EduardoSBarreraR/Trabajo_Terminal_2/imagenes/Implementacion/Resultados/CargaMAX.jpg

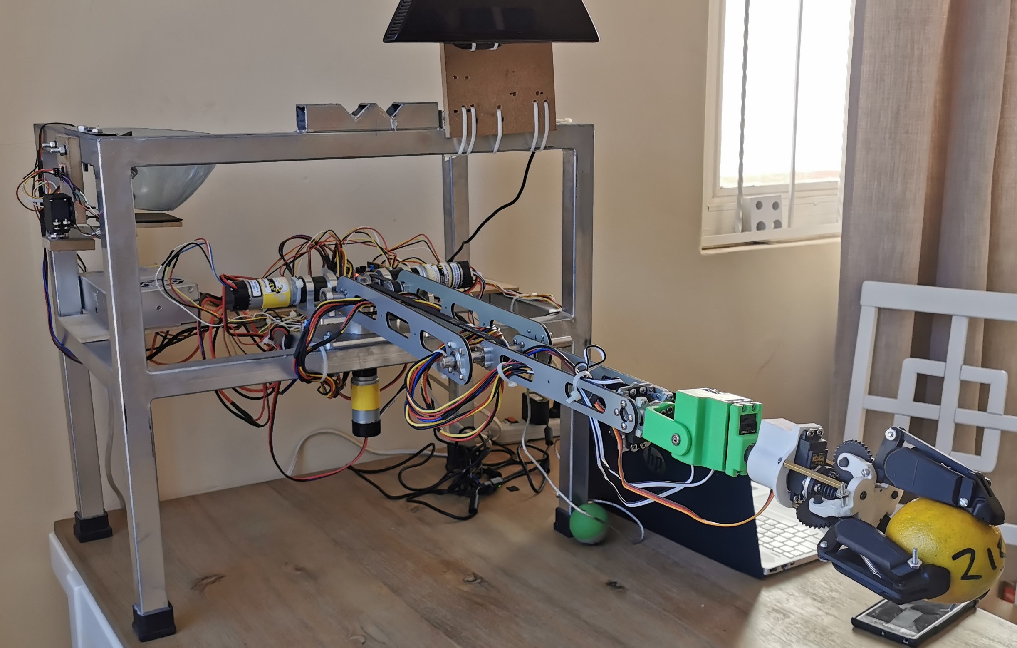
imagenes/Implementacion/Resultados/CargaMAX.jpg
