EduardoSBarreraR/Trabajo_Terminal_2/imagenes/Implementacion/Resultados/Alcance_MAX.jpg

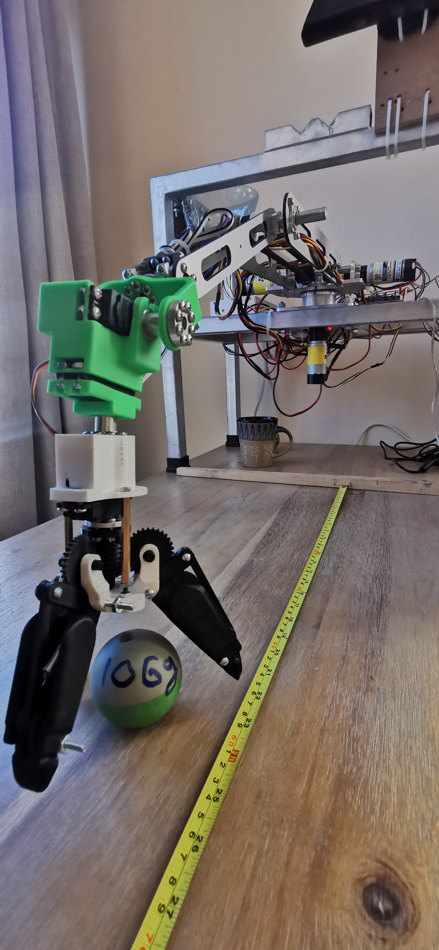
imagenes/Implementacion/Resultados/Alcance_MAX.jpg
