EduardoSBarreraR/Trabajo_Terminal_2/README.md

# Trabajo Terminal II

Este es el repositorio en el que trabajaremos durante el desarrollo del proyecto en Trabajo Terminal II
