EduardoSBarreraR/Trabajo_Terminal_2/capitulos/Implementacion.tex

\chapter{Implementación}

En este capítulo se describe la construcción realizada, siguiendo la secuencia de integración descrita en el capítulo anterior indicando, de ser necesario, las modificaciones realizadas al diseño original.\footnote{Por causas externas al proyecto (COVID-19) fue necesario realizar modificaciones en el diseño, así como una nueva selección de componentes con el fin de reducir costos y simplificar la construcción.}

\section{S5. Estructural}

El diseño original contemplaba perfil estructural IPS 2020 de aluminio, sin embargo, se opta por utilizar una estructura soldada de PTR (Perfil Tubular Rectangular) de $1\frac{1}{4}"$ calibre 14, ya que el material es más barato, más pesado (lo cual ayuda a equilibrar las cargas generadas por el brazo), y además es fácil de trabajar con las herramientas típicas de una herrería. Debido a que el material es acero estructural, se le aplica una capa de pintura para proteger el metal de la corrosión, eligiendo un color cromado para ser estéticamente similar al aluminio.

\begin{figure}
	\centering
	\begin{tabular}{cc}
		\subf{}
			{a) Estructura soldada y pintada}
		&
		\subf{}
			{b) Acercamiento a la pieza donde reposa el brazo}
        \\
    \end{tabular}
	\caption{Estructura construida}
	\label{fig:EstructuraConstruida}
\end{figure}

Como se puede apreciar en la Figura \ref{fig:EstructuraConstruida}b, se modifica la pieza en la que reposa el brazo (mostrada en la Figura \ref{fig:Home}) por un fragmento de PTR que se ranura con el espacio adecuado para apoyar el brazo.

\section{S1. Robótico}
\subsection{M1. Manipulador}

\subsubsection{Base del manipulador}
De acuerdo al cambio de material en la estructura (S5), se utilizan tornillos de $\frac{3}{8}"$, por lo que se modifica el diámetro de los barrenos de la base fija de 10[mm] a $\frac{3}{8}"$.

Las piezas correspondientes a la base fija que se une a la estructura junto con el cilindro sobre el que se colocan los rodamientos se muestran en la Figura \ref{fig:PiezasBaseManipulador}a, mientras que la base giratoria sobre la que se colocan los motores del segundo y tercer GDL se observa en la Figura \ref{fig:PiezasBaseManipulador}b.

\begin{figure}
	\centering
	\begin{tabular}{cc}
		\subf{}
			{a) Base fija con el cilindro montado y tapa del cilindro}
		&
		\subf{}
			{b) Base giratoria}
        \\
	\end{tabular}
	\caption{Base del manipulador}
	\label{fig:PiezasBaseManipulador}
\end{figure}

Gracias a que la masa de la muestra fue reducida a 100 gramos, es posible elegir un motor que ofrezca un menor par, por lo que el modelo seleccionado es el motor de engranes planetarios Yellow Jacket 5202 Series, que proporciona 24.51[Nm] (Anexo \ref{An:Mot}). Para validar esta selección, es útil recurrir nuevamente a la Figura \ref{fig:TorquesMotor}, que corresponde al cálculo con el diseño original, el cual indica que el par mínimo necesario que debe suministrar el motor es de 11.145 [Nm], por lo que se concluye que el par del motor Yellow Jacket es suficiente.

Debido a que hay problemas de compatibilidad entre los ejes de 1/2'' y algunos componentes acoplados a estos, se cambian por ejes de acero inoxidable de 12[mm] de diámetro y las piezas compatibles con los mismos, vendidos por ServoCity (Anexo \ref{An:PiezasExtra}). A estos ejes se les hace un desbastado longitudinal a lo largo de todo el cuerpo para facilitar la colocación y sujeción de accesorios, como se muestra en la Figura \ref{fig:EjDesb}. 

\begin{figure}
	\centering
	\begin{tabular}{cc}
		\subf{}
			{a) Desbastado para un lado plano}
		&
		\subf{}
			{b) Polea sujeta al eje}
		\\
	\end{tabular}
	\caption{Ejes desbastados}
	\label{fig:EjDesb}
\end{figure}

Con estas modificaciones, es posible construir la base giratoria que constituye la cintura del manipulador, mostrada en la Figura \ref{fig:BaseGiratoria}, en la que también se puede apreciar la distribución de los motores de CD correspondientes a los GDL 2 y 3.

\begin{figure}
	\centering		
		
		\caption{Base giratoria con motores}
		\label{fig:BaseGiratoria}
\end{figure}

Debido a que el diseño original del ocioso dentado mostrado en la Figura \ref{fig:PoleaLoca} contiene bordes complicados de hacer por las impresoras 3D, se modifica el CAD eliminando los mismos, como se puede apreciar en la Figura \ref{fig:Ociosos}a, mientras que la pieza, impresa en HIPS (Poliestireno de alto impacto por sus siglás en inglés \textit{High Impact Polystyrene}) con resolución media, se encuentra en la Figura \ref{fig:Ociosos}b.

\begin{figure}
	\centering
	\begin{tabular}{cc}
		\subf{}
			{a) CAD}
		&
		\subf{}
			{b) Impreso}
		\\
	\end{tabular}
	\caption{Rediseño del ocioso dentado}
	\label{fig:Ociosos}
\end{figure}

La base del manipulador completa se puede apreciar en la Figura \ref{fig:BaseManipuladorCompleta}.

\begin{figure}
	\centering		
		
		\caption{Base del manipulador}
		\label{fig:BaseManipuladorCompleta}
\end{figure}

\subsubsection{Eslabones}

Debido a que no se cuenta con la infraestructura requerida (Fresadora CNC) para la manufactura en aluminio, y que manufacturarlas de manera externa elevaba demasiado el precio, se modificó el material a Alucobond de 4[mm] de grosor.

Con estas modificaciones, el eslabón 1 pesa 0.16 Kg, y el eslabón 2 pesa 0.07 Kg.

Los modelos CAD de los eslabones rediseñados se muestran en las Figuras \ref{fig:EslabonesReales}a y \ref{fig:EslabonesReales}b, mientras que los eslabones construidos están en las Figuras \ref{fig:EslabonesReales}c y \ref{fig:EslabonesReales}d respectivamente.

\begin{figure}
	\centering
	\begin{tabular}{cc}
		\subf{}
			{a) CAD eslabon 1}
		&
		\subf{}
			{b) CAD eslabon 2}
        \\
        \subf{}
			{c) Eslabón 1 construido }
		&
		\subf{}
			{d) Eslabón 2 construido}
		\\
	\end{tabular}
	\caption{Modelos CAD de los eslabones y eslabones construidos}
	\label{fig:EslabonesReales}
\end{figure}

\subsubsection*{Validación}
Para comprobar que el material es capaz de resistir los esfuerzos asociados a la carga se utiliza acrílico, esto debido a que Solidworks no cuenta con el material Alucobond en su biblioteca. 

\begin{figure}
	\centering
	\begin{tabular}{cc}
		\subf{}
			{Eslabón 1}
		&
		\subf{}
			{Eslabón 2}
		\\
	\end{tabular}
	\caption{Análisis de resistencia de eslabones de acrílico}
	\label{fig:AnEsAcr}
\end{figure}

Las Figuras \ref{fig:AnEsAcr}a y \ref{fig:AnEsAcr}b indican que los factores de seguridad son de 3.26 y 5.79 respectivamente, y debido a que el límite elástico del acrílico (45 [MPa]) es menor al del Alucobond, se concluye que el material resiste las cargas a las que es sometido.

\subsubsection{Muñeca esférica}

Las piezas realizadas con manufactura aditiva, se imprimieron con ABS al 100\% en resolución estándar, como se muestra en las siguientes Figuras: 1) Pieza en C: Figura \ref{fig:PiezasMun}a, 2) Unión de servos: Figura \ref{fig:PiezasMun}b, 3) Tapa de unión de servos: Figura \ref{fig:PiezasMun}c, 4) Sostén del servo para el primer GDL de la muñeca esférica: Figura \ref{fig:PiezasMun}d.

\begin{figure}
	\centering
	\begin{tabular}{cc}
		\subf{}
			{a) Pieza en C }
		&
		\subf{}
			{b) Tapa de unión de servos }
        \\
		\subf{}
			{c) Unión de servos}
		&
		\subf{}
			{d) Sostén del servo para el primer GDL de la muñeca}
		\\
	\end{tabular}
	\caption{Componentes impresos de la muñeca esférica}
	\label{fig:PiezasMun}
\end{figure}

\subsection{M2. Efector final}

Las piezas del efector se imprimieron en ABS con alta resolución para los engranes y el tornillo sin fin, estas piezas se muestran en las siguientes Figuras: 1) Tornillo sin fin y engranes: Figura \ref{fig:FigsEfectorImpreso}a, 2) Efector con palma y 3 dedos: Figura \ref{fig:FigsEfectorImpreso}b, 3) Base del efector: Figura \ref{fig:FigsEfectorImpreso}c.

\begin{figure}
	\centering
	\begin{tabular}{ccc}
		\subf{}
			{a) Dedos y palma}
		&
		\subf{}
            {b) Tornillo sin fin y engranes}
        &
        \subf{}
            {c) Base}
		\\
	\end{tabular}
	\caption{Efector final impreso}
	\label{fig:FigsEfectorImpreso}
\end{figure}

\subsubsection{Control y movimiento}

Los valores de posición obtenidos a través del algoritmo de visión implementado con el kinect se utilizan para conocer la posición del efector final, sin embargo su orientación está dada por la matriz $R$ descrita en la ecuación (\ref{eq:RTarget}), por lo que, para asegurar que el efector se ubique de forma perpendicular a la horizontal, se establece la matriz $R$ constante como sigue:

$$
R = 
\begin{bmatrix}
	-1 & 0 & 0\\
	 0 & 1 & 0\\
	 0 & 0 & -1
\end{bmatrix}
$$

Además, para evitar colisiones con la estructura, se calcula $\theta_2$ utilizando la raíz negativa en la ecuación (\ref{eq:T2}) para forzar la configuración de codo arriba.\cite{Spong}

Como se plantea en el diseño de dominio específico, la aproximación al control del manipulador es mediante juntas independientes. Ya que la segunda junta es la que está sometida a una carga mayor, se implementa en ésta un control proporcional retroalimentado sintonizado experimentalmente, con el objetivo de que el actuador entregue el par necesario para mantener la posición de la junta de acuerdo a la siguiente ecuación: 

\begin{align}
	pwm = kp * \theta_e
	\label{eq:P_Control}
\end{align}

En donde kp es la ganancia proporcional, con un valor de 1000, y $\theta_e$ es el error entre la posición angular deseada y la posición angular actual.

Para evitar las aceleraciones bruscas, se optó por utilizar un perfil de velocidades trapezoidal para las juntas 1 y 3 a través de un incremento lineal en el ciclo útil del pwm que se envía a los actuadores, mientras que para la junta 2, se dan incrementos de 1 grado cada 0.15 segundos hasta llegar a la posición deseada.

\subsubsection{Configuraciones}

Los ángulos de las juntas del robot mostrados en la Figura \ref{fig:GDLRobot}b se miden como se estableció al calcular la cinemática directa mediante la convención de Denavit-Hartenberg (Figura \ref{fig:GDLRobot}a), con valores de juntas $\theta_1 = 90$, $\theta_2 = \theta_3 = \theta_4 = \theta_5 = \theta_6 = 0$. 

\begin{figure}
	\centering
	\begin{tabular}{cc}
		\subf{}
			{a) Modelo utilizado para la cinemática}
		\\
		\subf{}
			{b) Robot en los ángulos cero}
		\\
	\end{tabular}
	\caption{Comparación del modelo de robot con la implementación}
	\label{fig:GDLRobot}
\end{figure}

Cabe señalar que ya que los actuadores del tercer y cuarto grado de libertad están montados en la base del robot y el tercer grado de libertad transmite su movimiento mediante una polea ociosa colocada en el eje del segundo grado de libertad, el movimiento angular del tercer GDL es independiente del segundo GDL, lo que significa que el ángulo medido en esa junta es absoluto con respecto al plano horizontal, a diferencia del ángulo calculado, el cual es relativo al eslabón anterior. Por ello es necesario convertirlo mediante la fórmula $ \theta_{2 absoluto} = \theta_{2 relativo} + \theta_{1}$. 

Para la ejecución de la tarea de ``pick and place" se establecen dos configuraciones clave. La configuración de ``Dejar muestra'' posiciona el efector para que, al soltar la muestra, esta caiga en la superficie de medición del laboratorio, esto se puede ver en la Figura \ref{fig:ConfClave}. La otra configuración es ``Home'', la cual es el reposo del brazo y sirve de referencia de posición al iniciar el movimiento, puesto que se utilizan encoders incrementales como sensor de posición. Los valores de las juntas en dichas posiciones se muestran en la Tabla \ref{tab:PosRobot}.

La posición de home es diferente a la establecida en el diseño de dominio específico, ya que al implememntar el Kinect como sistema de percepción, ocupa un lugar en el que corre el riesgo de ser golpeado y enviar información errónea de las coordenadas de la muestra. 

\begin{figure}
	\centering
	\begin{tabular}{cc}
		\subf{}
			{a) Home}
		&
		\subf{}
			{b) Laboratorio}
		\\
	\end{tabular}
	\caption{Configuraciones clave del robot}
	\label{fig:ConfClave}
\end{figure}

\begin{table}[]
	\centering
	\caption{Configuraciones clave del robot }
	\label{tab:PosRobot}
	\begin{tabular}{|c|c|c|}
	\hline
		   & Dejar muestra & Home \\ \hline
	$\theta_1$ &       $82^o$        &   $59^o$   \\ \hline
	$\theta_2$ &       $18^o$        &   $54^o$   \\ \hline
	$\theta_3$ &       $120^o$       &   $153^o$  \\ \hline
	$\theta_4$ &       $80^o$        &   $10^o$   \\ \hline
	$\theta_5$ &       $160^o$       &   $10^o$   \\ \hline
	$\theta_6$ &       $26^o$        &   $15^o$   \\ \hline
	\end{tabular}
\end{table}

\section{S4. Laboratorio}
Para la implementación de este sistema se diseñó un elemento de sujeción hecho de lámina de acero, mostrado en la Figura \ref{fig:LabLamina}, que soporta al sistema de laboratorio y lo mantiene unido al sistema estructural. 

\begin{figure}
    \centering		
        
        \caption{Sujetador de laboratorio hecho con lámina de acero.}
        \label{fig:LabLamina}
\end{figure}

Para asegurar que la muestra se mantiene en la superficie de medición durante la lectura, y para incrementar las probabilidades de que la muestra caiga en la misma al ser liberada por el efector, se construye un cono recortando una botella de PET y atornillándola a la lámina de acero, como se observa en la Figura \ref{fig:Lab12}.

El sistema de laboratorio finalizado y sujeto a el sistema estructural se puede ver en las Figuras \ref{fig:Lab12}a y \ref{fig:Lab12}b.

\begin{figure}
	\centering
	\begin{tabular}{cc}
		\subf{}
			{a Vista frontal, donde se observa \\ la superficie de medición y la superficie cónica}
		&
		\subf{}
			{b Vista lateral, donde se muestra \\ el actuador del desechador}
		\\
	\end{tabular}
	\caption{Vistas del sistema de laboratorio}
	\label{fig:Lab12}
\end{figure}

\section{S3. Energético}

Debido a que se realizaron modificaciones al diseño obtenido en la fase de \textit{Diseño de dominio específico} para reducir costos, la fuente utilizada es la TDK-Lambda GWS250 (Anexo \ref{An:Fuente}), que proporciona 20[A], perteneciente a compañeros de la carrera, pues el peso reducido tanto en los eslabones como en la muestra recogida implican un menor consumo energético.

Así mismo, se utilizan los Drivers Cytron 13 [A] y Cytron dual de 10[A] por canal para alimentar los motores de CD. Para los servomotores se utiliza el regulador Digilent TPS54620, que proporciona 5V a 6[A] de manera continua.

Estos componentes se pueden apreciar en la Figura \ref{fig:Energetico}, encerrados en círculos.

\begin{figure}
    \centering		
        
        \caption{Distribución del sistema energético}
        \label{fig:Energetico}
\end{figure}

\section{S2. Información}

\subsection{M3. Percepción}

Con el fin reducir costos y facilitar el algoritmo de visión, se utiliza un Kinect v1, el cual es una cámara RGB-D fabricada por Microsoft\textregistered. Para esta plataforma existen varias aplicaciones de código libre, por lo que hay bibliotecas disponibles para la utilización de los datos obtenidos por los sensores\cite{ShiffmanKinect}, como es el sensor de profundidad, cuya información permite calcular la posición del objeto en el espacio utiliza en la cinemática inversa.

Debido a que el rango de detección del sensor de profundidad comienza a partir de los 48 cm, y que en el diseño original este se encuentra muy cerca del suelo, es necesario colocarlo en la parte superior de la estructura, desplazado hacia la izquierda para que el sistema robótico no interfiera en el área de visión, provocando que no abarque todo el espacio de trabajo del robot. 

\subsection{M4. Comunicación}

La comunicación con el usuario se realiza a través de una Interfaz Gráfica de Usuario, mostrada en la Figura \ref{fig:GUIsXD} en la que el operador debe seleccionar un punto de la imagen de profundidad que corresponda al objeto que desea tomar. El módulo de percepción obtiene las coordenadas de ese punto en el espacio del robot, y las muestra. Esta interfaz se desarrolla utilizando el lenguaje ``Processing\textregistered''\cite{ProcessingXD}, ya que este cuenta con bibliotecas que permiten utilizar el Kinect fácilmente. 

El programa  de la interfaz calcula el vector de valores de las juntas del robot según las coordenadas deseadas, las cuales son enviadas a la tarjeta de procesamiento cuando el usuario presiona el botón ``Activar'', mientras que esta recolecta los datos de temperatura y peso de la muestra para enviarlos a la computadora. Cabe destacar que mientras el sistema se encuentra en operación, cualquier orden enviada se ignora y solo se toma en cuenta la ultima posición enviada. 

La comunicación entre la computadora y la tarjeta Núcleo es serial, utilizando el protocolo UART a través del puerto USB de la tarjeta de desarrollo.

\begin{figure}
	\centering
	\begin{tabular}{cc}
		\subf{}
			{a) Pantalla de inicio}
		\\
		\subf{}
			{b) Pantalla una vez que se ha seleccionado la muestra}
		\\
	\end{tabular}
	\caption{Interfaz Gráfica de Usuario}
	\label{fig:GUIsXD}
\end{figure}

\subsection{M5. Procesamiento}

En la tarjeta núcleo existen pines que están reservados para el funcionamiento de los periféricos internos de la misma, lo cual no se tomó en cuenta en el diseño de la Figura \ref{fig:DistPines}, por esta razón se eligieron nuevamente los pines con base en lo siguiente: a) Los pines para PWM deben tener como fuente un timer y canal diferente. b) Las interrupciones externas se encuentran interconectadas entre puertos, por lo que se requiere utilizar una interrupción externa por cada pin de los puertos.

Como se puede observar en la Figura \ref{fig:PinesNukleoFinal}, se utilizan los siguientes pines, los cuales se seleccionan con ayuda de la documentación de la tarjeta, disponibles en \cite{Nucleo446RE}:

\begin{itemize} [noitemsep,nolistsep]
	\item Motores de CD
	\begin{itemize}
		\item PC4: Dirección de motor de CD del 1er GDL - Salida Digital
		\item PA10: PWM del motor de CD del 1er GDL - Salida de PWM (Timer 1 - Canal 3)
		\item PB4: Dirección de motor de CD del 2o GDL - Salida Digital
		\item PB5: PWM del motor de CD del 2o GDL - Salida de PWM (Timer 3 - Canal 2)
		\item PB13: Dirección de motor de CD del 3er GDL - Salida Digital
		\item PB3: PWM del motor de CD del 3er GDL - Salida de PWM (Timer 2 - Canal 2)
	\end{itemize}
	\item Encoders
	\begin{itemize}
		\item PC3: Encoder del motor del 1er GDL (Canal A) - Fuente de interrupción externa
		\item PC2: Encoder del motor del 1er GDL (Canal B) - Fuente de interrupción externa
		\item PC0: Encoder del motor del 2o GDL (Canal A) - Fuente de interrupción externa
		\item PC1: Encoder del motor del 2o GDL (Canal B) - Fuente de interrupción externa
		\item PA8: Encoder del motor del 3er GDL (Canal A) - Fuente de interrupción externa
		\item PB10: Encoder del motor del 3er GDL (Canal B) - Fuente de interrupción externa
	\end{itemize}
	\item Servomotores
	\begin{itemize}[noitemsep,nolistsep]
		\item PB9(Alternativo\footnote{Los pines están conectados a varios Timers como fuente de PWM, el cual se especifica mediante código \cite{NucleoPeripheralPins}}): Servomotor del 4o GDL - Salida de PWM (Timer 4 - Canal 4)
		\item PB8: Servomotor del 5o GDL - Salida de PWM (Timer 4 - Canal 3)
		\item PC9: Servomotor del 6o GDL - Salida de PWM (Timer 3 - Canal 4)
		\item PC8: Servomotor del efector final - Salida de PWM (Timer 3 - Canal 3)
		\item PC6: Servomotor del mecanismo de desecho del laboratorio - Salida de PWM (Timer 3 - Canal 1)
	\end{itemize}
	\item Celda de carga
	\begin{itemize}
		\item PC10: SCK - Salida Digital
		\item PC12: DATA - Entrada digital
	\end{itemize}
	\item Sensores de temperatura
	\begin{itemize}
		\item PD2: DHT11A - Entrada Digital
		\item PC11: DHT11B - Entrada Digital
		\item Interno: Sensor de temperatura interno
	\end{itemize}
\end{itemize}

\begin{figure}
    \centering		
        
        \caption{Pines utilizados en la núcleo STM32F446RE}
        \label{fig:PinesNukleoFinal}
\end{figure}

Esto conlleva una modificación en el diagrama esquemático y el PCB del circuito diseñado, los cuales se muestran actualizados en las Figuras \ref{fig:PlakaNueva}a y \ref{fig:PlakaNueva}b respectivamente, mientras que la placa construida puede observarse en la Figura \ref{fig:PlakaConstruida}.

\begin{figure}
	\centering
	\begin{tabular}{cc}
		\subf{}
			{a) Diagrama esquemático}
		&
		\subf{}
			{b) Placa de circuito impreso}
		\\
	\end{tabular}
	\caption{Diseño implementado del circuito del sistema}
	\label{fig:PlakaNueva}
\end{figure}

\begin{figure}
    \centering		
        
        \caption{PCB construido}
        \label{fig:PlakaConstruida}
\end{figure}

\section{Integración}

El sistema completo se puede apreciar en la Figura \ref{fig:RobotCompleto}, el cual es muy similar al render mostrado en la Figura \ref{fig:RenderPitero}.

\begin{figure}
    \centering		
        
        \caption{Sistema robótico completo}
        \label{fig:RobotCompleto}
\end{figure}

Debido a que las posiciones de cero grados en las juntas del robot (mostrado en la Figura \ref{fig:GDLRobot}b) no coinciden con los ángulos cero de los servos en los GDL 4, 5 y 6, es necesario realizar un ajuste en el código, el cual es diferente para cada servo, como se muestra en las siguientes fórmulas: a) Servo 4GDL: $\theta_4 + 90$, b) Servo 5GDL: $\theta_5 + 100$ c) Servo 6GDL: $\theta_6 + 15$.

Por otro lado, para mover cada junta se realiza una rutina dependiendo de la posición objetivo con ayuda de una posición auxiliar en el 3er GDL, la cual se utiliza para poder modificar la orientación del efector sin golpear el Kinect ni la estructura, como se puede observar en la Figura \ref{fig:PosAux}.
La rutina que el robot ejecuta es la siguiente:

\begin{figure}
    \centering		
        
        \caption{Posición auxiliar del manipulador}
        \label{fig:PosAux}
\end{figure}

\begin{itemize}[noitemsep,nolistsep]
	\item Paso 1: Home - Muestra seleccionada. 
	\begin{enumerate}[noitemsep,nolistsep]
		\item Posición auxiliar del 3$^{er}$ GDL.
		\item Posición objetivo del 1$^{er}$ GDL.
		\item Posición objetivo del 4$^{o}$ GDL.
		\item Posición objetivo del 5$^{o}$ GDL.
		\item Posición objetivo del 3$^{er}$ GDL.
		\item Posición objetivo del 2$^{o}$ GDL.
		\item Cerrar efector.
	\end{enumerate}
	\item Paso 2: Muestra seleccionada - Laboratorio.
	\begin{enumerate}[noitemsep,nolistsep]
		\item Posición auxiliar del 3$^{er}$ GDL. 
		\item Posición de laboratorio del 1$^{er}$ GDL.
		\item Posición de laboratorio del 6$^{o}$ GDL.
		\item Posición de laboratorio del 5$^{o}$ GDL.
		\item Posición de laboratorio del 4$^{o}$ GDL.
		\item Posición de laboratorio del 2$^{o}$ GDL.
		\item Posición de laboratorio del 3$^{er}$ GDL.
		\item Abrir efector.
		\item Liberar muestra.
		\item Regresar superficie de medición.
	\end{enumerate}
	\item Paso 3: Laboratorio - Home.
	\begin{enumerate}[noitemsep,nolistsep]
		\item Posición de home 2$^{o}$ GDL.
		\item Posición de home 6$^{o}$ GDL.
		\item Posición de home 4$^{o}$ GDL.
		\item Posición de home 5$^{o}$ GDL.
		\item Posición de home 1$^{er}$ GDL.
		\item Posición de home 3$^{er}$ GDL. 
	\end{enumerate}
	
	\item Paso 4. Enviar datos a la computadora y una señal que reactive el botón para una nueva selección de muestra.
\end{itemize}

\section{Resultados obtenidos}

A continuación se presenta un resumen de los resultados obtenidos con el sistema, los cuales se midieron con una muestra de 20 pruebas en un entorno controlado, realizadas en interiores sobre una mesa en la que se reposa el objeto a recoger, como se muestra en la Figura \ref{fig:RobotEntorno}, teniendo éxito en la operación en 5 ocasiones. En la sección \ref{sec:TrabajoFuturo} se discuten posibles soluciones a los problemas aquí presentados.

\begin{figure}
    \centering		
        
        \caption{Entorno de pruebas del sistema robótico}
        \label{fig:RobotEntorno}
\end{figure}

\subsection*{S1. M1. Manipulador robótico}

\subsubsection*{Carga máxima}

Con el objetivo de evitar el sobreimpulso, se establece un ciclo útil de PWM máximo de 15\% para limitar la velocidad de movimiento, lo cual influye directamente en la capacidad de carga, sin embargo, como se puede ver en la Figura \ref{fig:CargaMAXNaranja}, el sistema es capaz de manipular una carga de 215 gramos, lo que es 2 veces mayor a lo especificado en el requerimiento R1 modificado (100 gramos).	

\begin{figure}
    \centering		
        
        \caption{Carga máxima aplicada al robot, (215 gramos en voladizo)}
        \label{fig:CargaMAXNaranja}
\end{figure}

\subsubsection*{Alcance}

\begin{flushright}
	\textbf{\textit{Rango de movimiento de los eslabones}}
\end{flushright}

El primer grado de libertad puede girar sin golpear la estructura en un rango entre 45 grados y 145 grados, lo que significa que el rango de movimiento es de 100 grados, como se muestra en las Figuras \ref{fig:RangoGDL1}a y \ref{fig:RangoGDL1}b respectivamente.

\begin{figure}
	\centering
	\begin{tabular}{cc}
		\subf{}
			{a) Ángulo mínimo}
		&
		\subf{}
			{b) Ángulo máximo}
		\\
	\end{tabular}
	\caption{Rango de movimiento del primer grado de libertad del robot}
	\label{fig:RangoGDL1}
\end{figure}

El segundo GDL del robot puede moverse en un rango de $-45^o <= \theta_2 <= 70^o $, siendo el valor máximo el límite en el que no golpea al Kinect, como se observa en la Figura \ref{fig:RangoGDL2}. En cuando al tercer GDL, su rango de movimiento depende del valor de $\theta_2$.

\begin{figure}
    \centering		
        
        \caption{Ángulo máximo del segundo grado de libertad del robot}
        \label{fig:RangoGDL2}
\end{figure}

\begin{flushright}
	\textbf{\textit{Alcance mínimo}}
\end{flushright}

La distancia mínima a la que debe estar un objeto para que el robot pueda alcanzarla es de 10 [cm] alrededor del eje de giro del primer GDL, lo cual se consigue con una configuración de $\theta_2 = 23^o$ y $\theta_3 = -117^o$ a lo largo de todo el rango de movimiento del primer GDL. Esta configuración se muestra en la Figura \ref{fig:AlcanceMinimo}. 
La distancia más lejana en la que el robot puede recoger una muestra es de 68 cm, mostrado en la Figura \ref{fig:AlcanceMaximo}. 
El área total que puede alcanzar el robot se muestra en la Figura \ref{fig:AlcanceRobot}.

\begin{figure}
    \centering		
        
        \caption{Alcance mínimo del robot}
        \label{fig:AlcanceMinimo}
\end{figure}

\begin{figure}
	\centering
	\begin{tabular}{cc}
		\subf{}
			{a) Configuración del robot en su alcance máximo}
		&
		\subf{}
			{b) Distancia máxima}
		\\
	\end{tabular}
	\caption{Alcance máximo del robot}
	\label{fig:AlcanceMaximo}
\end{figure}

\begin{figure}
    \centering		
        
        \caption{Alcance total del robot}
        \label{fig:AlcanceRobot}
\end{figure}

\subsection*{S1. M2. Efector final}

El efector es capaz de agarrar muestras con las dimensiones especificadas, como se puede observar en la Figura \ref{fig:AgarreRobot}a, así como muestras de dimensiones mayores a las requeridas, aunque la posición no sea la ideal, como se muestra en la Figura \ref{fig:AgarreRobot}b, en la que se aprecia como el efector toma la naranja solo con las puntas de los dedos. Después de realizar pruebas de cierre de efector con objetos de diferentes tamaños, se determina que el tiempo de cierre y apertura que el efector requiere para poder asegurar la muestra es de 5 segundos.

\begin{figure}
	\centering
	\begin{tabular}{cc}
		\subf{}
			{a) Condiciones ideales (Todas las falanges)}
		&
		\subf{}
			{b) Condiciones no ideales (Punta de los dedos)}
		\\
	\end{tabular}
	\caption{Alcance máximo del robot}
	\label{fig:AgarreRobot}
\end{figure}

\subsection*{S2. M3. Percepción}

Debido a que la distancia mínima a la que el Kinect puede detectar un objeto es de 48[cm] y que se coloca de manera perpendicular al plano horizontal (XY), el área de visión es reducida (68x49[cm]), como se muestra en la Figura \ref{fig:VisionRobot}. 

\begin{figure}
    \centering		
        
        \caption{Rango de visión del robot}
        \label{fig:VisionRobot}
\end{figure}

Es importante tomar en cuenta que los parámetros de este dispositivo son privativos, por lo que no es posible obtener una ubicación 100\% exacta de la muestra sin embargo, el error máximo de las lecturas realizadas es de 3\%, como se puede observar en las diferentes capturas de la GUI mostradas en la Figura \ref{fig:GUILecturas}.

\begin{figure}
	\centering
	\begin{tabular}{cc}
		\subf{}
			{a) }
		&
		\subf{}
			{b) }
		\\
		\subf{}
			{c) }
		&
		\subf{}
			{d) }
		\\
		\subf{}
			{e) }
		\\
	\end{tabular}
	\caption{Interfaz Gráfica de Usuario ubicando la muestra en diferentes posiciones}
	\label{fig:GUILecturas}
\end{figure}

Conociendo el alcance total del robot y el rango de visión que ofrece el Kinect, es posible identificar el espacio de trabajo del sistema, siendo esta la intersección del alcance del robot y el rango de visión del Kinect, como se puede observar en la Figura \ref{fig:AreaTrabajoRobot}.

\begin{figure}
    \centering		
        
        \caption{Área de trabajo del robot}
        \label{fig:AreaTrabajoRobot}
\end{figure}

\subsection*{S2. M4. Comunicación}

La comunicación usuario-computadora-microcontrolador se realiza a través de la Interfaz Gráfica de Usuario (GUI por sus siglas en inglés, \textit{Graphic User Interface}), en la que el usario debe ser capaz de interpretar la imagen de profundidad para seleccionar la muestra de interés. En cuanto a la comunicación con el microcontrolador, esta se realiza a 250000 baudios sin perder información.

\subsection*{S2. M5. Procesamiento}

La tarjeta de desarrollo Núcleo STM32F446RE es capaz de procesar toda la información necesaria para controlar el robot, comunicarse con la computadora y realizar la lectura de los sensores sin presentar retrasos.

\subsection*{S3. Energético}

La fuente de alimentación es capaz de suministrar la corriente requerida por los actuadores, mientras que los sensores pueden ser alimentados por el puerto USB de la computadora a través de la tarjeta Núcleo, ya que consumen menos de 300 [mA] en conjunto.

\subsection*{S4. M6. Obtención de datos}

La superficie de medición es un cuadrado de 8 [cm] que es capaz de recibir la muestra con la ayuda del cono de PET (La Figura \ref{fig:SuperficieMedicion} muestra este ensamble) sin que caiga una vez que está dentro, manteniéndola en su lugar hasta que es desechada, esto se puede observar en la Figura \ref{fig:EspacioMuestraLab}.

En cuanto a la medición de masa, la celda de carga se dañó, por lo que no funciona.

\begin{figure}
    \centering		
        
        \caption{Superficie de medición de la muestra}
        \label{fig:SuperficieMedicion}
\end{figure}

\subsection*{S4. M7. Desechador}

Con las dimensiones mencionadas anteriormente, el módulo de desechador es capaz de liberar muestras con diámetros menores a 8[cm], como se puede apreciar en la Figura \ref{fig:EspacioMuestraLab}.

\begin{figure}
    \centering		
        
        \caption{Espacio para muestras de diámetro menor a 8[cm]}
        \label{fig:EspacioMuestraLab}
\end{figure}

\subsection*{S5. Estructural}

La estructura es capaz de soportar al resto de sistemas y las reacciones generadas por los mismos sin desestabilizarse ni vibrar.

\subsection*{Resultado general}

Una vez que se envía la orden a través de la GUI, el sistema tarda alrededor de 1 minuto en llegar de la posición de ``Home'' a la ubicación de la muestra, mientras que la tarea completa se realiza en 2 minutos 20 segundos aproximadamente, después de los cuales el sistema está listo para recibir una nueva orden. Esta función puede realizarse con una probabilidad de éxito del 25\%, ya que el efector empuja frecuentemente la muestra mientras llega a su ubicación, del mismo modo existe poca repetibilidad atribuida a la holgura mecánica, además el control aplicado no es capaz de reaccionar a cambios bruscos en la distribución del peso debidos a la configuración del brazo y la acción de la gravedad sobre el mismo. Por esta razón es necesario calibrar la posición de ``Home'' tras cada uso, pues esto aumenta significativamente la probabilidad de éxito en pruebas sucesivas.
