EduardoSBarreraR/Trabajo_Terminal_2/preliminares/Resumen.tex

\chapter{Resumen}

\textit{\textbf{Abstract-}} Geologic data acquisition of remote solar system bodies is only feasible by
means of robots, which are tested in scenarios that recreate conditions in which they want to
be operated. To achieve a soil analysis, tests require \textit{in situ} samples to be taken. Usually, exploration is carried out by 
\textit{rover}-type mobile robots, which besides the motion system, consist of analytical instruments
and end effectors to obtain the required samples. Since the sample acquisition is already a
complex problem, in this document the design of a mechatronic system is developed using the VDI 2206 methodology, which by means of a 6 degrees-of-freedom manipulator and an 3 finger gripper-like end effector, picks a sample, identified by computer vision, from the ground and places it in a specified place for its analysis, and sends the result to a computer for its display.
The implemented system has a performance of 86.97\%.

\textbf{Keywords:} Robotic system, exploration, sample analysis, antropomorphic arm, \textit{rover}. 

\newpage

\textit{\textbf{Resumen-}} La obtención de datos geológicos de cuerpos distantes del sistema solar sólo es viable mediante robots, los cuales son probados en escenarios que recrean condiciones
en las que quieren ser operados. Es de gran interés científico el análisis de terreno, para lo
cual se pueden realizar pruebas que requieren la obtención de muestras \textit{in situ}.
Generalmente, la exploración se lleva a cabo mediante robots móviles de tipo \textit{rover}, los
cuales incluyen además del sistema de locomoción, instrumental de análisis y efectores para
obtener las muestras de interés. Dado que la obtención de la muestra presenta un problema
complejo, en este documento se desarrolla el diseño de un sistema mecatrónico, utilizando la metodología de diseño VDI 2206, que mediante un manipulador de 6 grados de libertad y un efector de tipo gripper de 3 dedos, recoge una muestra del suelo identificada mediante visión por computador y la ubica en un lugar específico para su análisis, enviando el resultado obtenido a un ordenador para su visualización. 
La implementación del sistema tiene un rendimiento del 86.97\%.

\textbf{Palabras Clave:} Sistema robótico, exploración, análisis de muestras, brazo antropomórfico, \textit{rover}.
