EduardoSBarreraR/Trabajo_Terminal_2/apendices/anexo1.tex

\chapter{Anexo 1: Hojas de datos}

\section{Motor Planetario goBilda 5202 YellowJacket, 30RPM, 3470oz-in}
\label{An:Mot}
\includepdf[pages=-,height = 0.7\textheight , pagecommand={}]{imagenes/Anexos/Motor CD 5202_spec_sheet.pdf}

\clearpage
\section{Servomotor Ez Robot 0007}
\label{An:Serv}
\begin{figure}
	\centering		
	
\end{figure}

\clearpage
\section{Polea 15D}
\label{An:Pol15}
\begin{figure}
	\centering		
	
	\caption*{Polea de 12mm acoplada al eje de los eslabones, (ServoCity SKU: 615430)}
\end{figure}

\begin{figure}
	\centering		
	
	\caption*{Polea de 6mm acoplada al eje de los motores, (ServoCity SKU: 615432)}
\end{figure}

\clearpage
\section{Piezas adquiridas para ensamblar el manipulador}
\label{An:PiezasExtra}
\begin{figure}
	\centering	
	
	\caption*{Sujetador de motor, (ServoCity SKU: 555176)}	
\end{figure}

\begin{figure}
	\centering
	
	\caption*{Chumacera de piso, (ServoCity SKU: 535108)}
\end{figure}

\begin{figure}
	\centering		
	
	\caption*{Rodamiento de montaje plano, (ServoCity SKU: 535118)}
\end{figure}

\begin{figure}	
	\centering		
	
	\caption*{Montaje para tornillo de fijación, (ServoCity SKU: 545644)}
\end{figure}

\clearpage
\section{Piezas adquiridas para ensamblar la muñeca esférica y el efector}
\label{An:PiezasMueca}

\begin{figure}
	\centering		
	
	\caption*{Bloque portador de servo, (ServoCity SKU: 637112)}
\end{figure}

\begin{figure}
	\centering		
	
	\caption*{Buje de eje para servo, (ServoCity SKU: 525123)}
\end{figure}

\begin{figure}
	\centering		
	
	\caption*{Buje para servo del efector, (ServoCity SKU: 525125)}
\end{figure}

\begin{figure}
	\centering		
	
	\caption*{Rodamiento con brida, (ServoCity SKU: 535037)}
\end{figure}

\clearpage
\section{Rodamiento axial de agujas AXK 4565}
\label{An:RodAx}
\newgeometry{left=0.1cm,bottom=1cm}
\includepdf[pages=-,width=0.9\textwidth ,pagecommand={}]{imagenes/Anexos/Rod-Axial.pdf}
\restoregeometry

\clearpage
\section{Rodamiento radial de rodillos NU 303}
\label{An:RodRad}
\newgeometry{left=0.1cm,bottom=1cm}
\includepdf[pages=-,width=0.9\textwidth ,pagecommand={}]{imagenes/Anexos/Rod-radial.pdf}
\restoregeometry

\clearpage
\section{Rodamiento radial de bolas, (ServoCity SKU: 535026)}
\label{An:RodChi}
\begin{figure}
	\centering	
	
\end{figure}

\clearpage
\section{Sensor de temperatura y humedad DHT11}
\label{An:DHT11}
\newgeometry{left=0.1cm,bottom=1cm}
\includepdf[pages=-,width=0.9\textwidth ,pagecommand={}]{imagenes/Anexos/DHT11-Technical-Data-Sheet}
\restoregeometry

\clearpage
\section{Núcleo STM32F446RE}
\label{An:Nucleo}
\newgeometry{left=0.1cm,bottom=1cm}
\includepdf[pages=-,width=0.9\textwidth ,pagecommand={}]{imagenes/Anexos/stm32f446re-1}
\restoregeometry

\clearpage
\section{Fuente de alimentación TDK-Lambda GWS250-12}
\label{An:Fuente}
\newgeometry{left=0.1cm,bottom=1cm}
\includepdf[pages=-,width=0.9\textwidth ,pagecommand={}]{imagenes/Anexos/Fuente TDK Lambda}
\restoregeometry

\clearpage
\section{Regulador TPS54620}
\label{An:RegServ}
\newgeometry{left=0.1cm,bottom=1cm}
\includepdf[pages=1,width=0.9\textwidth ,pagecommand={}]{imagenes/Anexos/Digilent TPS54620 switching regulator.pdf}
\restoregeometry

\clearpage
\section{Driver MDD10A}
\label{An:DrivServ}
\newgeometry{left=0.1cm,bottom=1cm}
\includepdf[pages=-,width=0.9\textwidth ,pagecommand={}]{imagenes/Anexos/Driver-dual_10A-5-8.pdf}
\restoregeometry

\clearpage
\section{Driver MD10C R3}
\label{An:DrivMot}
\newgeometry{left=0.1cm,bottom=1cm}
\includepdf[pages=-,width=0.9\textwidth ,pagecommand={}]{imagenes/Anexos/Driver MD10C R3.pdf}
\restoregeometry
