EduardoSBarreraR/Trabajo_Terminal_2/apendices/apendice1.tex

% !TeX encoding = ISO-8859-1
\chapter{Apéndice 1: Árboles de decisión}
\section{Motores de CD}
\label{ApA1:MotCD}
\centering
\includepdf[pages=-,height=0.7\textheight]{imagenes/Apendices/Arbol-decision-motores.pdf}

\section{Servomotores}
\label{ApA2:Servo}
\includepdf[pages=-,height=0.7\textheight]{imagenes/Apendices/Arbol-decision-servo-muneca.pdf}

\section{Fuentes de alimentación}
\label{ApA3:Fuente}
\includepdf[pages=-,height=0.7\textheight]{imagenes/Apendices/Arbol-decision-fuentes.pdf}
