EduardoSBarreraR/Trabajo_Terminal_2/apendices/apendice4.tex

\chapter{Apéndice 3: Planos normalizados}
\begin{landscape}
\newgeometry{left=0.1cm,bottom=0.1cm}
\includepdf[pages=-, angle=90,width=0.95\textwidth]{imagenes/Apendices/Planos_normalizados.pdf}
\restoregeometry
\end{landscape}
