EduardoSBarreraR/Trabajo_Terminal_2/preliminares/Nomenclatura.tex

%\chapter{Nomenclatura}

\nomenclature[N]{$PWM$}{Pulse Width Modulation (Modulación por ancho de pulso)}

\nomenclature[N]{$NASA$}{National Aeronautics and Space Administration(Administración Nacional de la Aeronáutica y del Espacio)}%

\nomenclature[N]{$ GDL $}{Grados de Libertad}%

\nomenclature[N]{$ IP $}{International Protection (Protección Internacional)}

\nomenclature[N]{$ FBS $}{Funtional Breakdown Structure (Estructura de descomposición funcional)}

\nomenclature[N]{$ IDEF0 $}{Integration Definition for Function Modeling (Definición de integración para modelado de funciones)}

\nomenclature[N]{$ eFFBD $}{enhanced Function Flow Block Diagram (Diagrama a Bloques Mejorado del Flujo de Funciones)}

\nomenclature[N]{$ ASTM $}{American Society of Testing Materials (Sociedad Americana de Materiales de Prueba)}

\nomenclature[N]{$ CD $}{Corriente Directa}

\nomenclature[N]{$ AWG $}{American Wire Gauges (Calibres de Alambres Americanos)}

\nomenclature[N]{$ VDI $}{Verein Deutscher Ingenieure (Asociación de Ingenieros Alemanes)}

\nomenclature[N]{$ S1 $}{Sistema robótico}

\nomenclature[N]{$ S2 $}{Sistema de información}

\nomenclature[N]{$ S3 $}{Sistema de administración energética}

\nomenclature[N]{$ S4 $}{Sistema de laboratorio}

\nomenclature[N]{$ S5 $}{Sistema estructural}

\nomenclature[N]{$ M1 $}{Módulo de manipulador}

\nomenclature[N]{$ M2 $}{Módulo de efector final}

\nomenclature[N]{$ M3 $}{Módulo de percepción}

\nomenclature[N]{$ M4 $}{Módulo de comunicación}

\nomenclature[N]{$ M5 $}{Módulo de procesamiento}

\nomenclature[N]{$ M6 $}{Módulo de obtención de datos de la muestra}

\nomenclature[N]{$ M7 $}{Módulo de desechador}

\nomenclature[N]{$Cr_n$}{Criterio $n$ para AHP}

\nomenclature[N]{$AHP$}{Analytic Hierarchy Process (Proceso analtico de jerarquía)}

\nomenclature[N]{$Ce$}{Concepto elegido}

\nomenclature[N]{$Cm$}{Concepto mejorado}

\nomenclature[N]{$CAD$}{Computer-Aided Design (Diseño Asistido por Computadora)}

\nomenclature[N]{$HD$}{Heavy Duty (Alto Rendimiento)}

\nomenclature[N]{$RPM$}{Revoluciones por minuto}

\nomenclature[N]{$XL$}{Extra Light (Extra Ligero)}

\nomenclature[N]{$PC$}{Polycarbonate (Policarbonato)}

\nomenclature[N]{$PLA$}{Polylactic Acid (Ácido Poliláctico)}

\nomenclature[N]{$ABS$}{Acrylonitrile Butadiene Styrene (Acrilonitrilo Butadieno Estireno)}

\nomenclature[N]{$IEEE$}{Institute of Electrical and Electronics Engineers (Instituto de Ingeniería Eléctrica y Electrónica)}

\nomenclature[N]{$3D$}{Tridimensional}

\nomenclature[N]{$FSR$}{Force-sensing resistor (Sensor Sensible a Fuerza)}

\nomenclature[N]{$MEMS$}{Micro Electro-Mechanical Systems (Sistemas Micro Electro-Mecánicos)}

\nomenclature[N]{$ADC$}{Analogic to Digital Converter (Convertidor Analógico-Digital)}

\nomenclature[N]{$USD$}{U.S. dollar (dólar estadounidense)}

\nomenclature[N]{$PVC$}{Polyvinyl Chloride (Cloruro de polivinilo)}

\nomenclature[N]{$PET$}{Polyethylene Terephthalate (Tereftalato de polietileno)}

\nomenclature[N]{$IPS$}{Industrial Profile Systems (Sistemas de perfil industrial)}

\nomenclature[N]{$PCB$}{Printed Circuit Board (Tabla de circuito impreso)}

\nomenclature[N]{$GUI$}{Graphic User Interface (Interfaz Gráfica de Usuario)}

\nomenclature[S]{$v$}{Velocidad lineal}

\nomenclature[S]{$\omega$}{Velocidad angular}

\nomenclature[S]{$r$}{Radio}

\nomenclature[S]{$P$}{Potencia}

\nomenclature[S]{$\tau$}{Torque}

\nomenclature[S]{$F_{s}$}{Factor de seguridad}

\nomenclature[S]{$L_{b}$}{Longitud de la banda}

\nomenclature[S]{$C$}{Distancia entre centros}

\nomenclature[S]{$N_{polea}$}{Número de dientes de la polea}

\nomenclature[S]{$PD$}{Paso de la polea}

\nomenclature[S]{$F_{n}$}{Fuerza neta asociada al torque transmitido}

\nomenclature[S]{$F_{s}$}{Fuerza flexionante}

\nomenclature[S]{$T_{banda}$}{Torque transmitido por la banda}

\nomenclature[S]{$r$}{Radio de la polea}

\nomenclature[S]{$S_{n}$}{Límite de fatiga}

\nomenclature[S]{$S_{u}$}{Esfuerzo último a la tensión}

\nomenclature[S]{$S'_{n}$}{Límite de fatiga modificado}

\nomenclature[S]{$C_{m}$}{Factor de material}

\nomenclature[S]{$C_{st}$}{Factor de tipo de esfuerzo}

\nomenclature[S]{$C_{r}$}{Factor de confiabilidad}

\nomenclature[S]{$C_{s}$}{Factor de tamaño}

\nomenclature[S]{$D$}{Diámetro mínimo del eje}

\nomenclature[S]{$N$}{Factor de seguridad}

\nomenclature[S]{$K_{t}$}{Factor de concentración de esfuerzos}

\nomenclature[S]{$M$}{Momento flexionante}

\nomenclature[S]{$T$}{Esfuerzo torsionante}

\nomenclature[S]{$S_{y}$}{Esfuerzo de cedencia}

\nomenclature[S]{$C_{dinamica}$}{Capacidad de carga dinámica mínima del rodamiento}

\nomenclature[S]{$ P_{d}$}{Carga de diseño}

\nomenclature[S]{$L_{d}$}{Vida de diseño del rodamiento, en número de revoluciones}
 
\nomenclature[S]{$k_{rod}$}{Constante para rodamientos}

\nomenclature[S]{$H$}{Matriz de transformación homogénea}

\nomenclature[S]{$\theta_i$}{Ángulo de la junta $i$}

\nomenclature[S]{$a$}{Longitud del eslabón}

\nomenclature[S]{$d$}{Desplazamiento del eslabón}

\nomenclature[S]{$\alpha$}{Ángulo de giro del eslabón, formado entre $z_{i-1}$ y $z_i$ sobre el eje $x_i$}

\nomenclature[S]{$R$}{Matriz de orientación}

\nomenclature[S]{$o$}{Vector de posición}

\nomenclature[S]{$J$}{Jacobiano}

\nomenclature[S]{$z$}{Vector unitario en el eje Z}

\nomenclature[S]{$\mathcal{L}$}{Lagrangiano del sistema}

\nomenclature[S]{$\theta$}{Conjunto de coordenadas generalizadas}

\nomenclature[S]{$\mathcal{Q} $}{Conjunto de fuerzas generalizadas}

\nomenclature[S]{$ \mathcal{Q} $}{ Conjunto de fuerzas generalizadas }

\nomenclature[S]{$ \delta W^{NC}$}{ Trabajo virtual asociado a las fuerzas generalizadas }

\nomenclature[S]{$ \delta \theta$}{ Desplazamientos virtuales }

\nomenclature[S]{$ K $}{ Energía cinética  }

\nomenclature[S]{$ m $}{ Masa total  }

\nomenclature[S]{$ v $}{ Vector de velocidad lineal } 

\nomenclature[S]{$ \omega $}{ Vector de velocidad angular }

\nomenclature[S]{$ \mathcal{I} $}{ Tensor de inercia }

\nomenclature[S]{$ g  $}{  Vector de dirección de la gravedad en el marco inercial }

\nomenclature[S]{$ r_{ci} $}{ Coordenadas del centro de masa }

\nomenclature[S]{$ J_v $}{ Componente de velocidad lineal del Jacobiano }

\nomenclature[S]{$ J_{\omega} $}{ Componente de velocidad angular del Jacobiano }

\nomenclature[S]{$D(\theta) $}{ Matriz de inercia del sistema }

\nomenclature[S]{$ C(\theta, \dot{\theta}) $}{  Vector de fuerzas/pares centrífugas y de Coriolis }

\nomenclature[S]{$ g(\theta) $}{ Vector de fuerzas/pares gravitacionales y potencial }

\nomenclature[S]{$ K_1 $}{ Constante física del motor  }

\nomenclature[S]{$ \tau_0 $}{Par a rotor bloqueado}

\nomenclature[S]{$ R_a $ }{Resistencia de armadura}

\nomenclature[S]{$ \tau_{m}$}{Par motor generado  }

\nomenclature[S]{$ i_{a} $}{ Corriente de armadura  }

\nomenclature[S]{$ \phi $}{  Flujo magnético debido al estator }

\nomenclature[S]{$ K_m $}{ Constante de par motor }

\nomenclature[S]{$\tilde{P}_{1} $}{  Imagen original  }

\nomenclature[S]{$ \tilde{P}_{2} $}{ Imagen corregida }

\nomenclature[S]{$ H_m $}{ Matriz de homografía  }

\nomenclature[S]{$ x_{I} $}{ Número de pixeles desde el origen hasta el centro del objeto en la imagen izquierda }

\nomenclature[S]{$ x_{D} $}{ Número de pixeles desde el origen hasta el centro del objeto en la imagen derecha  }

\nomenclature[S]{$ z$}{ Profundidad }

\nomenclature[S]{$ b $}{ Distancia entre cámaras  }

\nomenclature[S]{$ x $}{ Distancia real }

\nomenclature[S]{$BH  $}{ Distancia horizontal al punto más lejano }

\nomenclature[S]{$BT $}{Longitud del brazo totalmente estirado}

\nomenclature[S]{$BV $}{Distancia de la base del robot hasta el suelo}

\nomenclature[S]{$v_{e} $}{Volumen ocupado por el eslabón}

\nomenclature[S]{$t_{e} $}{Espesor  del eslabón}

\nomenclature[S]{$h_{e} $}{Altura  del eslabón}

\nomenclature[S]{$l_{e} $}{Longitud del perfil del eslabón}

\nomenclature[S]{$r_{e} $}{Radio del chaflán del eslabón}

\nomenclature[S]{$m_{e} $}{Masa  del eslabón}

\nomenclature[S]{$\rho $}{Densidad del eslabón}
