EduardoSBarreraR/Trabajo_Terminal_2/preliminares/Simbologia.tex

\chapter{Simbolog\'ia}

% Definición de símbolos [Definición]{Nombre que usaremos}[Símbolo]
%    \opensymdef
%    \newsym[Gravedad]{gravedad}{g}
%    \newsym[Masa]{symm}{m}
%    \newsym[Velocidad de la luz]{symc}{c}
%    % Hay que usar \ensuremath en los símbolos matemáticos
%    \newsym[Longitud de onda]{symlam}{\ensuremath{\lambda}}
%    \closesymdef
%
%    % Crear lista de símbolos
%    \listofsymbols

%\listofsymbols

% symbols:

\glsaddall

\printglossary[type=symbol,style=index]
