EduardoSBarreraR/Trabajo_Terminal_2/imagenes/Presentación1.pptx

0.32 m

Primer eslabón

0.24 m

Segundo eslabón

0.10 m

Muñeca esférica

0.14 m

Efector

Muestra recogida

0.45 Kg
4.41 N

0.2 Kg
1.96 N

0.5 Kg
4.9 N

1 Kg
9.81 N

## Slide 2

0.32 m

Primer eslabón

0.24 m

Segundo eslabón

0.10 m

Muñeca esférica

0.14 m

Efector

5.6483 Nm

Muestra recogida

0.45 Kg
4.41 N

0.2 Kg
1.96 N

0.5 Kg
4.9 N

1 Kg
9.81 N

## Slide 3

0.24 m

Segundo eslabón

0.10 m

Muñeca esférica

0.14 m

Efector

Muestra recogida

5.6483 Nm

0.2 Kg
1.96 N

0.5 Kg
4.9 N

1 Kg
9.81 N

## Slide 4

Primer eslabón

Momento resultante

5.72 N m

4.41 N

Fuerza
resultante

16.67 N

## Slide 5

Segundo eslabón

Momento resultante

1.91 N m

1.96 N

Fuerza
resultante

14.715 N

## Slide 6

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
## Slide 7

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
## Slide 8

x_3

y_3 ′

x_3 ′

z_3 ′

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
