EduardoSBarreraR/Trabajo_Terminal_2/imagenes/Dominio especifico/Análisis mecánicos.pptx

97.5 mm

107.3 mm

72.52 mm

40.5 mm

52.43mm

9.8 mm

## Slide 2

87.7 mm

43.8 mm

61.35 mm

26.35 mm

## Slide 3

## Slide 4

M_b

37 mm

55 mm

C

D

B

A

12 mm

## Slide 5

∑ Fx=0 no hay fuerzas a las cuales reaccionar xD

MBr

∑ Fy=0;Ra+Rc+Rd−WBr−Wba=0

∑ MA=0;MBr−Mba+dRc+2dRd=0

Wba

∑ MB=0 ; MBr-dRa+dRd=0

∑ MBC=0

A

D

C (dos tornillos)

∑ MD=0; MBr+Mba−2dRa−dRc=0

## Slide 6
