EduardoSBarreraR/Trabajo_Terminal_2/imagenes/Dominio especifico/Efector/Acoplamiento sensores.pptx

Sensor
de fuerza

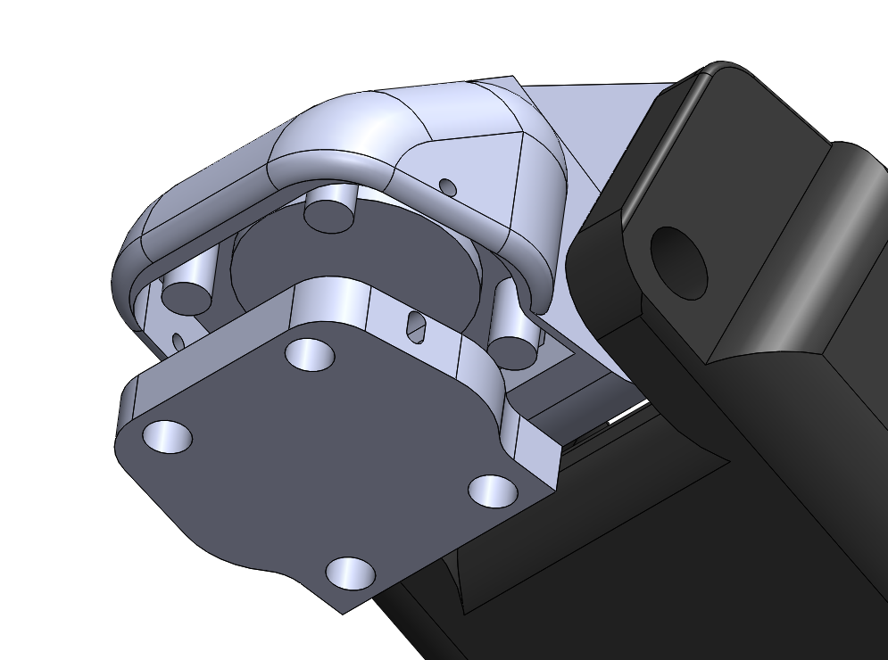
[picture p3: figure]

Agujeros de
sujeción

Placa
deslizante
