EduardoSBarreraR/Trabajo_Terminal_2/imagenes/Apendices/Arbol-decision-motores.pdf

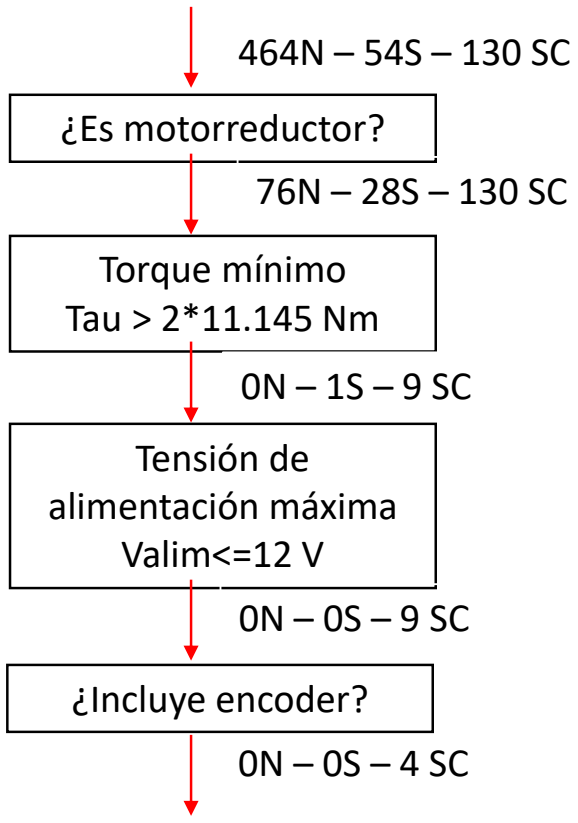
[picture p4: figure]
Torque mínimo Tau > 2*11.145 Nm; Tensión de alimentación máxima Valim<=12 V; ¿Es motorreductor?; ¿Incluye encoder?

N – Newark
S – Sparkfun
SC – ServoCity
