EduardoSBarreraR/Trabajo_Terminal_2/imagenes/Apendices/Arbol-decision-camaras.pdf

¿Incluye circuito?

Precio máximo
45 USD

Resolución máxima
5MP

635M – 54N –91R

13M – 4N – 70R

7M – 4N – 2R

0M – 0N – 2R

M – Mouser
N – Newark
R – Robotshop
