EduardoSBarreraR/Trabajo_Terminal_2/imagenes/Apendices/Arbol-decision-fuentes.pdf

Voltaje de salida
V=12V

Precio máximo
45 USD

Corriente máxima
i>20A

23S – 4836N –297R

1S – 544N – 70R

1S – 59N – 2R

0S – 0N – 2R

S – Sparkfun
N – Newark
R – Robotshop
