EduardoSBarreraR/Trabajo_Terminal_2/imagenes/Apendices/Arbol-decision-servo-muneca.pdf

Torque mínimo
Tau > 15 Kg cm

Precio máximo
25 USD

¿Tamaño estándar?

10D – 16S –106R

0D – 7S – 47 R

0D – 0S – 9R

0N – 0S – 1R

D – Dynamixel
S – Sparkfun
R – Robotshop
