EduardoSBarreraR/Trabajo_Terminal_2/preliminares/agradecimientos.tex

\chapter*{Agradecimientos}

A mis padres, Salvador Barrera Monroy y Elizabeth Rosales Martínez, por apoyarme siempre y esforzarse día a día, dándolo todo para que manis y yo pudiéramos estudiar y seguir nuestros sueños. A mi manis, Alejandra Elizabeth Barrera Rosales, a quien siempre he admirado, gracias por estar siempre a mi lado y ser un ejemplo a seguir. Gracias a ustedes he llegado a ser la persona que hoy soy.

A mis amigos y compañeros de equipo, Oscar Manuel Serna Mora y José Alejandro Millán López, con quienes he disfrutado cada momento que compartimos. No hubiera podido pedir un mejor equipo, pues hicieron de todo este proceso un verdadero placer. 

A mis asesores, el Doctor Diego Alonso Flores Hernández, que estuvo ahí para apoyarnos en todo momento, el Doctor Alberto Luviano Juárez, por sus valiosos consejos, y al Doctor Juan Humberto Sossa Azuela, por acompañarnos desde el principio. También quiero agradecer a la Maestra Elizabeth Rivas Bonilla, por habernos apoyado siempre que lo necesitamos.

Gracias al Instituo Politécnico Nacional, y a la Unidad Profesional Interdisciplinaria en Ingeniería y Tecnologías Avanzadas, por darme la oportunidad de aprender.

\begin{flushright}
    \textit{Eduardo Barrera}
%    \begin{figure}[H]
%        %\centering		
%            \includegraphics[scale=0.25]{imagenes/Anexos/Eduardo.jpeg}
%        \end{figure}
\end{flushright}

Gracias...

A mis padres por apoyarme en todo momento.

A mis compañeros de proyecto porque gracias a ellos el proyecto fue posible. 

A mis profesores por formarme como ingeniero.

A nuestros asesores por guiarnos en este proyecto con su conocimiento y experiencia. 

Al Instituto Politécnico Nacional y en particular a UPIITA por darme la oportunidad de ser un profesional.

A México por invertir en mi educación.

\begin{flushright}
    \textit{Alejandro Millán}
\end{flushright}

Primeramente, quisiera agradecer al Instituto Politécnico Nacional por la oportunidad de continuar mi preparación profesional en el programa de licenciatura de ingeniería mecatrónica en la UPIITA.

También me gustaría expresar mi gratitud hacia mis asesores de proyecto, Dr. Diego Alonso Flores Hernández, Dr. Alberto Luviano Juárez y Dr. Juan Humberto Sossa Azuela. Por su continuo apoyo y asesoramiento antes, durante y después de la realización del proyecto, así como también por su paciencia y conocimiento brindado.

Durante mi estancia en la UPIITA tuve la oportunidad de conocer a excelentes personas que hicieron de esta etapa de mi vida más memorable, entre ellas se encuentran mis compañeros de equipo, Eduardo Salvador Barrera Rosales y José Alejandro Millán López, con quienes trabajé en muchas ocasiones y que tengo el gusto de llamar amigos.

Finalmente, quiero agradecer a mi familia, ellos me han brindado su apoyo y cariño incondicional en esta y todas las etapas de mi vida y sin ellos no hubiera sido posible concluir este proyecto.

\begin{flushright}
    \textit{Oscar Serna}
\end{flushright}
