EduardoSBarreraR/Trabajo_Terminal_2/capitulos/metodologia.tex

\chapter{Marco de referencia}

\section{Marco teórico}

\subsection{Descripción de forma de partículas}

Medir dimensiones y características de partículas individuales es un proceso tardado y costoso, por ello existen escalas cualitativas que permiten una rápida evaluación visual de la misma. Dichas escalas evalúan parámetros como la angularidad y esfericidad,como la usada en la norma ASTM F1632 2003, que se muestra en la Figura \ref{fig:Esfericidaddd}. \footnote{Aunque esta escala está pensada para particulas de arena, aqui es de utilidad para caracterizar la forma de las rocas.}

\begin{figure}
\centering		
	
	\caption{Escala cualitativa para determinar visualmente la forma de una partícula \cite{Esfericidad}}
	\label{fig:Esfericidaddd}
\end{figure}

\subsection{Diseño de componentes de máquinas}

\subsubsection{Selección de materiales}

Las propiedades mecánicas de los materiales influyen en el desempeño de los componentes físicos, por esta razón es necesario tomar en cuenta sus límites para el diseño. Es de particular interés la relación entre la rigidez (módulo de Young) y la densidad\cite{Ashby}, pues permite diseñar un sistema ligero y capaz de manipular las muestras sin sufrir daños.

\subsubsection{Diseño de transmisión por bandas}

Para seleccionar las bandas, se debe establecer la relación de velocidades entre la polea conductora y la polea conducida, además del par que el motor suministra.

La velocidad tangencial de un objeto que gira se relaciona con la velocidad angular según la ecuación: 
%
\begin{align}
\label{eq:VTang}
& v = \omega \times r
\end{align}
%
En donde $v$[m/s] es la velocidad tangencial, $\omega$[rad/s] es la velocidad angular y $r$[m] el radio del objeto.

Posteriormente, se calcula la potencia de diseño $P_{ajustada}$[W] con la ecuación (\ref{eq:PotDis}), para lo cual es necesario conocer la potencia $P$[W] y el par $\tau$[Nm] que la banda debe transmitir (ecuación (\ref{eq:PotBanda})), así como el factor de servicio $F_s$[-] que se obtiene de tablas\cite{Mott}, con base en la aplicación, el tipo de motor y el tiempo de operación.
%
\begin{align}
	\label{eq:PotDis}
	P_{ajustada} &= P*F_S 
\end{align}
%
\begin{align}
	\label{eq:PotBanda}
	P &= \tau \omega
\end{align}

Basándose en el catálogo del proveedor, se determina el paso requerido de la banda \cite{BandasSDPSI} y se selecciona la combinación de poleas compatibles con la banda que producen la relación de velocidad especificada\cite{PoleasSDPSI}.

Conociendo el diámetro de las poleas seleccionadas, se calcula la longitud de la banda como sigue:
%
\begin{align}
\label{eq:LongBanda}
L_{b} &=  2C+N_{polea}*PD
\end{align}

En donde $L_{b}$[m] es la longitud de la banda, $C$[m] es la distancia entre centros, $N_{polea}$[-], el número de dientes de la polea y $PD$[mm] el paso de la banda.

Con la longitud de la banda calculada, se ajusta el valor de la potencia con la ecuación (\ref{eq:PotBandAjus}).
%
\begin{align}
\label{eq:PotBandAjus}
& \textrm{Potencia base nominal}_{ajustada} = \textrm{Potencia base nominal} * \textrm{Factor de corrección de longitud}
\end{align}

Finalmente, se calcula la velocidad lineal de las bandas para comprobar que operan con niveles bajos de ruido, como sigue:
%
\begin{align}
	\label{eq:VelBandRuido}
	V_{banda-1}&=\frac{PD_{1}}{2}*\omega_{1}\\
	V_{banda-2}&=\frac{PD_{2}}{2}*\omega_{2}
\end{align} 

\subsubsection{Diseño de ejes}

El diseño de un eje consiste en determinar el diámetro mínimo para un estado de esfuerzos estático. Primero se obtienen los esfuerzos debidos a momentos flectores para buscar el momento flector máximo para todos los diámetros diferentes del eje\cite{Mott}. Después se consideran los momentos torsionantes a los que se somete el eje.

Para calcular el momento flector deben tomarse en cuenta las tensiones que las bandas ejercen sobre el eje a través de las poleas, utilizando las ecuaciones
%
\begin{align}
\label{eq:FuerzaBanda}
F_{n} &= \frac{\tau_{banda}}{r}\\
F_{s} &= 1.5F_{n}
\end{align}

En donde $F_{n}$[N] es la fuerza neta asociada al par transmitido, $F_{s}$[N] es la fuerza flexionante, $\tau_{banda}$[Nm] es el par transmitido por la banda y $r$[m] es el radio de la polea.

Una vez que se obtienen estos valores, se propone un material y se corrigen los valores de resistencia última a fatiga con las ecuaciones \ref{eq:Sn} y \ref{eq:SnC}.
%
\begin{align}
\label{eq:Sn}
S_{n} &=0.5S_{u}
\end{align}
%
\begin{align}
\label{eq:SnC}
S'_{n} &= S_{n}C_{m}C_{st}C_{R}C_{s} 
\end{align}

En donde $S_n$[MPa] es el límite de fatiga, $S_u$[MPa] es el esfuerzo último a la tensión, $S'_n$[MPa] es el límite de fatiga modificado, $C_m$[-] es el factor del material, $C_{st}$[-] es el factor del tipo de esfuerzo, $C_R$[-] es el factor de confiabilidad y $C_s$[-] es el factor de tamaño.

Finalmente, se utiliza la fórmula \ref{eq:DiamEje} para calcular el diámetro mínimo del eje.

\begin{align}
\label{eq:DiamEje}
D &=\sqrt[3]{\frac{32N}{\pi}\sqrt{\left[ \frac{K_{t}M}{S'_{n}}^{2} \right] + \frac{3}{4} \left[ \frac{T}{S_{y}} \right]^{2} }}
\end{align}

En donde $D$[m] es el diámetro máximo del eje, $N$[-] es el factor de seguridad, $K_t$[-] es el factor de concentración de esfuerzos, $M$[Nm] es el momento flexionante, $T$[Nm] el momento torsionante y $S_y$[MPa] es el esfuerzo de cedencia.

\subsubsection{Selección de rodamientos}

Para seleccionar los rodamientos aleados, es necesario conocer las reacciones que tienen ante las fuerzas del eje, utilizando la ecuación (\ref{eq:RodamientosAleados}) para conocer la carga dinámica, que es el dato que ofrece el fabricante para su selección.
%
\begin{align}
\label{eq:RodamientosAleados}
C_{din\acute{a}mica} &= P_{d} \left( \frac{L_{d}}{10^{6}}\right)^{1/k_{rod}}
\end{align}

En donde $C_{din\acute{a}mica}$[N] es la capacidad de carga dinámica del rodamiento, $P_d$[N] es la carga de diseño, $L_d$[ciclos] es la vida de diseño del rodamiento medida en número de revoluciones y $k_{rod}$[-] es la constante del rodamiento (3.33 para rodamientos de rodillos).

\subsection{Cinemática de robots}

Para conocer la manera en la que el manipulador se mueve, es necesario identificar las relaciones que hay entre los diferentes grados de libertad que lo conforman, en este apartado se desarrolla dicha relación desde un enfoque geométrico, conocido como cinemática del robot.

\subsubsection{Cinemática directa}

El modelo cinemático sirve para describir geométricamente el movimiento del manipulador, para lo que se considera en primer lugar el problema de la cinemática directa, que describe la posición y orientación del efector final dados los valores de las variables de las juntas del robot. 

Una matriz de transformación homogénea representa una traslación y rotación de un marco coordenado $n$ con respecto de un marco base $0$, y está definida por la ecuación (\ref{eq:MTH}).
%
\begin{align}
\label{eq:MTH}
H&=
\begin{bmatrix}
R_{n}^{0} & o_{n}^{0} \\
0 & 1
\end{bmatrix}
\end{align}
%
En donde $H$ es la matriz homogénea de transformación, $R_n^0$ es la matriz de rotación de $3 \times 3$ y $o_n^0$ es un vector columna de $3 \times 1$ de desplazamiento.
%
Para calcular esta matriz, se utilizan matrices de la forma
%
\begin{align*}
A_{i}&=
\begin{bmatrix}
R_{i}^{i-1} & o_{i}^{i-1} \\
0 & 1
\end{bmatrix}
\end{align*}

que relacionan al marco $i$ con respecto al marco $i-1$, el cual se obtiene al acoplar rígidamente un marco de referencia a cada junta del sistema.

De esta manera, la matriz de la ecuación (\ref{eq:MTH}) se puede descomponer en una serie de transformaciones, como se ve en la ecuación (\ref{eq:HTA}).

\begin{align}
\label{eq:HTA}
H &= T_{n}^{0} = A_{1}( \theta_{1} ) \cdots A_{n}( \theta_{n} )
\end{align}

Para facilitar la asignación de marcos y la obtención de las matrices se utiliza la convención de Denavit-Hartenberg \cite{Spong}, asumiendo que el eje $x_1$ interseca perpendicularmente al eje $z_0$.

De esta manera, se puede representar la transformación $H$ de la ecuación (\ref{eq:MTH}) con matrices de la forma:
%
\begin{align*}
A_{i} &= 
\begin{bmatrix}
c_{\theta_{i}} & -s_{\theta_{i}}c_{\alpha_{i}} & s_{\theta_{i}}s_{i} & a_{i}c_{\theta_{i}}\\
s_{\theta_{i}} & c_{\theta_{i}}c_{\alpha_{i}} & -c_{\theta_{i}}s_{\alpha_{i}} & a_{i}s_{\theta_{i}}\\
0 & s_{\alpha_{i}} & c_{\alpha_{i}} & d_{i}\\
0 & 0 & 0 & 1\\
\end{bmatrix}
\end{align*}

En donde $\theta_i$ es la posición angular de la junta $i$, formado entre $x_{i-1}$ y $x_i$ sobre el eje $z_{i-1}$, $a$ es la longitud del eslabón, definida como la distancia sobre el eje $x_i$ desde el punto de intersección de $z_{i-1}$ con $x_{i}$ hasta el origen $O_i$, $d$ es el desplazamiento del eslabón, definido como la distancia sobre el eje $z_{i-1}$ desde el origen $O_{i-1}$ hasta la intersección de $z_{i-1}$ con $x_i$, y $\alpha$ es el ángulo de giro del eslabón, formado entre $z_{i-1}$ y $z_i$ sobre el eje $x_i$.

\subsubsection{Cinemática inversa}

Una vez que se ha resuelto el problema de cinemática directa, se puede realizar el proceso contrario, conocido como cinemática inversa, utilizado para conocer los valores de las variables de las juntas dada la posición y orientación del efector final.

Esto significa que de la ecuación (\ref{eq:MTH}), se conoce el valor de $H$, y el objetivo es encontrar el valor de $R_{n}^{0}(\theta_{1}\dots\theta_{n})$ y $o_{n}^{0}(\theta_{1}\dots\theta_{n})$.

En los sistemas robóticos con una muñeca esférica, los ejes de las 3 últimas juntas se intersecan en un punto, en el cual se asignan los orígenes de los marcos de referencia 3,4 y 5. Esto se conoce como \textit{desacoplamiento cinemático}, y permite separar el problema de cinemática inversa en 2 problemas más sencillos de resolver, conocidos como \textit{cinemática inversa de posición} y \textit{cinemática inversa de orientación}.

Para realizar este procedimiento, se interpreta que:
%
\begin{align}
\label{eq:DesCin}
R_{n}^{0}(\theta_{1} \dots \theta_{n}) &= R\\
\label{eq:DesCin2}
o_{n}^{0}(\theta_{1} \dots \theta_{n}) &= o
\end{align}

Siendo
%
\begin{align}
\label{eq:RTarget}
R=
\left[
\begin{array}{ccc}
r_{11} & r_{12} & r_{13}\\
r_{21} & r_{22} & r_{23}\\
r_{31} & r_{32} & r_{33}
\end{array}
\right]\\
o=
\begin{bmatrix}
ox & oy & oz
\end{bmatrix}^T
\end{align}

\textbf{Cinemática inversa de posición}

Desplazando una distancia $d_{6}$ el efector final $o$ hacia el origen de la muñeca $o_{c}$, se puede resolver $R_{3}^{0}$ como sigue:
%
\begin{align}
o_6^0 &= o_{c}^{0} + d_{6}R_6^0\begin{bmatrix}
0 & 0 & 1
\end{bmatrix}^T
\end{align}

\textbf{Cinemática inversa de orientación}

Conociendo $R_{3}^{0}$ se puede calcular $\theta_{1}$, $\theta_{2}$ y $\theta_{3}$, permitiendo resolver la ecuación (\ref{eq:R06Pieper}) para conocer $\theta_{4}$, $\theta_{5}$ y $\theta_{6}$
%
\begin{align}
\label{eq:R06Pieper}
R_{6}^{3} = \left(R_{3}^{0}\right)^{T}R
\end{align}

\subsubsection{Cinemática diferencial - El Jacobiano}

Matemáticamente la cinemática directa define una función entre el espacio de posiciones y orientaciones del efector final y el espacio de posiciones de las juntas. Las relaciones de velocidad están determinadas por el jacobiano de esta función. 

La i-ésima columna de la matriz Jacobiana para una junta de tipo revoluta está dada como sigue:
%
\begin{align}
J_{i} &= \begin{bmatrix}
 z_{i-1} \times (o_{n}-o_{i-1})\\   z_{i-1} 
\end{bmatrix}
\label{eq:JacRev}
\end{align}

\begin{flushright}
\textit{Singularidades.}
\end{flushright}

El rango de la matriz Jacobiana no es constante, pues depende de la configuración de las juntas del robot. Las configuraciones para los cuales el Jacobiano pierde rango se llaman singularidades, y su identificación es importante porque:
\begin{itemize}[noitemsep,nolistsep]
\item[a)]	Pueden representar configuraciones para las cuales ciertas direcciones de movimiento son inalcanzables.
\item[b)]	La velocidad de movimiento de las juntas puede diverger conforme se acercan a una posición singular.
\item[c)]	En las singularidades, fuerzas y momentos acotados del efector final pueden requerir fuerzas y momentos divergentes en las juntas.
\item[d)]	Las singularidades usualmente (aunque no siempre) corresponden a puntos en la frontera del espacio de trabajo del manipulador, es decir, los puntos de máximo alcance del manipulador.
\item[e)]	Las singularidades corresponden a puntos en el espacio de trabajo del manipulador que pueden ser inalcanzables bajo pequeñas perturbaciones en los parámetros de los eslabones, tales como desplazamiento, longitud, etc.
\item[f)]	Cerca de las singularidades, no existirá una única solución al problema de cinemática inversa. En tales casos puede no haber soluciones o existir infinitas. 
\end{itemize}

El problema de resolver la ecuación no lineal $det J(q)=0$ puede ser complicado, pero es posible utilizar una técnica que aprovecha el hecho de tener una muñeca esférica, conocida como desacoplamiento de singularidades. 
Si el número de grados de libertad es igual a 6, y tres de ellos corresponden al brazo y 3 de ellos a la muñeca esférica, el Jacobiano consistirá en una matriz de 6x6, como es una matriz cuadrada, será singular cuando $det(J)=0$.

Si se parte la matriz en segmentos de 3x3, se tiene: 
%
\begin{align}
J &=\begin{bmatrix}
J_{P}&| & J_{O}
\end{bmatrix} =
\begin{bmatrix} 
	\begin{array}{cc|cc}
	J_{11} &&& J_{12} \\
	\hhline{|-|~|~|-|}
	J_{21} &&& J_{22}
	\end{array}
\end{bmatrix}
\label{eq:JPO}
\end{align}

Como los últimos tres GDL son revoluta
%
\begin{align}
J_{O} &= \begin{bmatrix}
 z_{3} \times (o_{3}-o_{3})& z_{4} \times (o_{3}-o_{3}) & z_{5} \times (o_{3}-o_{3}) \\  z_{3}
 &  z_{4} &  z_{5}
\end{bmatrix}
\label{eq:JO}
\end{align}

Y ya que los ejes se intersecan en el mismo punto, se considera que los orígenes de los marcos de referencia del 3 al 6 están en el mismo punto, se vuelve
%
\begin{align}
J_{O} &= \begin{bmatrix}
 0& 0 & 0 \\  z_{3}
 &  z_{4} &  z_{5}
\end{bmatrix}
\label{eq:JO2}
\end{align}

Este caso, el Jacobiano se convierte en una forma triangular
%
\begin{align}
J &= \begin{bmatrix}
 J_{11}& 0   \\ 
J_{21} &  J_{22}
\end{bmatrix}
\label{eq:JTriang}
\end{align}

Y cuyo determinante se simplifica
%
\begin{align}
det (J)=det(J_{11})det(J_{22})
\label{eq:detJ}
\end{align}

De forma que las singularidades del sistema son las singularidades del brazo $det J_{11}=0$ y de las singularidades de la muñeca $det J_{22}=0$.

Cabe señalar que esta forma de Jacobiano solo sirve para la determinación de singularidades, pues no se corresponde con la matriz que relaciona la velocidad el efector final con las velocidades de las juntas, ya que usa la suposición de que $o_{6}$ está en el mismo punto que $o_{5}$, lo cual no es cierto, pues está desplazado por una distancia $d$. 

\subsubsection{Control}
Un enfoque típico para controlar sistemas robóticos es considerar cada junta como un sistema de control independiente que intenta seguir su trayectoria de manera precisa. Sin embargo, esto representa un reto complicado debido a perturbaciones asociadas a la gravedad, velocidades y aceleraciones producidas por el resto de las juntas, así como la fricción en cada una de ellas. Por esta razón, se propone utilizar una técnica de control por juntas independientes con base en uno de los métodos de control automáticos más comunes, conocido como PID (proporcional, integral y diferencial), cuya utilidad estriba en que se puede aplicar a la mayoría de los sistemas de control, en particular cuando el modelo de la planta no se conoce. El proceso de seleccionar los parámetros del control se conoce como sintonzación del controlador que se puede realizar experimentalmente si no se conoce el modelo matemático.\cite{Ogata}

\subsection{Convertidores CD-CD}

Los reguladores lineales, cuyo principio de operación está basado en divisores de corriente o voltaje, son ineficientes, pues su voltaje de salida está limitado a ser menor que el voltaje de entrada, además de que requieren filtros y transformadores de línea de baja frecuencia. Por esta razón su principal uso es en aplicaciones de baja potencia, mientras que en aplicaciones de mayor potencia se usan reguladores conmutados.

Mientras que los reguladores lineales trabajan en su región activa, los reguladores conmutados se basan en interruptores semiconductores de electrónica de potencia que trabajan en los estados de \textit{encendido} y \textit{apagado}. Debido a que dichos estados presentan bajas pérdidas de potencia (bajo voltaje en el estado \textit{encendido}, y corriente cero en el estado \textit{apagado}), alcanzan eficiencias altas en la conversión de energía. Entre más alta la frecuencia de operación, más ligeros y pequeños son sus componentes.\cite{Potencia}

La Tabla \ref{Tab:Reguladores} muestra una comparación entre reguladores.

\begin{table}
\caption{Guía de selección de reguladores de tensión}
\begin{scriptsize}
\begin{tabular}{c|c|c|}
\cline{2-3}
                                                                                                                	& \textbf{Regulador lineal}                                                                                                                      	& \textbf{Regulador conmutado}                                                                                            	\\ \hline
\multicolumn{1}{|c|}{\textbf{Flexibilidad de diseño}}                                                           	& Bajada                                                                                                                                         	& Subida, bajada, subida y bajada                                                                                         	\\ \hline
\multicolumn{1}{|c|}{\textbf{Eficiencia}}                                                                       	& \begin{tabular}[c]{@{}c@{}}Generalmente baja, media para una \\ diferencia pequeña entre la tensión \\ de entrada y tensión de salida\end{tabular} & Alta                                                                                                                    	\\ \hline
\multicolumn{1}{|c|}{\textbf{Complejidad}}                                                                      	& Baja                                                                                                                                           	& Media a alta                                                                                                            	\\ \hline
\multicolumn{1}{|c|}{\textbf{Tamaño}}                                                                           	& \begin{tabular}[c]{@{}c@{}}Pequeño a mediano, crece conforme \\ a la potencia\end{tabular}                                                     	& \begin{tabular}[c]{@{}c@{}}Pequeño aún a potencias altas\\ (aunque depende de la \\ frecuencia de conmutación)\end{tabular} \\ \hline
\multicolumn{1}{|c|}{\textbf{Costo total}}                                                                      	& Bajo                                                                                                                                           	& \begin{tabular}[c]{@{}c@{}}De medio a alto (Componentes \\ externos)\end{tabular}                                       	\\ \hline
\multicolumn{1}{|c|}{\textbf{\begin{tabular}[c]{@{}c@{}}Rizo/ruido/interferencia \\ electromagnética\end{tabular}}} & Bajo                                                                                                                                           	& De medio a alto                                                                                                         	\\ \hline
\multicolumn{1}{|c|}{\textbf{\begin{tabular}[c]{@{}c@{}}Rango de tensión \\ de entrada\end{tabular}}}           	& \begin{tabular}[c]{@{}c@{}}Estrecho debido a la \\ disipación de potencia\end{tabular}                                                         	& Amplio                                                                                                                  	\\ \hline
\end{tabular}
\end{scriptsize}
\label{Tab:Reguladores}
\end{table}

\subsection{Selección de cables}

Dependiendo de la intensidad de corriente que un cable debe transportar, y de la longitud del mismo, debe elegirse un calibre de cable siguiendo la Figura \ref{fig:CableCalibre}, desarrollada por Enerdrive\cite{CablEner} bajo el estándar AWG (Calibres de Alambre Americanos - American Wire Gauges por sus siglas en inglés) con ayuda de estos pasos:

\begin{enumerate}[noitemsep,nolistsep]
\item Localizar en la Figura la intensidad de corriente en CD que fluye por el cable.
\item Determinar el tipo de circuito en los siguientes tipos
	\begin{itemize}[noitemsep,nolistsep]
	\item Crítico: Aplicaciones como paneles de alimentación, electrónica, extractores y luces de navegación.
	\item No crítico: Aplicaciones como iluminación general, electrodomésticos. 
	\end{itemize} 
\item Determinar la longitud total de cable, sumando alambres negativos y positivos.
\item Identificar el símbolo asociado al valor de intensidad de corriente en CD y la longitud del cable.
\item Relacionar el símbolo con el código de color para encontrar las especificaciones del cable.
\end{enumerate}

\subsection{Visión artificial}

La visión por computadora es una de las herramientas más poderosas que existen para permitir a un robot identificar las condiciones del ambiente en el que opera.

Una de las herramientas más utilizadas para implementar algoritmos de visión son las cámaras RGB-D, como el Kinect\textregistered (Figura \ref{fig:KinectMic}). Estas se componen de una cámara convencional, así como un proyector y sensor de luz infrarroja, mediante los cuales es capaz de generar una imagen de profundidad en formato rgb o escala de grises utilizando los datos de distancia perpendicular al plano del sensor mediante el despliegue de una malla de puntos calibrada para mostrar un patrón específico en una superficie plana, y cuando dichos puntos están en otra posición es posible obtener la distancia a la que se encuentran. Estos datos no tienen una relación lineal con la profunidad real, por lo que para su conversión a distancia se deben tomar en cuenta los parámetros intrínsecos de la cámara, obtenidos y calibrados previamente, por lo que es posible hacer una función que permita conocer la ubicación espacial de cada pixel que se muestra en la imagen de profundidad\cite{FisherKinect}.

\begin{figure}
    \centering		
	
	\caption{Kinect, fabricado por Microsoft\textregistered}
	\label{fig:KinectMic}
\end{figure}

\section{Marco procedimental}

\subsection{Metodología mecatrónica}
La metodología de diseño mecatrónico que se utiliza es el modelo V, descrito en el estándar VDI 2206\cite{VDI2206}, el cual considera al proceso de diseño como un
``macro-ciclo'' en el que el grado de madurez se incrementa con cada iteración, y cuyo número
de iteraciones depende del progreso realizado con cada una hasta llegar a un producto final
que cumpla satisfactoriamente con las expectativas de desempeño esperadas.
Este modelo consta de 3 fases principales, denominadas \textbf{``Diseño del sistema''}, la cual es la
fase inicial y comienza definiendo los requerimientos que el sistema debe satisfacer, seguido
de la descomposición de las funciones que lleva a cabo, para poder dar paso a la fase de
\textbf{``Diseño de dominio específico''}, en el que se realiza un diseño a profundidad de cada una
de las disciplinas involucradas, para llegar finalmente a la \textbf{``Integración del sistema''}, en
donde se implementan todos los módulos y se unen para trabajar armónicamente.
Además de las fases principales, el modelo cuenta con 2 fases que son transversales a todo
el proceso, las cuales son el \textbf{``Modelado y análisis del modelo''}, en la cual se realizan
modelos que describen el comportamiento de cada uno de los módulos y del sistema en
general, para poder realizar simulaciones que ayudan en la fase de \textbf{``Validación y
verificación''}, la cual se realiza en todo momento para evaluar el desempeño de cada
módulo y determinar el grado de madurez del proyecto.

\begin{figure}
	\centering		
	
	\caption{Modelo V como metodología para el diseño mecatrónico(VDI 2206)\cite{VDI2206}}
	\label{fig:VDI2206}
\end{figure}

\subsection{FBS}
La estructura de descomposición funcional (FBS por sus siglas en inglés, \textit{Functional Breakdown Strucure}) es un desglose modular de todas las funciones que se deben ejecutar para cumplir con un objetivo. El FBS no detalla productos, sino operaciones o actividades que deben ser ejecutadas. No está atado a ninguna solución del sistema, porque es un listado de funciones necesarias, no de los elementos del mismo. La aproximación al problema de la ingeniería de sistemas desde el punto de vista de funciones, en vez de desde el punto de vista de elementos o hardware, permite a los ingenieros evaluar la completitud del diseño mediante una lista exhaustiva de requerimientos funcionales. 

Una característica significativa del FBS es que permite comparar y elegir conceptos solución, pues sirve para identificar redundancias o elementos faltantes.

Una vez que se ha elegido el concepto solución, el FBS sirve como una guía en el desarollo de la estructura desglosada, pues provee visibilidad de las tecnologías que deben ser desarrolladas para la ejecución de las funciones requeridas, además de que ayuda a identificar las capacidades necesarias de las personas que van a desarrollar y operar el sistema.\cite{FBS}

\subsection{IDEF0}
La definición de integración para modelado de funciones (IDEF0 por sus siglas en inglés, \textit{Integration Definition for Function Modeling}) es un estándar utilizado para analizar, implementar, rediseñar e integrar sistemas siguiendo una metodología específica. El objetivo de implementar esta herramienta es proveer un medio para describir y modelar completamente las funciones(actividades, acciones, procesos y/u operaciones) que el sistema debe realizar, así como las relaciones que hay entre ellas, con las siguientes características:\cite{IDEF0}

\begin{itemize}[noitemsep,nolistsep]
	\item Generalidad, permitiendo analizar sistemas con diferentes propósitos, alcances y complejidades.
	\item Rigurosidad y precisión, para delimitar el sistema.
	\item Concisión, para facilitar la comprensión y comunicación de ideas para llegar a acuerdos que validen el sistema.
	\item Conceptualización, para representar el sistema en requerimientos funcionales en lugar de componentes físicos o soluciones específicas.
	\item Flexibilidad, para poder evaluar el avance durante todo el desarrollo del sistema.
	\item Se puede aplicar independientemente de la metodología y herramientas utilizadas, aunque puede apoyarse en ellas.
\end{itemize}

\subsection{eFFBD}
El Diagrama a Bloques Mejorado del Flujo de Funciones (eFFBD por sus siglas en inglés, \textit{Enhanced Function Flow Block Diagram})es un formalismo ampliamente usado para modelar y analizar el comportamiento de sistemas complejos de ingeniería. De manera más precisa, el eFFBD describe las funciones llevadas a cabo por el sistema y el orden en que se van a ejecutar. Este orden se especifica a través de los parámetros dinámicos de funciones, entorno de control y de datos. También ofrece una gran variedad de construcciones de control, como ramas paralelas, ciclos, ramas de decisión, etc.\cite{eFFBD}

La implementación de la metodología V se apoya de las herramientas descritas en esta sección, pues permite desarrollar una solución multidominio a partir de las funciones que se deben llevar a cabo, de modo que se materializan las soluciones, lo que lleva a la selección de materiales, diseño de elementos de máquina y algoritmos implementados con ayuda circuitos electrónicos. A continuación se muestran las fases de diseño del sistema, diseño de dominio específico e integración.
