EduardoSBarreraR/Trabajo_Terminal_2/apendices/apendice6-DiagramasFlujo.tex

\chapter{Apéndice 6: Diagramas de flujo}
\setcounter{section}{0}
\section{Diagrama de flujo del algoritmo implementado por la PC}
\label{Ap:DFPC}
\begin{figure}
    \centering		
    
\end{figure}

\clearpage

\section{Diagrama de flujo del algoritmo ejecutado por el microcontrolador}
\label{Ap:DFMicro}
\begin{figure}
    \centering		
        
\end{figure}
