EduardoSBarreraR/Trabajo_Terminal_2/capitulos/conclusiones.tex

\chapter{Conclusiones}

Conforme al análisis de ingeniería realizado se puede concluir que el funcionamiento del sistema es correcto a nivel modular, aunque presenta fallos en la integración. Esto se puede atribuir a diversas causas, por ejemplo, el uso contínuo del manipulador provoca holgura mecánica entre sus componentes, lo cual es dificil de corregir sin la infraestructura adecuada. Aún así, el funcionamiento general del sistema se encuentra dentro de parámetros aceptables. 

Tomando en cuenta lo anterior y promediando los porcentajes calculados para los objetivos particulares, se determina que el objetivo general se satisface al 86.97\%.

\section{Trabajo a futuro}
\label{sec:TrabajoFuturo}

El uso de encoders incrementales hace necesario conocer la posición inicial, que debe ser calibrada manualmente, lo que afecta la repetibilidad del sistema. Esto se puede solucionar utilizando encoders absolutos, que eliminan la necesidad de tener una posición conocida. 

La masa no da una descripción completa de las características del entorno, por lo que se requiere mejorar el sistema de laboratorio para obtener más información de la muestra recogida, como la composición química a través de análisis espectrográfico.

Ocurren caídas repentinas del manipulador asociadas a la configuración del robot, lo que puede solucionarse al implementar un control más robusto, que sea capaz de reaccionar rápidamente a cambios en la distribución del peso de la muestra tomada.

El sistema es vulnerable a las condiciones del entorno, como polvo, agua, temperatura y el campo electromagnético, por lo que se pueden aislar los componentes del robot de las condiciones del entorno, tales como cables, bandas y motores, a fin de protegerlo.

El efector requiere que la muestra estuviera centrada para tener un mejor agarre, por lo que un ligero desvío provocaba que los dedos cerraran de manera dispareja, y al momento de levantarla el dedo que no ejercía la presión necesaria, permitiendo que la muestra cayera, por lo que se requiere un análisis en la longitud de las falanges subactuadas, además de mejorar el rango de movimiento de las mismas, para permitir al efector abrirse más.

No existe una manera de restringir el movimiento del manipulador, incrementando el riesgo de colisiones con el sistema estructural y/o con los mismos elementos del manipulador. Se pueden colocar sensores (fin de carrera, capacitivos o inductivos) en puntos estratégicos del sistema, para así mantener su integridad física.

La orientación paralela del Kinect con la superficie limita el campo de visión, el cual podría ampliarse y abarcar todo el espacio de trabajo del robot si se gira, calculando la matriz de rotación sobre los ejes principales para trasladar las coordenadas obtenidas con respecto del marco referencial del Kinect al del robot.

En la interfaz de usuario, el operador solo es capaz de ver la imagen de profundidad, la cual puede ser dificil de interpretar, por lo que es posible mostrar la imagen RGB proporcionada por el Kinect implementando una función de correspondencia entre esta con la imagen de profundidad.

La holgura mecánica entre los componentes representa un problema que disminuye la precisión del robot (e.g. los opresores que sujetan las poleas dañan el eje), lo que podría mejorarse al cambiar el método de sujeción.

Durante las pruebas se hizo patente una alta probabilidad de que el efector golpee el objeto durante la aproximación al mismo, este problema puede ser solventado implementando una generación de trayectoria en el espacio de trabajo que se aproxime verticalmente a la muestra objetivo.
