EduardoSBarreraR/Trabajo_Terminal_2/apendices/apendice2.tex

\chapter{Apéndice 4: Herramienta de selección multicriterio}
\setcounter{section}{0}

\section{Criterios de selección}

\begin{itemize}[noitemsep,nolistsep]
	\item Módulo de manipulador robótico
		\begin{itemize}[noitemsep,nolistsep]
	
		\item[Cr1] \textbf{Potencia requerida:} Potencia necesaria para que el manipulador efectúe movimiento. 
	
		\item[Cr2] \textbf{Complejidad de la transmisión de movimiento angular:} Cantidad de piezas y complejidad de las mismas, que transmiten la potencia desde el actuador hasta el elemento que debe mover. 
	
		\item[Cr3] \textbf{Facilidad de acoplamiento al \textit{rover}:} Cantidad de piezas necesarias y su complejidad, para asegurar el manipulador a la estructura del \textit{rover}. 
		
		\item[Cr4] \textbf{Riesgo de daño a la estructura del \textit{rover}:} La generación de esfuerzos excesivos en los puntos de acoplamiento puede provocar que la estructura se deforme y falle.
		
		\item[Cr5] \textbf{Espacio de trabajo:} Puntos en el espacio que son alcanzables por el efector final del brazo.
	
		\item[Cr6] \textbf{Modificación de equilibrio al \textit{rover} por el manipulador:} Reducción de la posibilidad de volcadura del \textit{rover} debida a un brazo de palanca excesivo producido por el manipulador. 
	
		\item[Cr7] \textbf{Facilidad de acoplamiento entre el eslabón y el actuador:} Cantidad
	de piezas y complejidad de las mismas, para transmitir la potencia
	desde el actuador hasta el elemento que debe mover.
	
		\end{itemize}
		
	%-----------------------------------------
	\item Módulo del efector final
		\begin{enumerate}[noitemsep,nolistsep]
		\item[Cr8] \textbf{Generación de reacción a los actuadores del manipulador:} Potencia requerida por los actuadores del manipulador a causa del peso propio del efector.  
		\item[Cr9] \textbf{Transmisión de fuerza al punto de contacto con la muestra:} La fuerza generada por el actuador debe aplicarse al punto de contacto con la piedra para permitir la sujeción. 
		\item[Cr10] \textbf{Eficiencia en la sujeción:} La sujeción debe ser tal que se obtenga máximo agarre con la menor fuerza posible.
		\item[Cr11] \textbf{Facilidad de colocación de los sensores de fuerza:} Los sensores de fuerza deben colocarse en espacios que no afecten a la eficiencia de sujeción.
		\item[Cr12] \textbf{Complejidad de la transmisión de fuerza:} Cantidad de componentes y complejidad de los mismos en la transmisión de fuerza desde el actuador al punto de contacto.
		\item[Cr13] \textbf{Riesgo de daños a la muestra o efector: } Confiabilidad de que la muestra no se dañe o se dañe el efector al intentar tomarla.
		
		\end{enumerate}
		
	%-----------------------------------------
	\item Módulo de información
		\begin{enumerate}[noitemsep,nolistsep]
		
		\item[Cr14] \textbf{Colocación de las cámaras: }Por su posición procurar que no haya elementos que obstruyan el campo de visión.
		\item[Cr15] \textbf{Pérdida de información:} La pérdida por desconexión o por longitud excesiva de cableado. 
		\item[Cr16] \textbf{Precisión de medición de temperatura:} Proximidad del valor real de temperatura al valor medido.
		\item[Cr17] \textbf{Influencia de los cambios térmicos del ambiente a los componentes:} Capacidad del sistema para evitar que la temperatura afecte al comportamiento de los componentes. 
		\item[Cr18] \textbf{Confiabilidad de sujeción:} Sujeción adecuada de los componentes en la estructura.
	
		\end{enumerate}
		
	\item Módulo de laboratorio
		\begin{enumerate}[noitemsep,nolistsep]
		\item[Cr19] \textbf{Efectividad del mecanismo de desecho:} Asegurar que la muestra no permanezca en el \textit{rover}.
		\item[Cr20] \textbf{Complejidad del mecanismo de desecho:} Cantidad de piezas y complejidad de las mismas, para efectuar la tarea de deshacerse de la muestra una vez analizada.
		\item[Cr21] \textbf{Aprovechamiento del espacio ocupado por el mecanismo de desecho}
		\item[Cr22] \textbf{Aseguramiento de la muestra: }  Garantizar que la muestra permanezca en el lugar donde puede obtenerse información de ella.
		\item[Cr23] \textbf{Aprovechamiento del espacio ocupado por el sistema de medición de peso} 	
		
		\end{enumerate}
		
	\item Sistema de administración energética
		\begin{enumerate}[noitemsep,nolistsep]
		\item[Cr24] \textbf{Distribución del peso:} Modificación del centro de masa del sistema debido a la posición de los componentes.
		\item[Cr25] \textbf{Aprovechamiento del espacio ocupado:} Aprovechamiento del espacio debido al tamaño.
		\item[Cr26] \textbf{Pérdidas energéticas: } Pérdidas ocasionadas por la longitud de los cables.
		\item[Cr27] \textbf{Riesgo de daños a las baterías:} Posibilidad de que las baterías se dañen por efectos del ambiente.
		\end{enumerate}
	
	\end{itemize}

\section{Selección de concepto mediante AHP}
\label{Ap:AHP}

%---------Vector de prioridad de criterios
\section*{Vector de prioridad de criterios}
Vector de prioridad de criterios

\begin{table}[H]
\centering
\caption*{Vector de prioridad de criterios}
\footnotesize
\begin{tabular}{|c|c|lcc}
\cline{1-2} \cline{4-5}
Criterio & Valor de prioridad & \multicolumn{1}{l|}{} & \multicolumn{1}{c|}{Criterio} & \multicolumn{1}{c|}{Valor de prioridad} \\ \cline{1-2} \cline{4-5} 
Cr1      & 0.03946            & \multicolumn{1}{l|}{} & \multicolumn{1}{c|}{Cr15}     & \multicolumn{1}{c|}{0.05497}            \\ \cline{1-2} \cline{4-5} 
Cr2      & 0.01975            & \multicolumn{1}{l|}{} & \multicolumn{1}{c|}{Cr16}     & \multicolumn{1}{c|}{0.01192}            \\ \cline{1-2} \cline{4-5} 
Cr3      & 0.02517            & \multicolumn{1}{l|}{} & \multicolumn{1}{c|}{Cr17}     & \multicolumn{1}{c|}{0.01890}            \\ \cline{1-2} \cline{4-5} 
Cr4      & 0.08119            & \multicolumn{1}{l|}{} & \multicolumn{1}{c|}{Cr18}     & \multicolumn{1}{c|}{0.06500}            \\ \cline{1-2} \cline{4-5} 
Cr5      & 0.04096            & \multicolumn{1}{l|}{} & \multicolumn{1}{c|}{Cr19}     & \multicolumn{1}{c|}{0.04421}            \\ \cline{1-2} \cline{4-5} 
Cr6      & 0.06121            & \multicolumn{1}{l|}{} & \multicolumn{1}{c|}{Cr20}     & \multicolumn{1}{c|}{0.01120}            \\ \cline{1-2} \cline{4-5} 
Cr7      & 0.01637            & \multicolumn{1}{l|}{} & \multicolumn{1}{c|}{Cr21}     & \multicolumn{1}{c|}{0.00738}            \\ \cline{1-2} \cline{4-5} 
Cr8      & 0.04025            & \multicolumn{1}{l|}{} & \multicolumn{1}{c|}{Cr22}     & \multicolumn{1}{c|}{0.05611}            \\ \cline{1-2} \cline{4-5} 
Cr9      & 0.03078            & \multicolumn{1}{l|}{} & \multicolumn{1}{c|}{Cr23}     & \multicolumn{1}{c|}{0.00698}            \\ \cline{1-2} \cline{4-5} 
Cr10     & 0.05910            & \multicolumn{1}{l|}{} & \multicolumn{1}{c|}{Cr24}     & \multicolumn{1}{c|}{0.01994}            \\ \cline{1-2} \cline{4-5} 
Cr11     & 0.01356            & \multicolumn{1}{l|}{} & \multicolumn{1}{c|}{Cr25}     & \multicolumn{1}{c|}{0.00597}            \\ \cline{1-2} \cline{4-5} 
Cr12     & 0.02198            & \multicolumn{1}{l|}{} & \multicolumn{1}{c|}{Cr26}     & \multicolumn{1}{c|}{0.02888}            \\ \cline{1-2} \cline{4-5} 
Cr13     & 0.08555            & \multicolumn{1}{l|}{} & \multicolumn{1}{c|}{Cr27}     & \multicolumn{1}{c|}{0.06817}            \\ \cline{1-2} \cline{4-5} 
Cr14     & 0.02932            &                       & \multicolumn{1}{l}{}          & \multicolumn{1}{l}{}                    \\ \cline{1-2}
\end{tabular}
\end{table}

\begin{figure}[H]
\centering		
	
	\caption*{Jerarquia de criterios}
\end{figure}

\pagebreak

\section*{Selección de concepto}
Selección de concepto

\begin{figure}[H]
\centering		
	
	\caption*{Desempeño general de los conceptos solución}
\end{figure}
\pagebreak

\section*{Desempeño general: Ce vs Cm}
Evaluación final del concepto elegido contra el concepto mejorado
\begin{figure}[H]
\centering		
	
\end{figure}
