EduardoSBarreraR/Trabajo_Terminal_2/apendices/apendice5.tex

\chapter{Apéndice 5: Códigos implementados}
\setcounter{section}{0}
\section{Código para la Interfaz Gráfica de Usuario}
\label{Ap:CodigoGUIProcessing}
%\ProcessingSketch{Programas/GUI/Vision___serial___gui5_reporte/Vision___serial___gui5_reporte}{Código implementado para la interfaz gráfica de usuario, así como cálculo de cinemática inversa a través de la visión artificial}
\lstinputlisting[language=Processing]{Programas/GUI/Vision___serial___gui5_reporte/Vision___serial___gui5_reporte.pde}

\section{Código implementado en la tarjeta Núcleo}
\label{Ap:CodigoNukleo}
\lstinputlisting[language=C++]{Programas/STM32F446RE/main.cpp}
