EduardoSBarreraR/Trabajo_Terminal_2/imagenes/Seleccion de concepto/Ganador.pdf

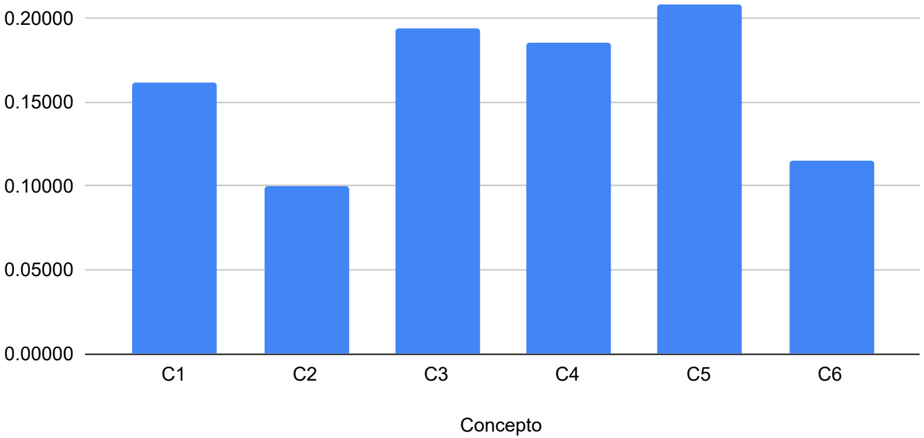
[picture p29: figure]
Concepto

Desempeño

0.25000
