EduardoSBarreraR/Trabajo_Terminal_2/imagenes/Seleccion de concepto/AHP/Cr15.pdf

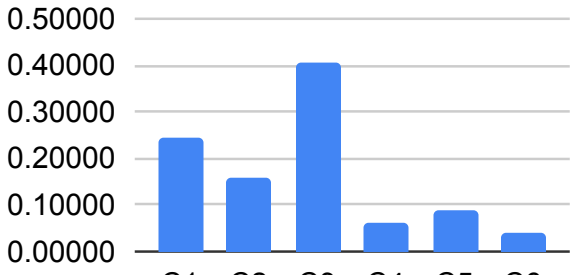
[picture p36: figure]

Concepto

Desempeño

C1 C2 C3 C4 C5 C6
