EduardoSBarreraR/Trabajo_Terminal_2/imagenes/Seleccion de concepto/AHP/Cr18.pdf

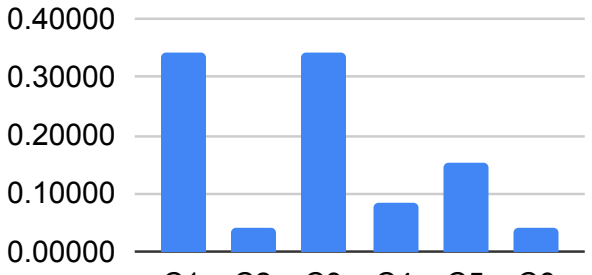
[picture p39: figure]

Concepto

Desempeño

C1 C2 C3 C4 C5 C6
