EduardoSBarreraR/Trabajo_Terminal_2/imagenes/Pesos.pdf

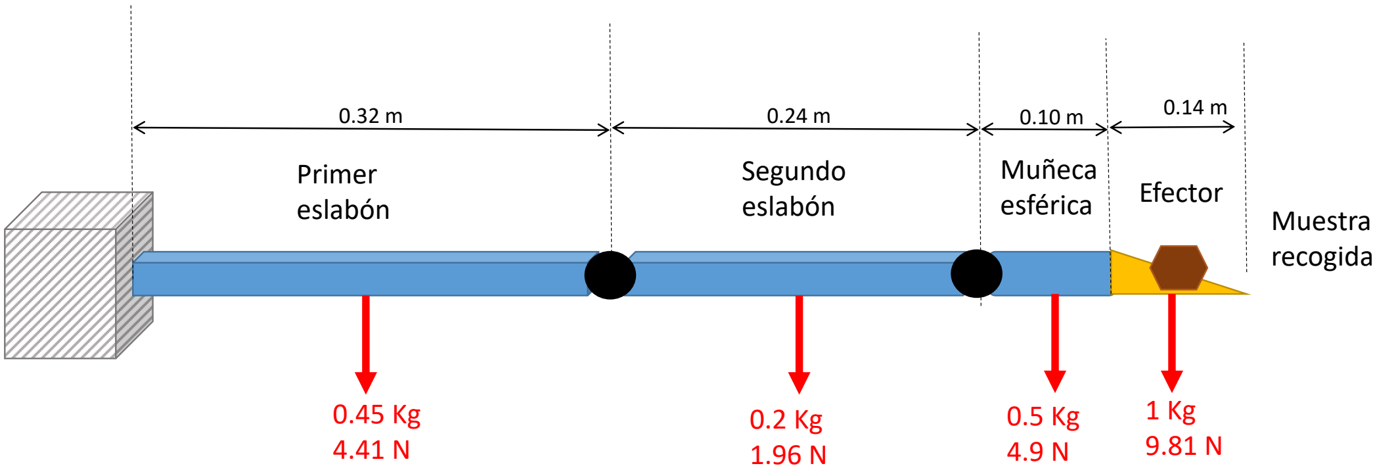
[picture p57: figure]
Primer eslabón; Segundo eslabón; Muñeca; esférica; Efector; Muestra recogida

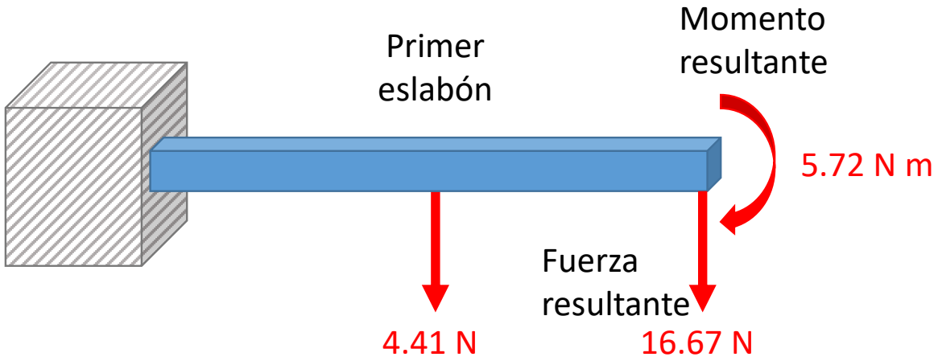
[picture p58: figure]
Primer eslabón; Fuerza resultante; Momento resultante

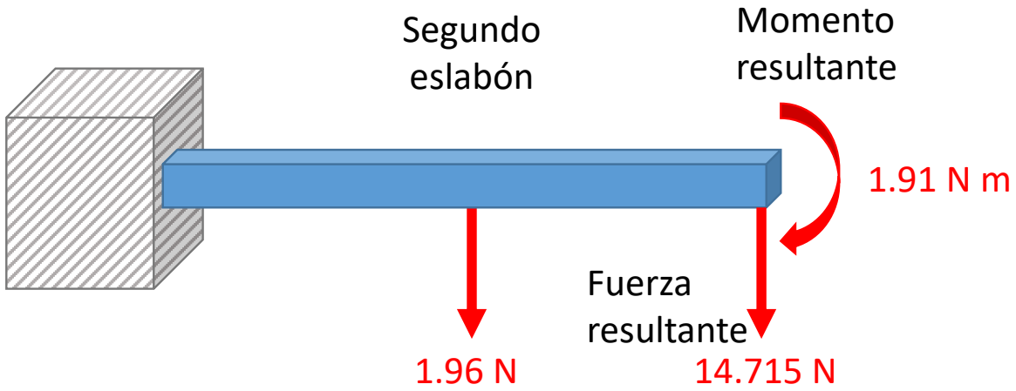
[picture p59: figure]
Segundo eslabón; Fuerza resultante; Momento resultante
