EduardoSBarreraR/Trabajo_Terminal_2/imagenes/INTEGRACION/Munefector.pdf

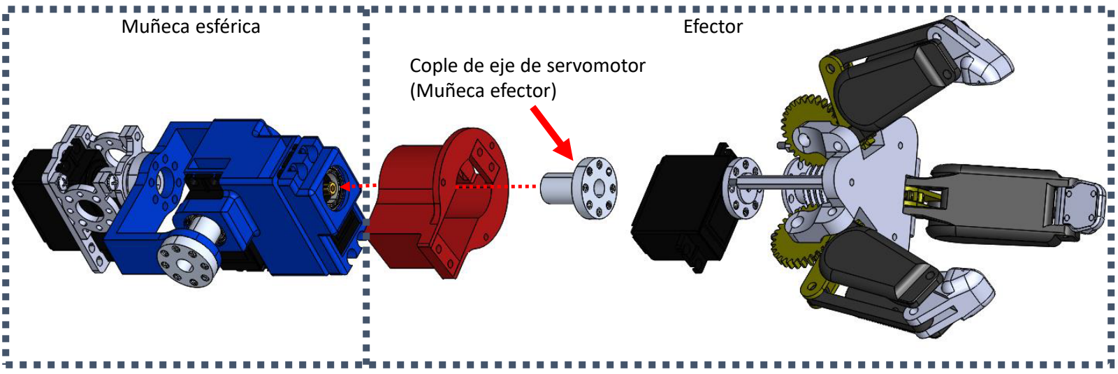
[picture p60: page 1]

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
e se

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
