EduardoSBarreraR/Trabajo_Terminal_2/imagenes/Modelos/FBS.pdf

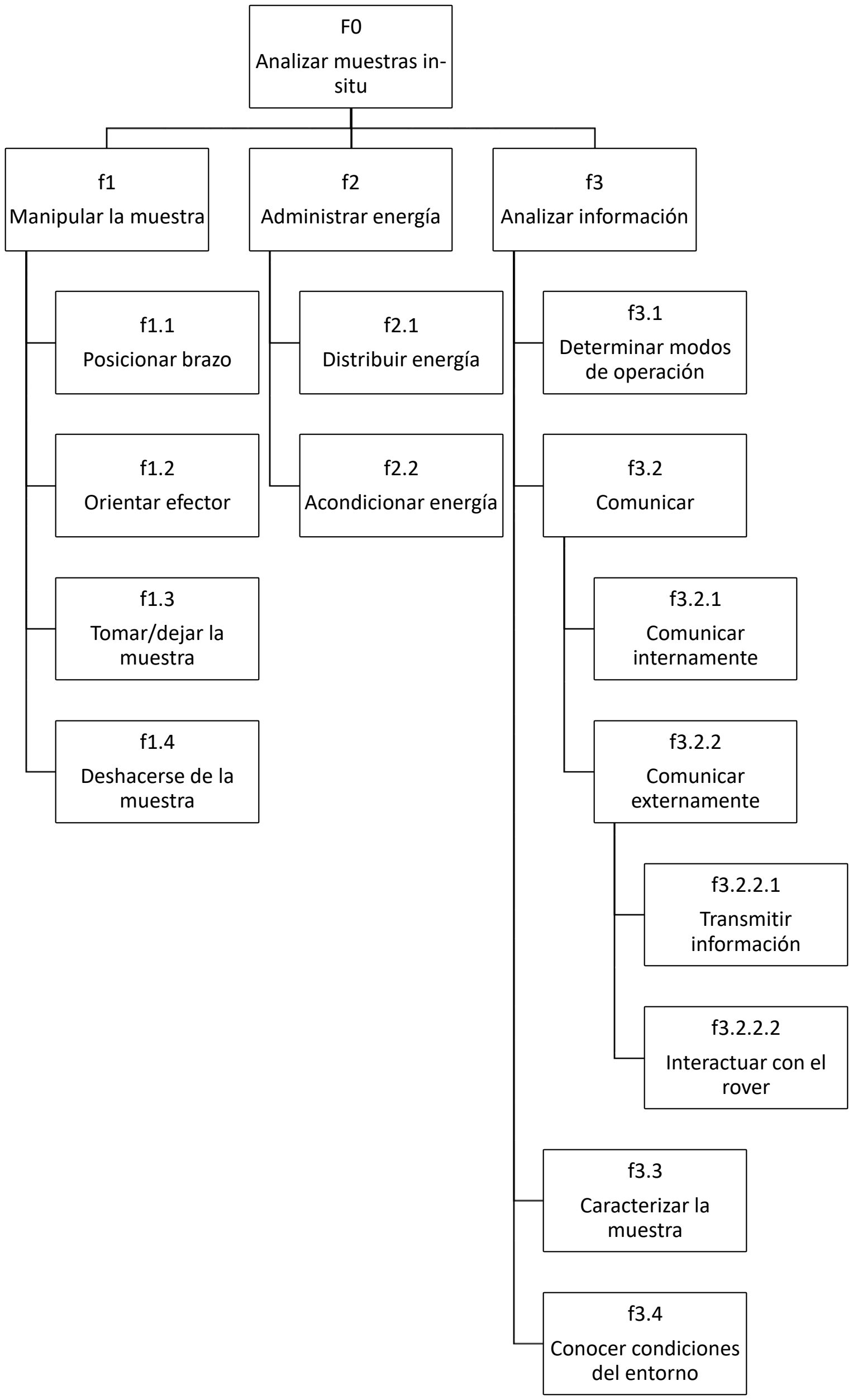
[picture p61: page 1]

F0
Analizar muestras insitu

f1
Manipular la muestra

f1.1
Posicionar brazo

f1.2
Orientar efector

f1.3
Tomar/dejar la
muestra

f1.4
Deshacerse de la
muestra

f2
Administrar energía

f2.1
Distribuir energía

f2.2
Acondicionar energía

f3
Analizar información

f3.1
Determinar modos
de operación

f3.2
Comunicar

f3.2.1
Comunicar
internamente

f3.2.2
Comunicar
externamente

f3.2.2.1
Transmitir
información

f3.2.2.2
Interactuar con el
rover

f3.3
Caracterizar la
muestra

f3.4
Conocer condiciones
del entorno
