EduardoSBarreraR/Trabajo_Terminal_2/imagenes/Seleccion de concepto/AHP/Selección de concepto final.xlsx

 | Cr1 | Cr2 | Cr3 | Cr4 | Cr5 | Cr6 | Cr7 | Cr8 | Cr9 | Cr10 | Cr11 | Cr12 | Cr13 | Cr14 | Cr15 | Cr16 | Cr17 | Cr18 | Cr19 | Cr20 | Cr21 | Cr22 | Cr23 | Cr24 | Cr25 | Cr26 | Cr27
Cr1 | 1.00000 | 7.00000 | 5.00000 | 0.33333 | 5.00000 | 0.20000 | 5.00000 | 3.00000 | 2.00000 | 0.14286 | 5.00000 | 3.00000 | 0.20000 | 0.50000 | 0.25000 | 7.00000 | 5.00000 | 0.33333 | 0.33333 | 3.00000 | 5.00000 | 0.20000 | 7.00000 | 3.00000 | 5.00000 | 5.00000 | 0.20000
Cr2 | 0.14286 | 1.00000 | 6.00000 | 0.20000 | 0.20000 | 0.20000 | 0.33333 | 0.14286 | 0.50000 | 0.33333 | 5.00000 | 1.00000 | 0.20000 | 0.33333 | 0.20000 | 3.00000 | 2.00000 | 0.33333 | 0.20000 | 3.00000 | 5.00000 | 0.20000 | 5.00000 | 3.00000 | 5.00000 | 0.33333 | 0.33333
Cr3 | 0.20000 | 0.16667 | 1.00000 | 0.11111 | 0.20000 | 0.20000 | 3.00000 | 0.33333 | 0.14286 | 0.14286 | 3.00000 | 2.00000 | 0.20000 | 7.00000 | 5.00000 | 0.20000 | 0.33333 | 0.14286 | 0.20000 | 0.20000 | 5.00000 | 0.20000 | 5.00000 | 0.14286 | 5.00000 | 5.00000 | 0.14286
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
