EduardoSBarreraR/Trabajo_Terminal_2/imagenes/AcercamientoBaseGiratoria.png

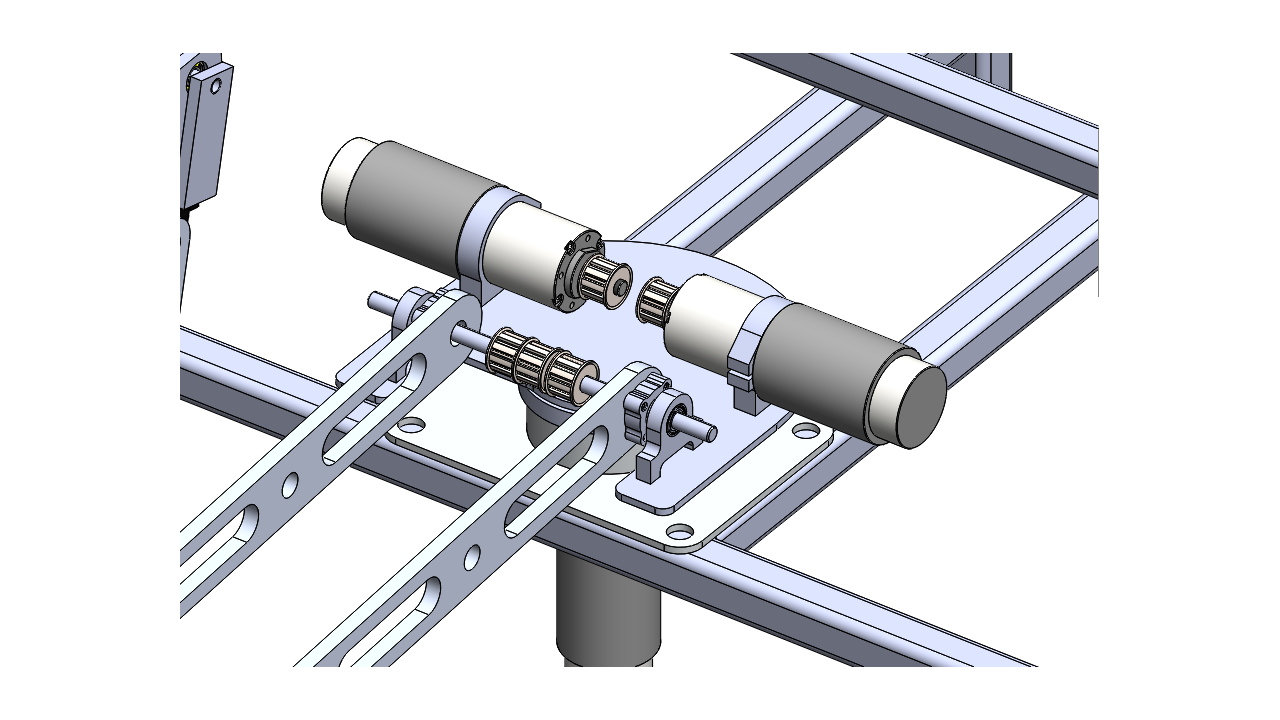
imagenes/AcercamientoBaseGiratoria.png
