EduardoSBarreraR/Trabajo_Terminal_2/imagenes/Anexos/535026 NonFlanged Bearing.png

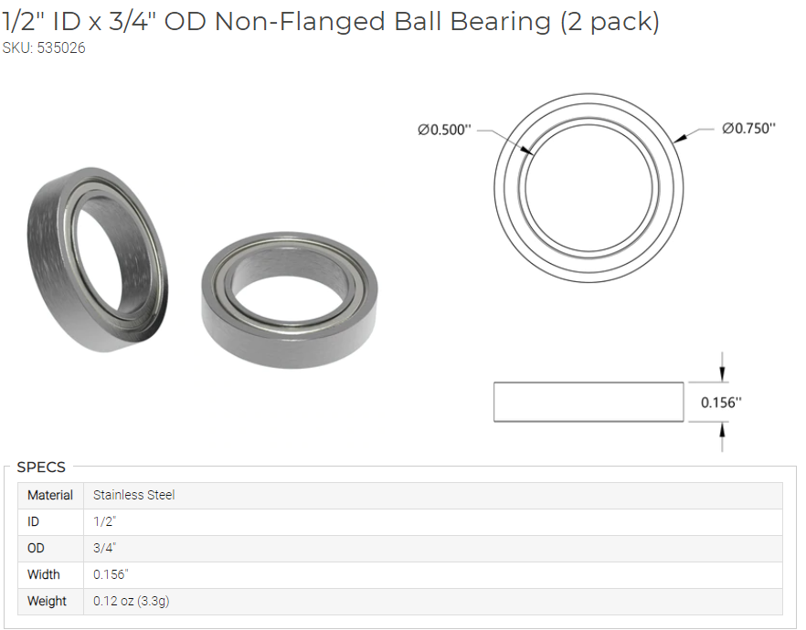
imagenes/Anexos/535026 NonFlanged Bearing.png
