EduardoSBarreraR/Trabajo_Terminal_2/imagenes/Anexos/Abrazadera motor 555176.png

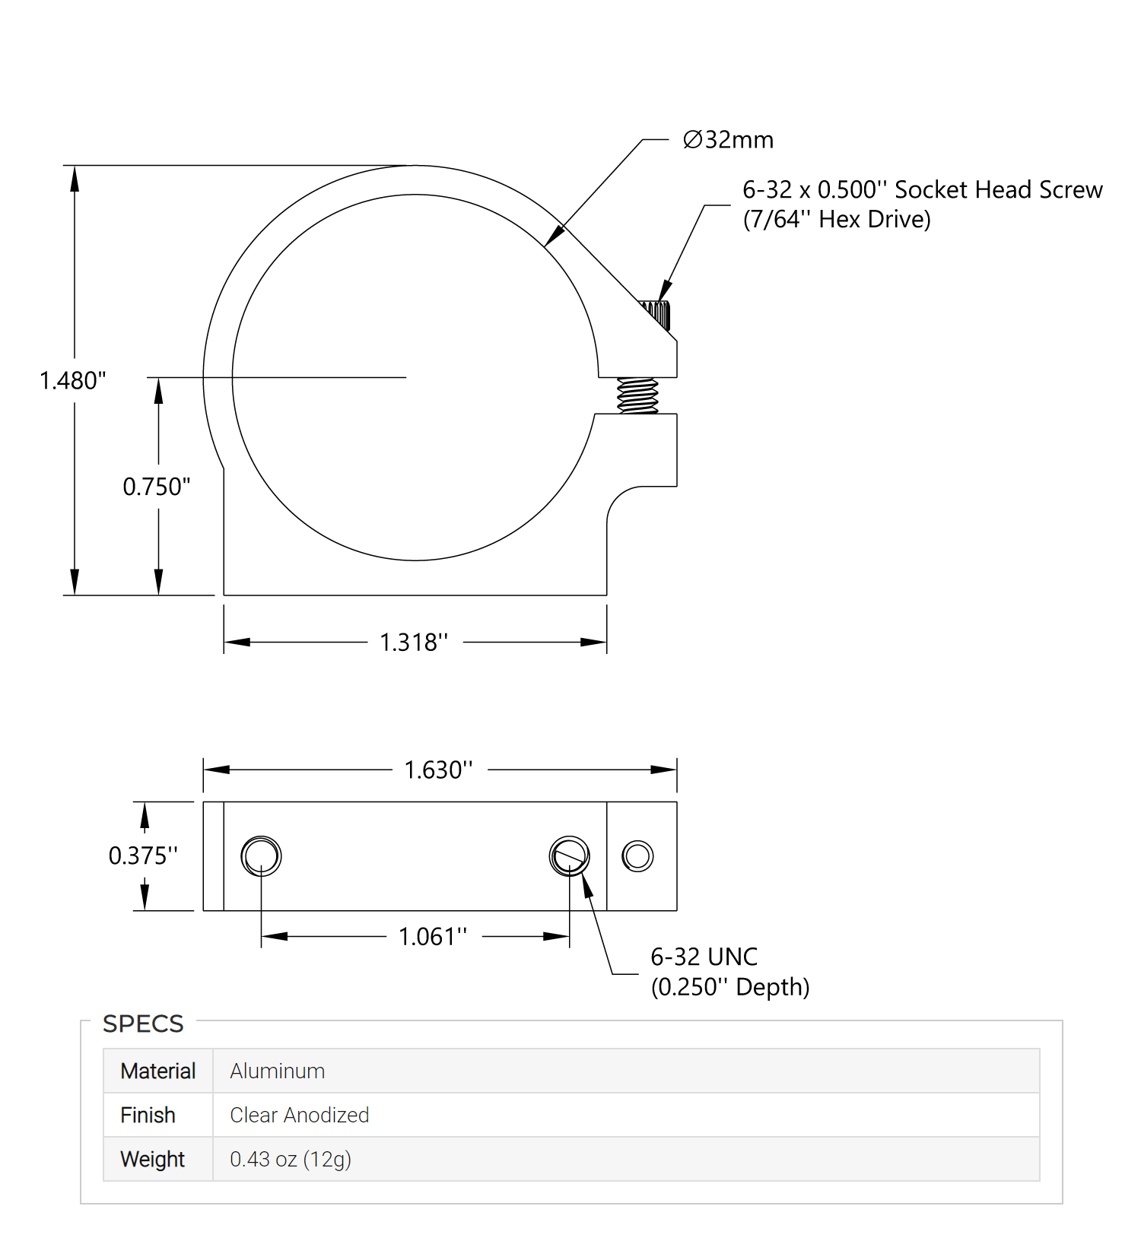
imagenes/Anexos/Abrazadera motor 555176.png
