EduardoSBarreraR/Trabajo_Terminal_2/imagenes/Anexos/Bloque portador de carga para servo 637112.png

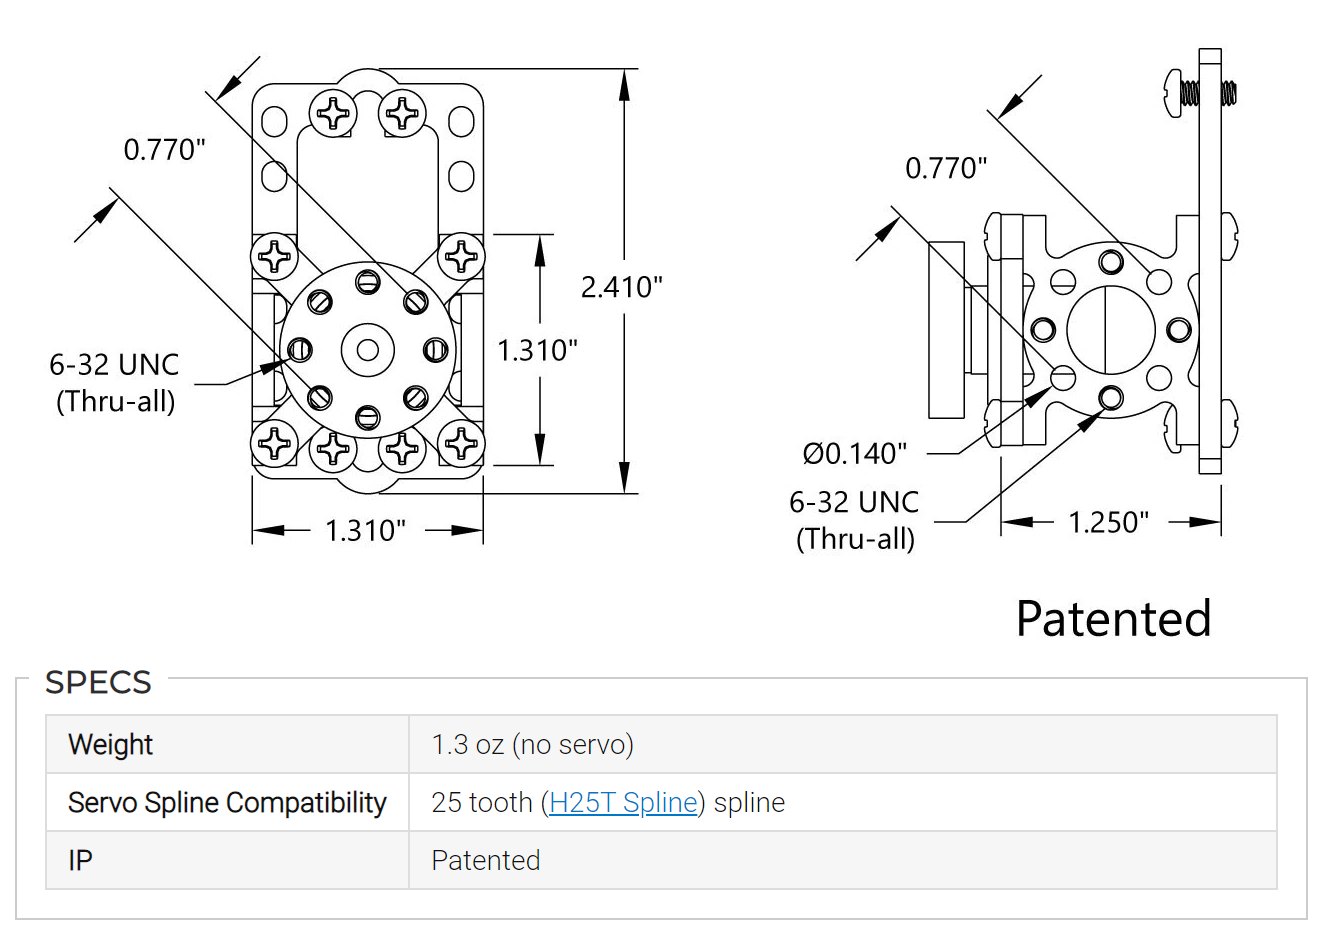
imagenes/Anexos/Bloque portador de carga para servo 637112.png
