EduardoSBarreraR/Trabajo_Terminal_2/imagenes/Anexos/Buje de eje 525123.png

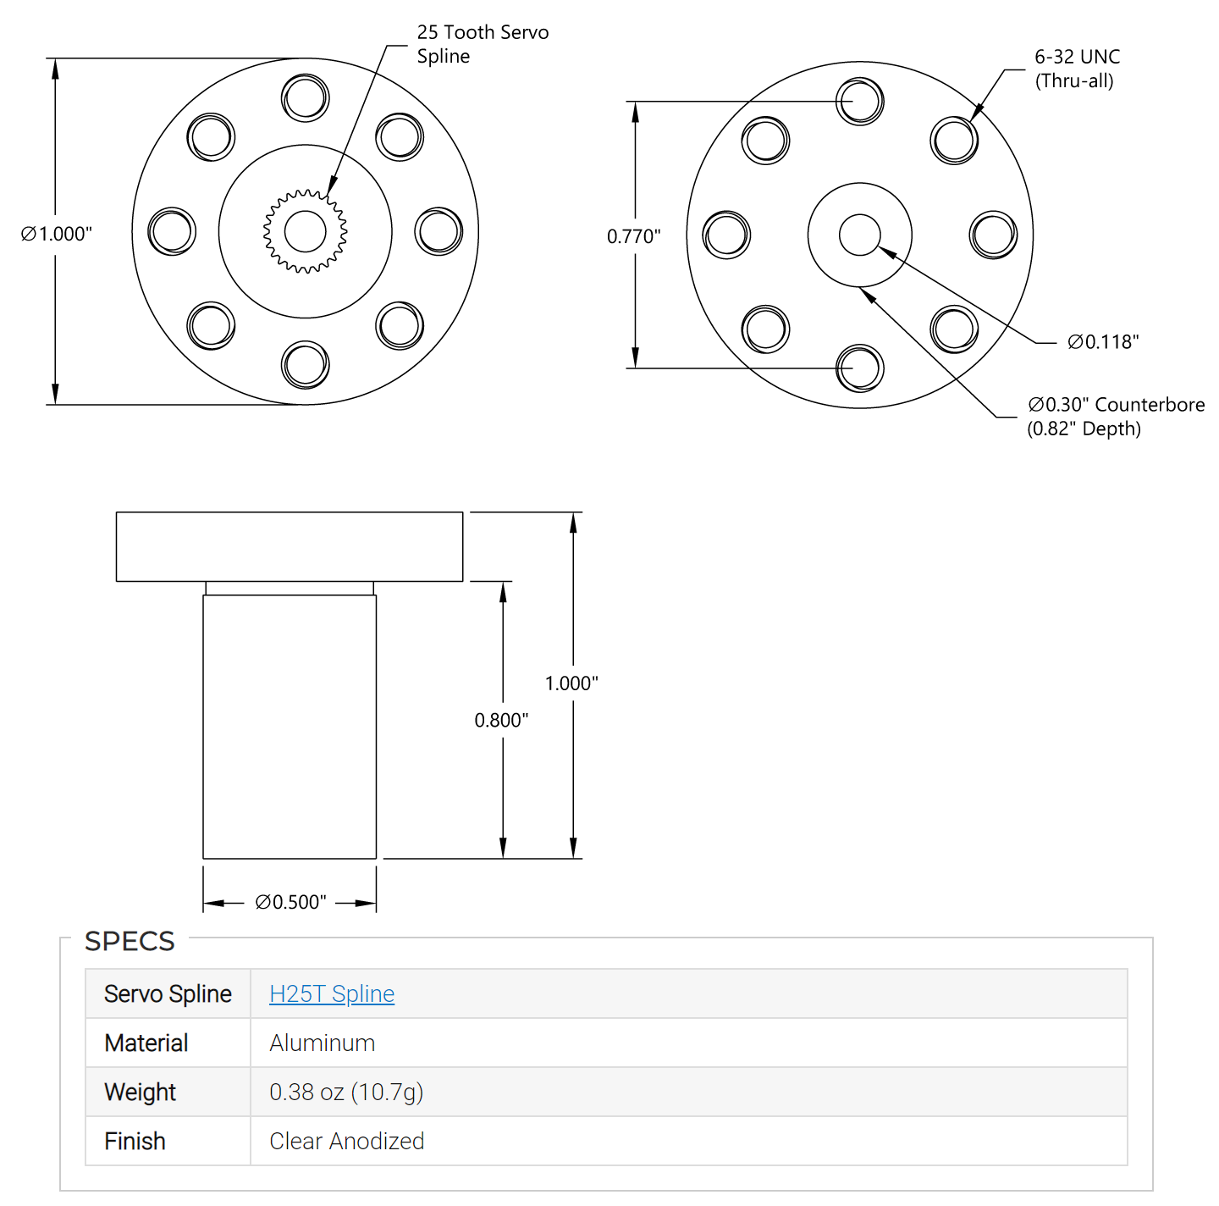
imagenes/Anexos/Buje de eje 525123.png
