EduardoSBarreraR/Trabajo_Terminal_2/imagenes/Anexos/Buje servo 525125.png

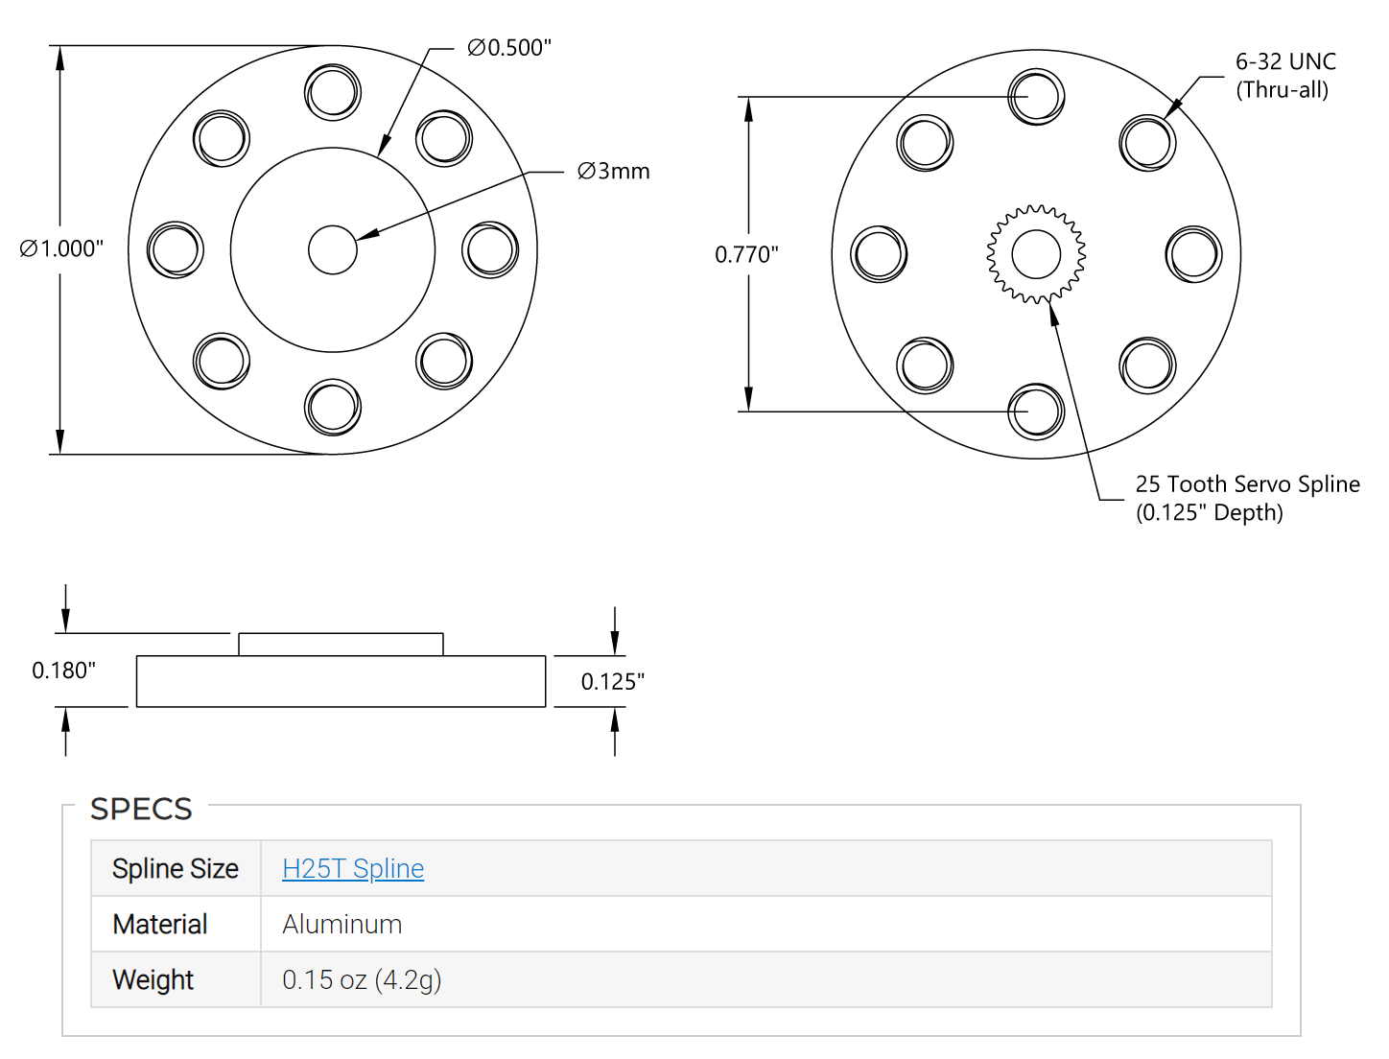
imagenes/Anexos/Buje servo 525125.png
