EduardoSBarreraR/Trabajo_Terminal_2/imagenes/Anexos/Chumacera de piso.PNG

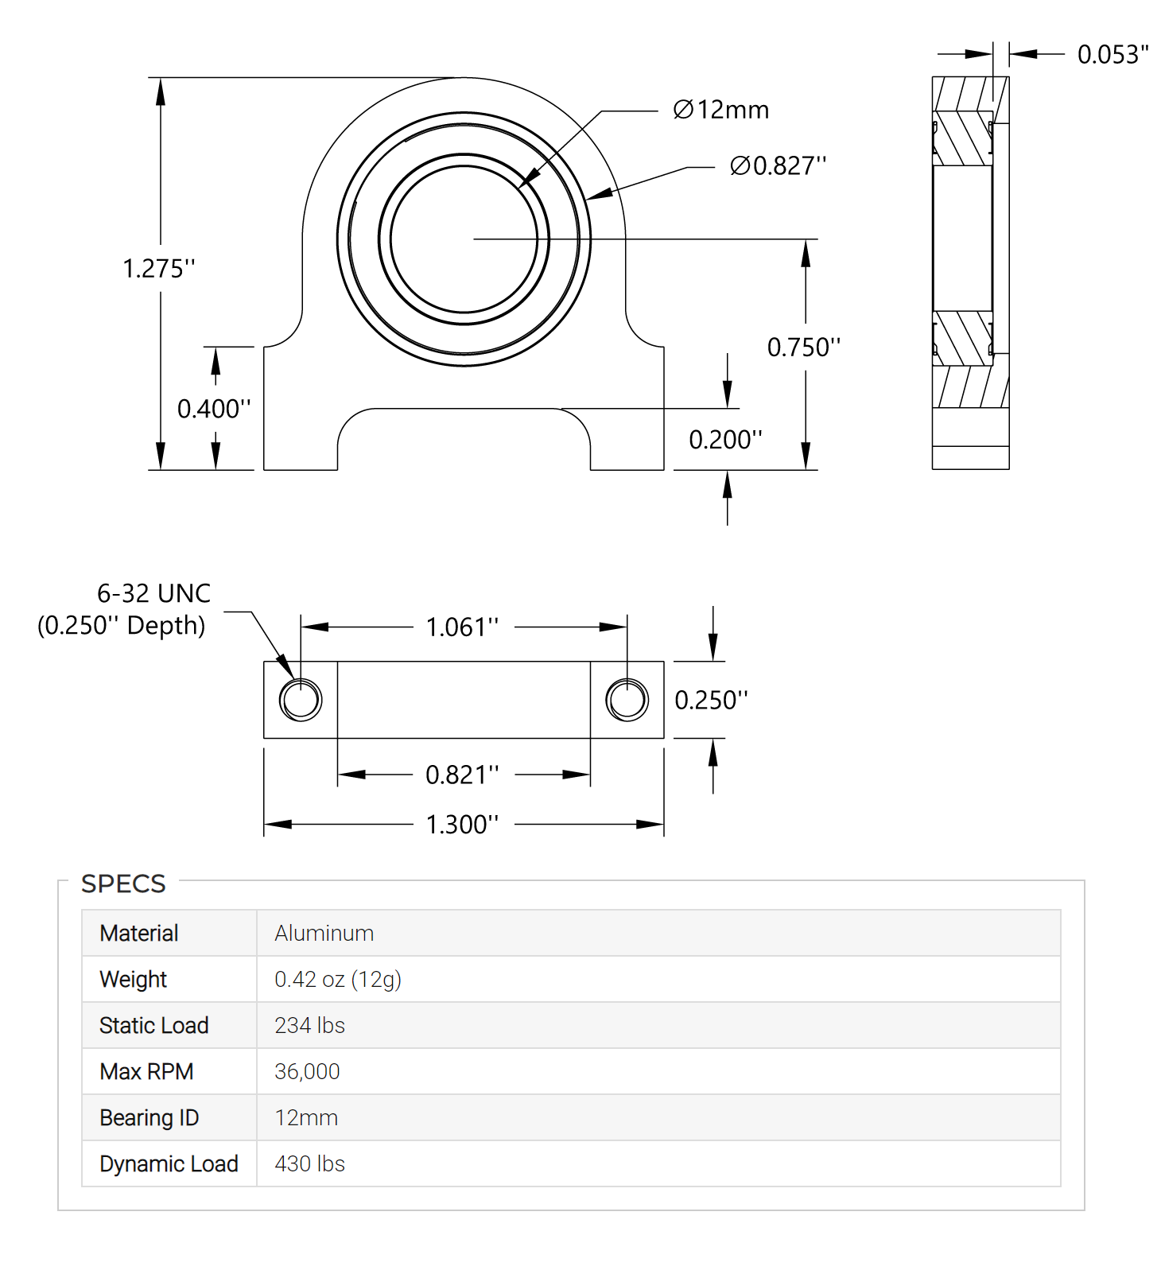
imagenes/Anexos/Chumacera de piso.PNG
