EduardoSBarreraR/Trabajo_Terminal_2/imagenes/Anexos/Ez robot servo 0007.png

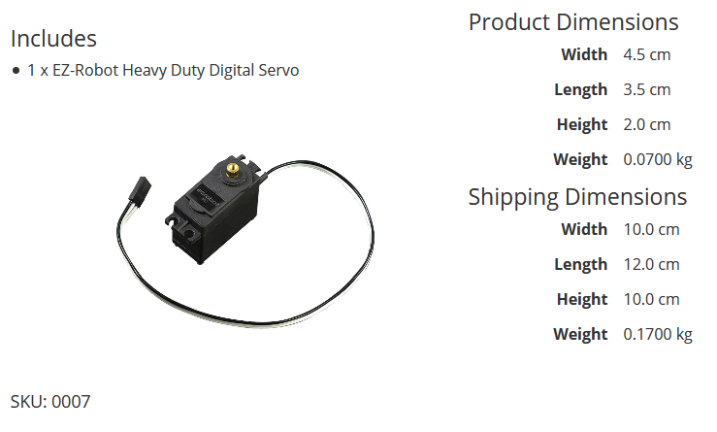
imagenes/Anexos/Ez robot servo 0007.png
