EduardoSBarreraR/Trabajo_Terminal_2/imagenes/Anexos/Flanged Bearing.png

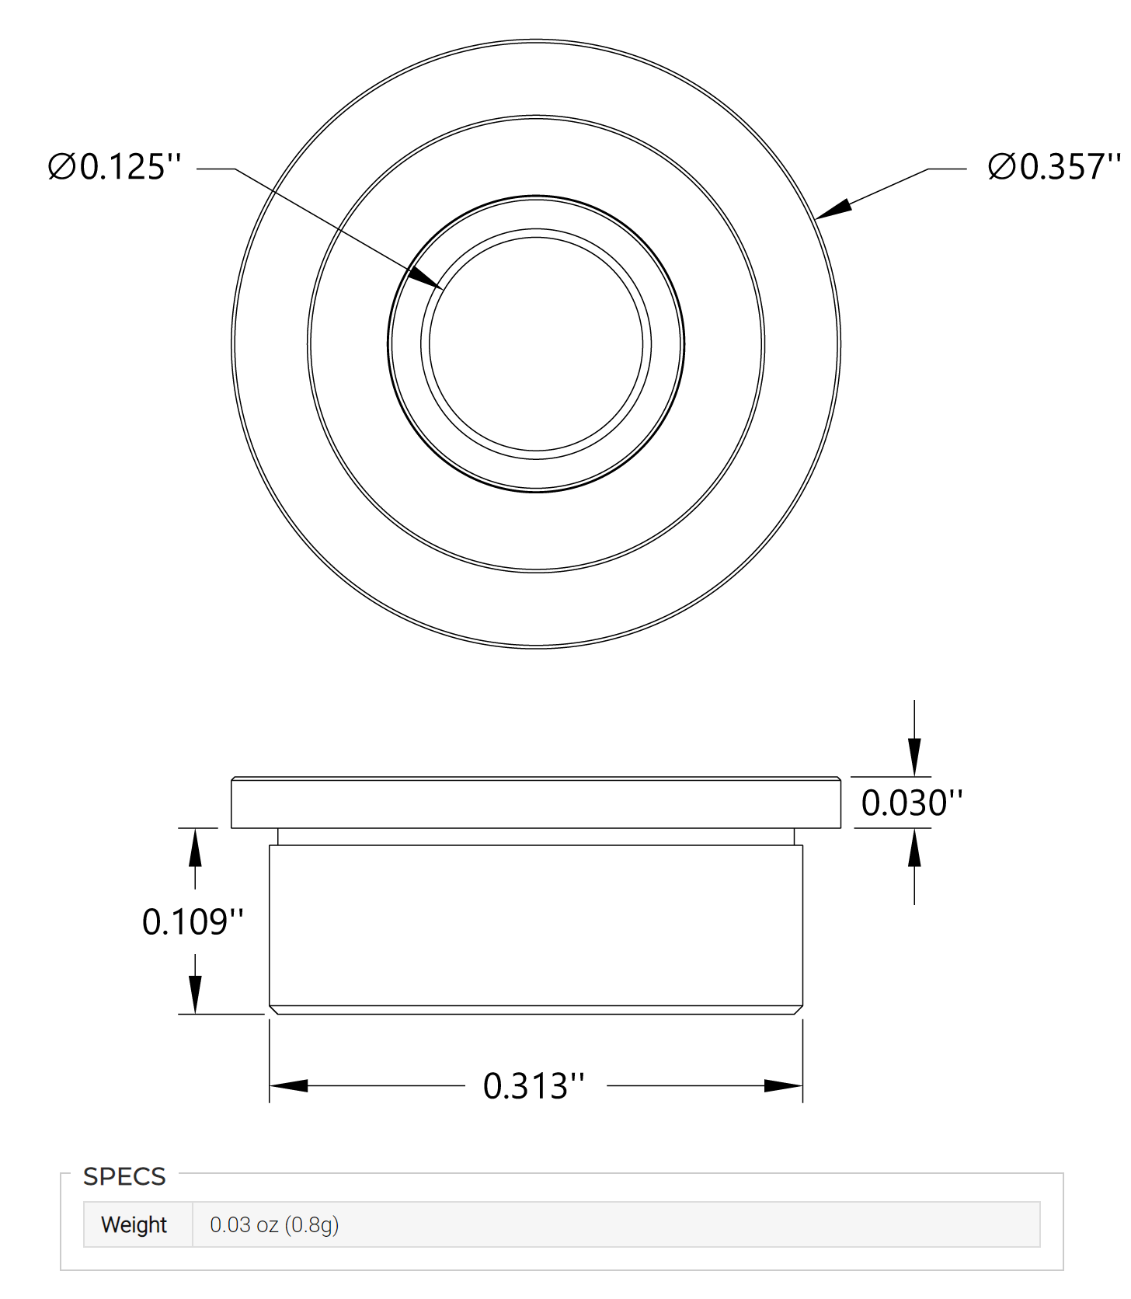
imagenes/Anexos/Flanged Bearing.png
