EduardoSBarreraR/Trabajo_Terminal_2/imagenes/Anexos/Polea Motor 15D Eje.png

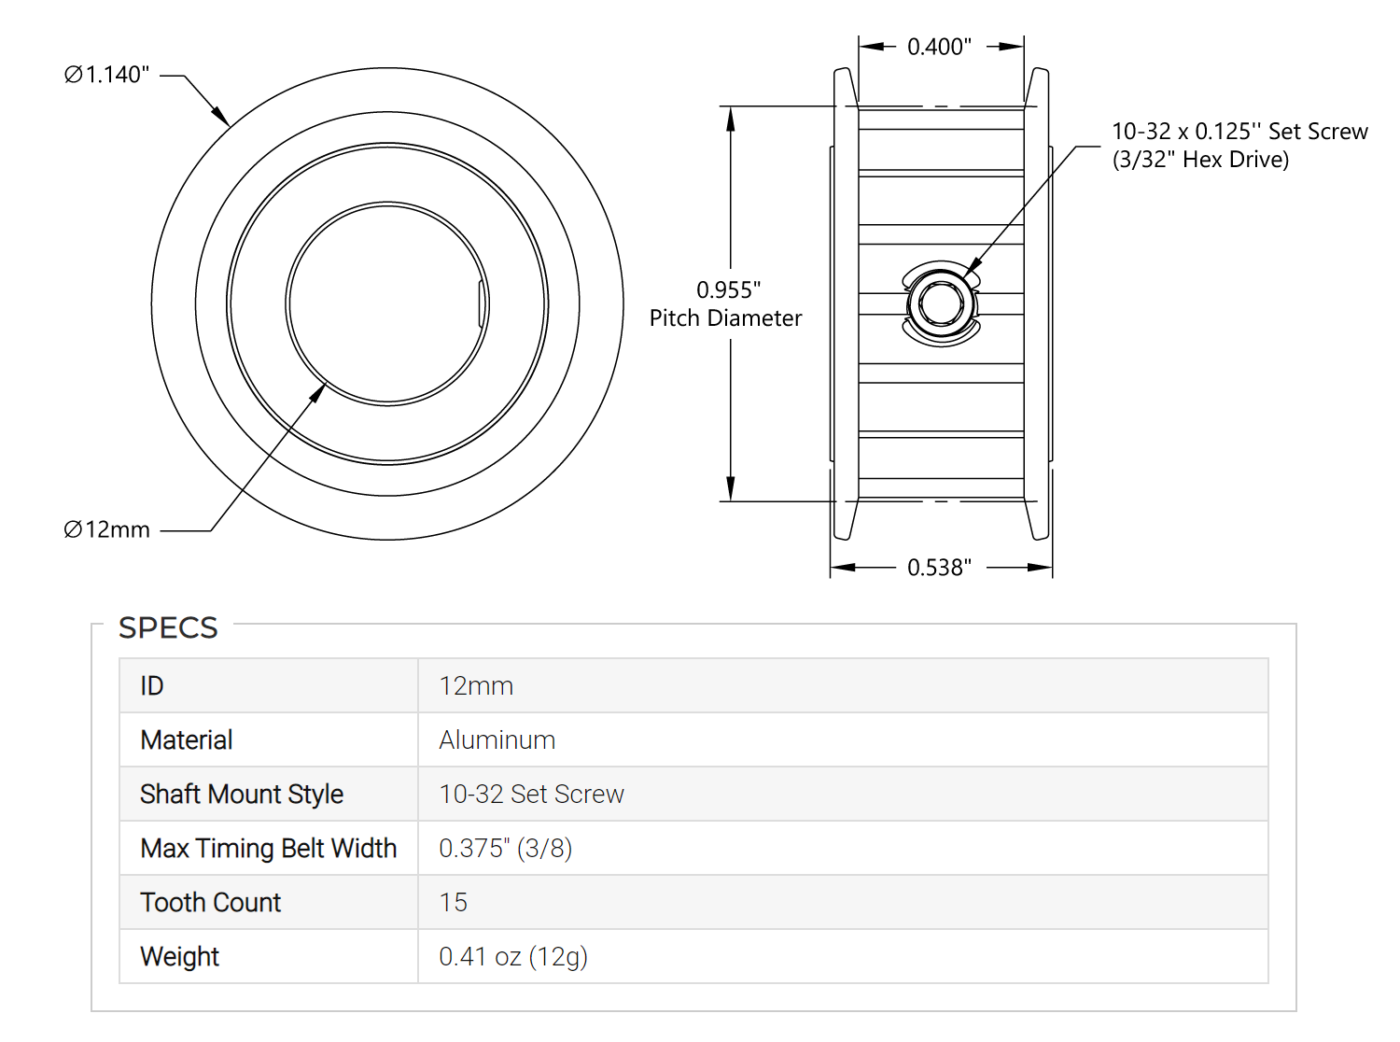
imagenes/Anexos/Polea Motor 15D Eje.png
