EduardoSBarreraR/Trabajo_Terminal_2/imagenes/Anexos/Polea Motor 15D Motor.png

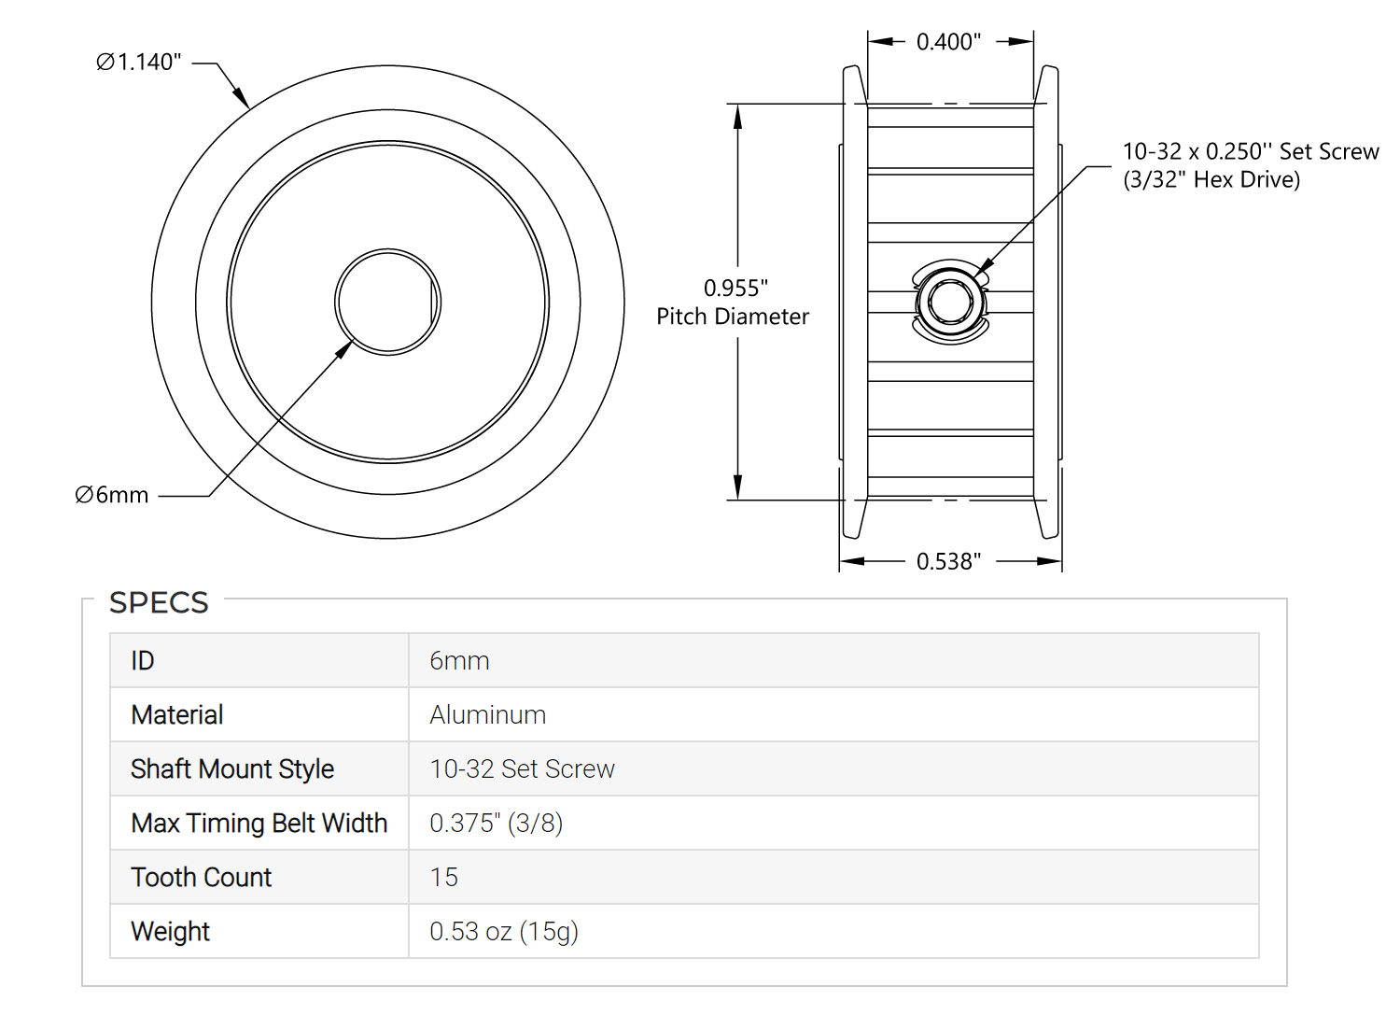
imagenes/Anexos/Polea Motor 15D Motor.png
