EduardoSBarreraR/Trabajo_Terminal_2/imagenes/Anexos/Polea Motor 15D.png

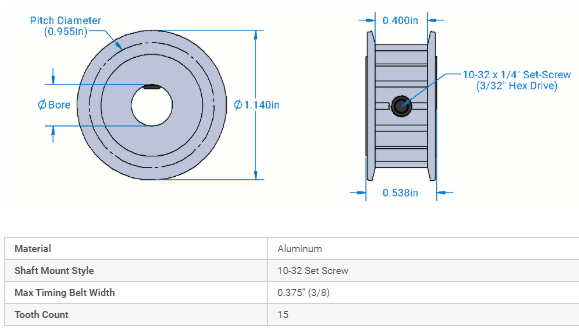
imagenes/Anexos/Polea Motor 15D.png
