EduardoSBarreraR/Trabajo_Terminal_2/imagenes/asdfghjk.png

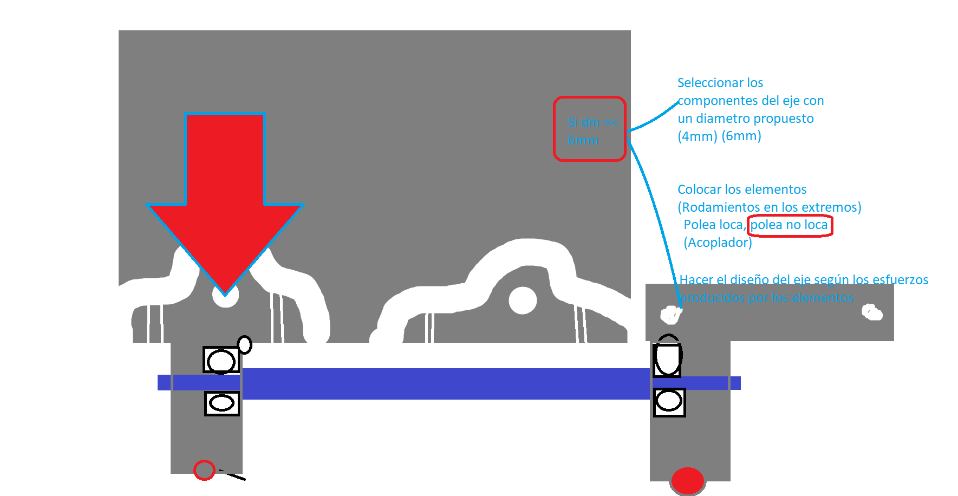
imagenes/asdfghjk.png
