EduardoSBarreraR/Trabajo_Terminal_2/imagenes/Asignación de longitudes de brazo/Vista lateral con brazo.png

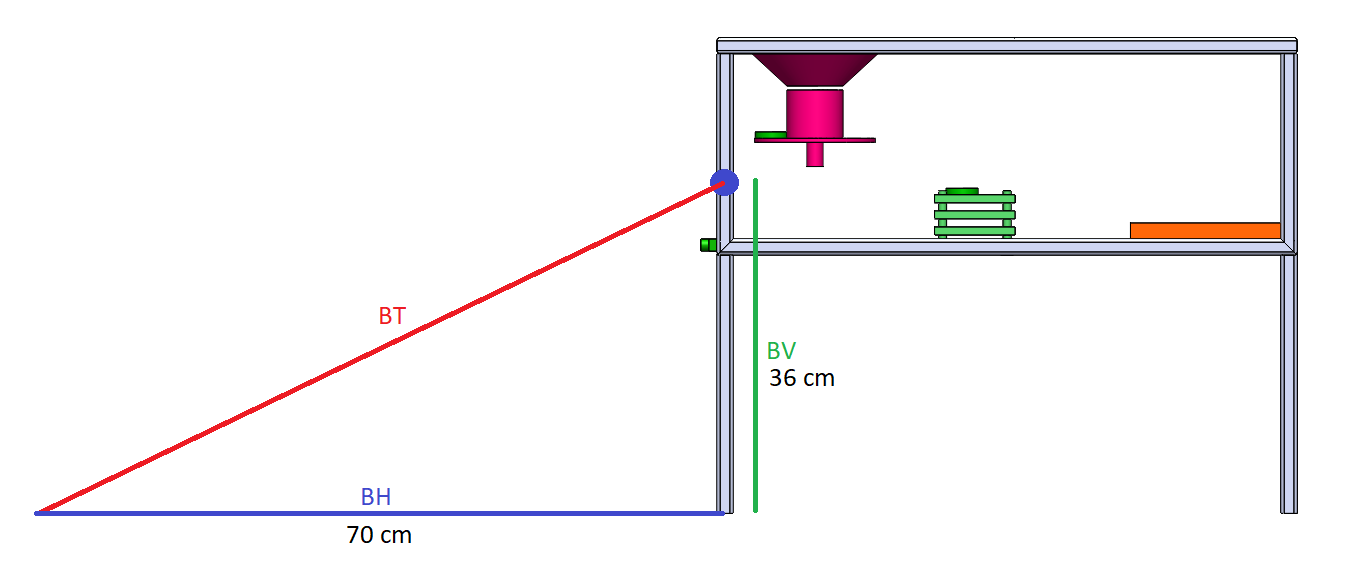
imagenes/Asignación de longitudes de brazo/Vista lateral con brazo.png
