EduardoSBarreraR/Trabajo_Terminal_2/imagenes/Asignación de longitudes de brazo/Vista lateral sin brazo.png

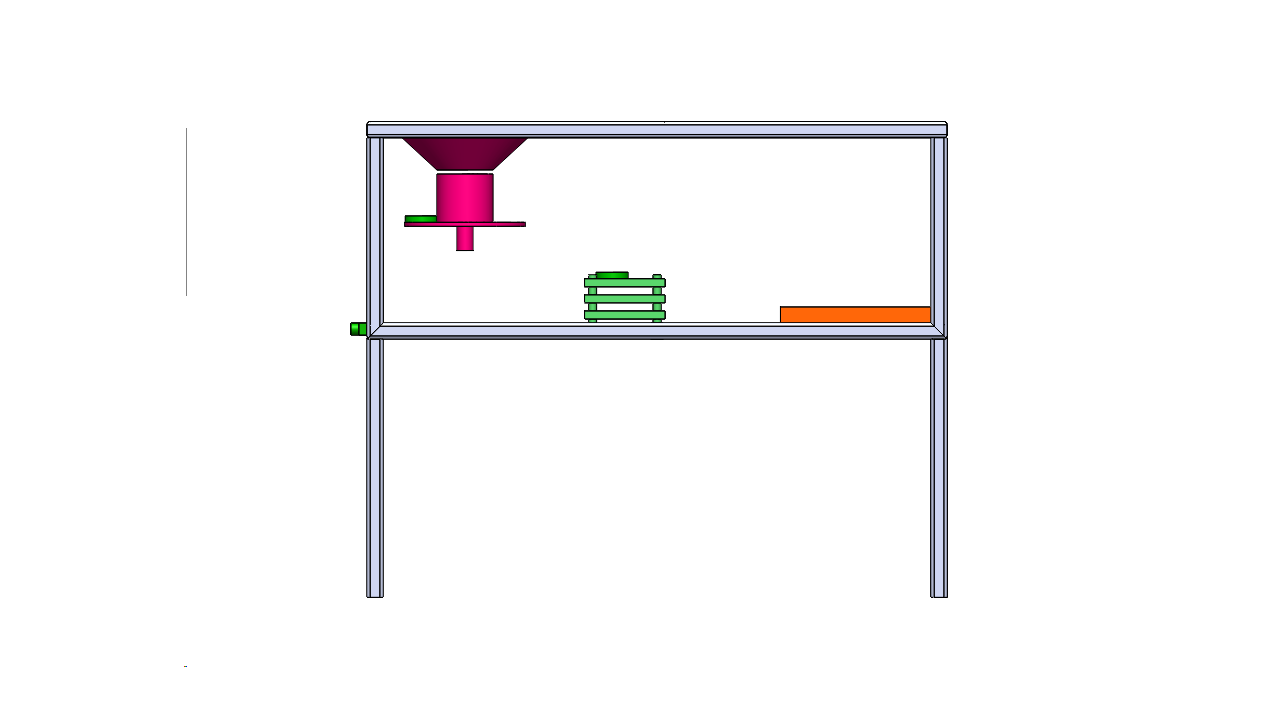
imagenes/Asignación de longitudes de brazo/Vista lateral sin brazo.png
