EduardoSBarreraR/Trabajo_Terminal_2/imagenes/Balonxd.PNG

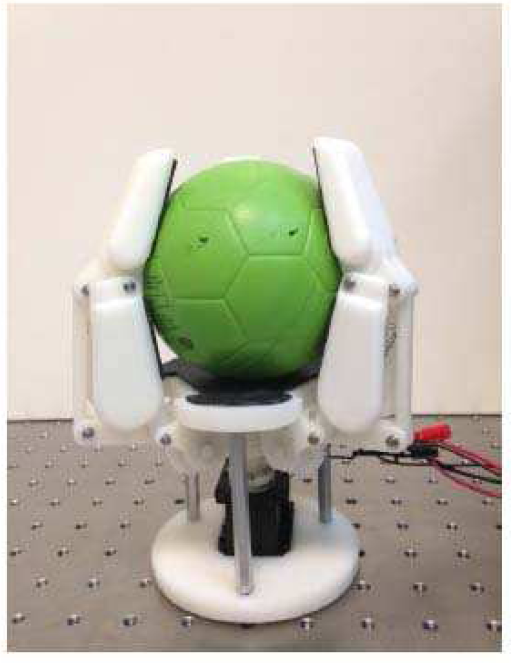
imagenes/Balonxd.PNG
