EduardoSBarreraR/Trabajo_Terminal_2/imagenes/Conceptos/Concepto1Trans.png

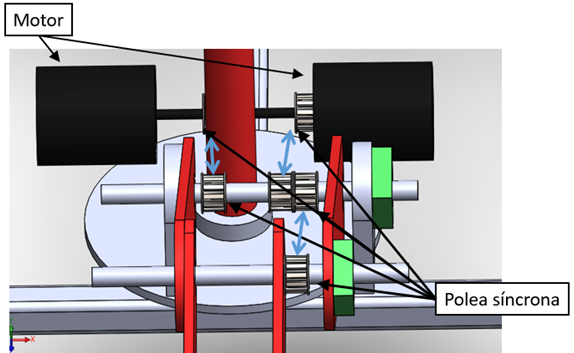
imagenes/Conceptos/Concepto1Trans.png
