EduardoSBarreraR/Trabajo_Terminal_2/imagenes/Conceptos/Concepto 1 con etiquetas.png

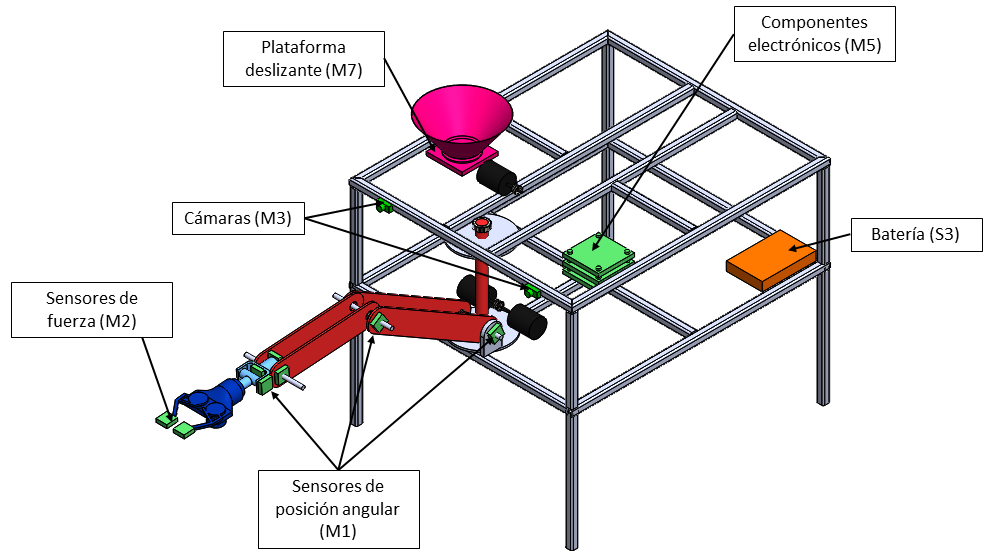
imagenes/Conceptos/Concepto 1 con etiquetas.png
