EduardoSBarreraR/Trabajo_Terminal_2/imagenes/Conceptos/Concepto 2 con etiquetas.jpg

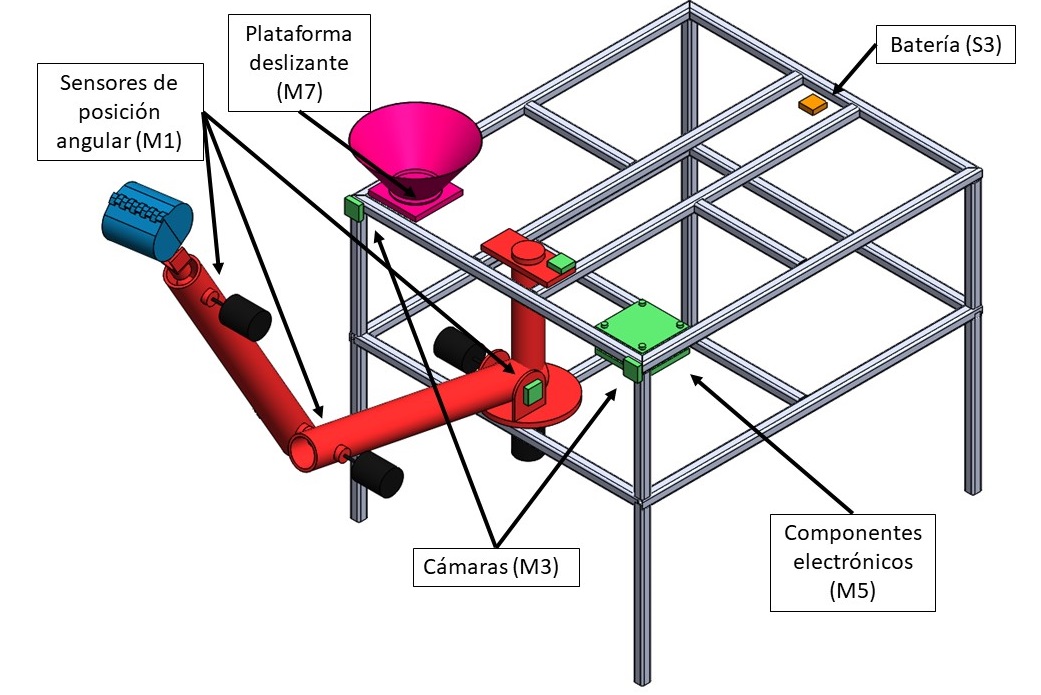
imagenes/Conceptos/Concepto 2 con etiquetas.jpg
