EduardoSBarreraR/Trabajo_Terminal_2/imagenes/Conceptos/Concepto 3 con etiquetas.jpg

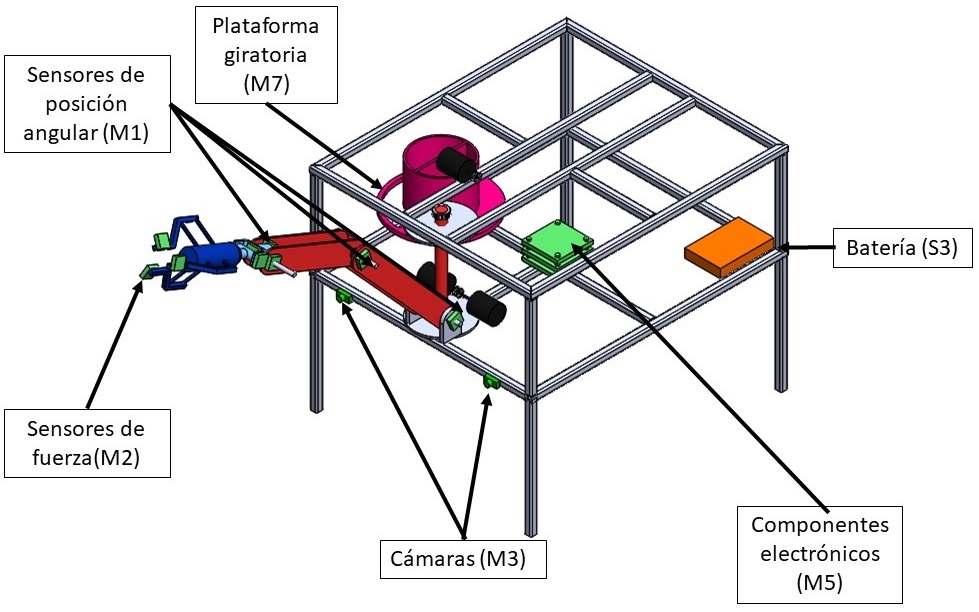
imagenes/Conceptos/Concepto 3 con etiquetas.jpg
