EduardoSBarreraR/Trabajo_Terminal_2/imagenes/Conceptos/Concepto 3 laboratorio.png

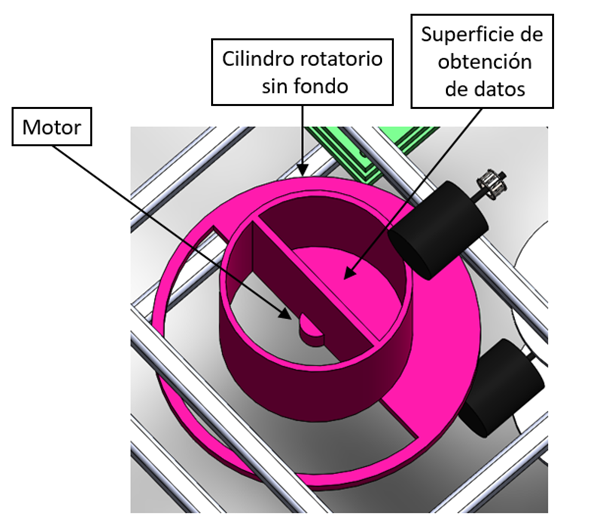
imagenes/Conceptos/Concepto 3 laboratorio.png
