EduardoSBarreraR/Trabajo_Terminal_2/imagenes/Conceptos/Concepto 4 base.png

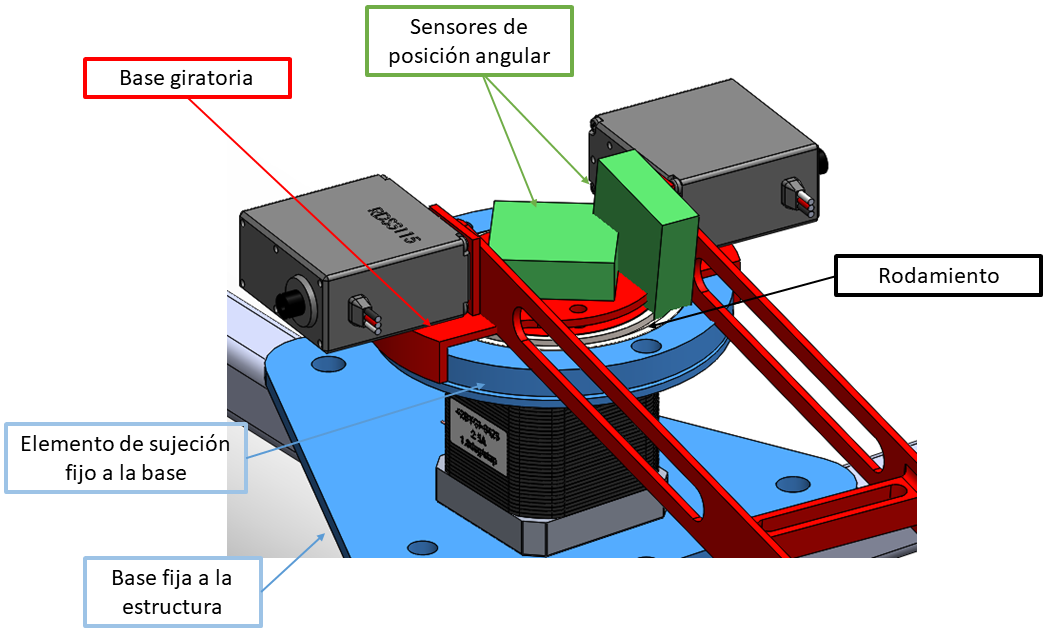
imagenes/Conceptos/Concepto 4 base.png
