EduardoSBarreraR/Trabajo_Terminal_2/imagenes/Conceptos/Concepto 4 con etiquetas.png

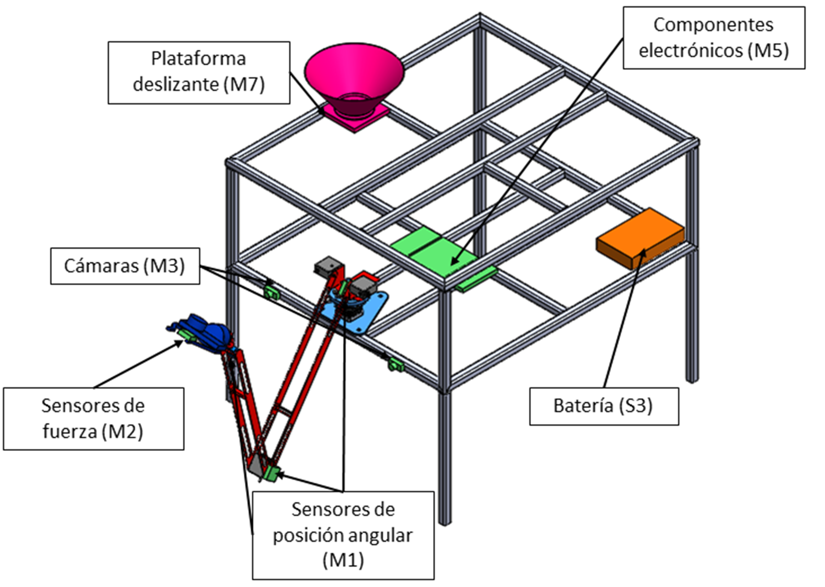
imagenes/Conceptos/Concepto 4 con etiquetas.png
