EduardoSBarreraR/Trabajo_Terminal_2/imagenes/Conceptos/Concepto 5 con etiquetas.png

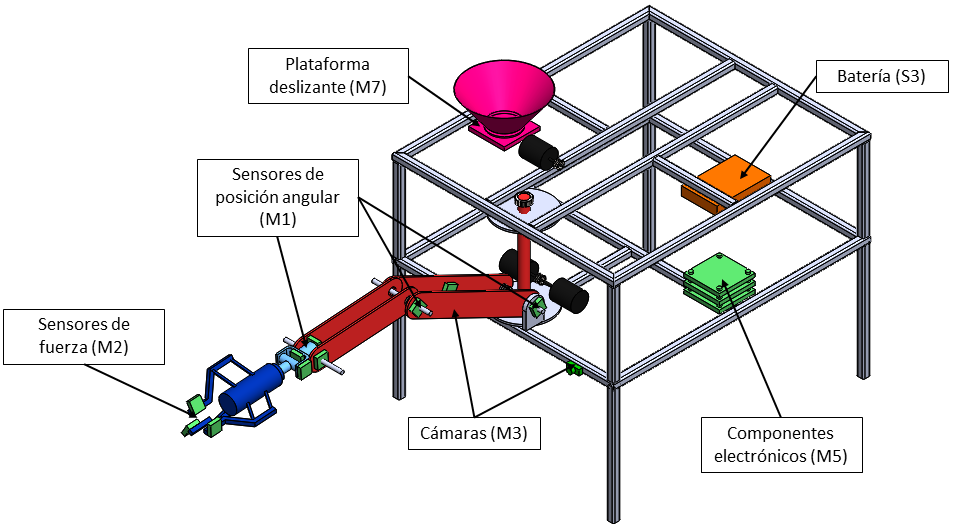
imagenes/Conceptos/Concepto 5 con etiquetas.png
