EduardoSBarreraR/Trabajo_Terminal_2/imagenes/Conceptos/Concepto 6 con etiquetas.png

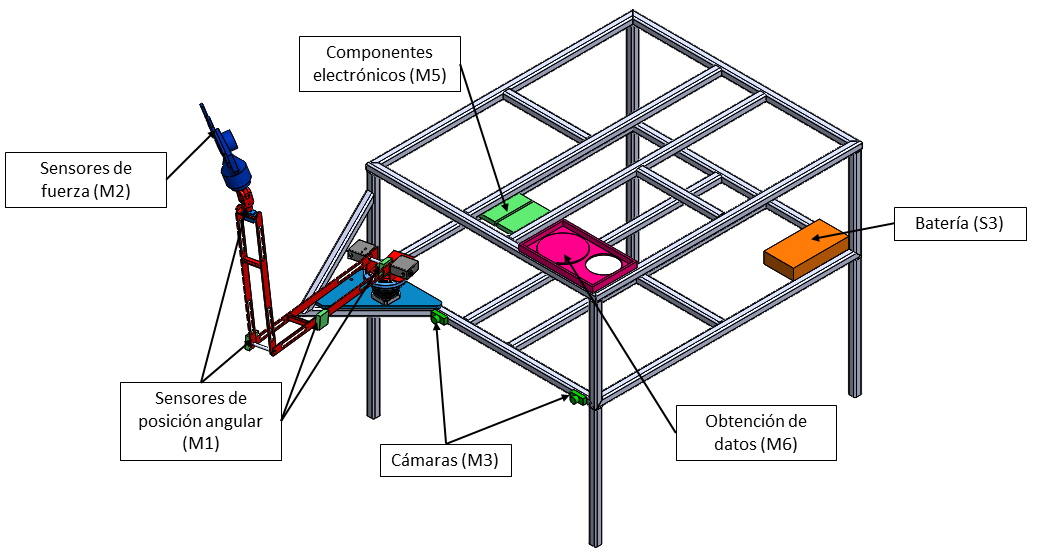
imagenes/Conceptos/Concepto 6 con etiquetas.png
