EduardoSBarreraR/Trabajo_Terminal_2/imagenes/Conceptos/Concepto final.jpg

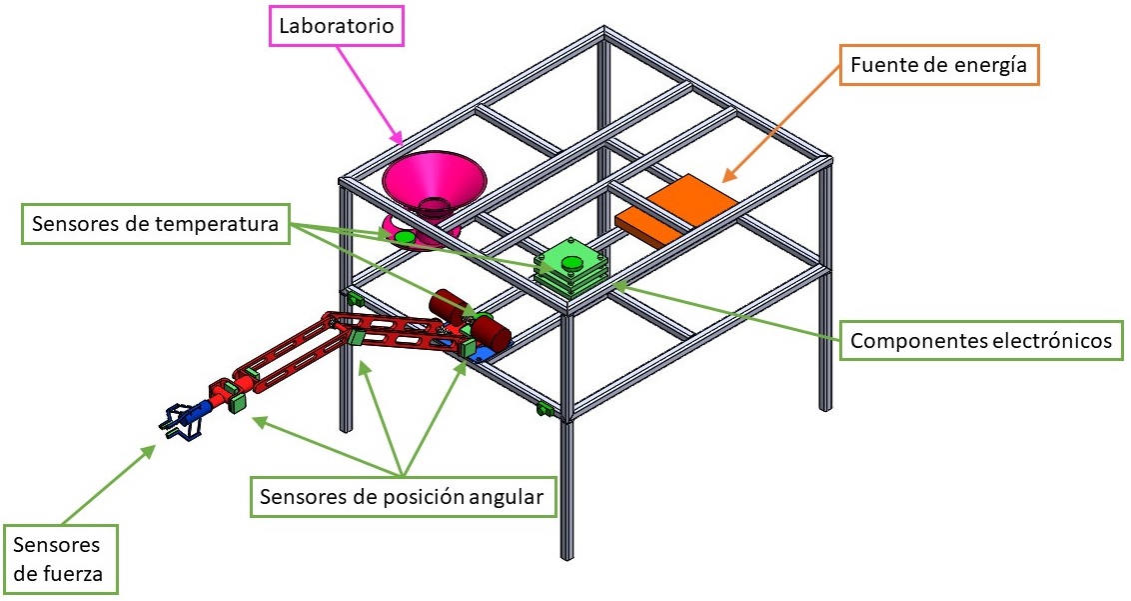
imagenes/Conceptos/Concepto final.jpg
