EduardoSBarreraR/Trabajo_Terminal_2/imagenes/DedoYEngranes.PNG

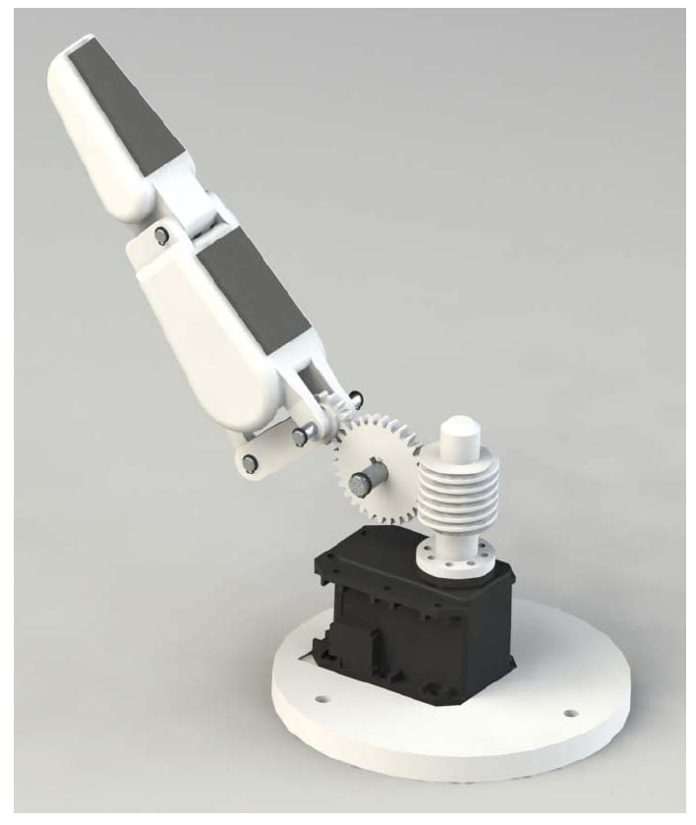
imagenes/DedoYEngranes.PNG
