EduardoSBarreraR/Trabajo_Terminal_2/imagenes/Dominio especifico/Comunicacion/FrontEnd.png

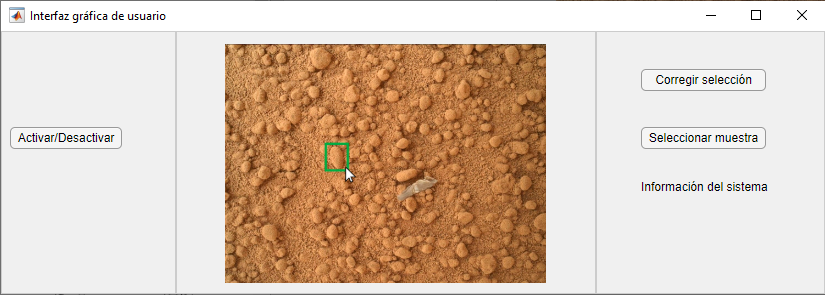
imagenes/Dominio especifico/Comunicacion/FrontEnd.png
