EduardoSBarreraR/Trabajo_Terminal_2/imagenes/Dominio especifico/DiagramaE1.jpg

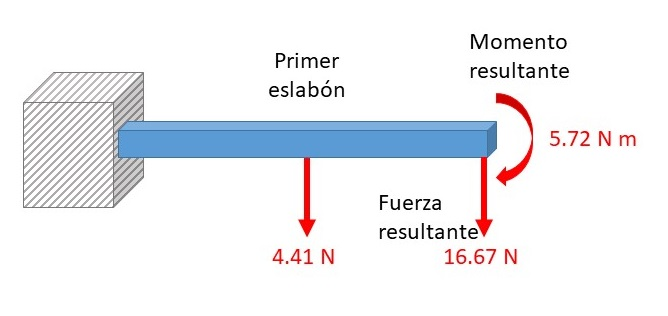
imagenes/Dominio especifico/DiagramaE1.jpg
