EduardoSBarreraR/Trabajo_Terminal_2/imagenes/Dominio especifico/DiagramaE2.jpg

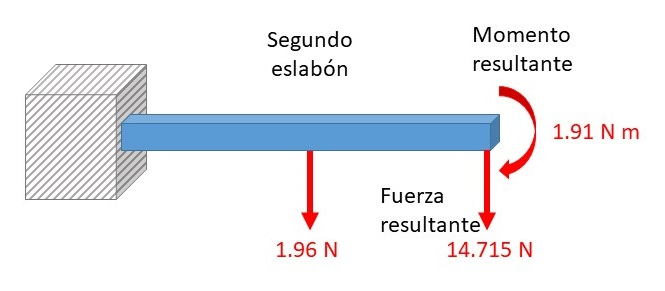
imagenes/Dominio especifico/DiagramaE2.jpg
