EduardoSBarreraR/Trabajo_Terminal_2/imagenes/Dominio especifico/DiagramaPesos.jpg

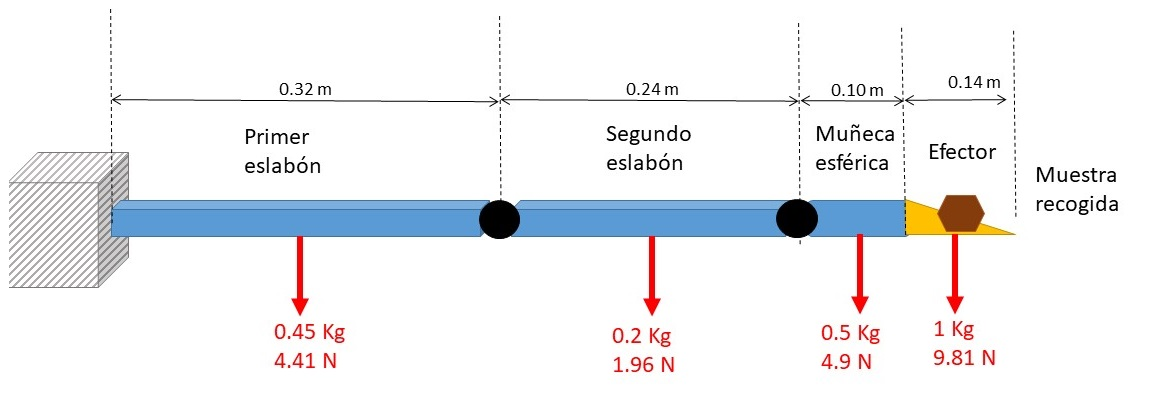
imagenes/Dominio especifico/DiagramaPesos.jpg
