EduardoSBarreraR/Trabajo_Terminal_2/imagenes/Dominio especifico/Efector/Efector lateral.PNG

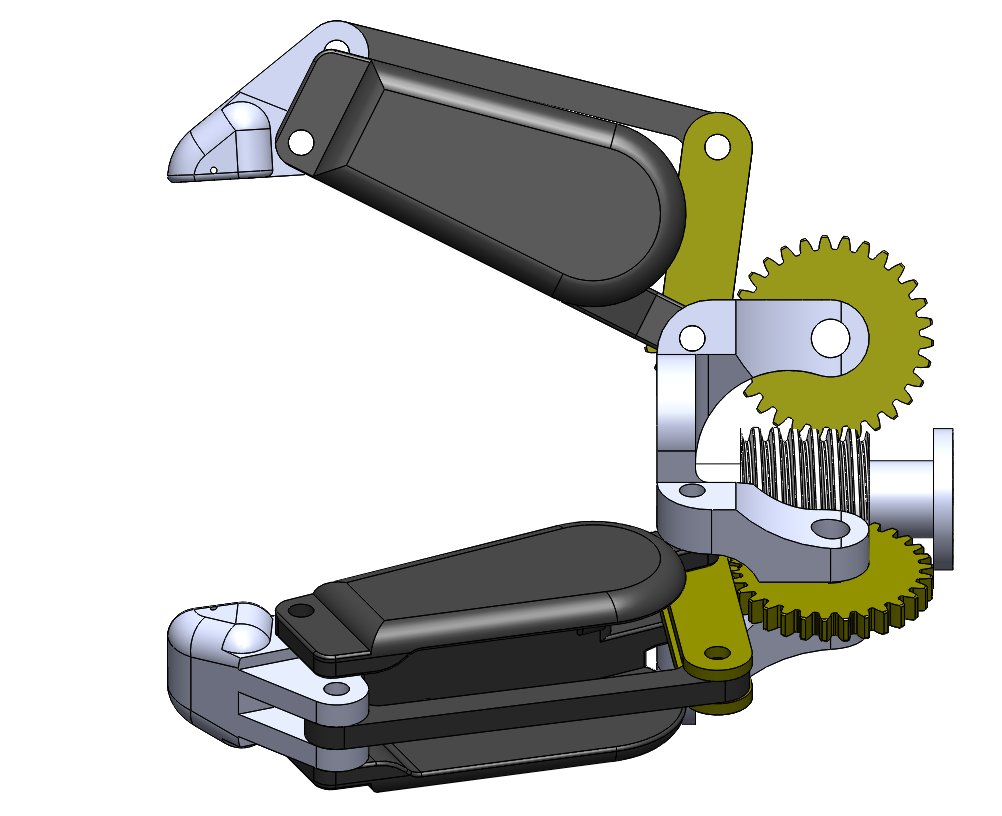
imagenes/Dominio especifico/Efector/Efector lateral.PNG
