EduardoSBarreraR/Trabajo_Terminal_2/imagenes/Dominio especifico/Efector/Efector superior - copia.PNG

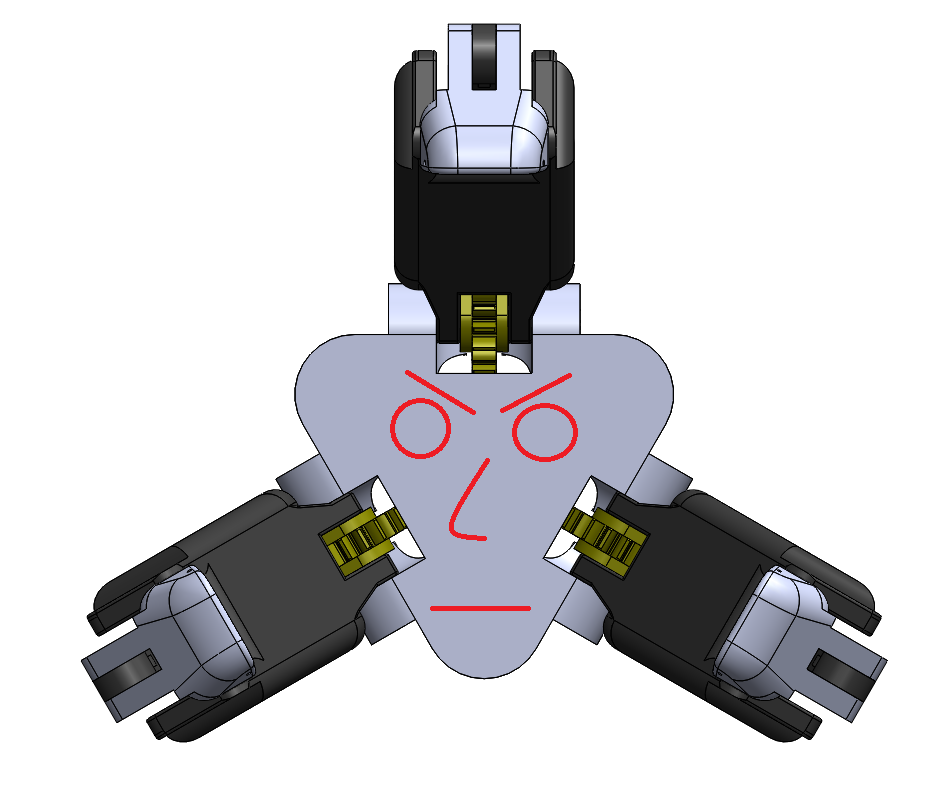
imagenes/Dominio especifico/Efector/Efector superior - copia.PNG
