EduardoSBarreraR/Trabajo_Terminal_2/imagenes/Dominio especifico/Efector/EfectorConActuador.png

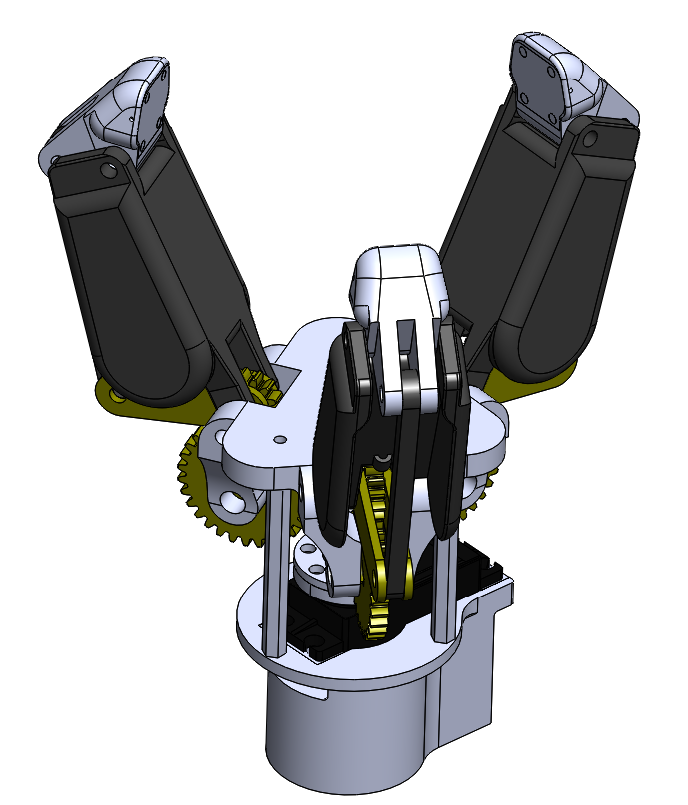
imagenes/Dominio especifico/Efector/EfectorConActuador.png
