EduardoSBarreraR/Trabajo_Terminal_2/imagenes/Dominio especifico/Efector/EfectorConActuadorEXP.png

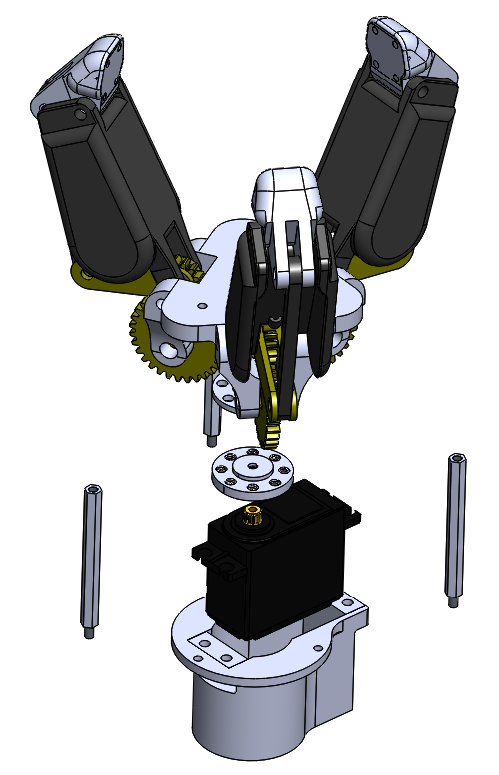
imagenes/Dominio especifico/Efector/EfectorConActuadorEXP.png
