EduardoSBarreraR/Trabajo_Terminal_2/imagenes/Dominio especifico/Efector/Modificado1.png

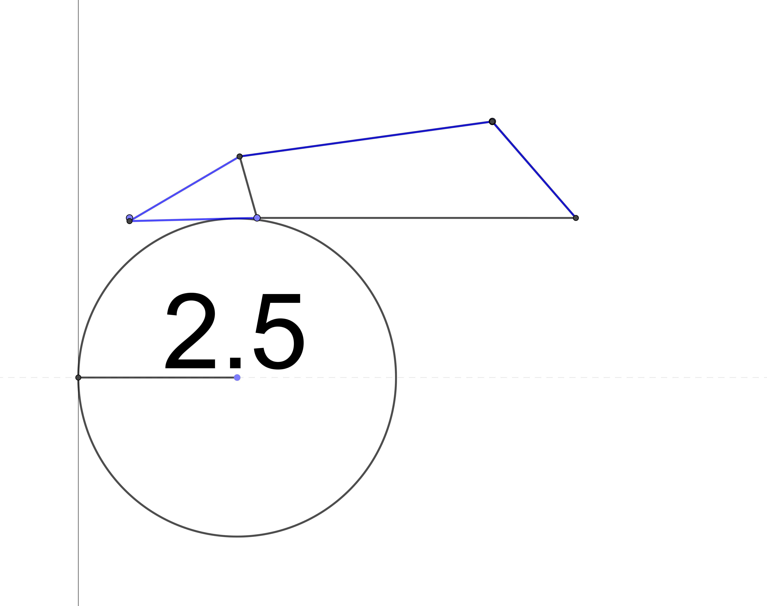
imagenes/Dominio especifico/Efector/Modificado1.png
