EduardoSBarreraR/Trabajo_Terminal_2/imagenes/Dominio especifico/Efector/Modificado2.png

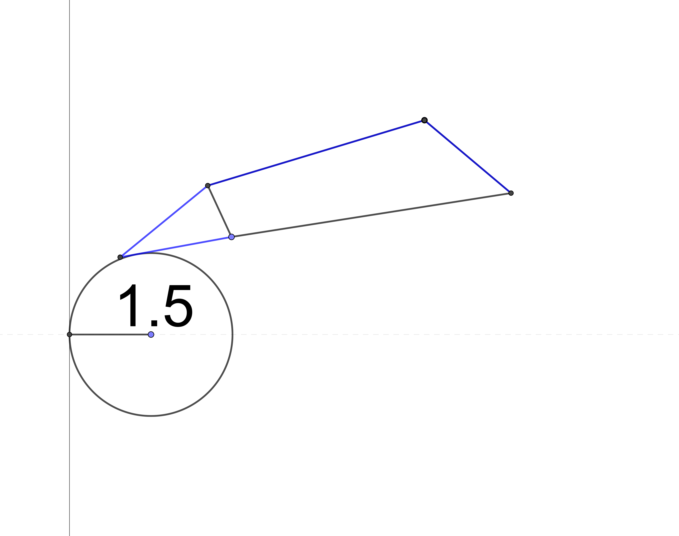
imagenes/Dominio especifico/Efector/Modificado2.png
