EduardoSBarreraR/Trabajo_Terminal_2/imagenes/Dominio especifico/Efector/Modificado3.png

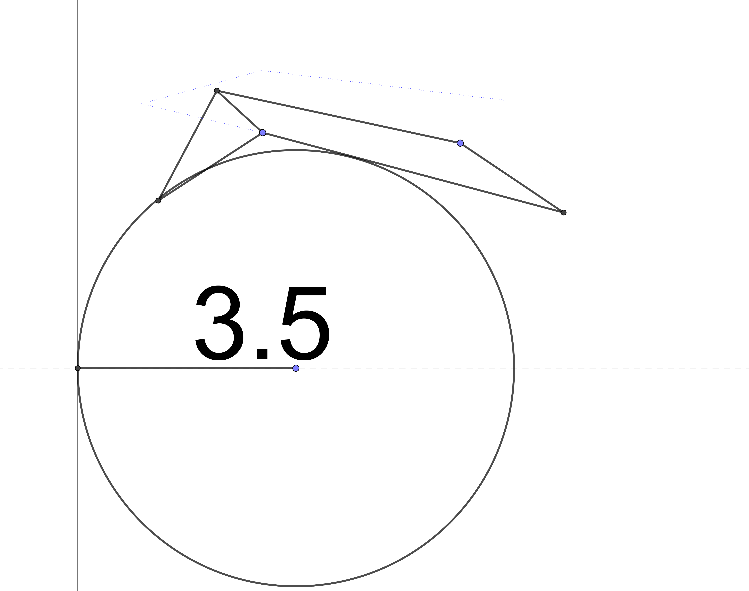
imagenes/Dominio especifico/Efector/Modificado3.png
