EduardoSBarreraR/Trabajo_Terminal_2/imagenes/Dominio especifico/Estructura/Estructura.png

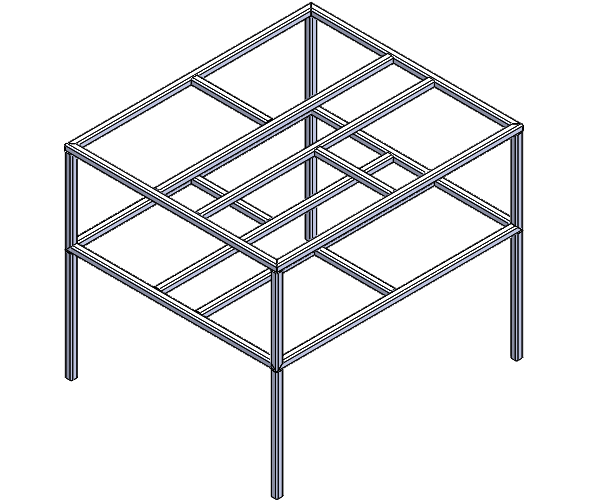
imagenes/Dominio especifico/Estructura/Estructura.png
