EduardoSBarreraR/Trabajo_Terminal_2/imagenes/Dominio especifico/Estructura/Estructura_modificadaxd.png

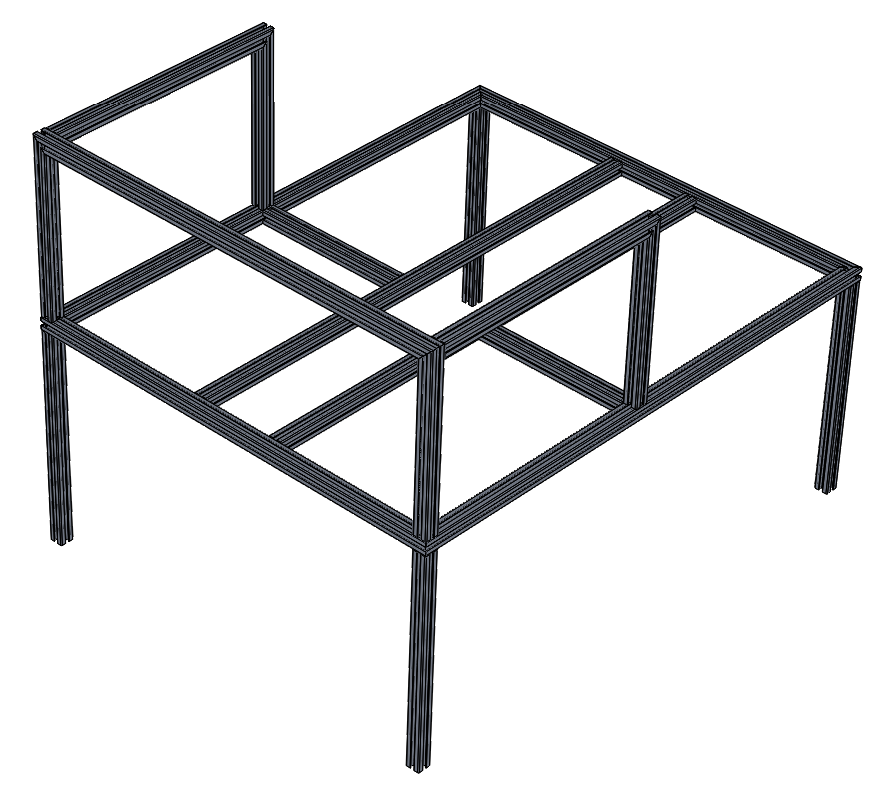
imagenes/Dominio especifico/Estructura/Estructura_modificadaxd.png
