EduardoSBarreraR/Trabajo_Terminal_2/imagenes/Dominio especifico/Laboratorio/Cono.png

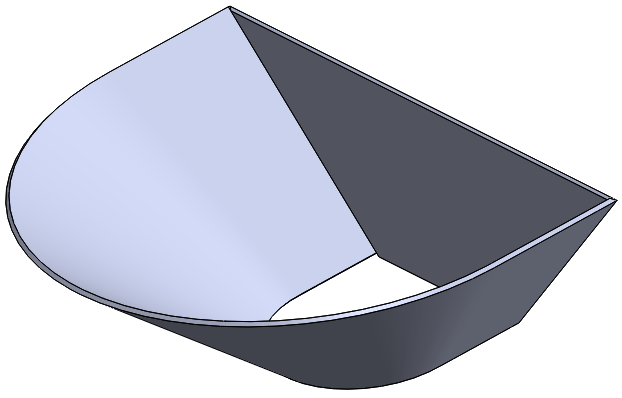
imagenes/Dominio especifico/Laboratorio/Cono.png
