EduardoSBarreraR/Trabajo_Terminal_2/imagenes/Dominio especifico/Laboratorio/Lab_Impacto.png

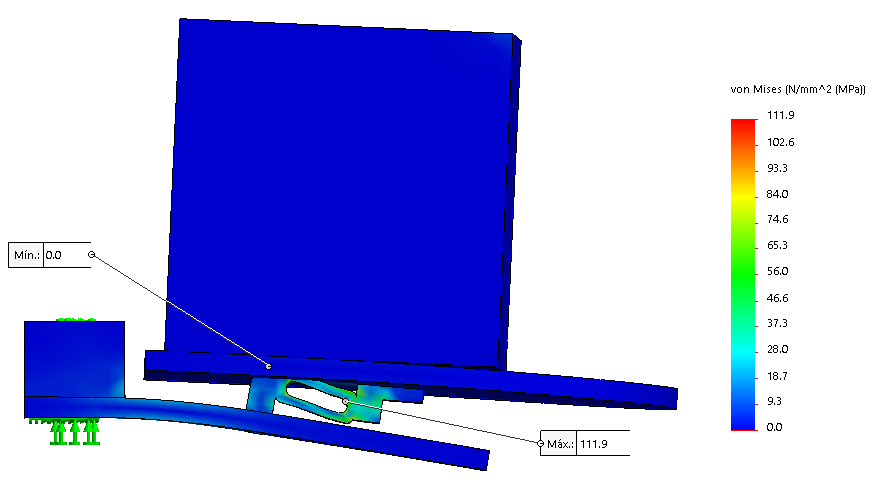
imagenes/Dominio especifico/Laboratorio/Lab_Impacto.png
