EduardoSBarreraR/Trabajo_Terminal_2/imagenes/Dominio especifico/Laboratorio/Laboratorio_Explosiona2.png

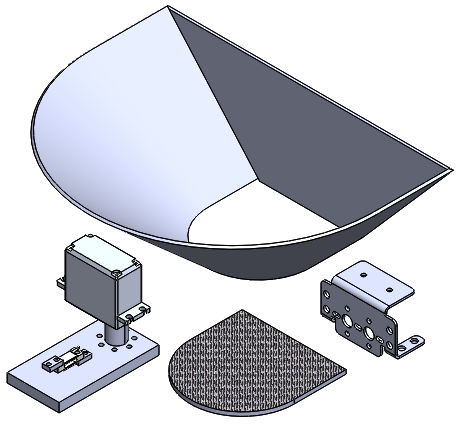
imagenes/Dominio especifico/Laboratorio/Laboratorio_Explosiona2.png
