EduardoSBarreraR/Trabajo_Terminal_2/imagenes/Dominio especifico/Laboratorio/Laboratorio_Explosionado.png

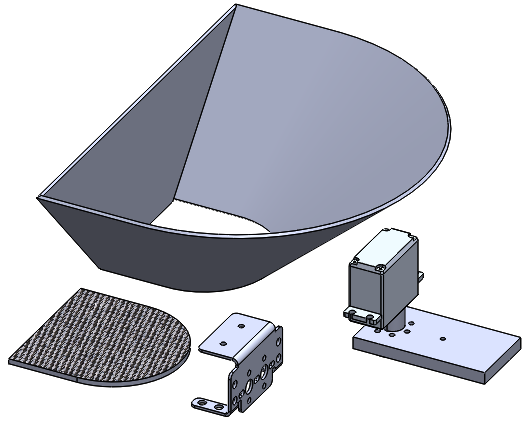
imagenes/Dominio especifico/Laboratorio/Laboratorio_Explosionado.png
