EduardoSBarreraR/Trabajo_Terminal_2/imagenes/Dominio especifico/Laboratorio/Laboratorio_Isometrico.png

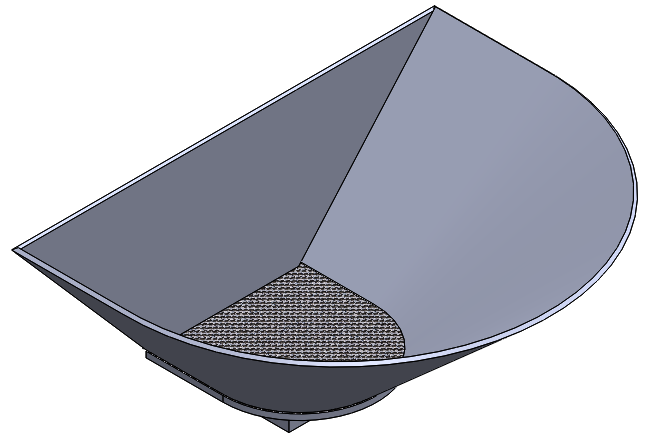
imagenes/Dominio especifico/Laboratorio/Laboratorio_Isometrico.png
