EduardoSBarreraR/Trabajo_Terminal_2/imagenes/Dominio especifico/Laboratorio/Laboratorio_Isometrico_Posterior.png

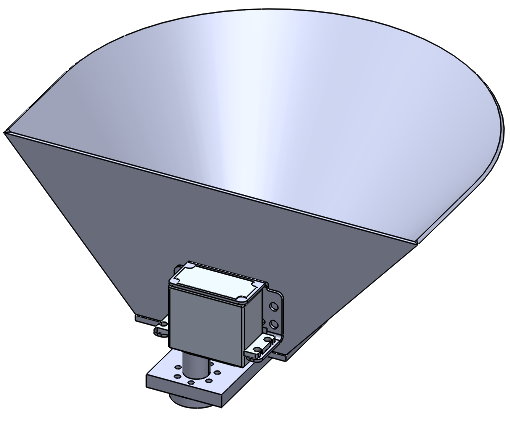
imagenes/Dominio especifico/Laboratorio/Laboratorio_Isometrico_Posterior.png
