EduardoSBarreraR/Trabajo_Terminal_2/imagenes/Dominio especifico/Laboratorio/LaboratorioLateral2.png

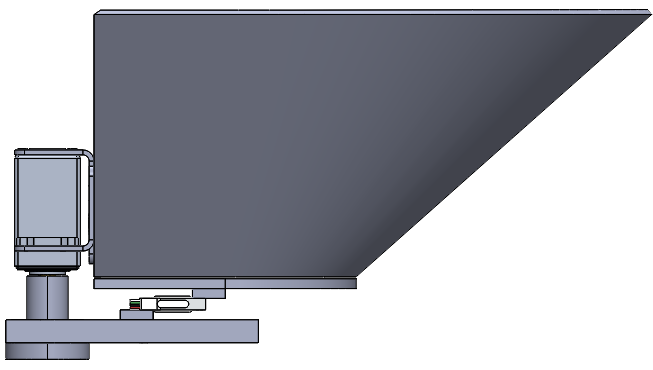
imagenes/Dominio especifico/Laboratorio/LaboratorioLateral2.png
