EduardoSBarreraR/Trabajo_Terminal_2/imagenes/Dominio especifico/Laboratorio/LaboratorioLateral.png

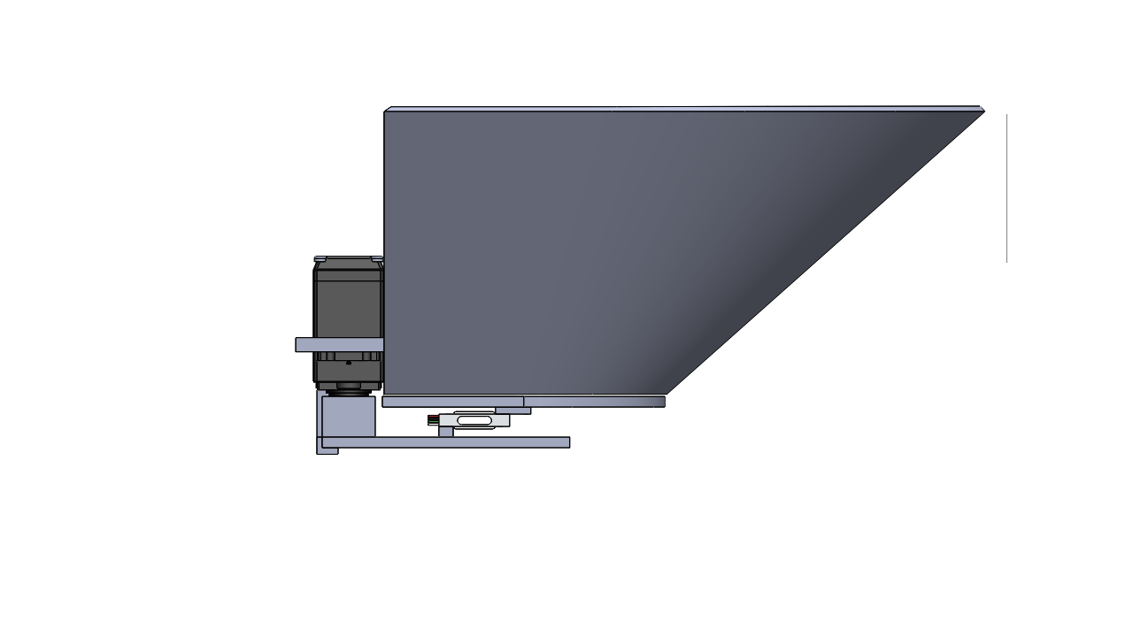
imagenes/Dominio especifico/Laboratorio/LaboratorioLateral.png
