EduardoSBarreraR/Trabajo_Terminal_2/imagenes/Dominio especifico/Laboratorio/SupMedicion.png

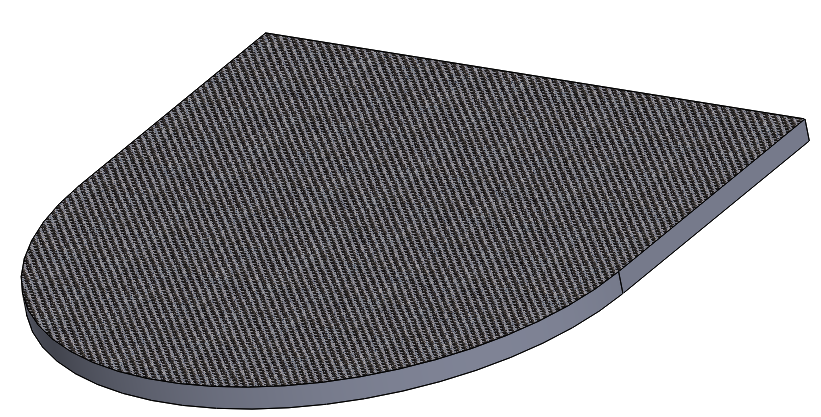
imagenes/Dominio especifico/Laboratorio/SupMedicion.png
