EduardoSBarreraR/Trabajo_Terminal_2/imagenes/Dominio especifico/Muneca/Mallado_validacion_C.png

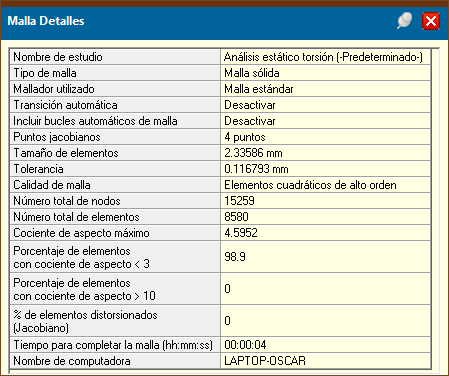
imagenes/Dominio especifico/Muneca/Mallado_validacion_C.png
