EduardoSBarreraR/Trabajo_Terminal_2/imagenes/Dominio especifico/Muneca/Muneca.png

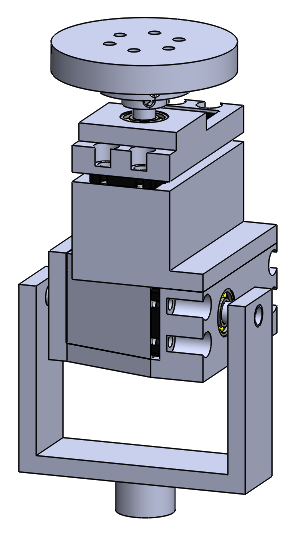
imagenes/Dominio especifico/Muneca/Muneca.png
