EduardoSBarreraR/Trabajo_Terminal_2/imagenes/Dominio especifico/Muneca/MunecaCompleta.png

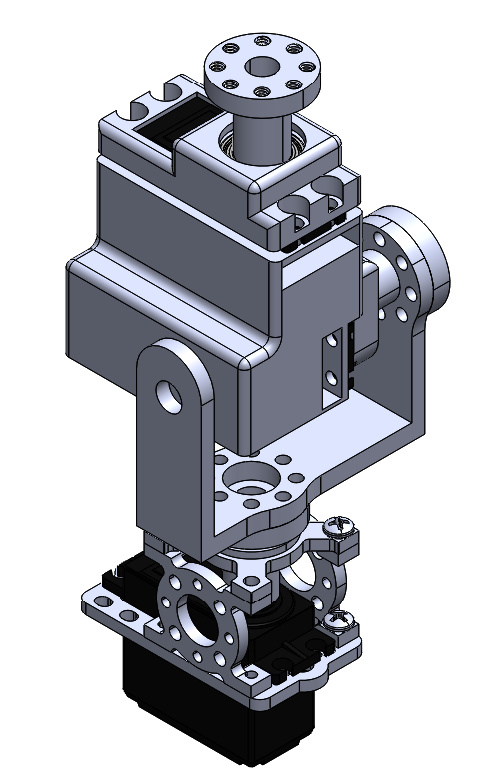
imagenes/Dominio especifico/Muneca/MunecaCompleta.png
