EduardoSBarreraR/Trabajo_Terminal_2/imagenes/Dominio especifico/Muneca/Primer motor.png

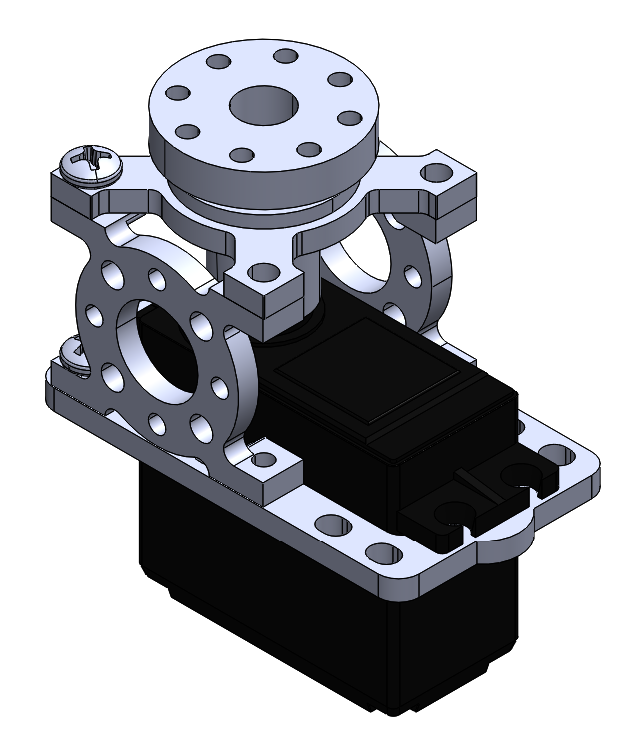
imagenes/Dominio especifico/Muneca/Primer motor.png
