EduardoSBarreraR/Trabajo_Terminal_2/imagenes/Dominio especifico/Muneca/Segundo y tercer motor EXP.png

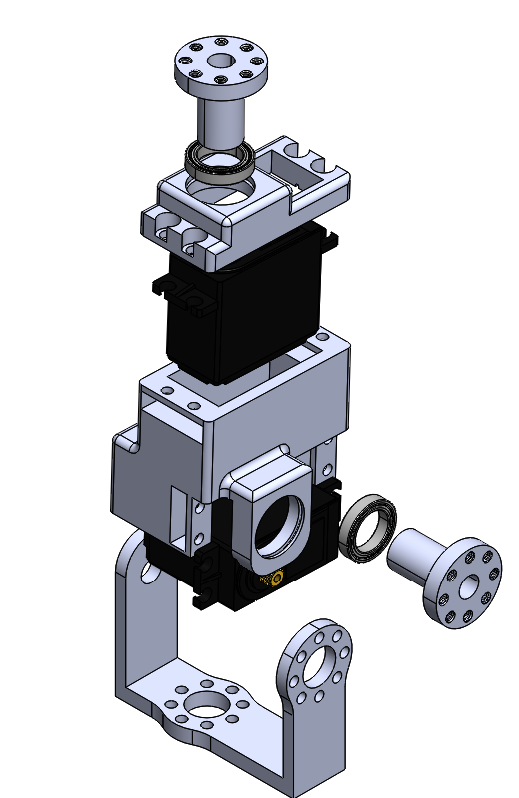
imagenes/Dominio especifico/Muneca/Segundo y tercer motor EXP.png
