EduardoSBarreraR/Trabajo_Terminal_2/imagenes/Dominio especifico/Muneca/Segundo y tercer motor.png

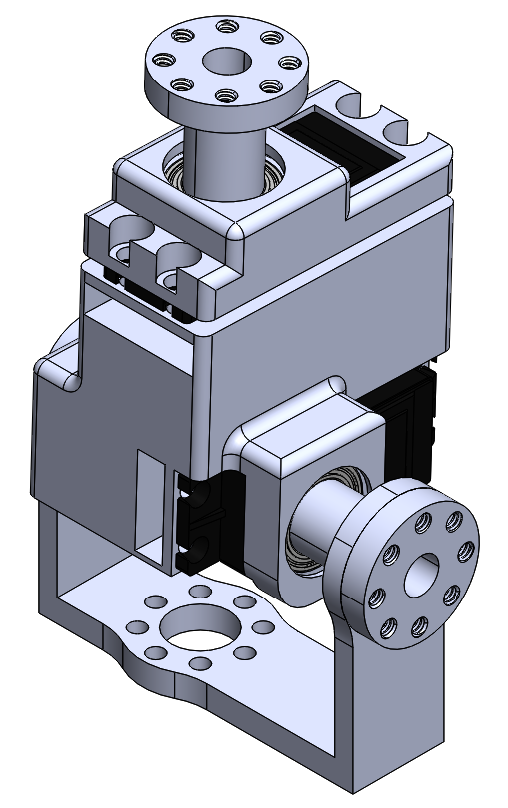
imagenes/Dominio especifico/Muneca/Segundo y tercer motor.png
