EduardoSBarreraR/Trabajo_Terminal_2/imagenes/Dominio especifico/Muneca/Validacion_C.png

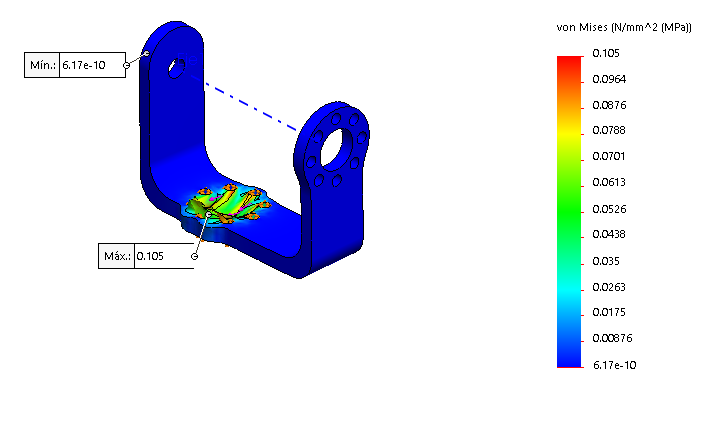
imagenes/Dominio especifico/Muneca/Validacion_C.png
