EduardoSBarreraR/Trabajo_Terminal_2/imagenes/Dominio especifico/Muneca/Validacion_C_2.png

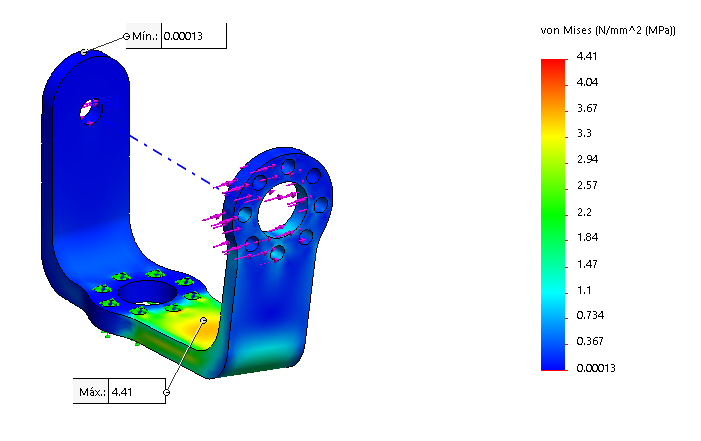
imagenes/Dominio especifico/Muneca/Validacion_C_2.png
