EduardoSBarreraR/Trabajo_Terminal_2/imagenes/Dominio especifico/Validaciones eslabones/DP1.jpg

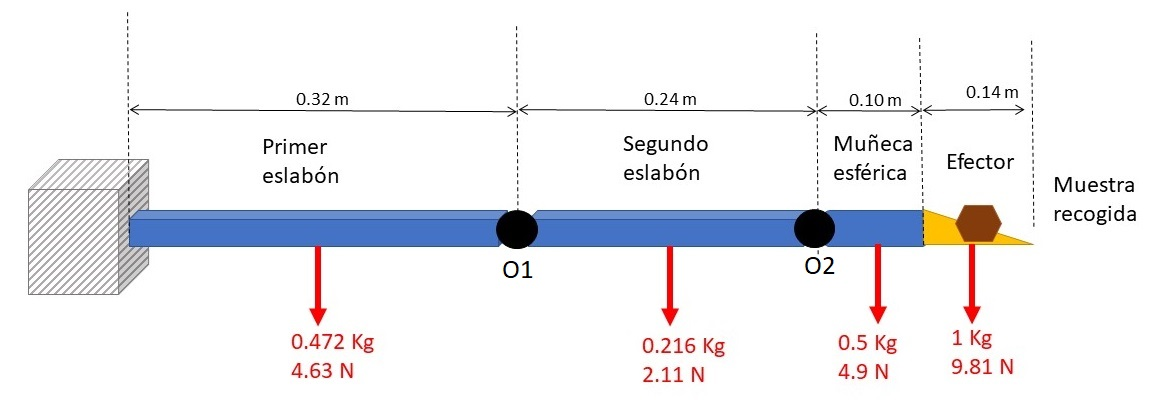
imagenes/Dominio especifico/Validaciones eslabones/DP1.jpg
