EduardoSBarreraR/Trabajo_Terminal_2/imagenes/Dominio especifico/Validaciones eslabones/DP2.jpg

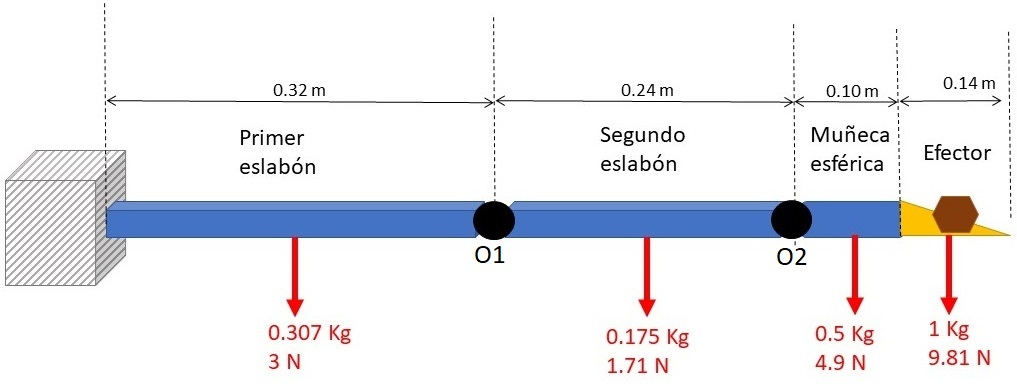
imagenes/Dominio especifico/Validaciones eslabones/DP2.jpg
