EduardoSBarreraR/Trabajo_Terminal_2/imagenes/Dominio especifico/Validaciones eslabones/DP2Mot.jpg

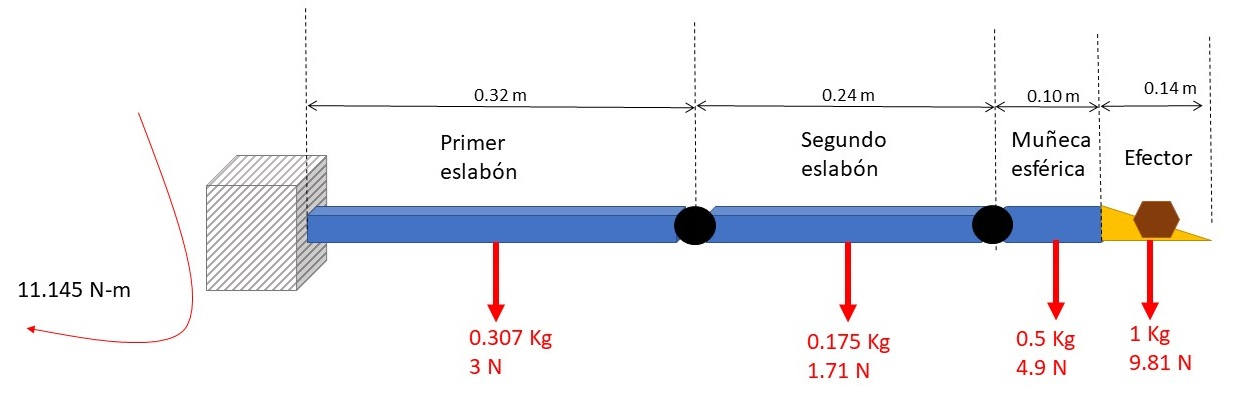
imagenes/Dominio especifico/Validaciones eslabones/DP2Mot.jpg
