EduardoSBarreraR/Trabajo_Terminal_2/imagenes/Dominio especifico/Validaciones eslabones/E22.jpg

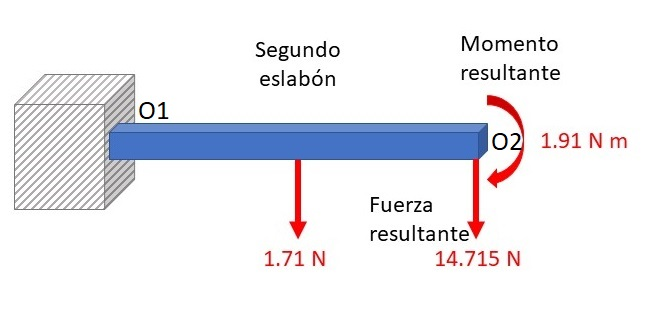
imagenes/Dominio especifico/Validaciones eslabones/E22.jpg
