EduardoSBarreraR/Trabajo_Terminal_2/imagenes/Dominio especifico/Validaciones eslabones/Eslabon_1_solido.jpg

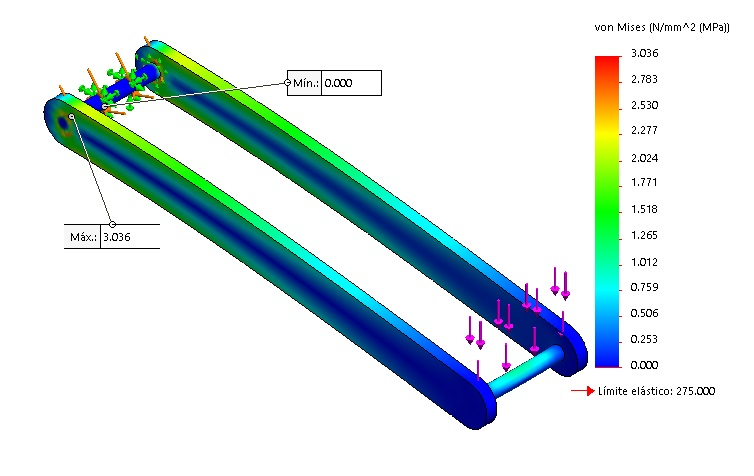
imagenes/Dominio especifico/Validaciones eslabones/Eslabon_1_solido.jpg
