EduardoSBarreraR/Trabajo_Terminal_2/imagenes/Dominio especifico/Validaciones eslabones/Eslabon_2_ranurado_desplazamientos.png

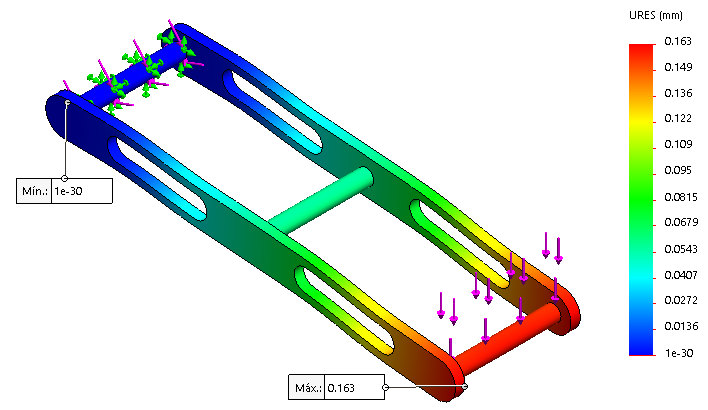
imagenes/Dominio especifico/Validaciones eslabones/Eslabon_2_ranurado_desplazamientos.png
