EduardoSBarreraR/Trabajo_Terminal_2/imagenes/Dominio especifico/Validaciones eslabones/Eslabon_2_solido.jpg

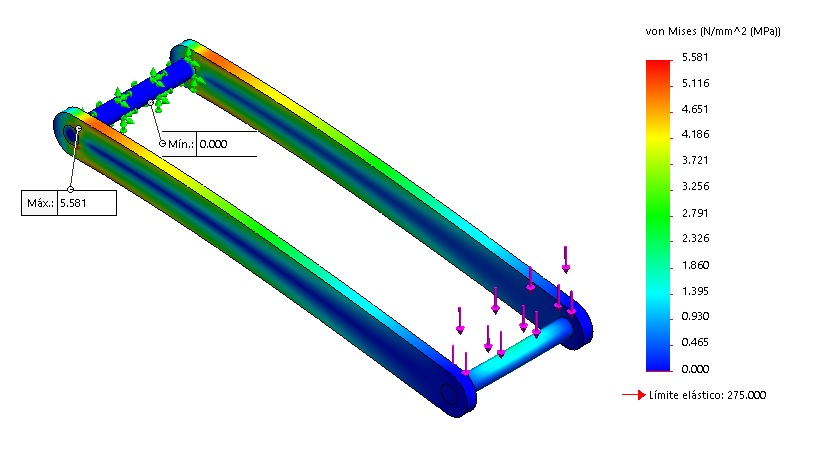
imagenes/Dominio especifico/Validaciones eslabones/Eslabon_2_solido.jpg
