EduardoSBarreraR/Trabajo_Terminal_2/imagenes/Dominio especifico/Validaciones eslabones/Eslabon_2_traves.png

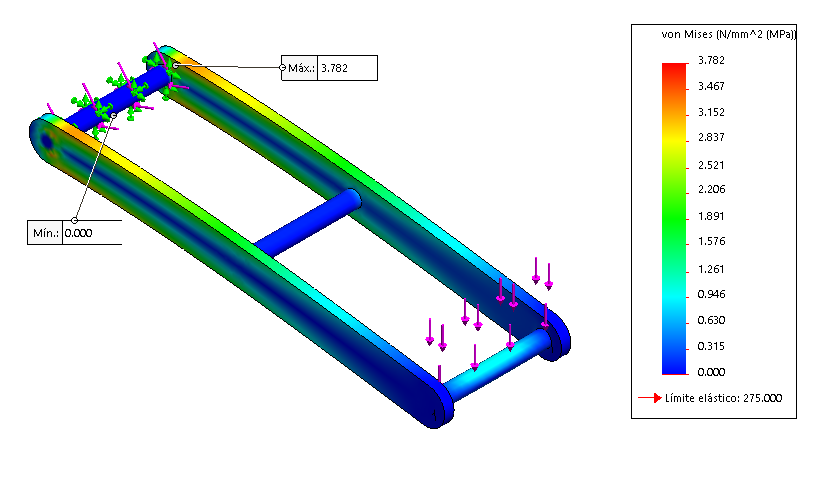
imagenes/Dominio especifico/Validaciones eslabones/Eslabon_2_traves.png
