EduardoSBarreraR/Trabajo_Terminal_2/imagenes/Dominio especifico/Validaciones eslabones/Mesa/BaseFija.png

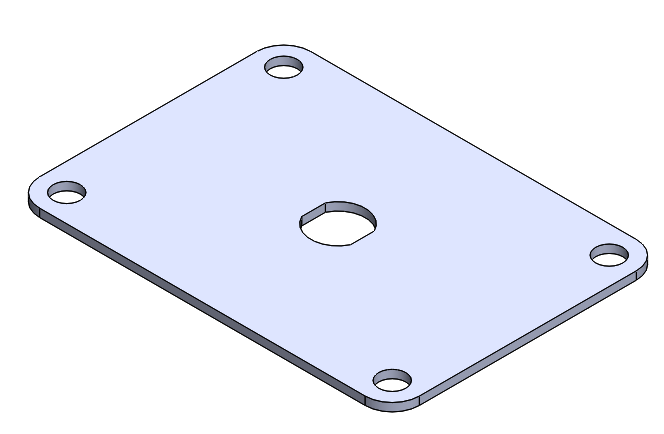
imagenes/Dominio especifico/Validaciones eslabones/Mesa/BaseFija.png
