EduardoSBarreraR/Trabajo_Terminal_2/imagenes/Dominio especifico/Validaciones eslabones/Mesa/CaderaVistaIsometrica.png

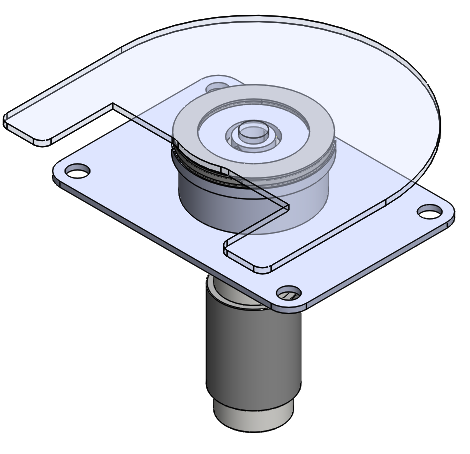
imagenes/Dominio especifico/Validaciones eslabones/Mesa/CaderaVistaIsometrica.png
