EduardoSBarreraR/Trabajo_Terminal_2/imagenes/Dominio especifico/Validaciones eslabones/Mesa/Cilindro-Base.png

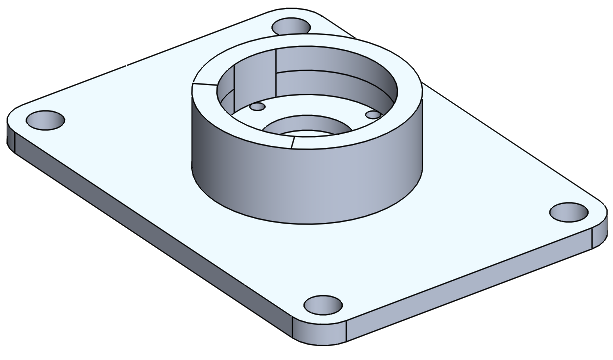
imagenes/Dominio especifico/Validaciones eslabones/Mesa/Cilindro-Base.png
