EduardoSBarreraR/Trabajo_Terminal_2/imagenes/Dominio especifico/Validaciones eslabones/Mesa/Cilindro-Base_Deformacion.png

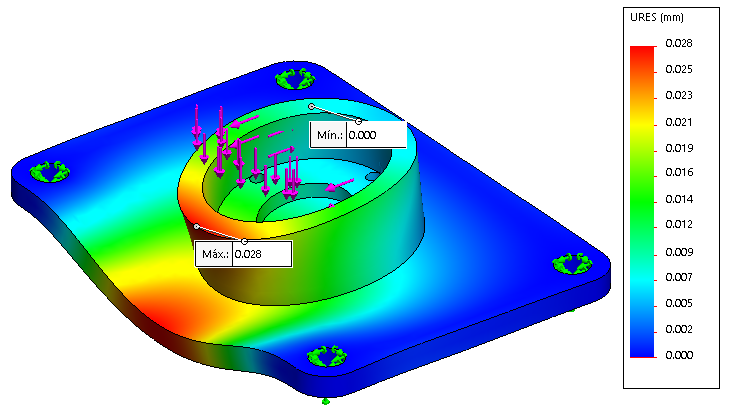
imagenes/Dominio especifico/Validaciones eslabones/Mesa/Cilindro-Base_Deformacion.png
