EduardoSBarreraR/Trabajo_Terminal_2/imagenes/Dominio especifico/Validaciones eslabones/Mesa/Cilindro-Base_Nodos.png

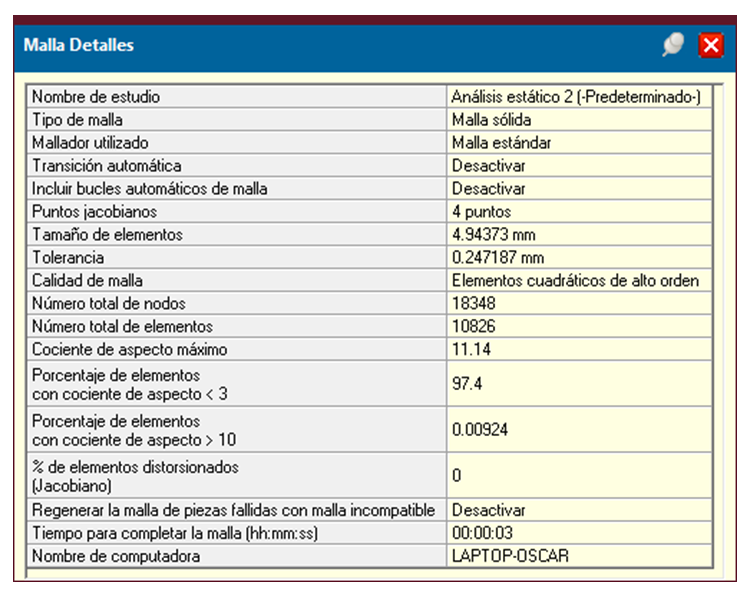
imagenes/Dominio especifico/Validaciones eslabones/Mesa/Cilindro-Base_Nodos.png
