EduardoSBarreraR/Trabajo_Terminal_2/imagenes/Dominio especifico/Validaciones eslabones/Mesa/Cilindro-Base_Propiedades.png

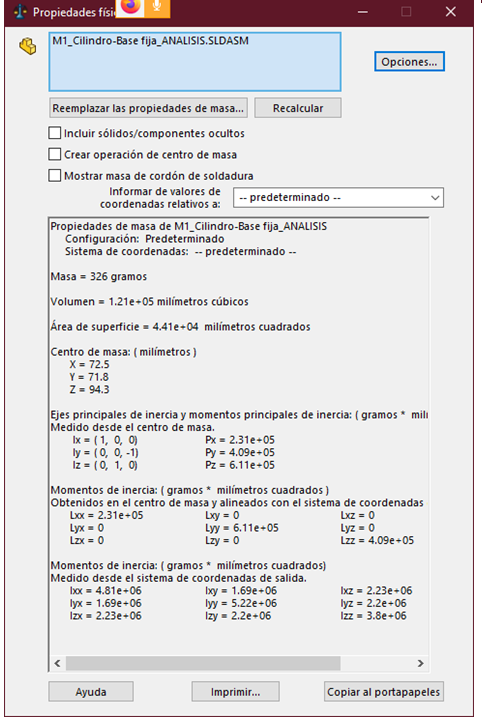
imagenes/Dominio especifico/Validaciones eslabones/Mesa/Cilindro-Base_Propiedades.png
