EduardoSBarreraR/Trabajo_Terminal_2/imagenes/Dominio especifico/Validaciones eslabones/Mesa/CilindroFijo.png

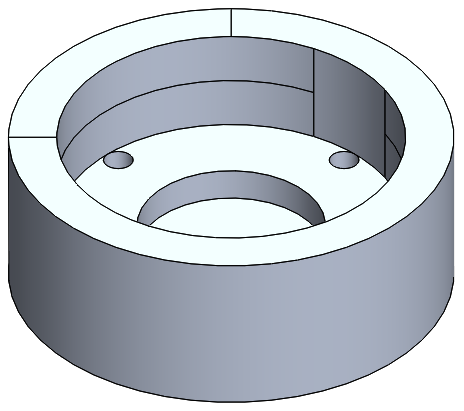
imagenes/Dominio especifico/Validaciones eslabones/Mesa/CilindroFijo.png
