EduardoSBarreraR/Trabajo_Terminal_2/imagenes/Dominio especifico/Validaciones eslabones/Mesa/CilindroFijo_Nodos.png

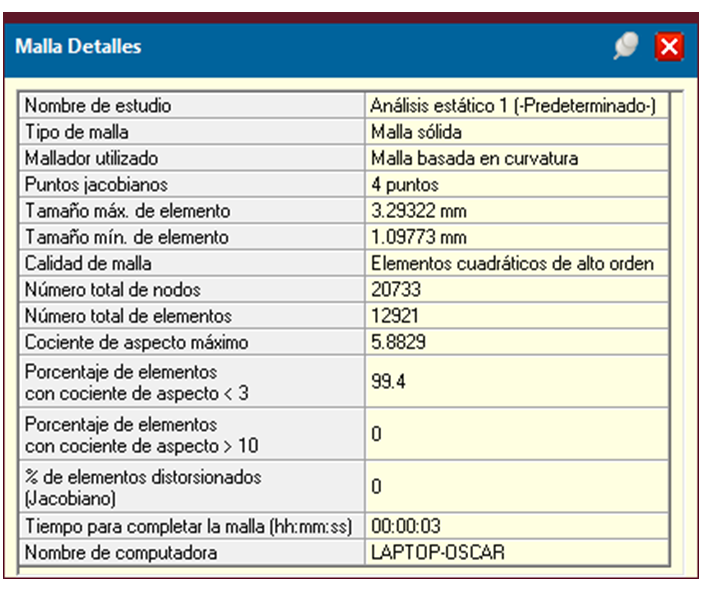
imagenes/Dominio especifico/Validaciones eslabones/Mesa/CilindroFijo_Nodos.png
