EduardoSBarreraR/Trabajo_Terminal_2/imagenes/Dominio especifico/Validaciones eslabones/Mesa/Mesa explosionada2.png

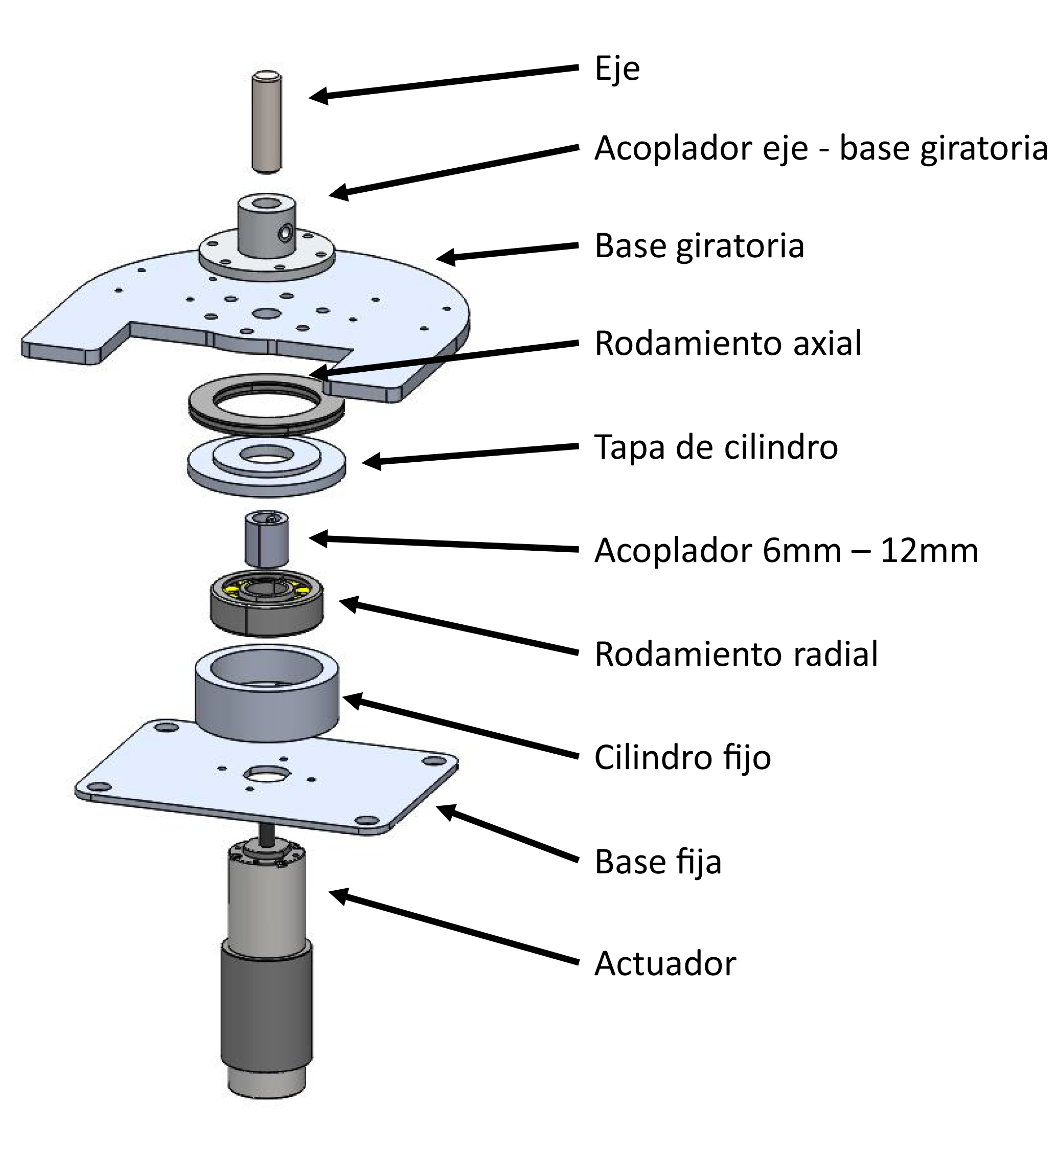
imagenes/Dominio especifico/Validaciones eslabones/Mesa/Mesa explosionada2.png
