EduardoSBarreraR/Trabajo_Terminal_2/imagenes/Dominio especifico/Validaciones eslabones/Mesa/Plataforma.png

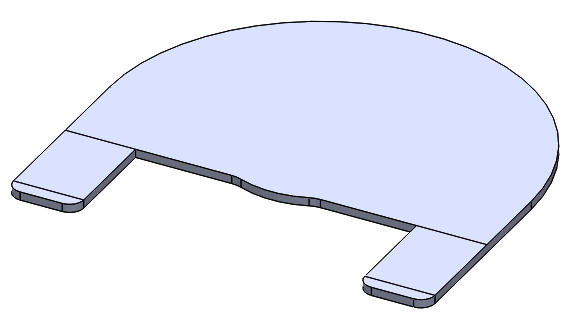
imagenes/Dominio especifico/Validaciones eslabones/Mesa/Plataforma.png
