EduardoSBarreraR/Trabajo_Terminal_2/imagenes/Dominio especifico/Validaciones eslabones/Mesa/Plataforma_Deformacion.png

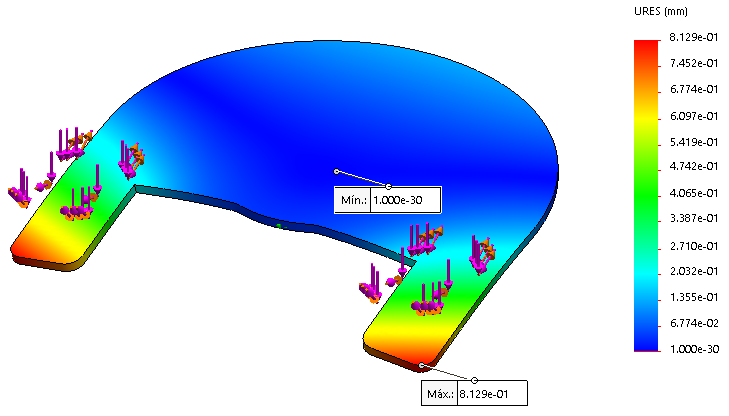
imagenes/Dominio especifico/Validaciones eslabones/Mesa/Plataforma_Deformacion.png
