EduardoSBarreraR/Trabajo_Terminal_2/imagenes/Dominio especifico/Validaciones eslabones/Mesa/Plataforma_VistaSuperior.png

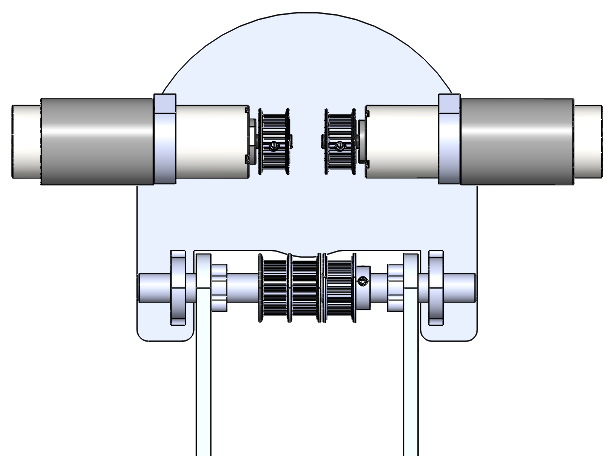
imagenes/Dominio especifico/Validaciones eslabones/Mesa/Plataforma_VistaSuperior.png
