EduardoSBarreraR/Trabajo_Terminal_2/imagenes/Dominio especifico/Validaciones eslabones/Mesa/VistaExplosionadaCadera.png

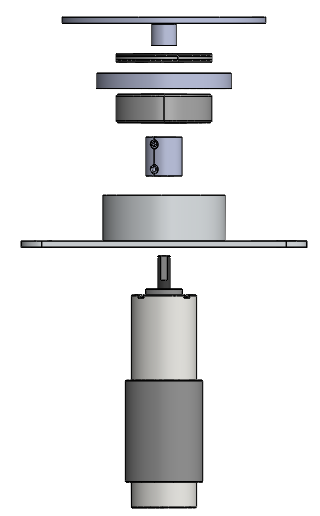
imagenes/Dominio especifico/Validaciones eslabones/Mesa/VistaExplosionadaCadera.png
