EduardoSBarreraR/Trabajo_Terminal_2/imagenes/Dominio especifico/Validaciones eslabones/Mesa/VistaExplosionadaCadera_Etiquetas.png

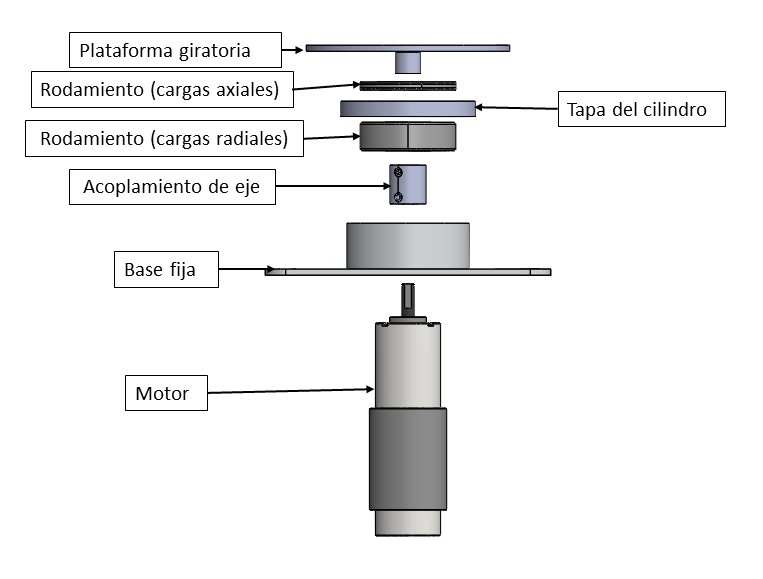
imagenes/Dominio especifico/Validaciones eslabones/Mesa/VistaExplosionadaCadera_Etiquetas.png
