EduardoSBarreraR/Trabajo_Terminal_2/imagenes/Dominio especifico/Validaciones eslabones/Mesa/VistaIso.jpg

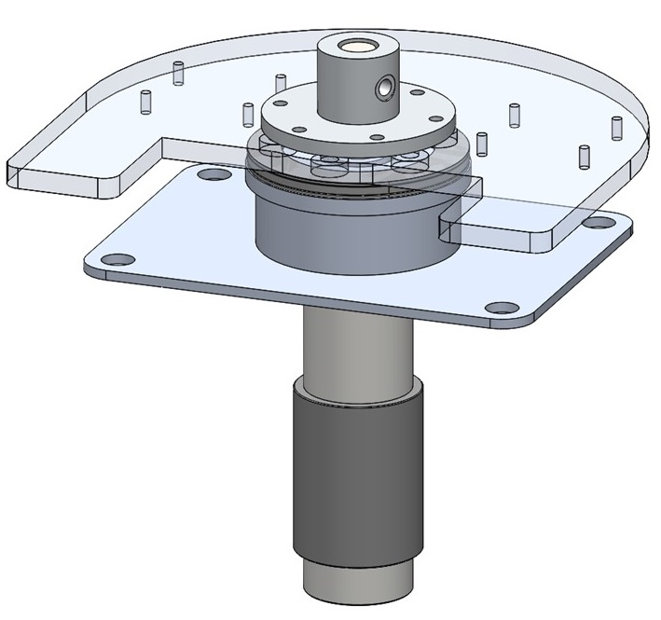
imagenes/Dominio especifico/Validaciones eslabones/Mesa/VistaIso.jpg
