EduardoSBarreraR/Trabajo_Terminal_2/imagenes/Dominio especifico/Validaciones eslabones/PoleaLoca.png

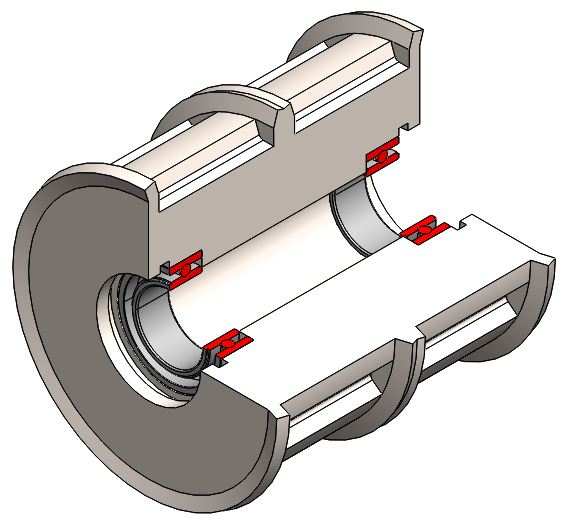
imagenes/Dominio especifico/Validaciones eslabones/PoleaLoca.png
