EduardoSBarreraR/Trabajo_Terminal_2/imagenes/Dominio especifico/Validaciones eslabones/Primeros eslabones traves.png

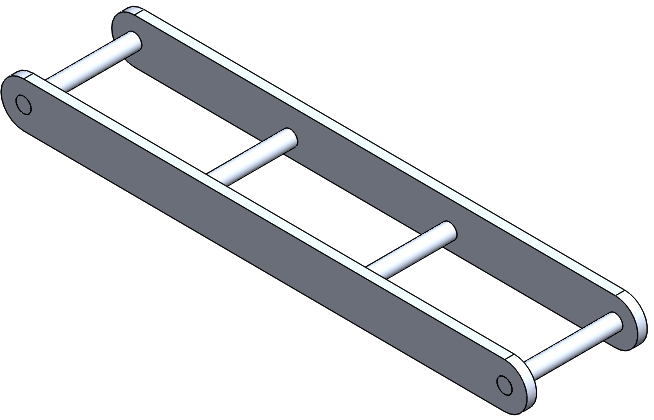
imagenes/Dominio especifico/Validaciones eslabones/Primeros eslabones traves.png
