EduardoSBarreraR/Trabajo_Terminal_2/imagenes/Dominio especifico/Validaciones eslabones/ROBOTNPG.png

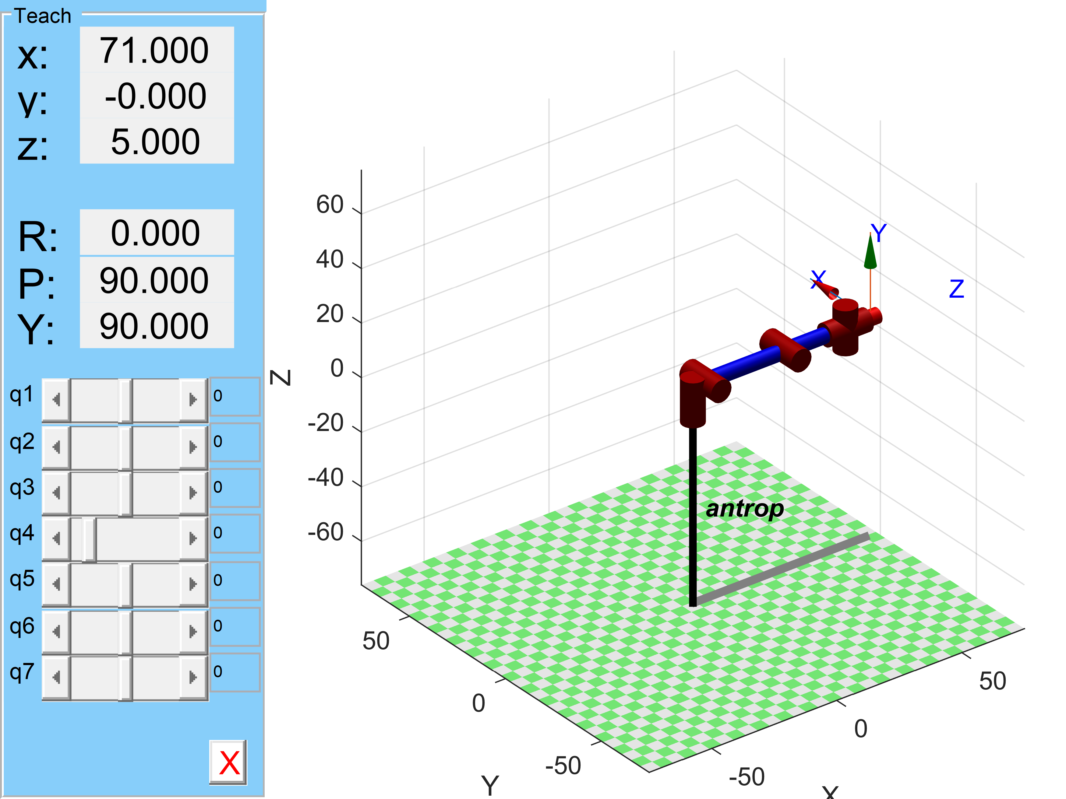
imagenes/Dominio especifico/Validaciones eslabones/ROBOTNPG.png
