EduardoSBarreraR/Trabajo_Terminal_2/imagenes/Dominio especifico/Validaciones eslabones/Segundos eslabones ranurados.png

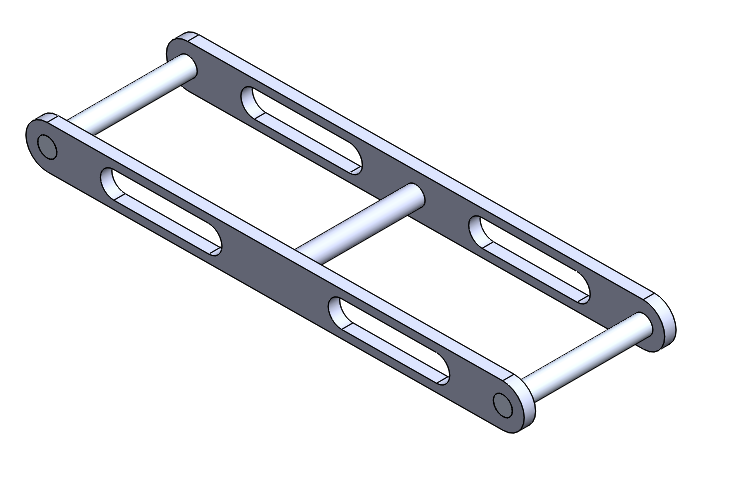
imagenes/Dominio especifico/Validaciones eslabones/Segundos eslabones ranurados.png
