EduardoSBarreraR/Trabajo_Terminal_2/imagenes/Dominio especifico/Validaciones eslabones/Transmision/Eje1s.jpeg

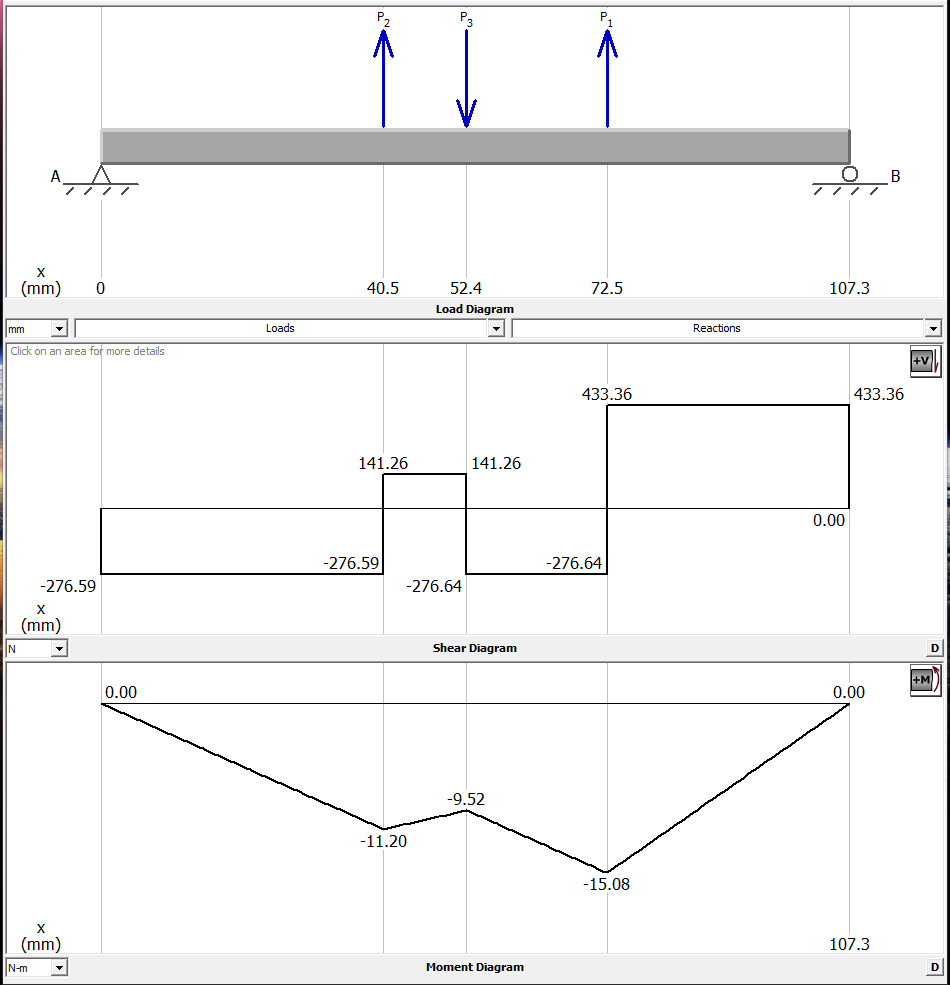
imagenes/Dominio especifico/Validaciones eslabones/Transmision/Eje1s.jpeg
