EduardoSBarreraR/Trabajo_Terminal_2/imagenes/Dominio especifico/Validaciones eslabones/Transmision/Eje2f.jpeg

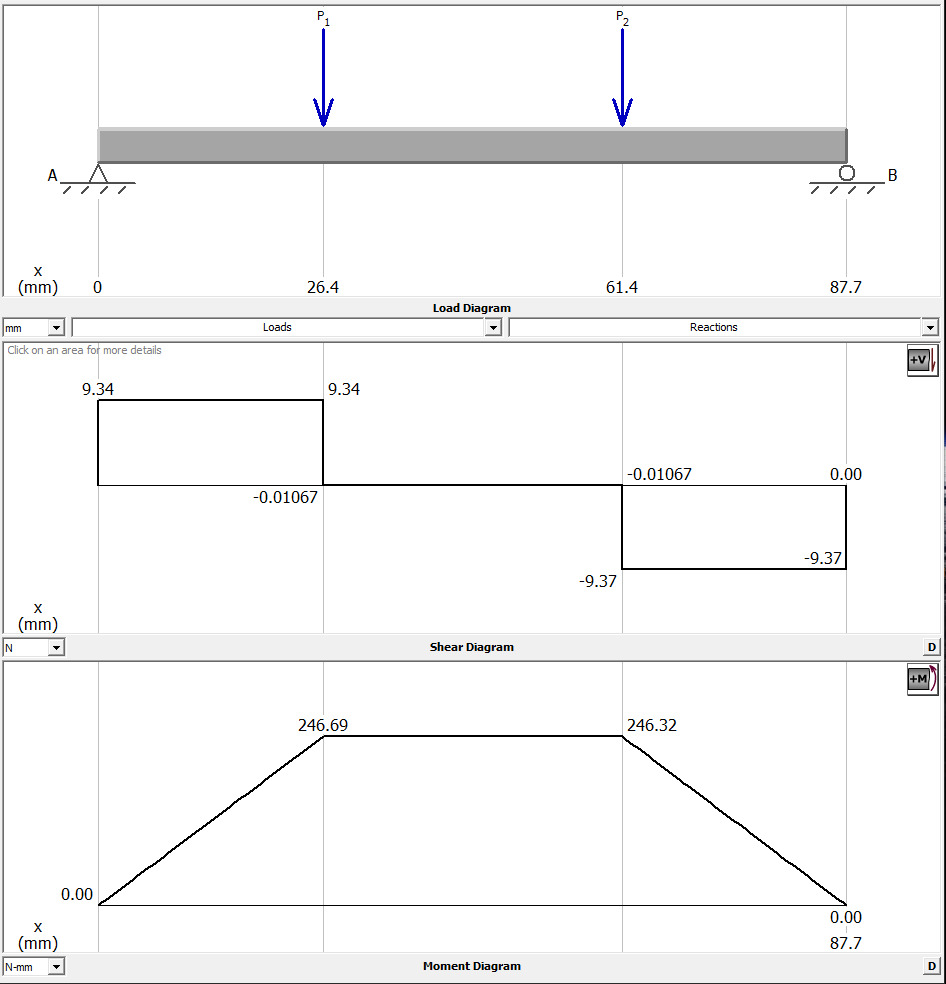
imagenes/Dominio especifico/Validaciones eslabones/Transmision/Eje2f.jpeg
