EduardoSBarreraR/Trabajo_Terminal_2/imagenes/Dominio especifico/Validaciones eslabones/Transmision/RodAxial2.jpg

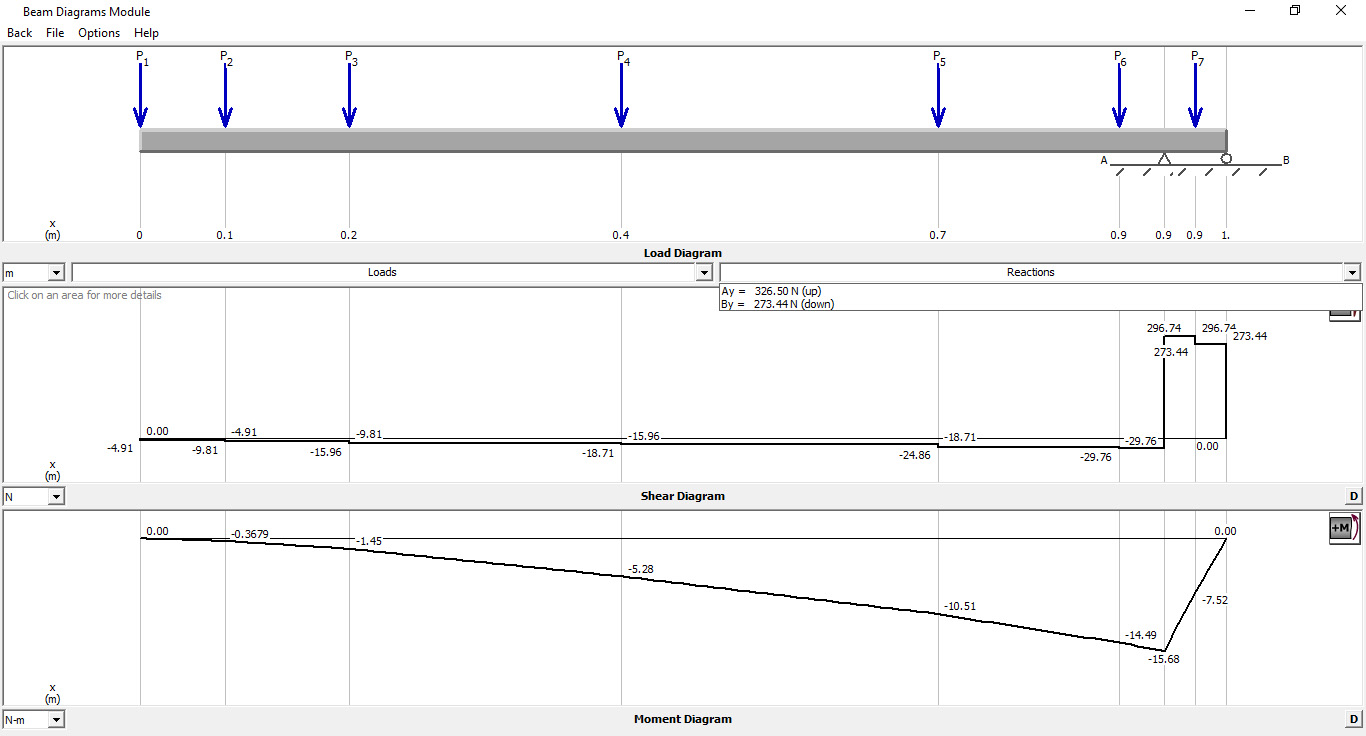
imagenes/Dominio especifico/Validaciones eslabones/Transmision/RodAxial2.jpg
