EduardoSBarreraR/Trabajo_Terminal_2/imagenes/Efectorxd.png

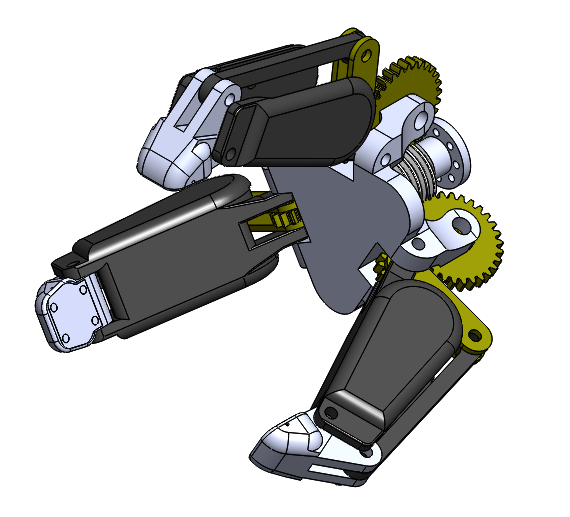
imagenes/Efectorxd.png
