EduardoSBarreraR/Trabajo_Terminal_2/imagenes/EfectorxdExp.png

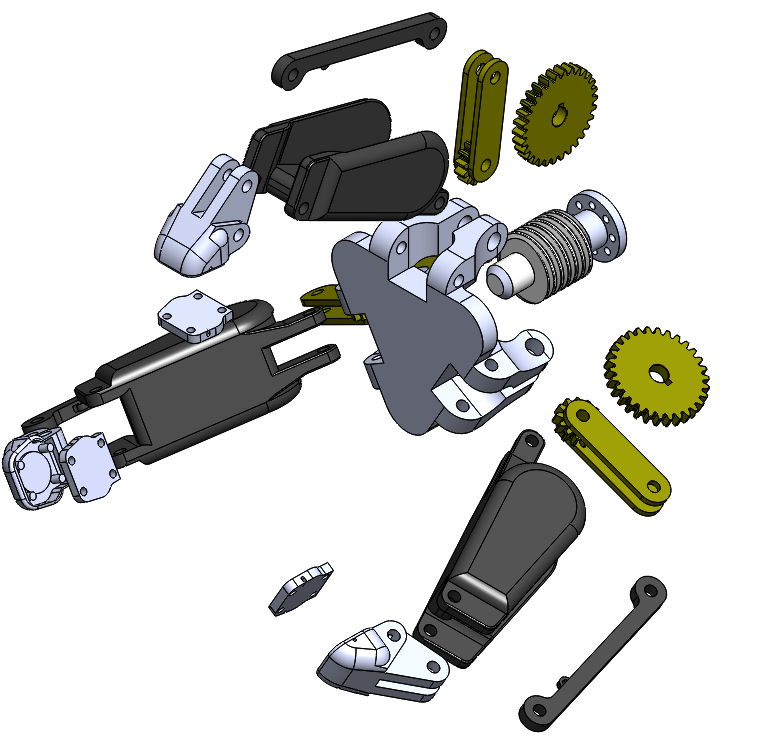
imagenes/EfectorxdExp.png
