EduardoSBarreraR/Trabajo_Terminal_2/imagenes/Implementacion/Efector/Efectorsuelo2.jpeg

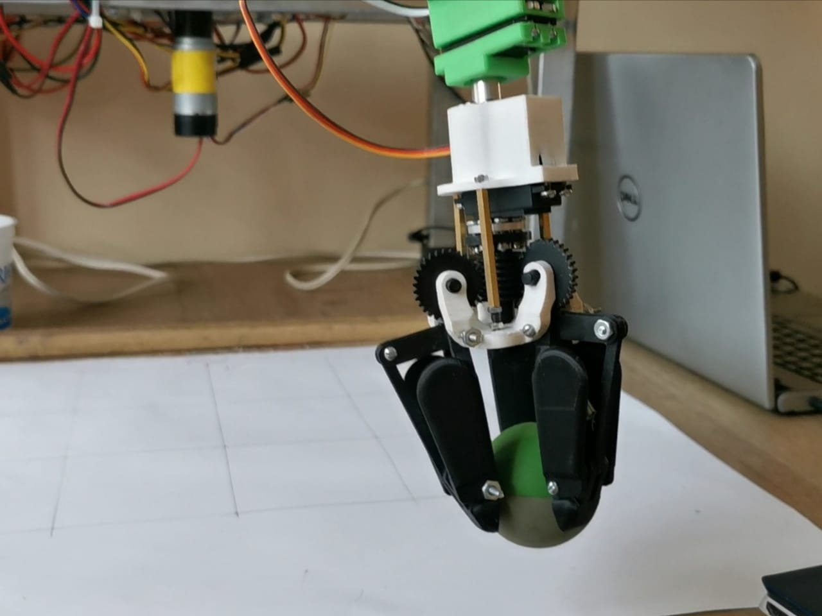
imagenes/Implementacion/Efector/Efectorsuelo2.jpeg
