EduardoSBarreraR/Trabajo_Terminal_2/imagenes/Implementacion/Efector/Efectorsuelo.jpeg

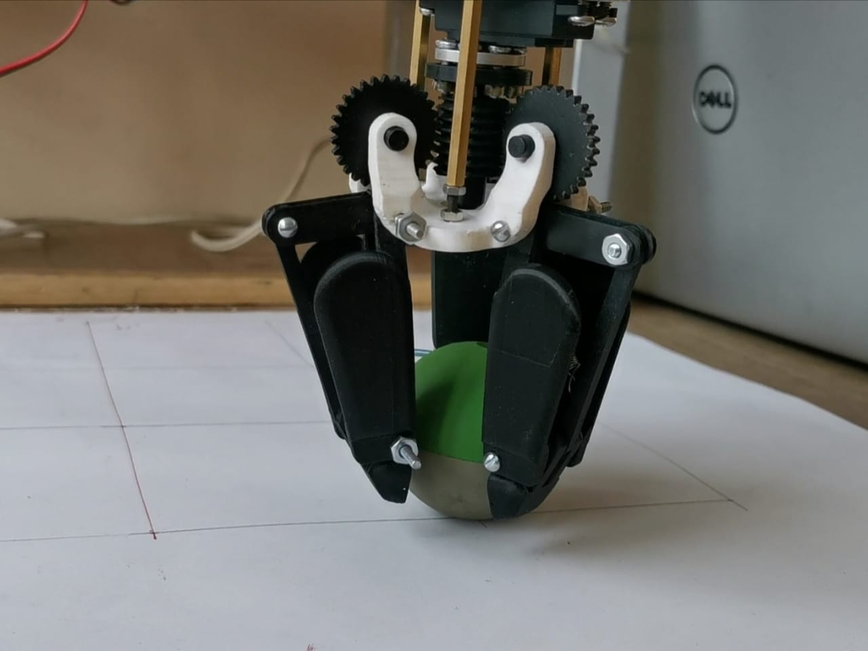
imagenes/Implementacion/Efector/Efectorsuelo.jpeg
