EduardoSBarreraR/Trabajo_Terminal_2/imagenes/Implementacion/Energetico.jpeg

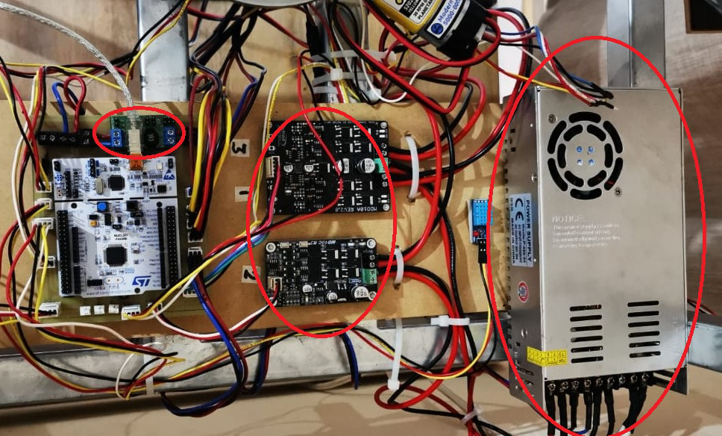
imagenes/Implementacion/Energetico.jpeg
