EduardoSBarreraR/Trabajo_Terminal_2/imagenes/Implementacion/Energetico_etiquetas.png

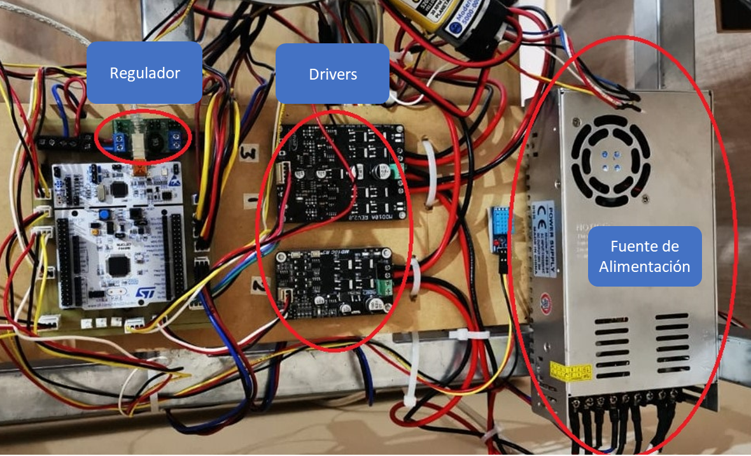
imagenes/Implementacion/Energetico_etiquetas.png
