EduardoSBarreraR/Trabajo_Terminal_2/imagenes/Implementacion/Fotodetodo.jpeg

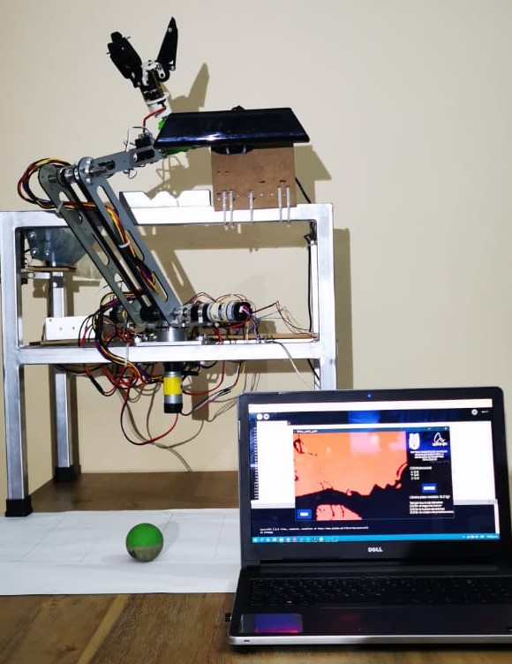
imagenes/Implementacion/Fotodetodo.jpeg
