EduardoSBarreraR/Trabajo_Terminal_2/imagenes/Implementacion/Fotodetodoxd.png

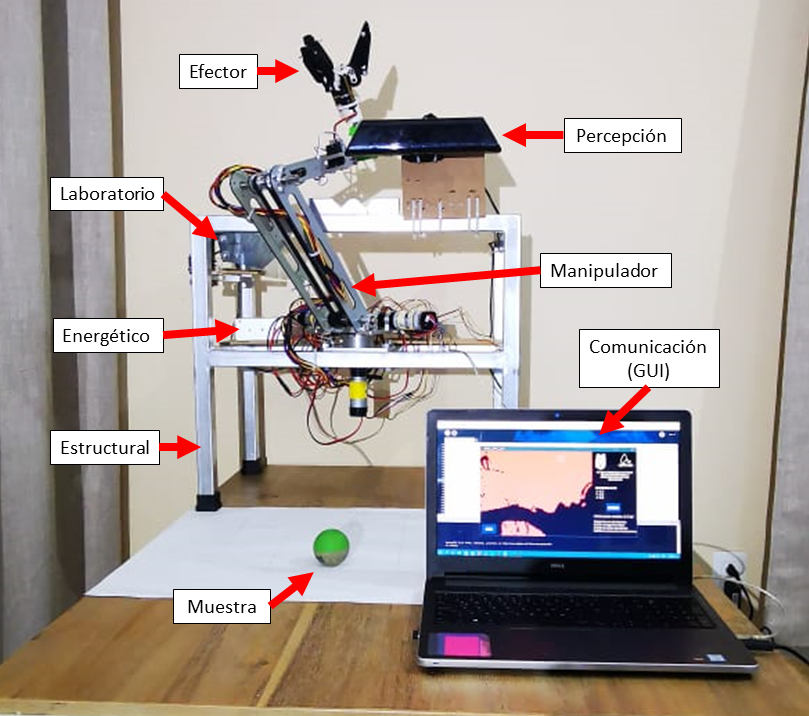
imagenes/Implementacion/Fotodetodoxd.png
