EduardoSBarreraR/Trabajo_Terminal_2/imagenes/Implementacion/Fotos/BasEfector.jpeg

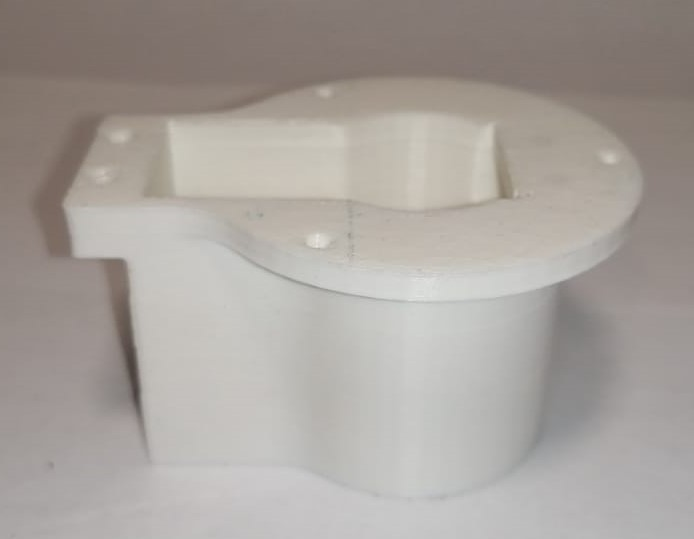
imagenes/Implementacion/Fotos/BasEfector.jpeg
