EduardoSBarreraR/Trabajo_Terminal_2/imagenes/Implementacion/Fotos/BaseFija1.JPG

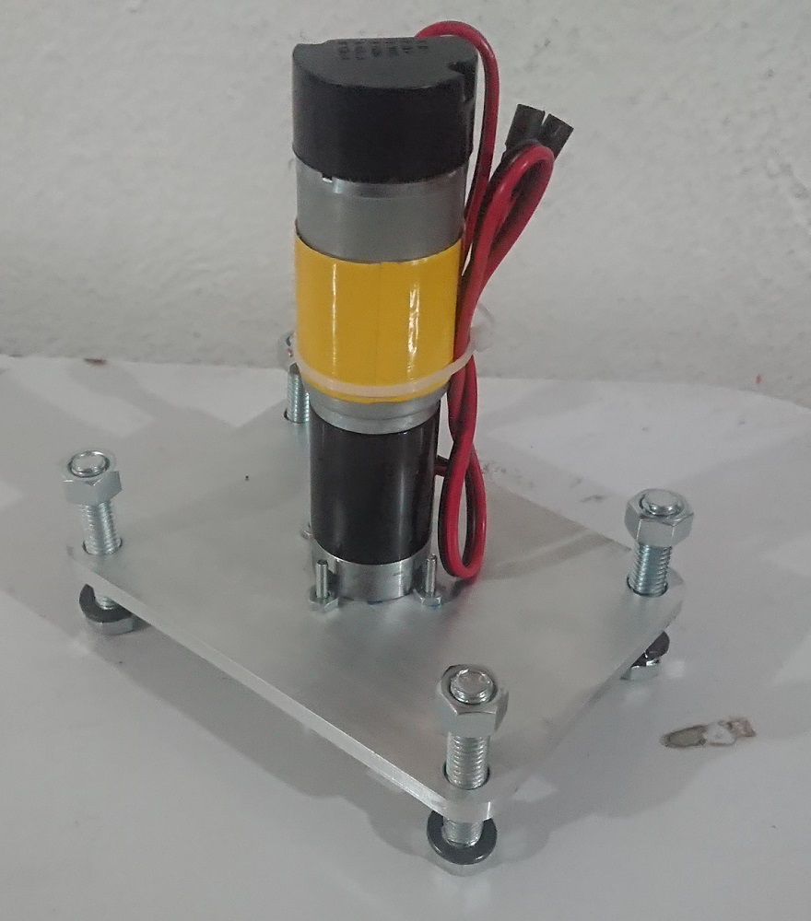
imagenes/Implementacion/Fotos/BaseFija1.JPG
