EduardoSBarreraR/Trabajo_Terminal_2/imagenes/Implementacion/Fotos/BaseFija2.JPG

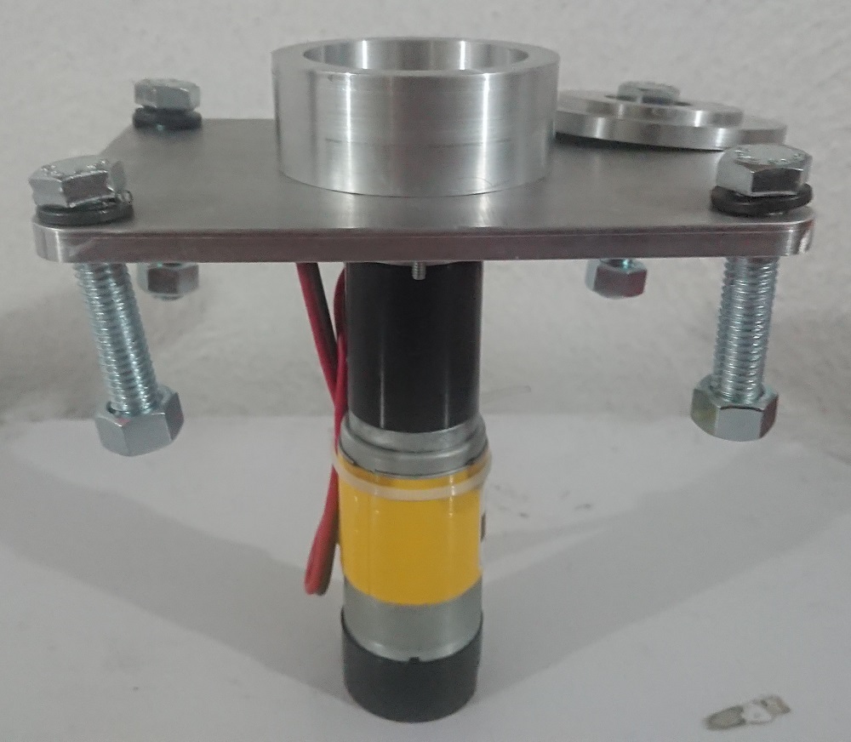
imagenes/Implementacion/Fotos/BaseFija2.JPG
