EduardoSBarreraR/Trabajo_Terminal_2/imagenes/Implementacion/Fotos/BaseFija3.JPG

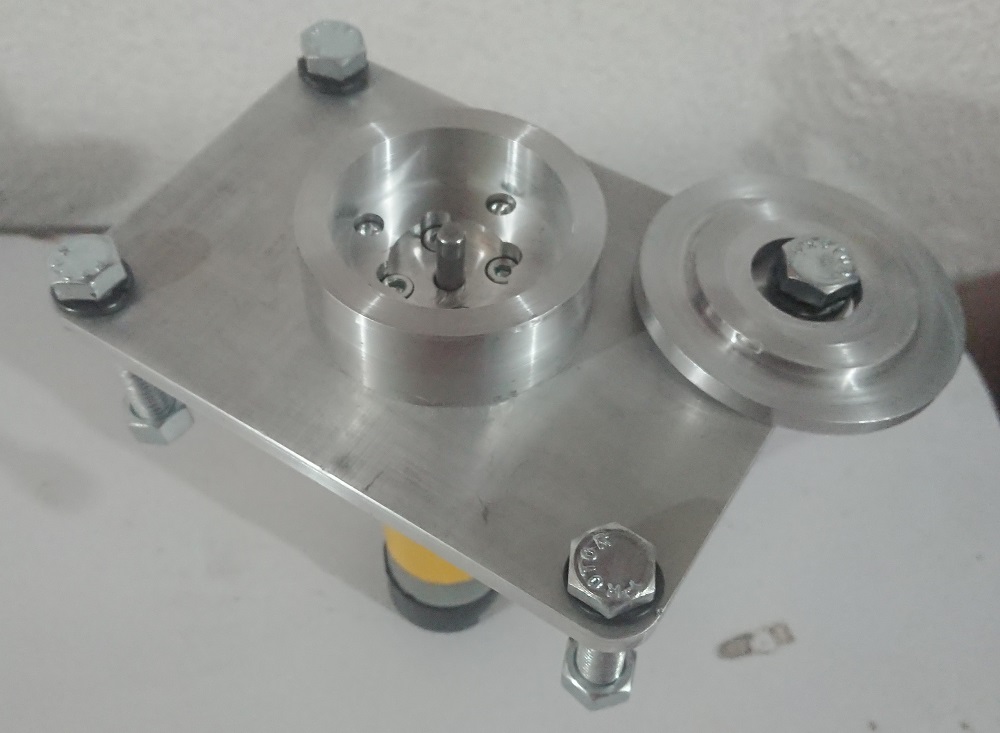
imagenes/Implementacion/Fotos/BaseFija3.JPG
