EduardoSBarreraR/Trabajo_Terminal_2/imagenes/Implementacion/Fotos/BaseManipulador.jpg

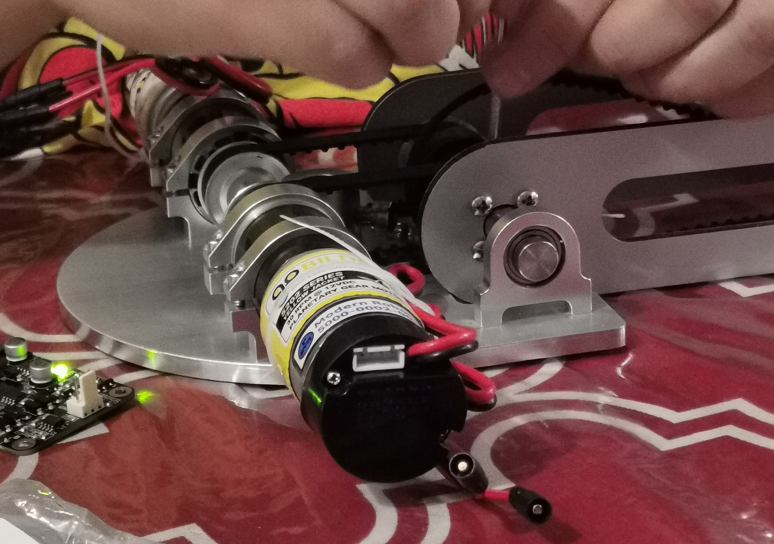
imagenes/Implementacion/Fotos/BaseManipulador.jpg
