EduardoSBarreraR/Trabajo_Terminal_2/imagenes/Implementacion/Fotos/Camara.jpg

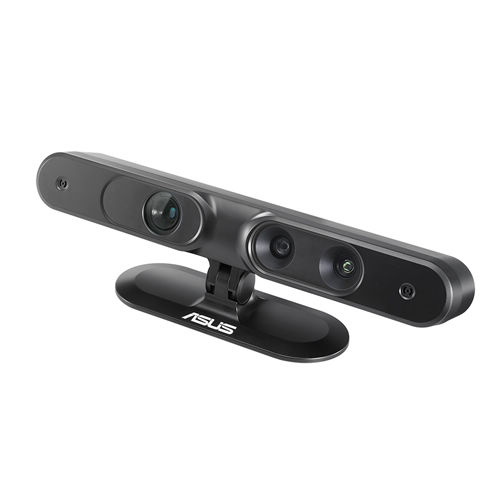
imagenes/Implementacion/Fotos/Camara.jpg
