EduardoSBarreraR/Trabajo_Terminal_2/imagenes/Implementacion/Fotos/Efector.jpg

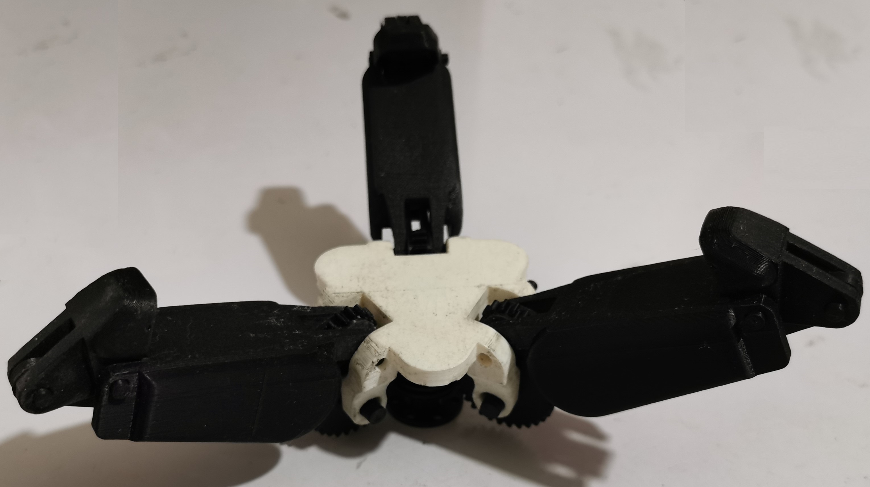
imagenes/Implementacion/Fotos/Efector.jpg
