EduardoSBarreraR/Trabajo_Terminal_2/imagenes/Implementacion/Fotos/EfectorDedos.jpeg

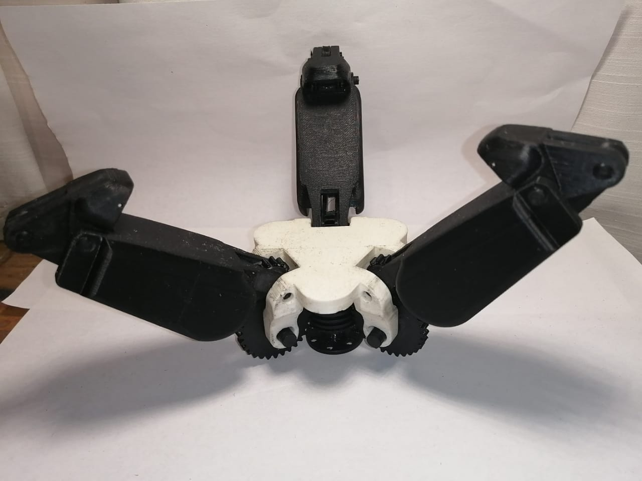
imagenes/Implementacion/Fotos/EfectorDedos.jpeg
