EduardoSBarreraR/Trabajo_Terminal_2/imagenes/Implementacion/Fotos/Eje5cm.jpg

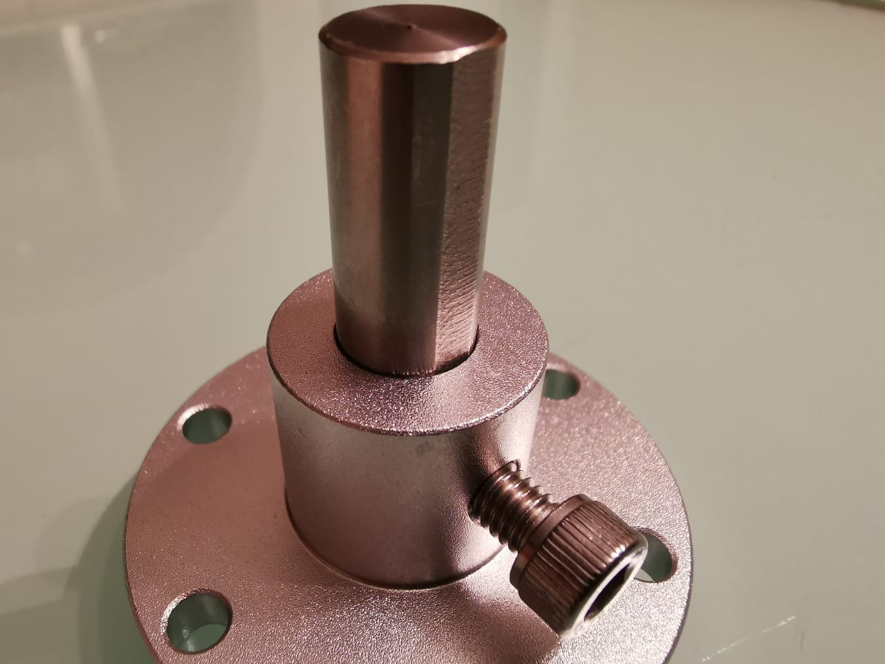
imagenes/Implementacion/Fotos/Eje5cm.jpg
