EduardoSBarreraR/Trabajo_Terminal_2/imagenes/Implementacion/Fotos/EjePolea.jpg

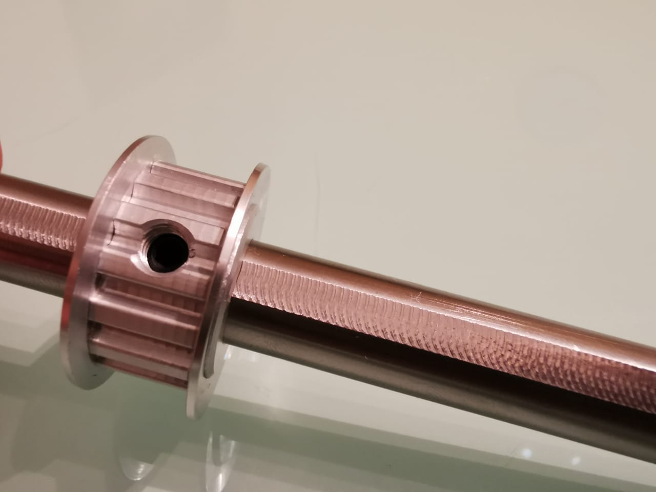
imagenes/Implementacion/Fotos/EjePolea.jpg
