EduardoSBarreraR/Trabajo_Terminal_2/imagenes/Implementacion/Fotos/EslabonCorto2.JPG

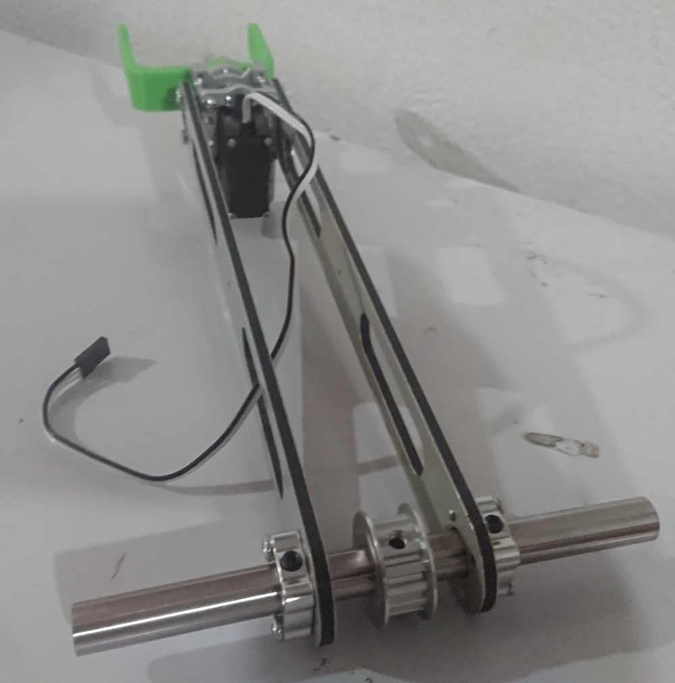
imagenes/Implementacion/Fotos/EslabonCorto2.JPG
