EduardoSBarreraR/Trabajo_Terminal_2/imagenes/Implementacion/Fotos/EslabonesCortosAlucobond.jpg

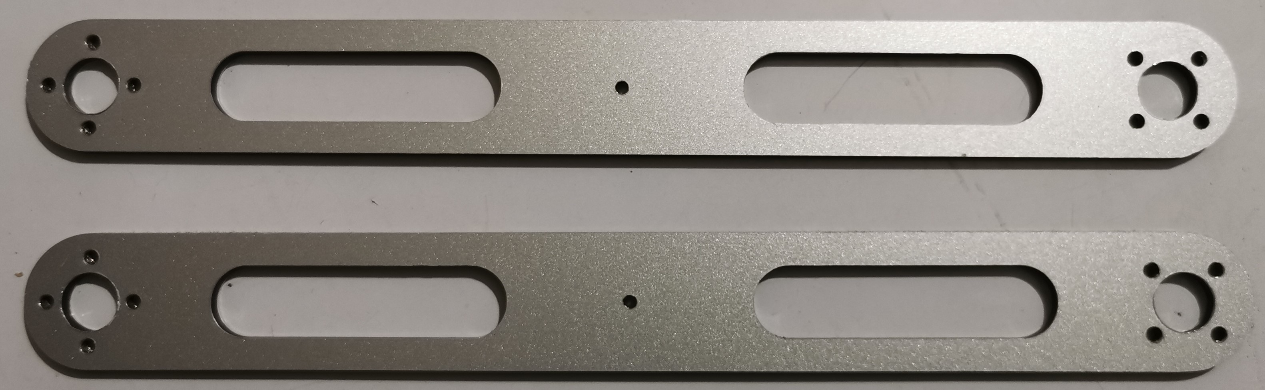
imagenes/Implementacion/Fotos/EslabonesCortosAlucobond.jpg
