EduardoSBarreraR/Trabajo_Terminal_2/imagenes/Implementacion/Fotos/EslabonesLargosAlucobond.jpg

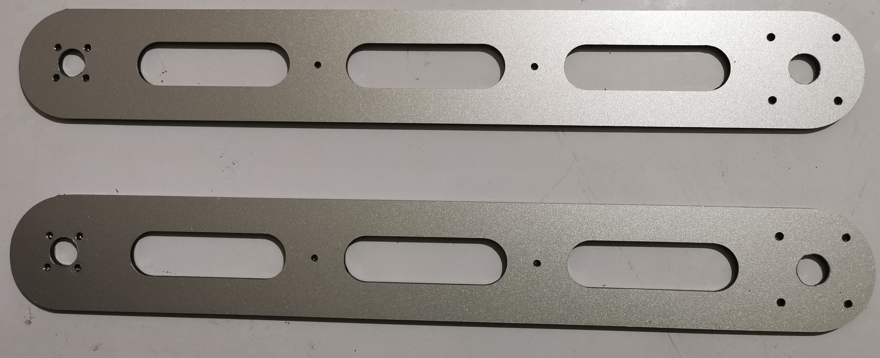
imagenes/Implementacion/Fotos/EslabonesLargosAlucobond.jpg
