EduardoSBarreraR/Trabajo_Terminal_2/imagenes/Implementacion/Fotos/Estructura1.JPG

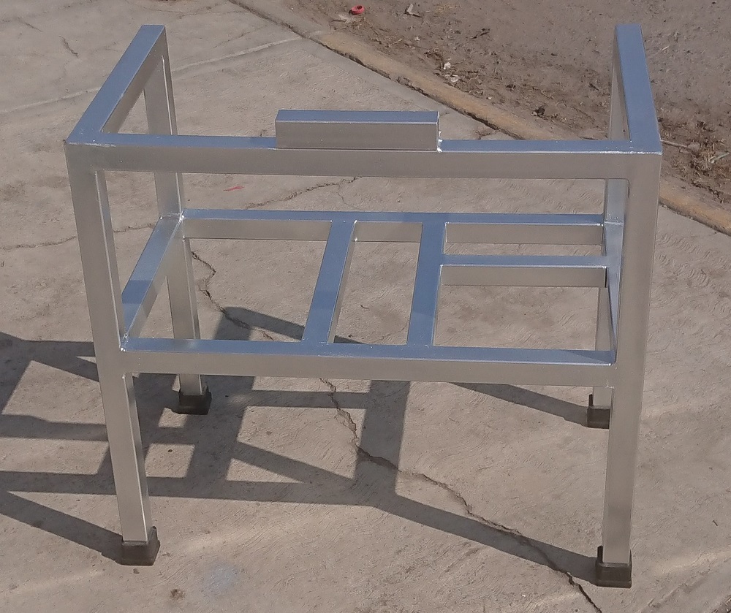
imagenes/Implementacion/Fotos/Estructura1.JPG
