EduardoSBarreraR/Trabajo_Terminal_2/imagenes/Implementacion/Fotos/Estructura2.JPG

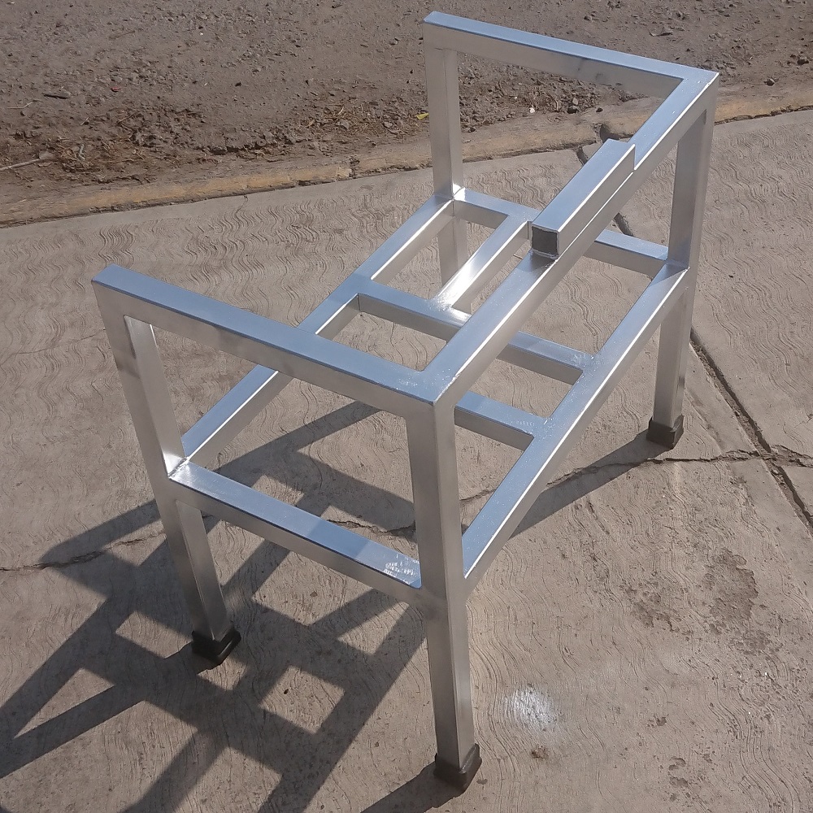
imagenes/Implementacion/Fotos/Estructura2.JPG
