EduardoSBarreraR/Trabajo_Terminal_2/imagenes/Implementacion/Fotos/GearsWorm.jpeg

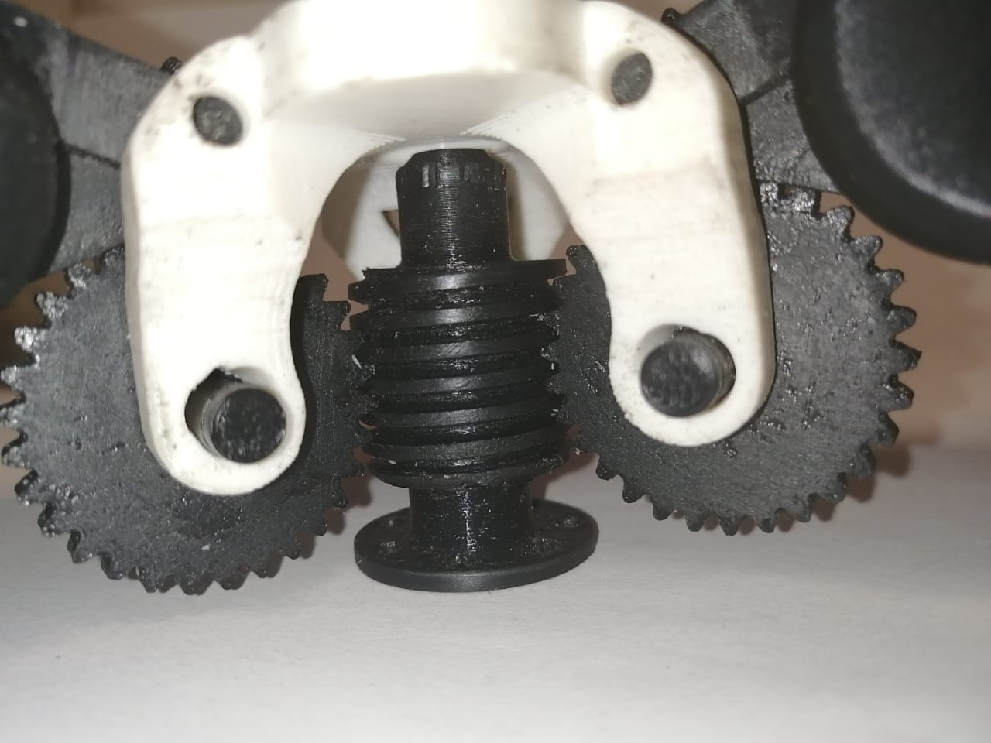
imagenes/Implementacion/Fotos/GearsWorm.jpeg
