EduardoSBarreraR/Trabajo_Terminal_2/imagenes/Implementacion/Fotos/Giratoria1.JPG

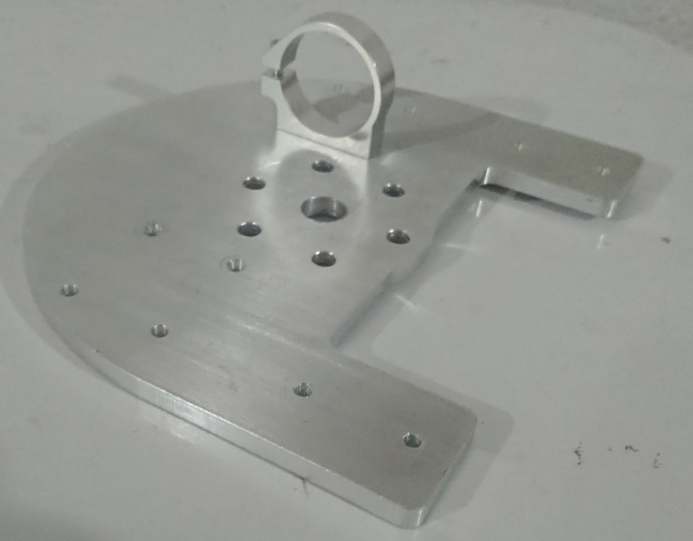
imagenes/Implementacion/Fotos/Giratoria1.JPG
