EduardoSBarreraR/Trabajo_Terminal_2/imagenes/Implementacion/Fotos/Giratoria2.JPG

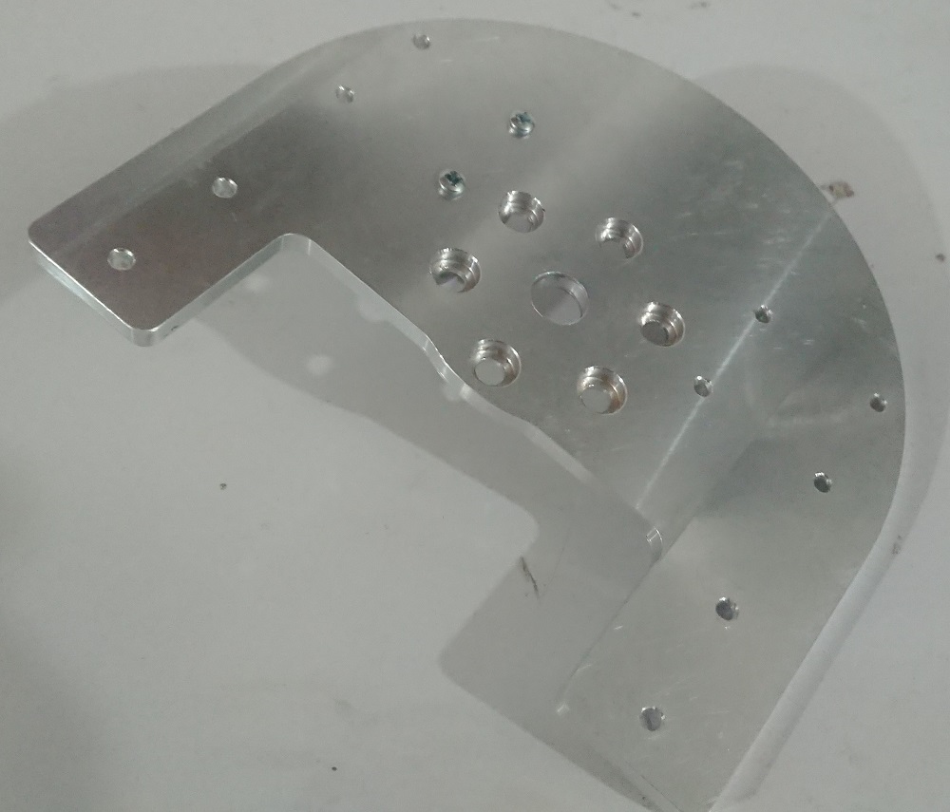
imagenes/Implementacion/Fotos/Giratoria2.JPG
