EduardoSBarreraR/Trabajo_Terminal_2/imagenes/Implementacion/Fotos/Giratoria3.JPG

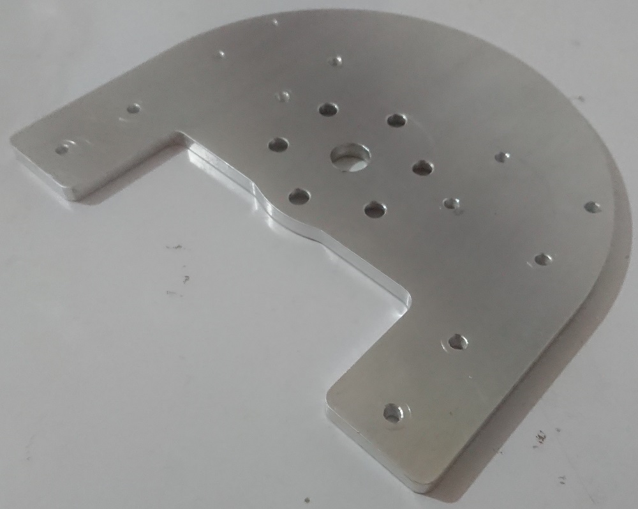
imagenes/Implementacion/Fotos/Giratoria3.JPG
