EduardoSBarreraR/Trabajo_Terminal_2/imagenes/Implementacion/Fotos/GiratoriaYMotores.jpg

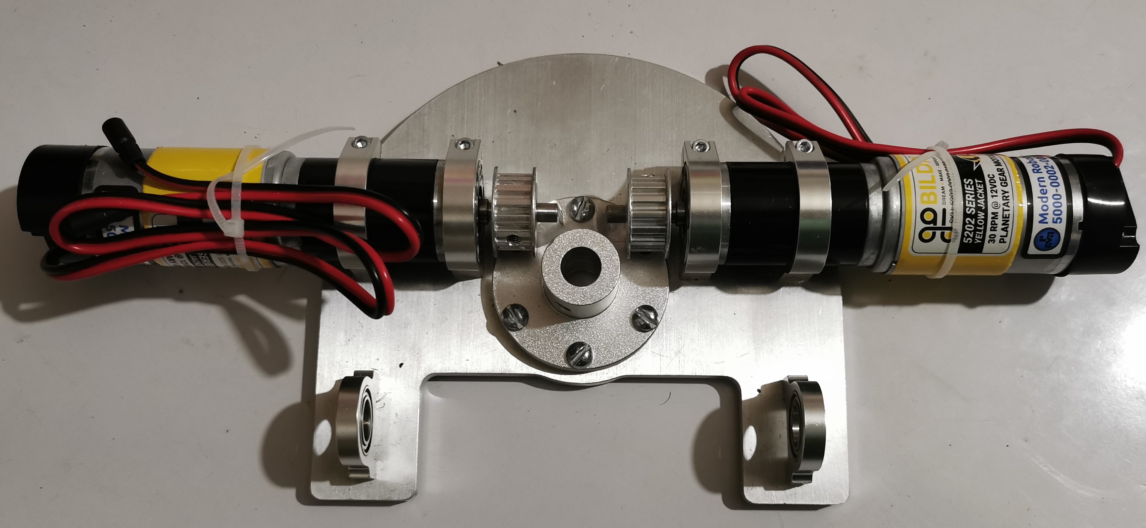
imagenes/Implementacion/Fotos/GiratoriaYMotores.jpg
