EduardoSBarreraR/Trabajo_Terminal_2/imagenes/Implementacion/Fotos/Motor.JPG

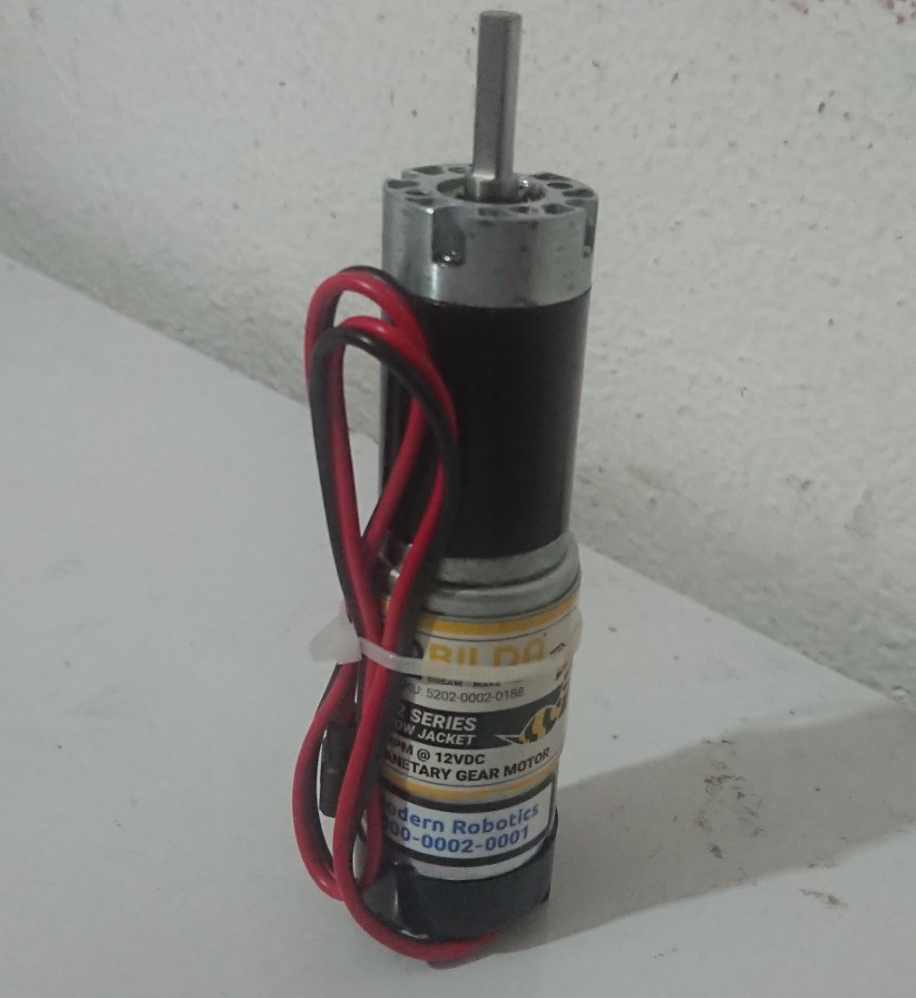
imagenes/Implementacion/Fotos/Motor.JPG
