EduardoSBarreraR/Trabajo_Terminal_2/imagenes/Implementacion/Fotos/PiezaC.jpeg

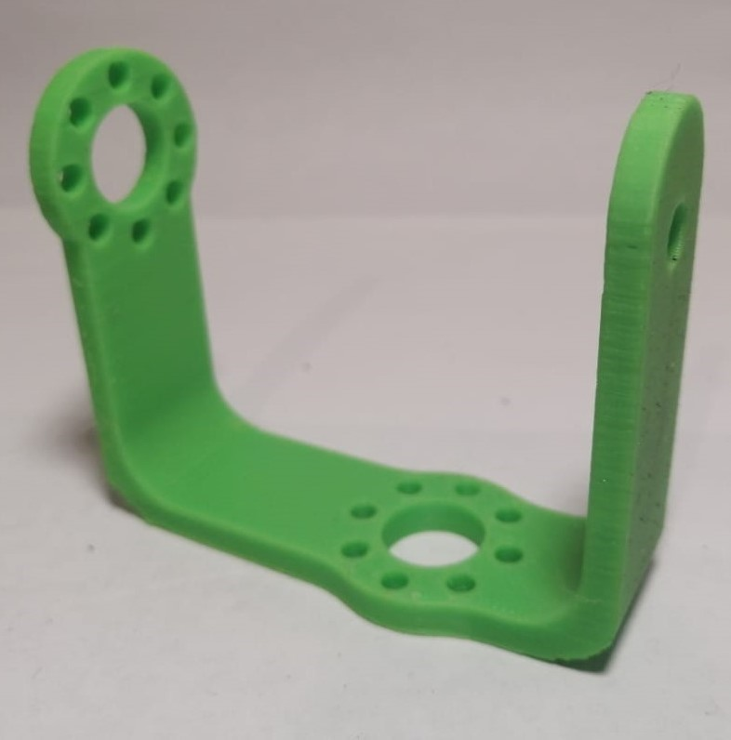
imagenes/Implementacion/Fotos/PiezaC.jpeg
