EduardoSBarreraR/Trabajo_Terminal_2/imagenes/Implementacion/Fotos/PlacaFront.jpg

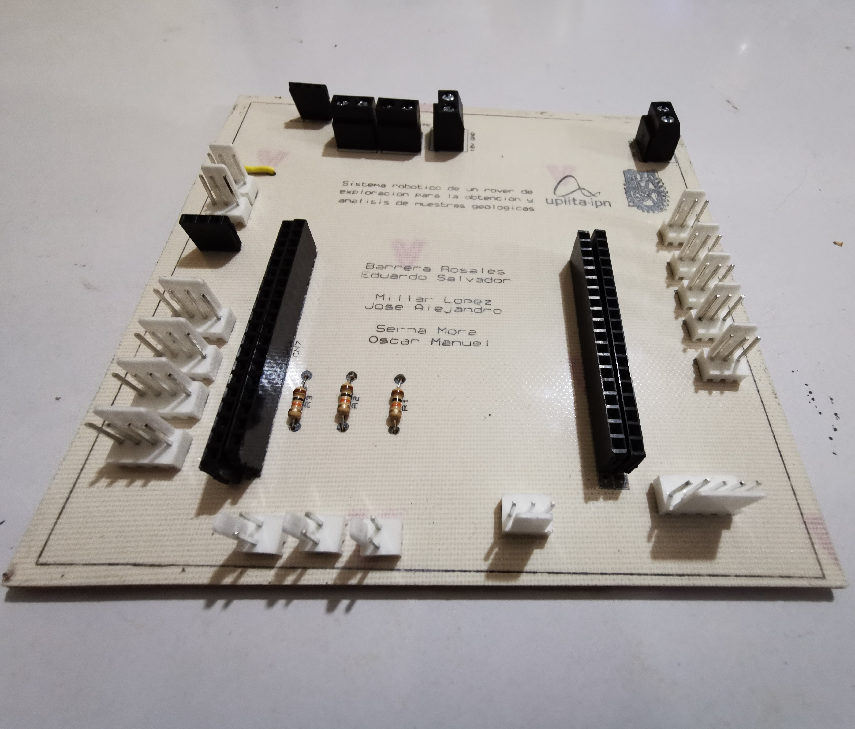
imagenes/Implementacion/Fotos/PlacaFront.jpg
