EduardoSBarreraR/Trabajo_Terminal_2/imagenes/Implementacion/Fotos/PlacaPost.jpg

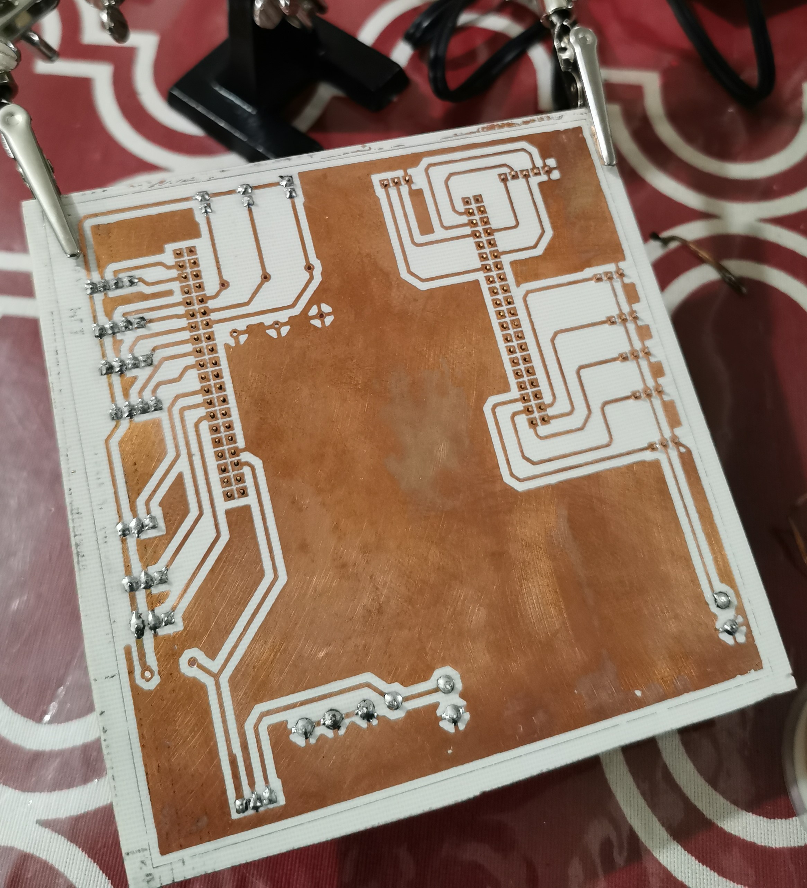
imagenes/Implementacion/Fotos/PlacaPost.jpg
