EduardoSBarreraR/Trabajo_Terminal_2/imagenes/Implementacion/Fotos/PoleaLoca.jpeg

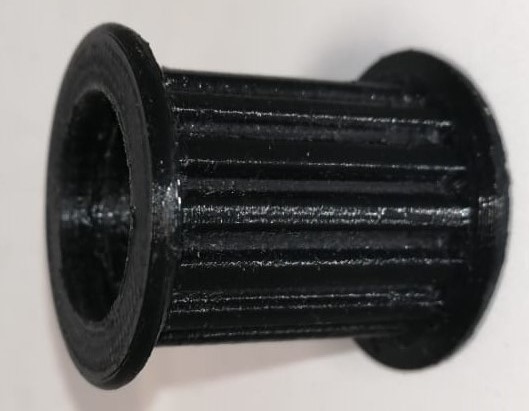
imagenes/Implementacion/Fotos/PoleaLoca.jpeg
