EduardoSBarreraR/Trabajo_Terminal_2/imagenes/Implementacion/Fotos/PoleaLocaVInterna.jpeg

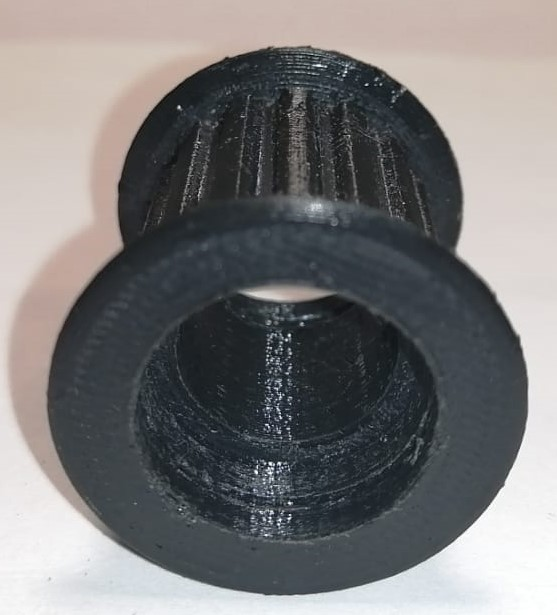
imagenes/Implementacion/Fotos/PoleaLocaVInterna.jpeg
