EduardoSBarreraR/Trabajo_Terminal_2/imagenes/Implementacion/Fotos/ServoCHub.JPG

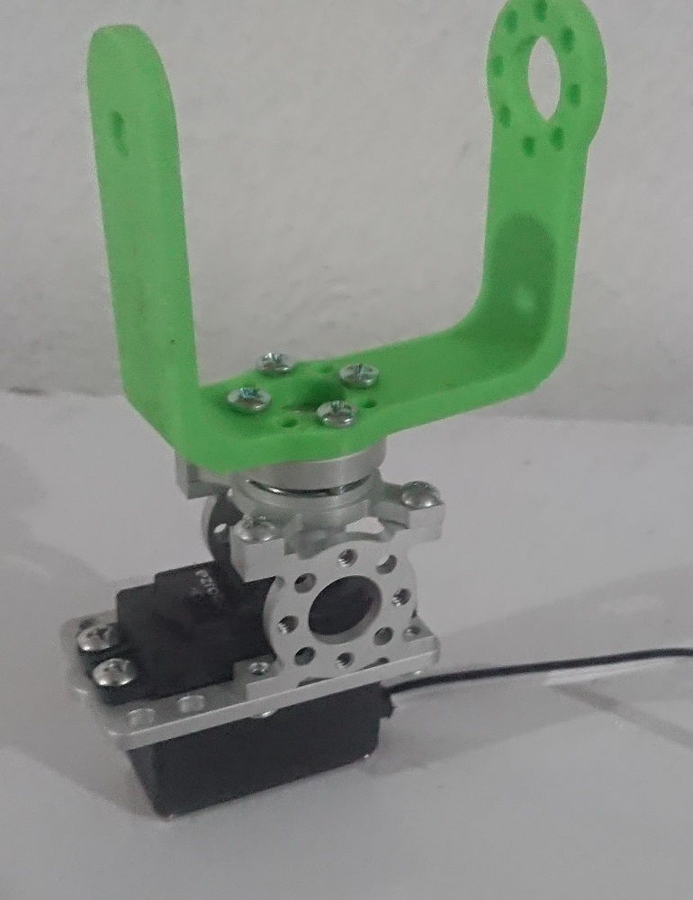
imagenes/Implementacion/Fotos/ServoCHub.JPG
