EduardoSBarreraR/Trabajo_Terminal_2/imagenes/Implementacion/Fotos/ServoPieza.jpeg

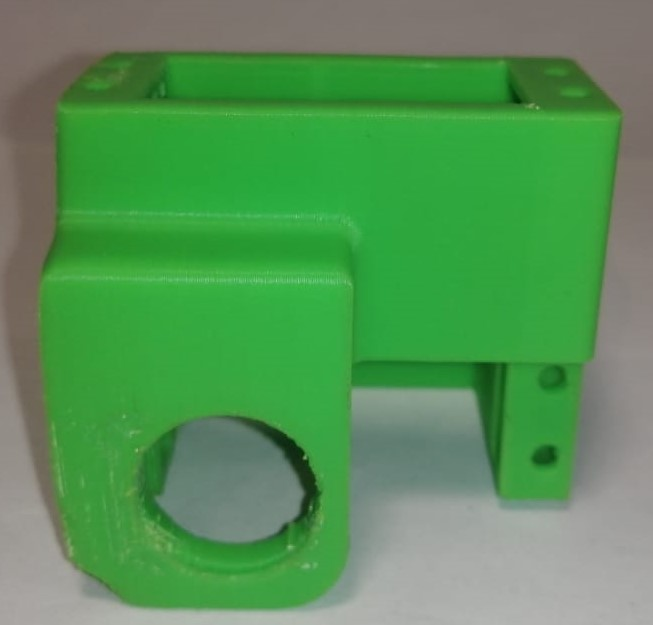
imagenes/Implementacion/Fotos/ServoPieza.jpeg
