EduardoSBarreraR/Trabajo_Terminal_2/imagenes/Implementacion/Fotos/ServoPieza.JPG

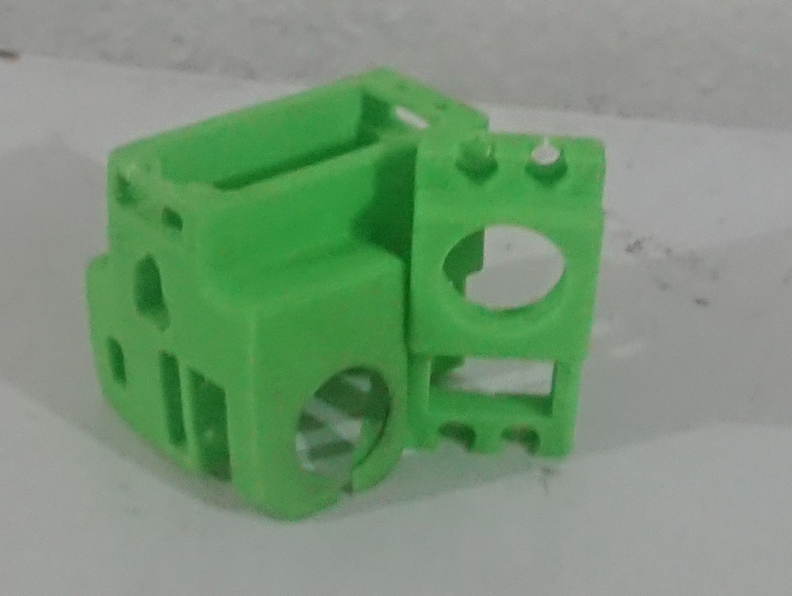
imagenes/Implementacion/Fotos/ServoPieza.JPG
