EduardoSBarreraR/Trabajo_Terminal_2/imagenes/Implementacion/Fotos/TapaServopieza.jpeg

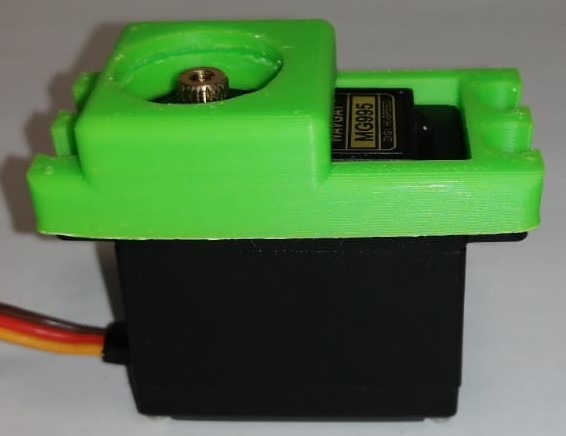
imagenes/Implementacion/Fotos/TapaServopieza.jpeg
