EduardoSBarreraR/Trabajo_Terminal_2/imagenes/Implementacion/Fotos/TapaServoPiezaFront.jpeg

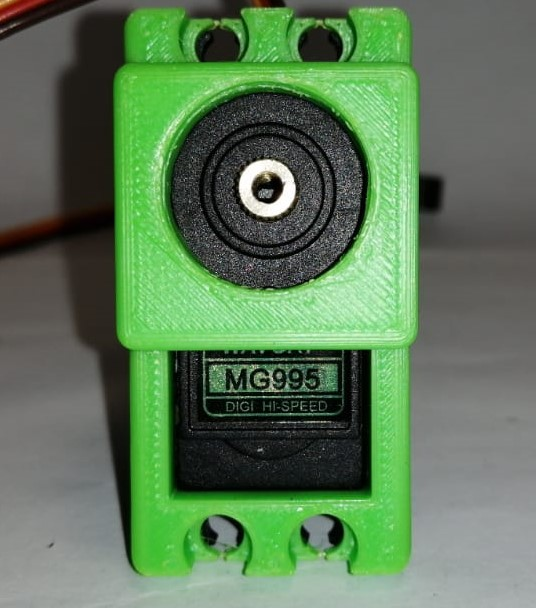
imagenes/Implementacion/Fotos/TapaServoPiezaFront.jpeg
