EduardoSBarreraR/Trabajo_Terminal_2/imagenes/Implementacion/GDLRobot.jpg

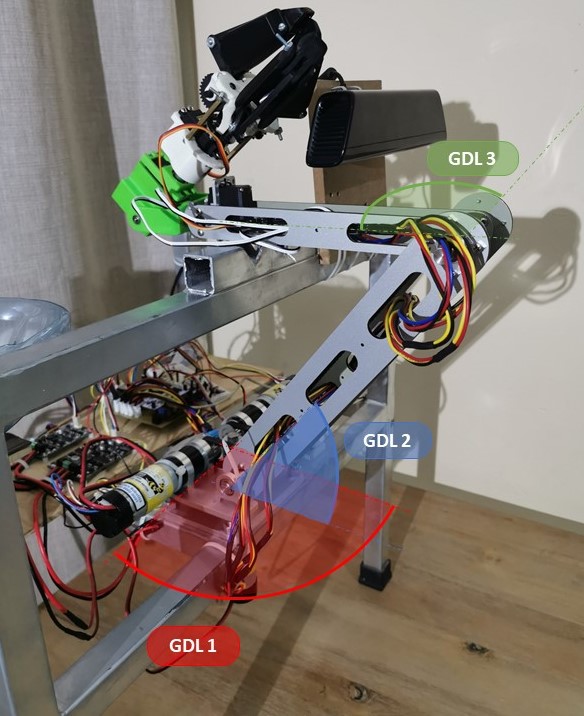
imagenes/Implementacion/GDLRobot.jpg
