EduardoSBarreraR/Trabajo_Terminal_2/imagenes/Implementacion/Laboratorio/Lab1.jpeg

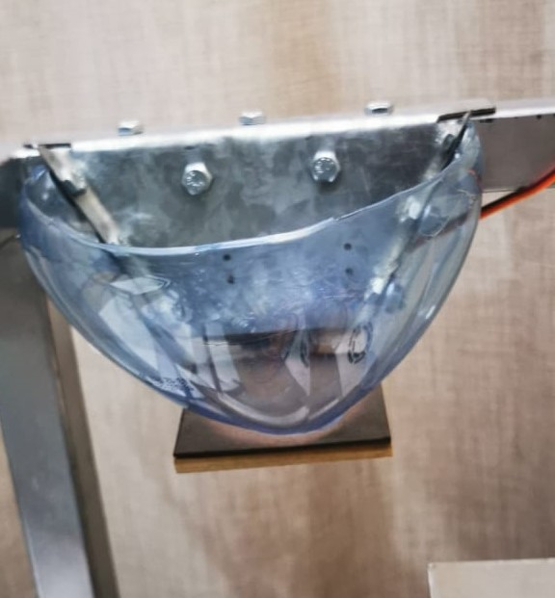
imagenes/Implementacion/Laboratorio/Lab1.jpeg
