EduardoSBarreraR/Trabajo_Terminal_2/imagenes/Implementacion/Laboratorio/Lab2.jpeg

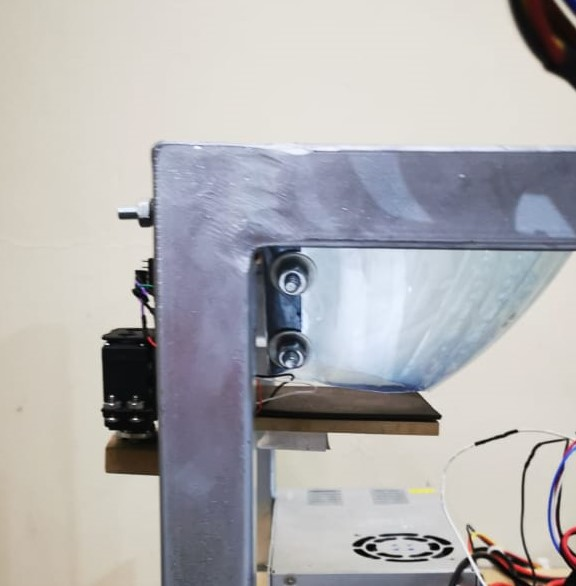
imagenes/Implementacion/Laboratorio/Lab2.jpeg
