EduardoSBarreraR/Trabajo_Terminal_2/imagenes/Implementacion/Laboratorio/LabLamina.jpeg

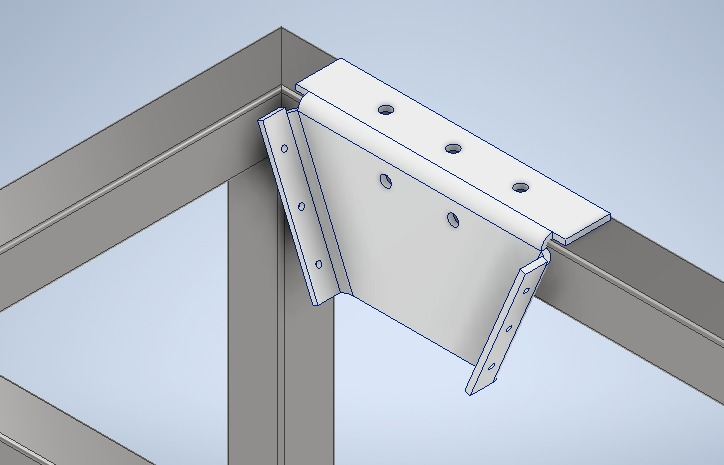
imagenes/Implementacion/Laboratorio/LabLamina.jpeg
