EduardoSBarreraR/Trabajo_Terminal_2/imagenes/Implementacion/Placa.jpeg

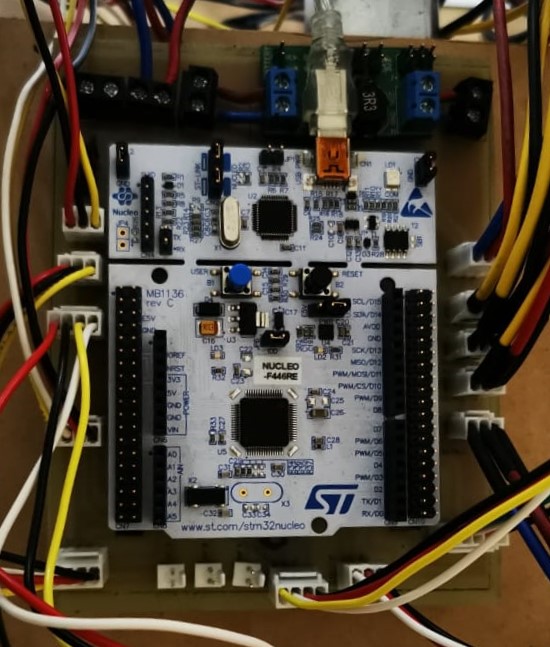
imagenes/Implementacion/Placa.jpeg
