EduardoSBarreraR/Trabajo_Terminal_2/imagenes/Implementacion/PosAux.jpeg

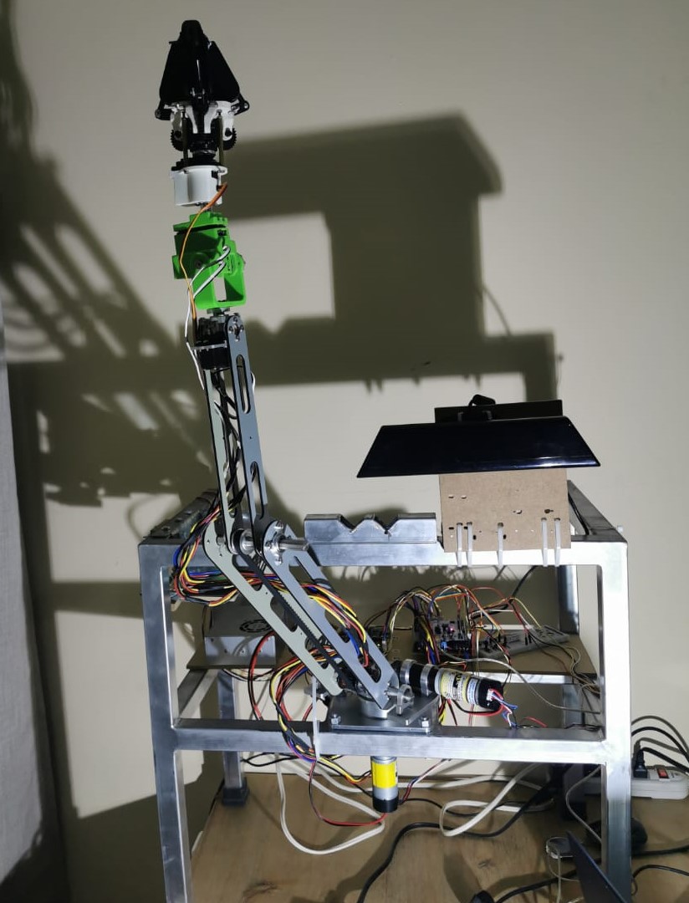
imagenes/Implementacion/PosAux.jpeg
