EduardoSBarreraR/Trabajo_Terminal_2/imagenes/Implementacion/PosicionExtendido.jpeg

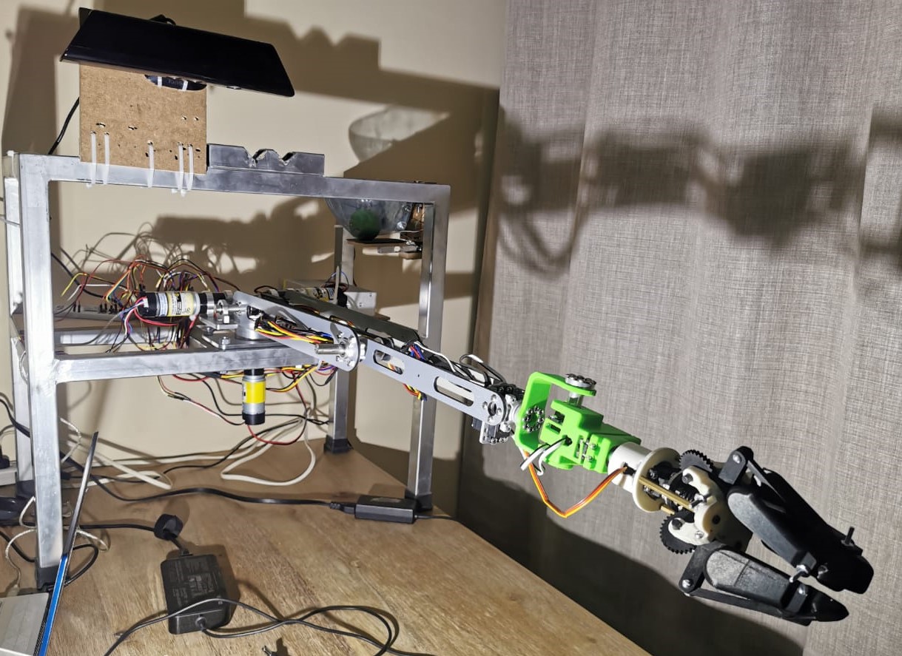
imagenes/Implementacion/PosicionExtendido.jpeg
