EduardoSBarreraR/Trabajo_Terminal_2/imagenes/Implementacion/PosicionHome.jpeg

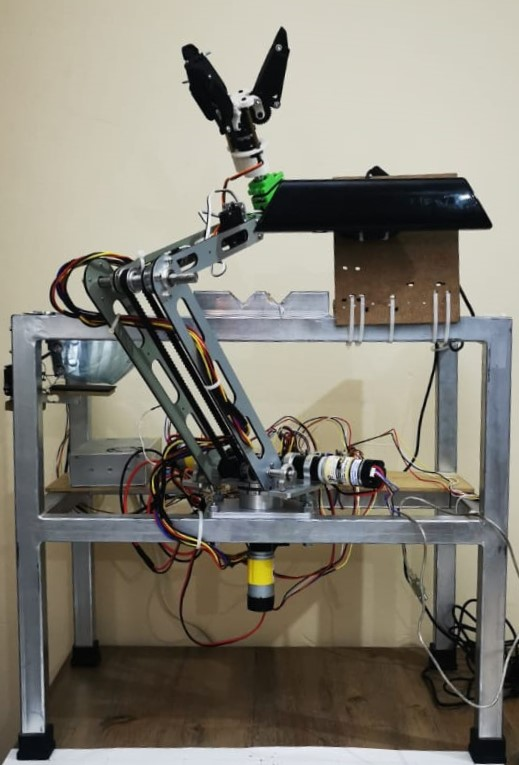
imagenes/Implementacion/PosicionHome.jpeg
