EduardoSBarreraR/Trabajo_Terminal_2/imagenes/Implementacion/PosicionLab.jpeg

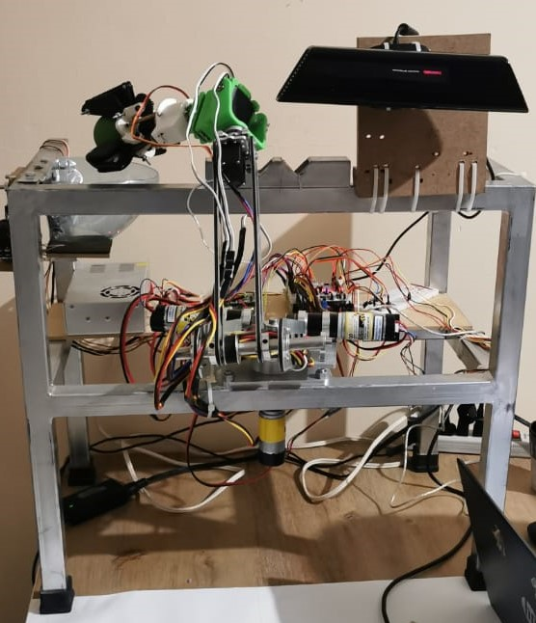
imagenes/Implementacion/PosicionLab.jpeg
