EduardoSBarreraR/Trabajo_Terminal_2/imagenes/Implementacion/Validaciones/PoleaLoca.png

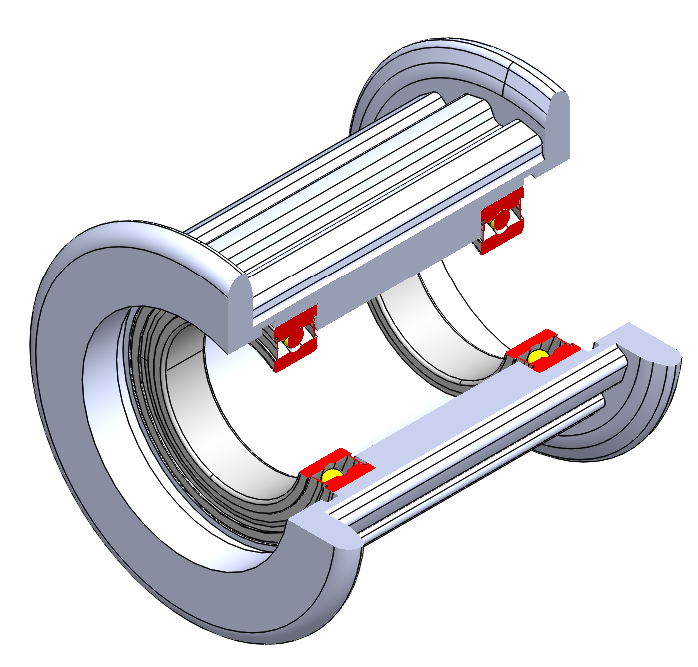
imagenes/Implementacion/Validaciones/PoleaLoca.png
