EduardoSBarreraR/Trabajo_Terminal_2/imagenes/Implementacion/Vision/Profundidad.jpeg

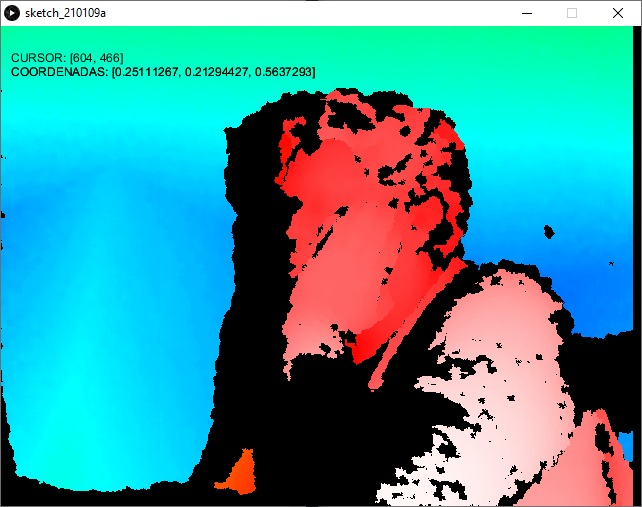
imagenes/Implementacion/Vision/Profundidad.jpeg
