EduardoSBarreraR/Trabajo_Terminal_2/imagenes/Integracion1.png

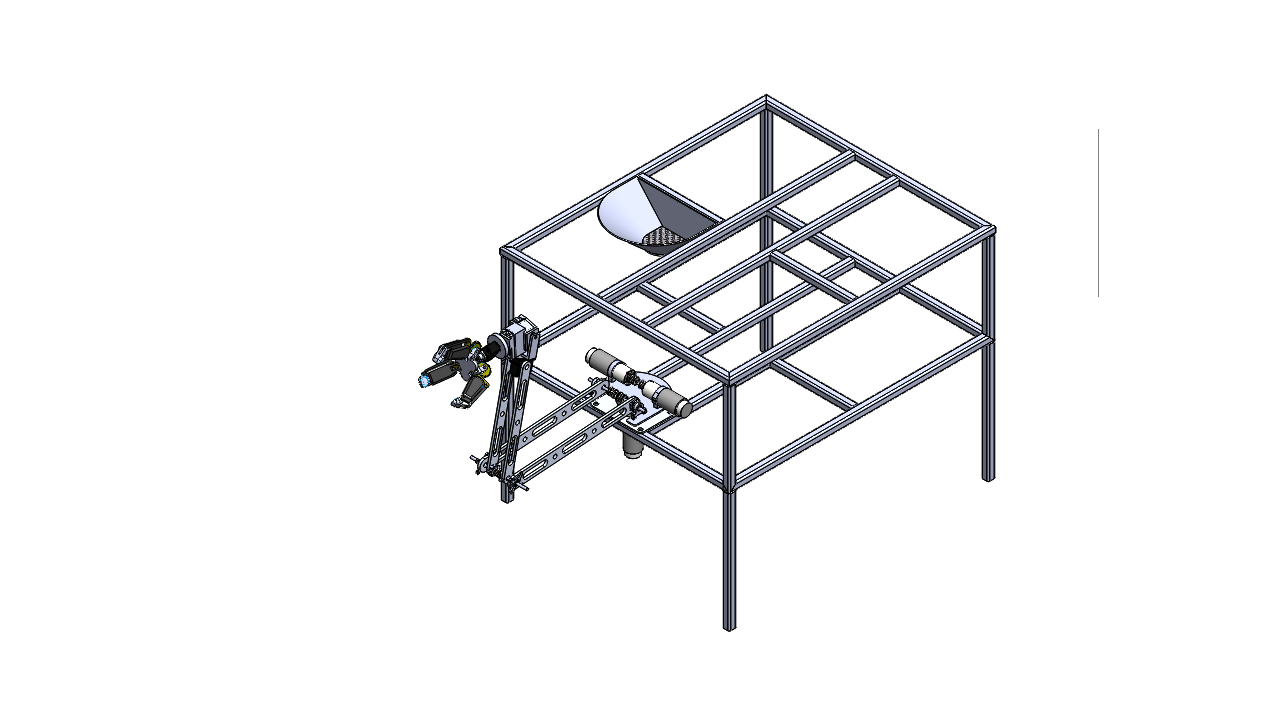
imagenes/Integracion1.png
