EduardoSBarreraR/Trabajo_Terminal_2/imagenes/INTEGRACION/Camara_Zoom (1).png

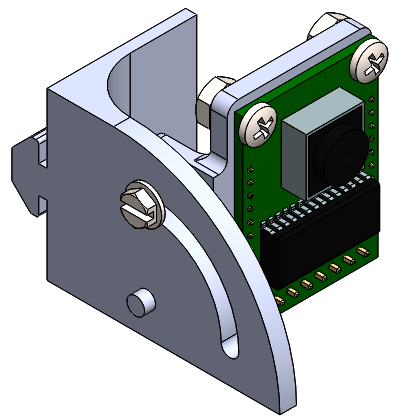
imagenes/INTEGRACION/Camara_Zoom (1).png
