EduardoSBarreraR/Trabajo_Terminal_2/imagenes/INTEGRACION/Camaras.png

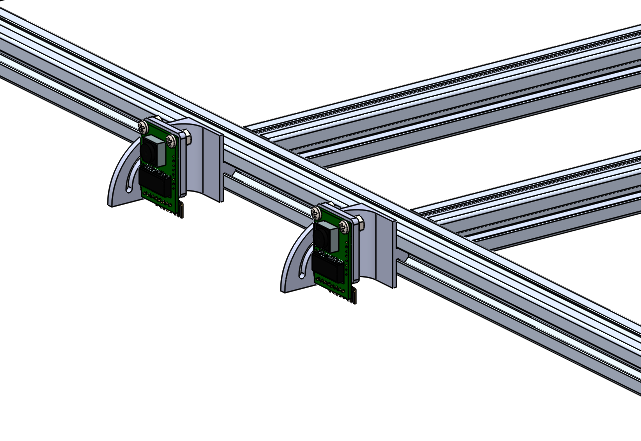
imagenes/INTEGRACION/Camaras.png
