EduardoSBarreraR/Trabajo_Terminal_2/imagenes/INTEGRACION/DiagramasDeFlujo_Micro.png

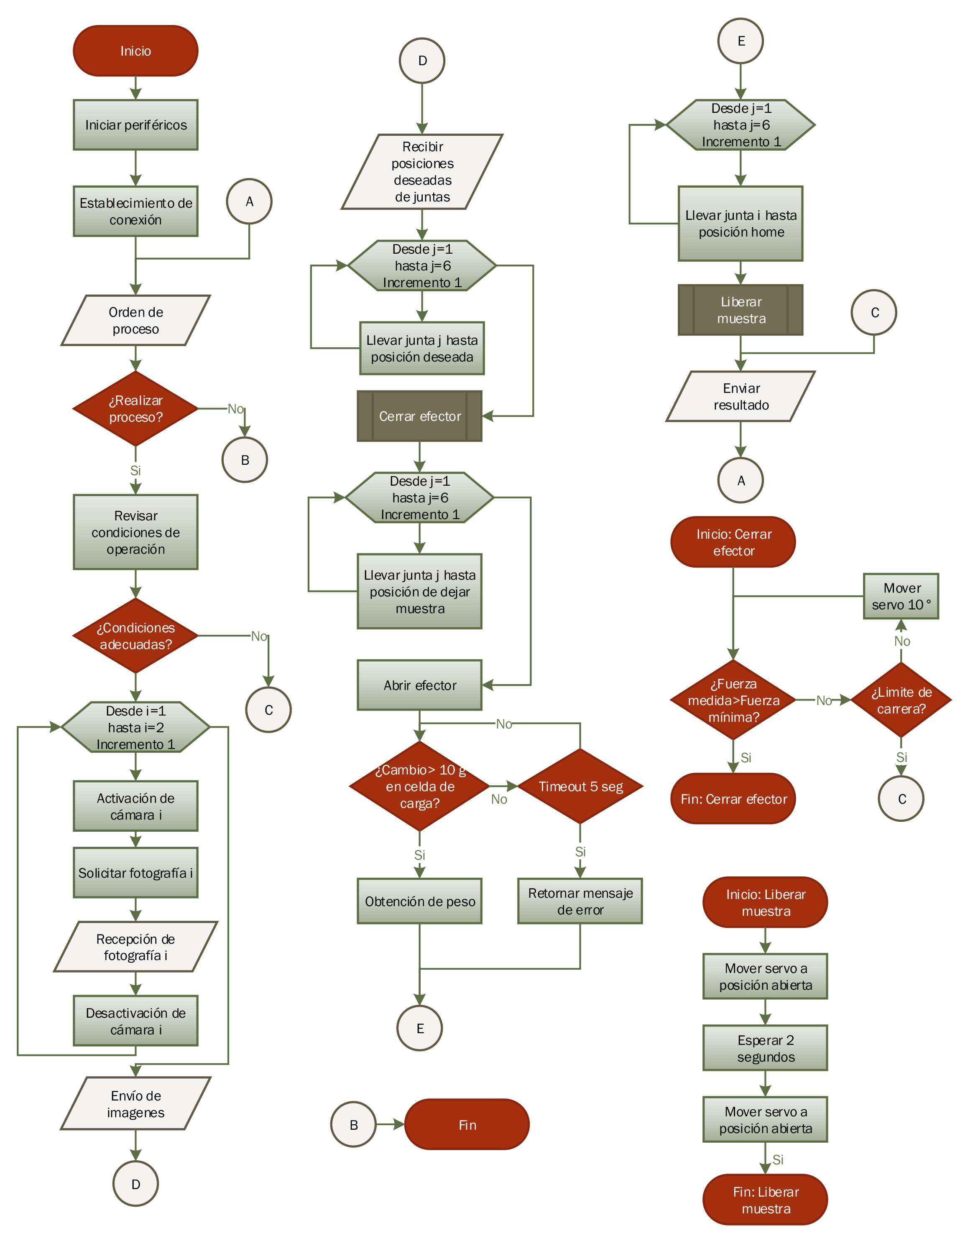
imagenes/INTEGRACION/DiagramasDeFlujo_Micro.png
