EduardoSBarreraR/Trabajo_Terminal_2/imagenes/INTEGRACION/DiagramasDeFlujo_PC.png

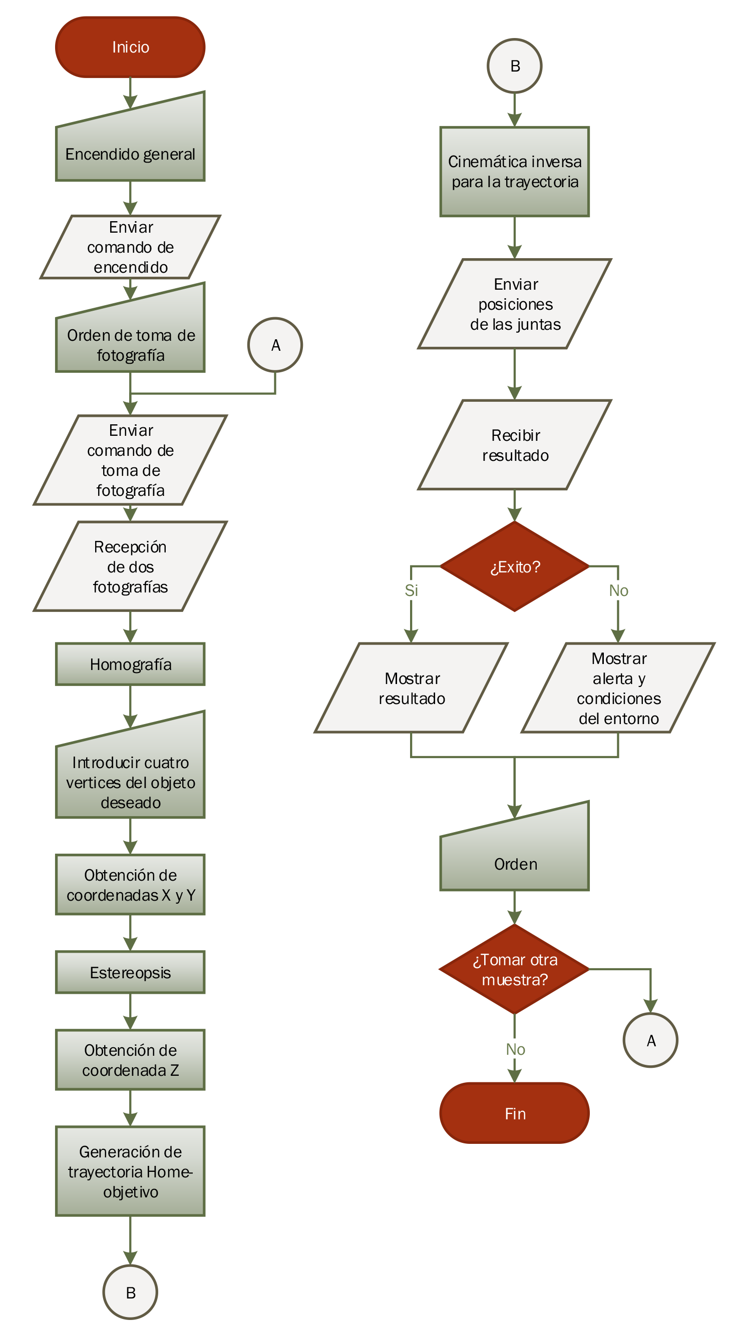
imagenes/INTEGRACION/DiagramasDeFlujo_PC.png
