EduardoSBarreraR/Trabajo_Terminal_2/imagenes/INTEGRACION/Energetico.png

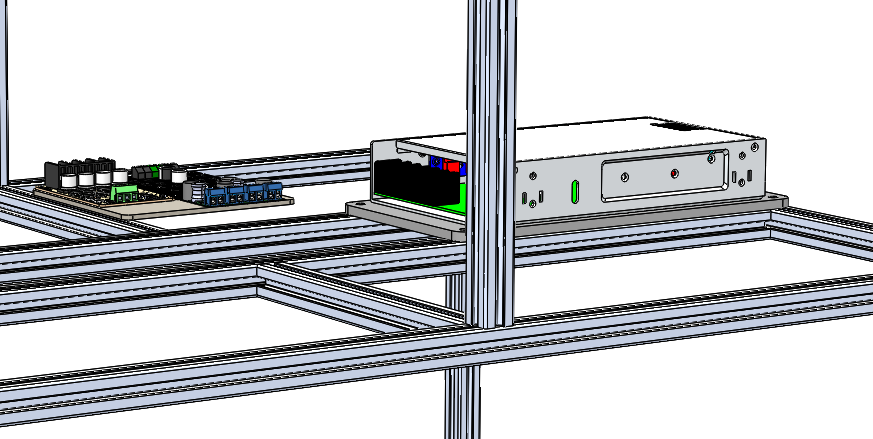
imagenes/INTEGRACION/Energetico.png
