EduardoSBarreraR/Trabajo_Terminal_2/imagenes/INTEGRACION/Energetico_Informacion.png

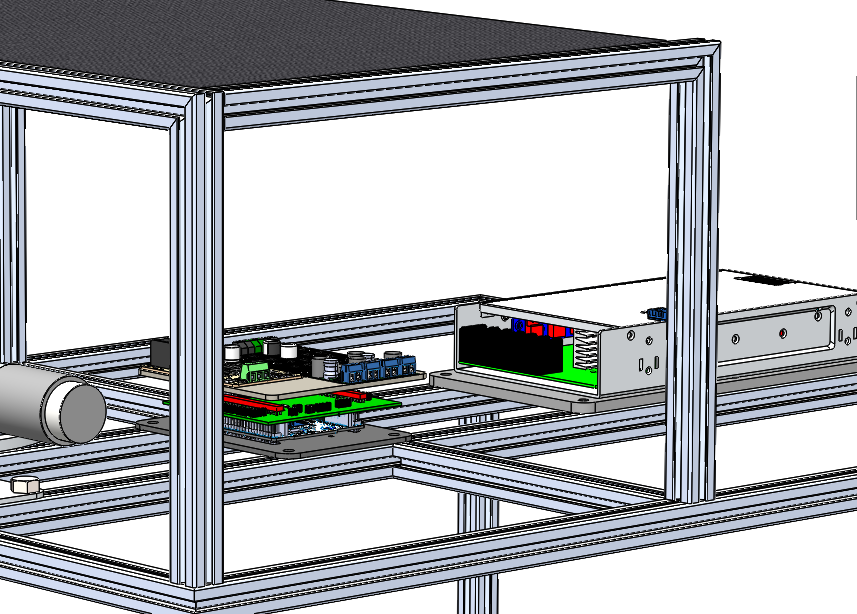
imagenes/INTEGRACION/Energetico_Informacion.png
