EduardoSBarreraR/Trabajo_Terminal_2/imagenes/INTEGRACION/Estructura_modificada.png

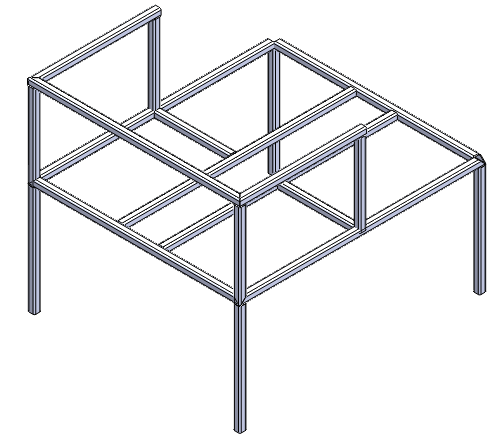
imagenes/INTEGRACION/Estructura_modificada.png
