EduardoSBarreraR/Trabajo_Terminal_2/imagenes/INTEGRACION/Fuente.png

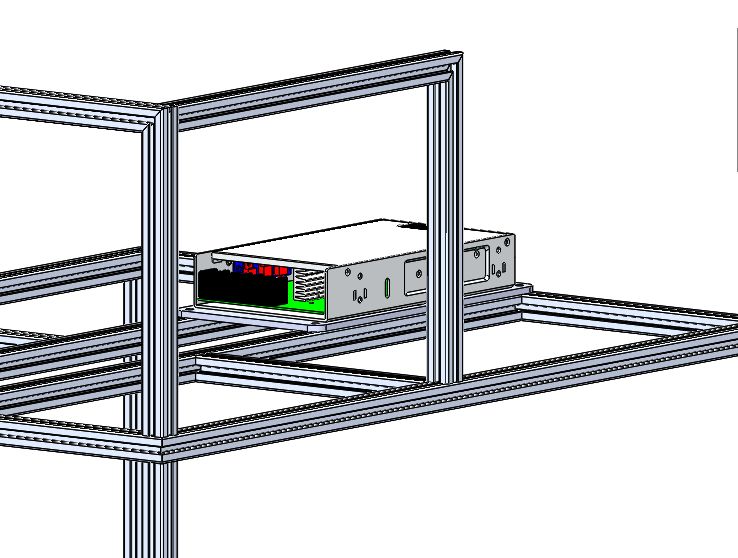
imagenes/INTEGRACION/Fuente.png
