EduardoSBarreraR/Trabajo_Terminal_2/imagenes/INTEGRACION/IntegracionMunecaEfector.png

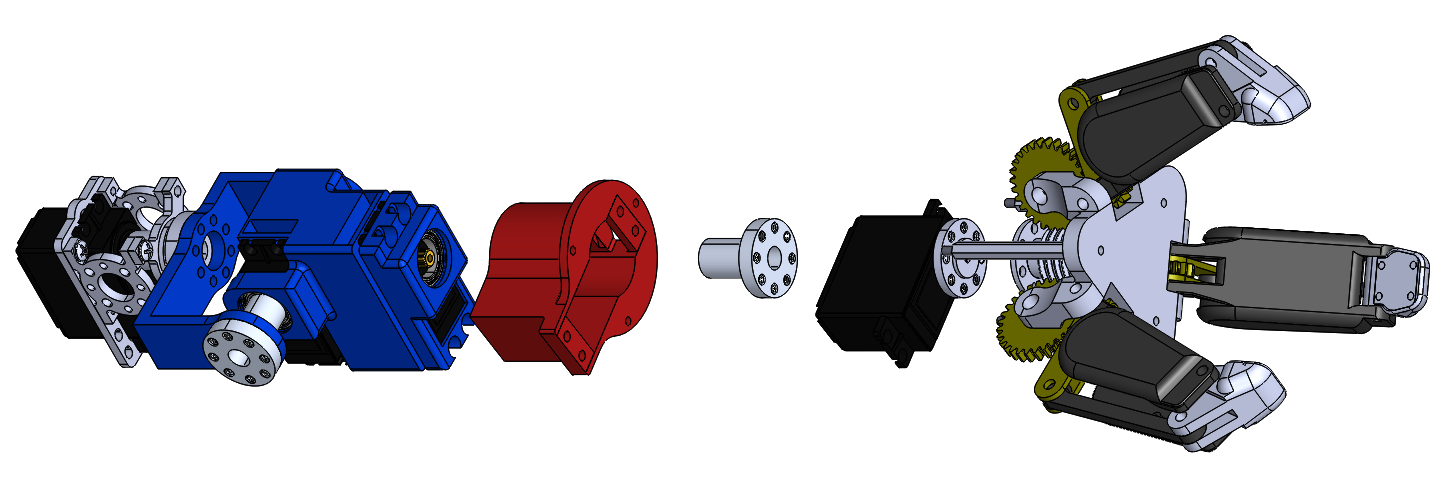
imagenes/INTEGRACION/IntegracionMunecaEfector.png
