EduardoSBarreraR/Trabajo_Terminal_2/imagenes/INTEGRACION/Laboratorio.png

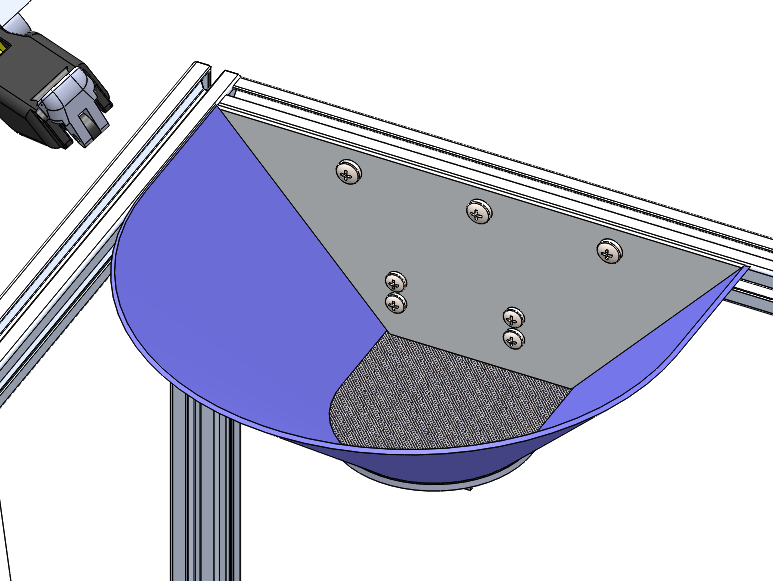
imagenes/INTEGRACION/Laboratorio.png
