EduardoSBarreraR/Trabajo_Terminal_2/imagenes/INTEGRACION/Placa2_EsquematicoPNG.png

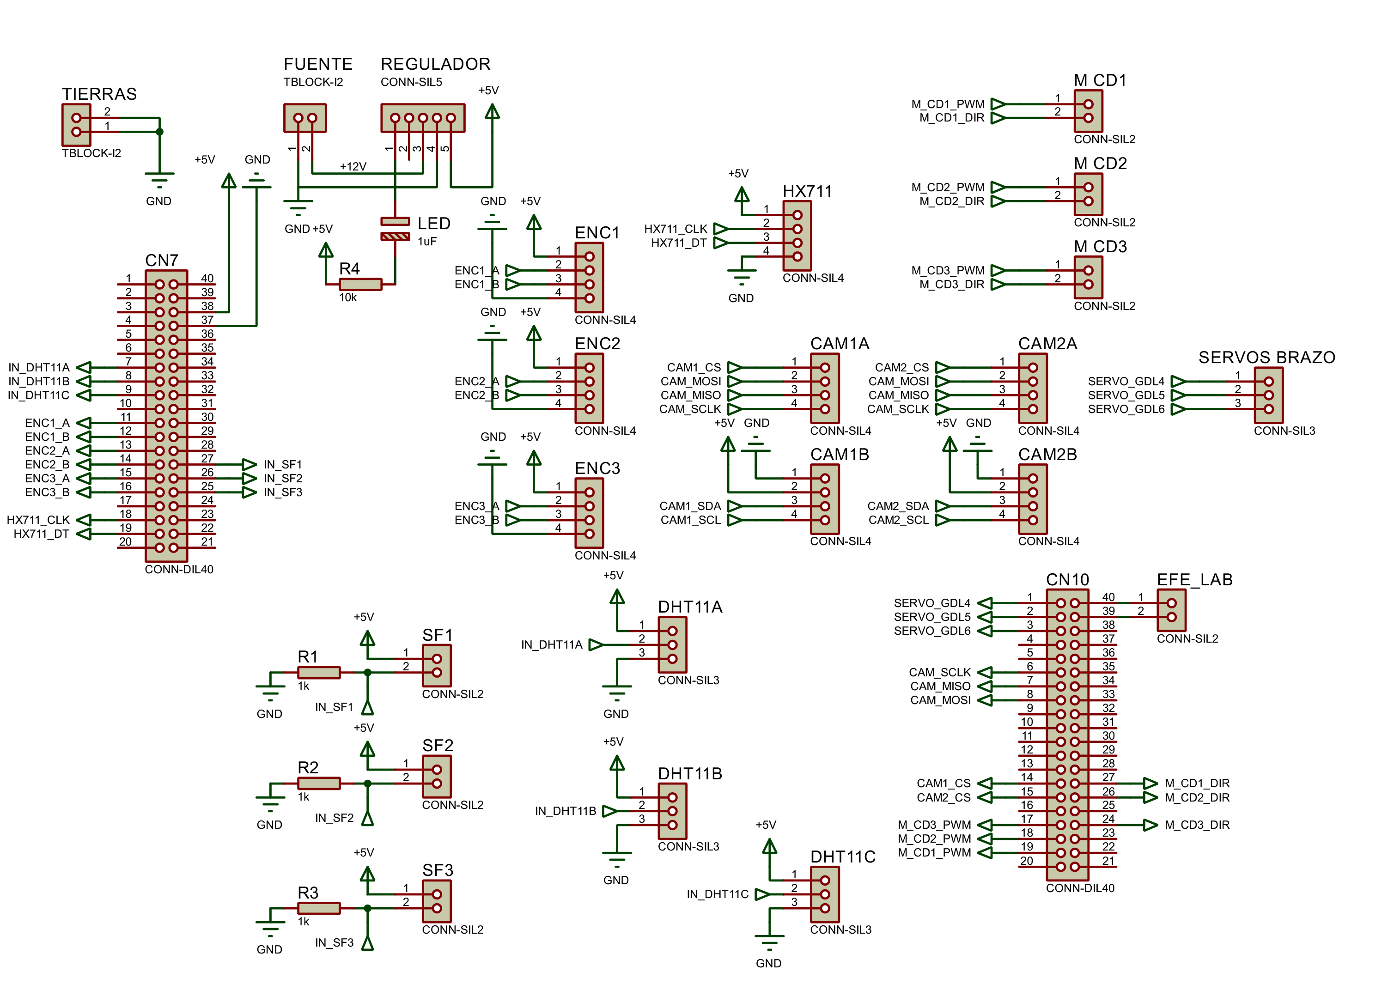
imagenes/INTEGRACION/Placa2_EsquematicoPNG.png
