EduardoSBarreraR/Trabajo_Terminal_2/imagenes/INTEGRACION/Placa_nucleo_acondicionamiento.png

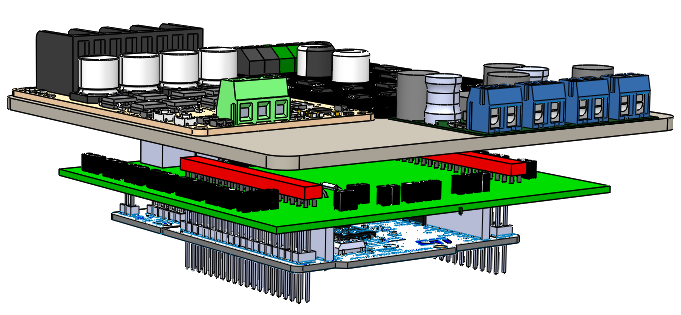
imagenes/INTEGRACION/Placa_nucleo_acondicionamiento.png
