EduardoSBarreraR/Trabajo_Terminal_2/imagenes/INTEGRACION/Placa_superficie_energia.png

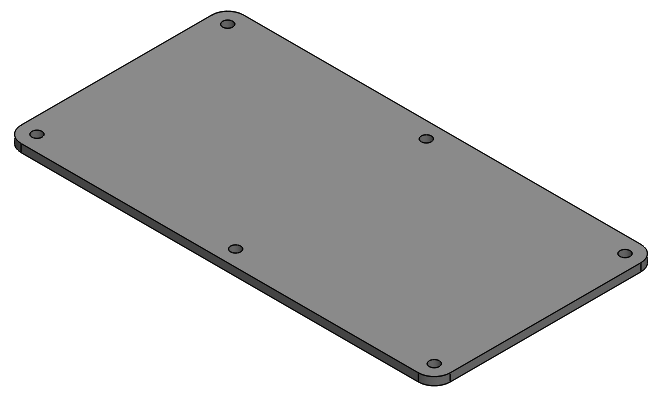
imagenes/INTEGRACION/Placa_superficie_energia.png
