EduardoSBarreraR/Trabajo_Terminal_2/imagenes/INTEGRACION/Placa_superficie_informacion.png

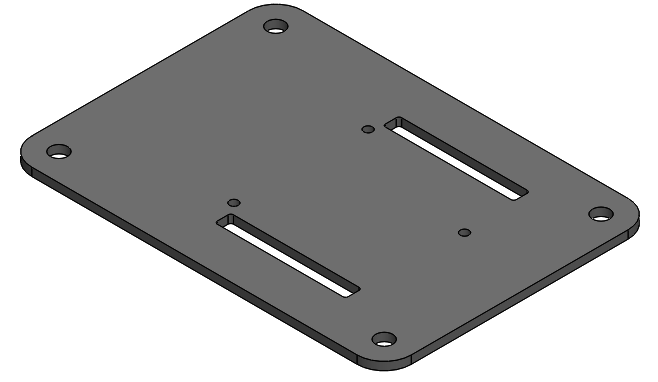
imagenes/INTEGRACION/Placa_superficie_informacion.png
