EduardoSBarreraR/Trabajo_Terminal_2/imagenes/INTEGRACION/Plaka.png

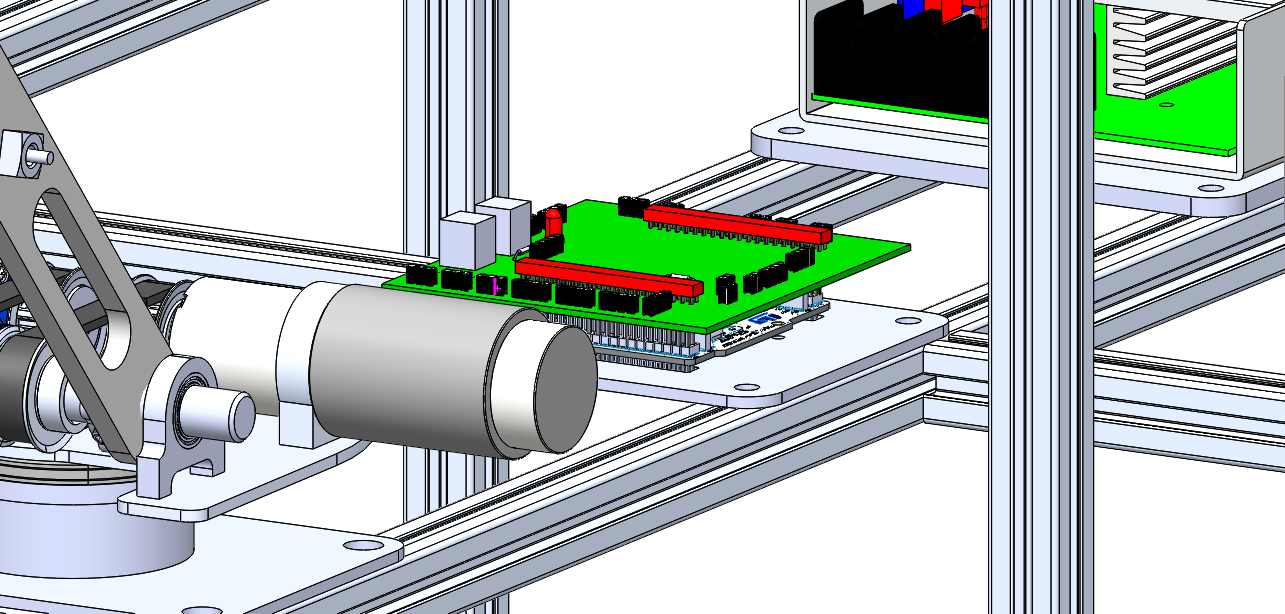
imagenes/INTEGRACION/Plaka.png
