EduardoSBarreraR/Trabajo_Terminal_2/imagenes/INTEGRACION/plakaynucleo.png

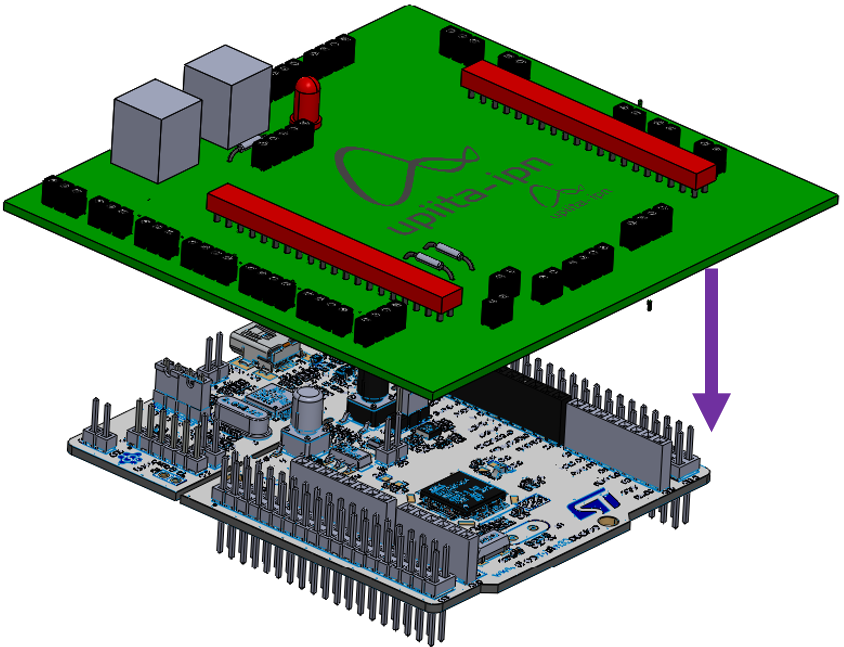
imagenes/INTEGRACION/plakaynucleo.png
