EduardoSBarreraR/Trabajo_Terminal_2/imagenes/INTEGRACION/Posicion_Home.png

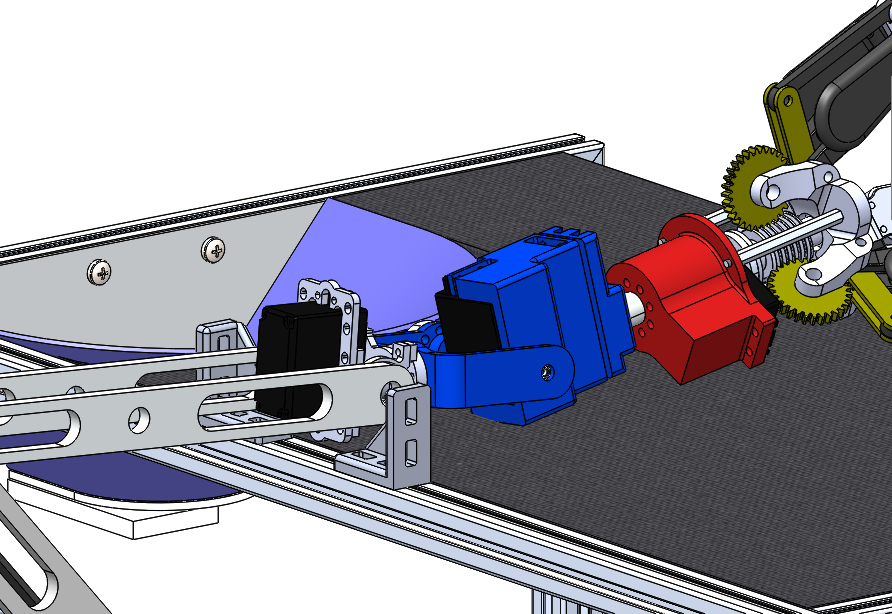
imagenes/INTEGRACION/Posicion_Home.png
