EduardoSBarreraR/Trabajo_Terminal_2/imagenes/INTEGRACION/Posicion_Home_2.png

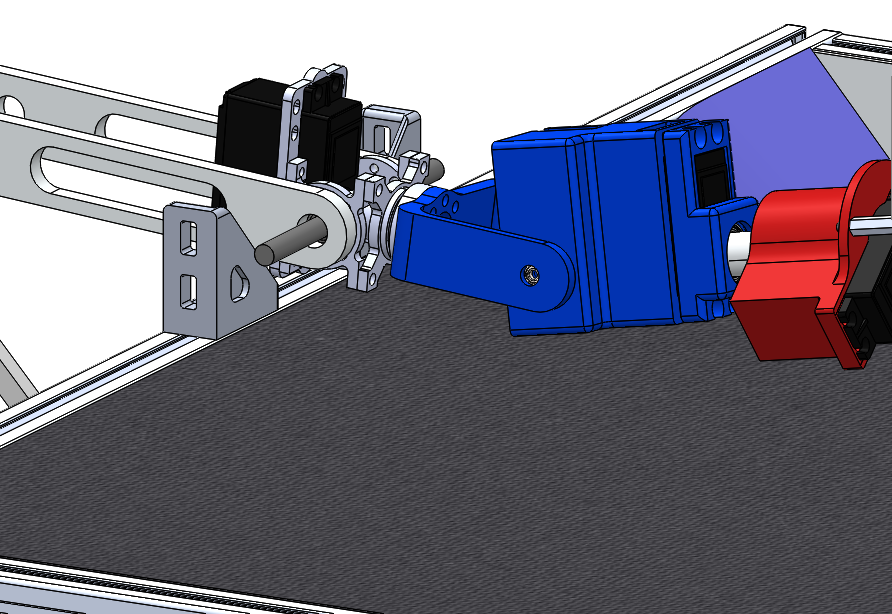
imagenes/INTEGRACION/Posicion_Home_2.png
