EduardoSBarreraR/Trabajo_Terminal_2/imagenes/INTEGRACION/PosicionHome3.png

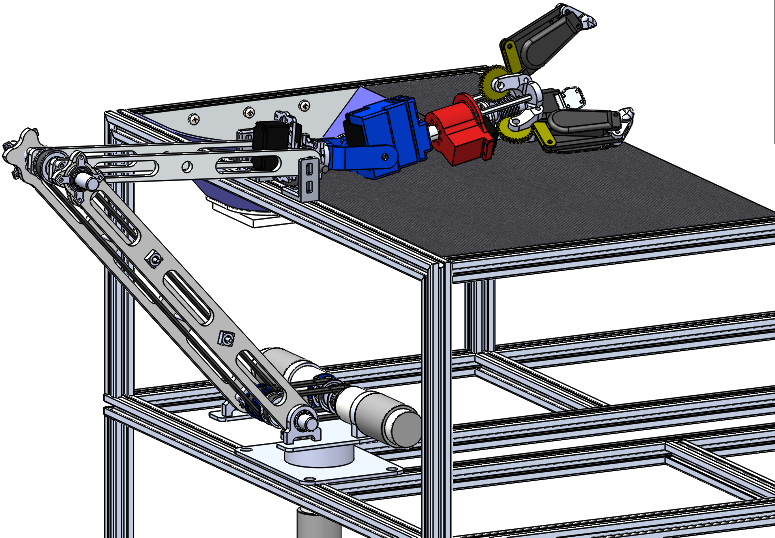
imagenes/INTEGRACION/PosicionHome3.png
