EduardoSBarreraR/Trabajo_Terminal_2/imagenes/INTEGRACION/robotico-estructura.png

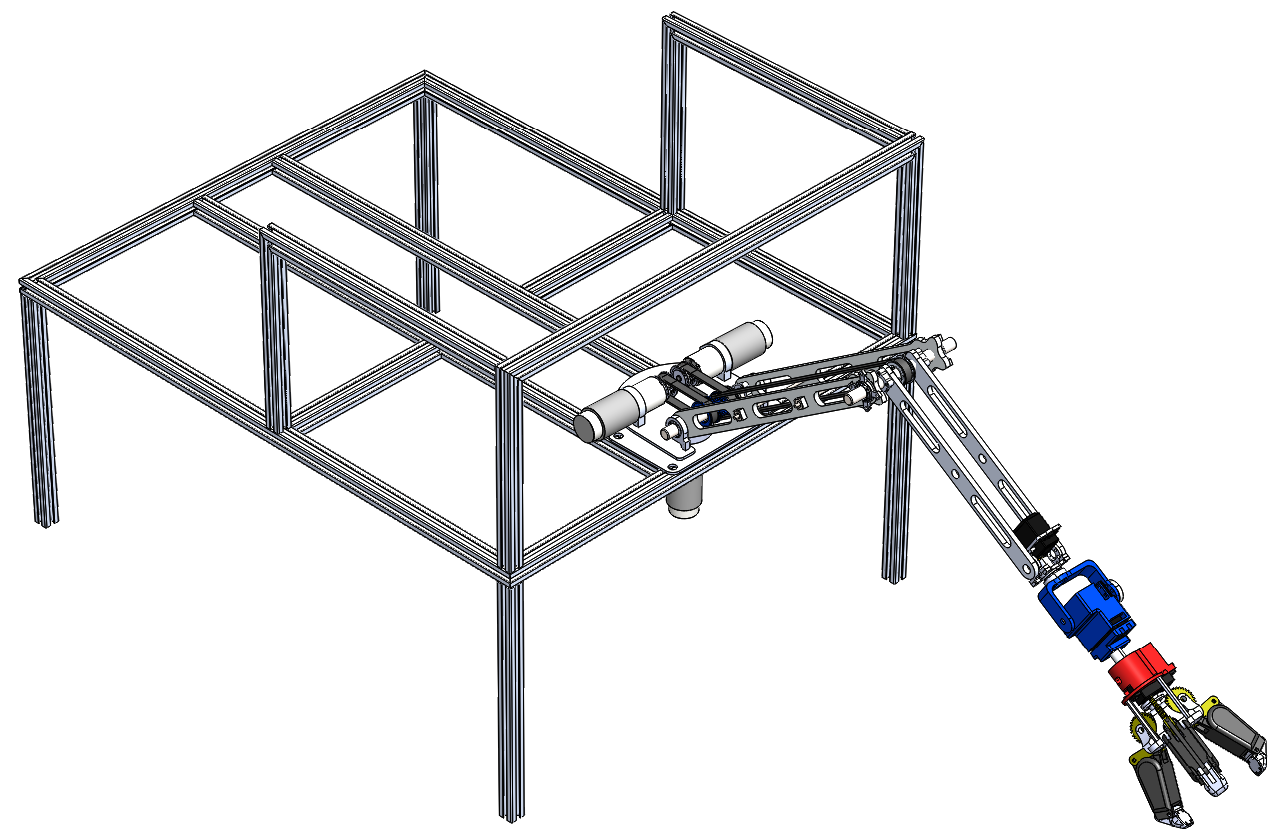
imagenes/INTEGRACION/robotico-estructura.png
