EduardoSBarreraR/Trabajo_Terminal_2/imagenes/INTEGRACION/SensoresTemp.png

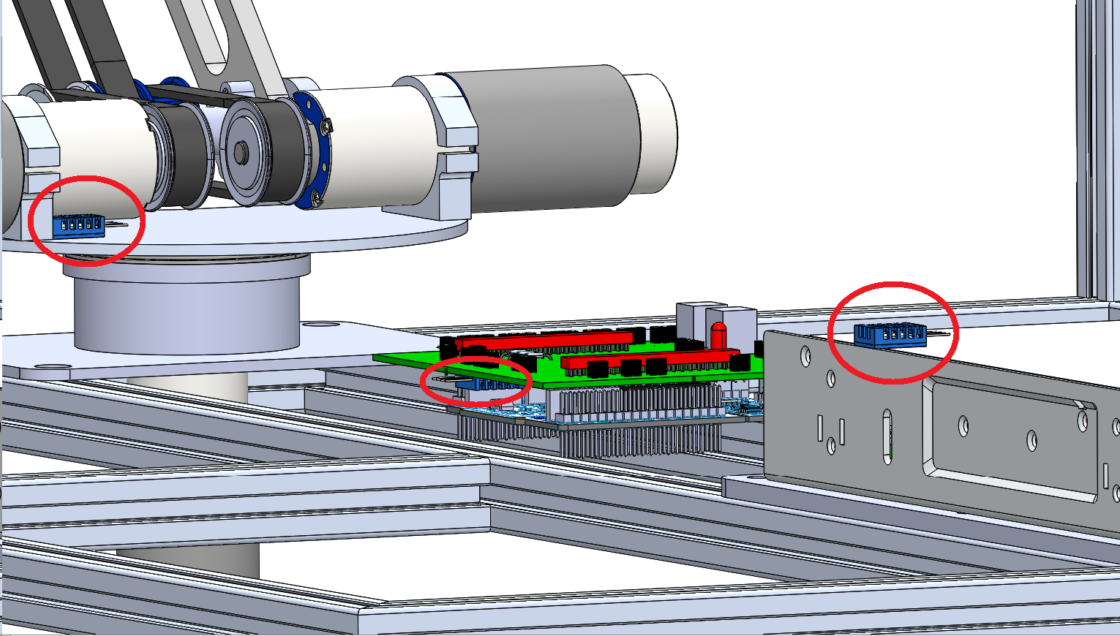
imagenes/INTEGRACION/SensoresTemp.png
