EduardoSBarreraR/Trabajo_Terminal_2/imagenes/INTEGRACION/Untitled.JPG

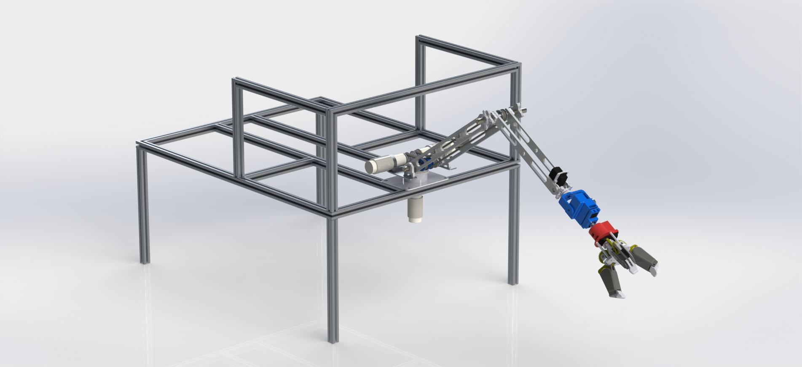
imagenes/INTEGRACION/Untitled.JPG
