EduardoSBarreraR/Trabajo_Terminal_2/imagenes/INTEGRACION/Validaciones/Estructura_modificada_AnalisisAxialYflexion xd.png

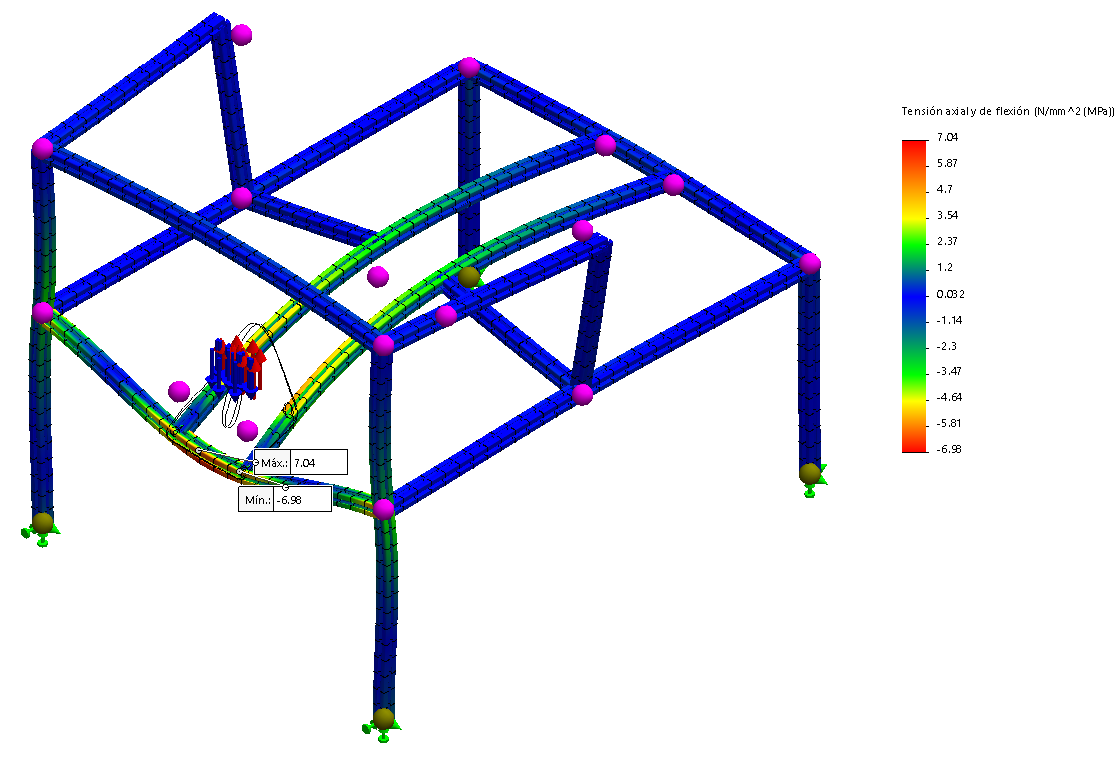
imagenes/INTEGRACION/Validaciones/Estructura_modificada_AnalisisAxialYflexion xd.png
