EduardoSBarreraR/Trabajo_Terminal_2/imagenes/INTEGRACION/Validaciones/Estructura_modificada_deformacion.png

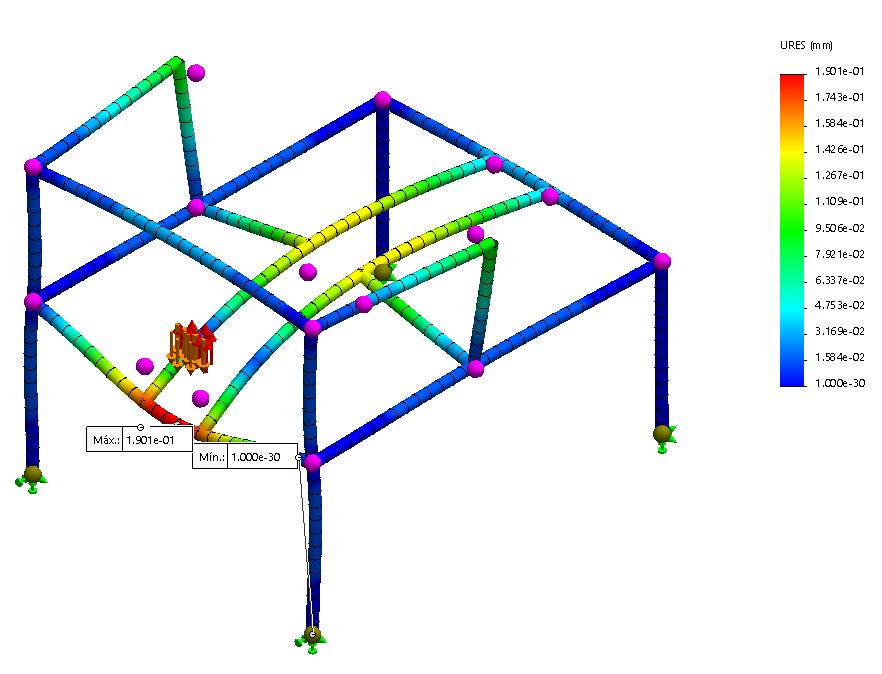
imagenes/INTEGRACION/Validaciones/Estructura_modificada_deformacion.png
