EduardoSBarreraR/Trabajo_Terminal_2/imagenes/INTEGRACION/Validaciones/Estructura_modificada_SujecionesYFuerzas.png

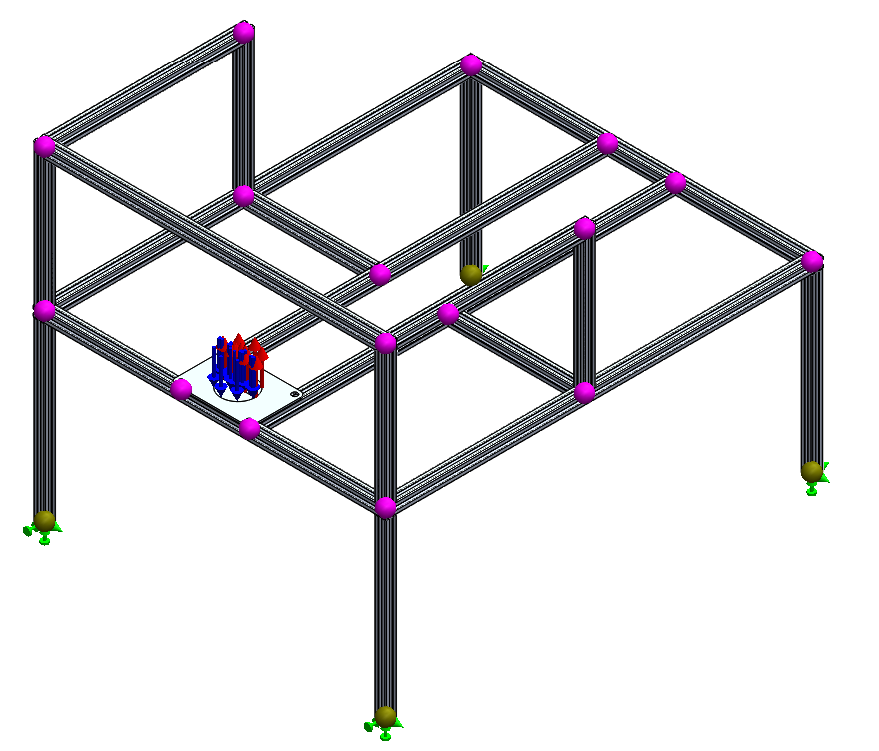
imagenes/INTEGRACION/Validaciones/Estructura_modificada_SujecionesYFuerzas.png
