EduardoSBarreraR/Trabajo_Terminal_2/imagenes/INTEGRACION/Validaciones/Mallado xd.png

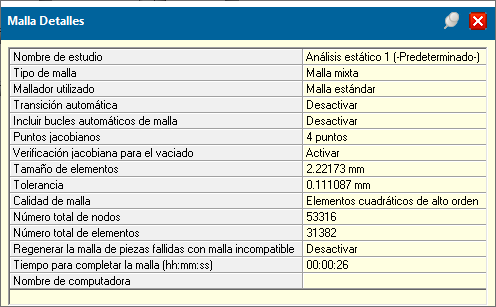
imagenes/INTEGRACION/Validaciones/Mallado xd.png
