EduardoSBarreraR/Trabajo_Terminal_2/imagenes/INTEGRACION/Validaciones/V_Laboratorio.png

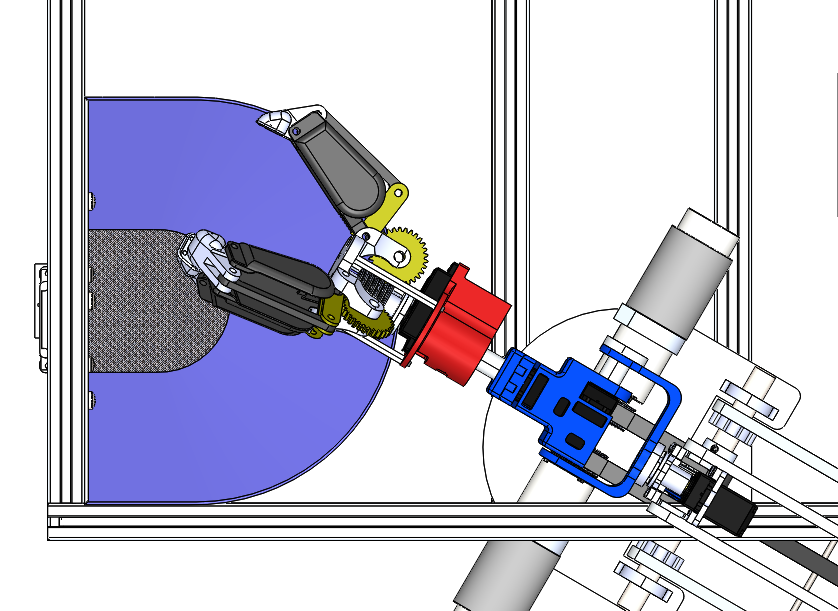
imagenes/INTEGRACION/Validaciones/V_Laboratorio.png
