EduardoSBarreraR/Trabajo_Terminal_2/imagenes/INTEGRACION/Workspace.png

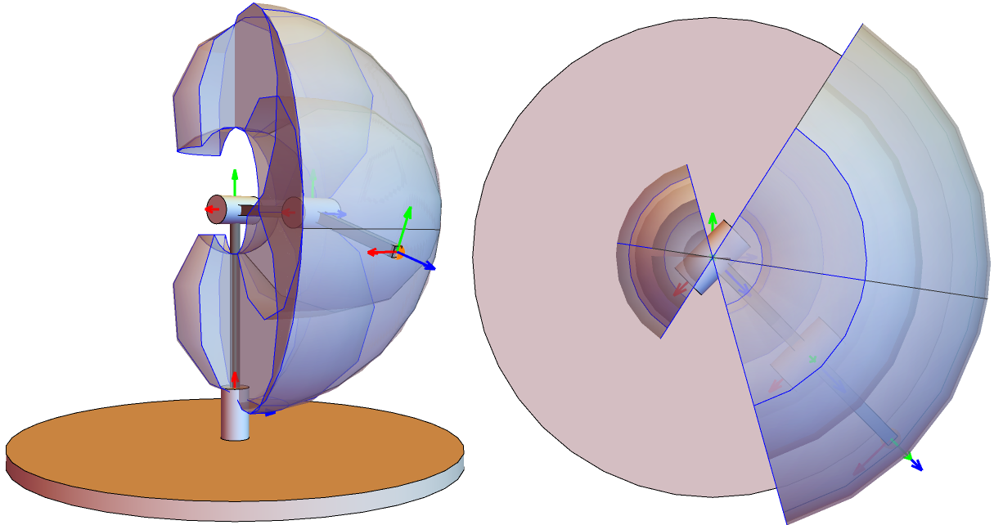
imagenes/INTEGRACION/Workspace.png
