EduardoSBarreraR/Trabajo_Terminal_2/imagenes/Marco Teorico/comparacionNuestraDona.jpg

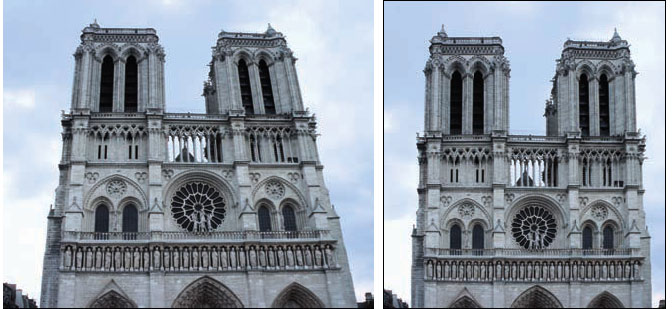
imagenes/Marco Teorico/comparacionNuestraDona.jpg
