EduardoSBarreraR/Trabajo_Terminal_2/imagenes/Marco Teorico/Esfericidad.png

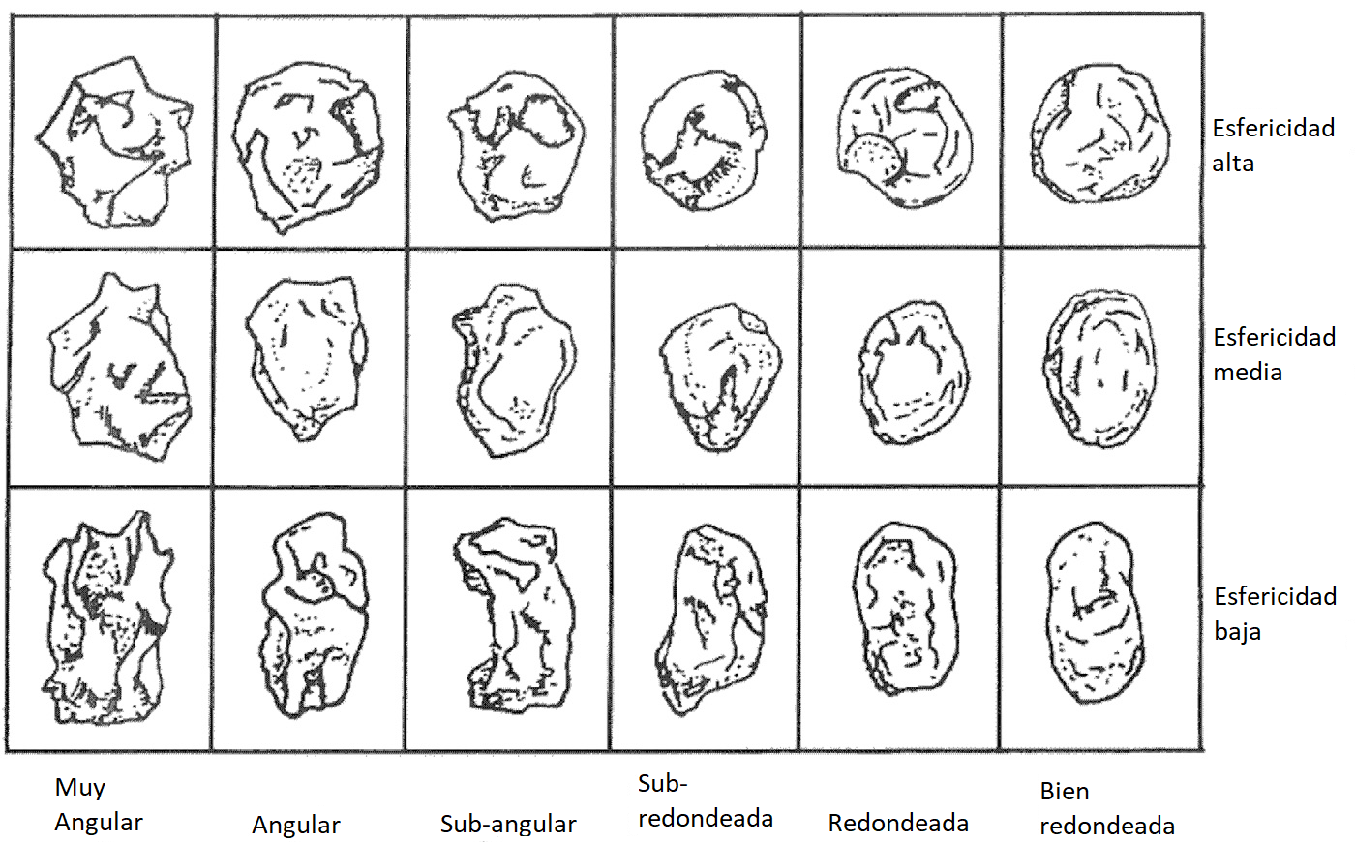
imagenes/Marco Teorico/Esfericidad.png
