EduardoSBarreraR/Trabajo_Terminal_2/imagenes/Marco Teorico/Lunokhod_1.jpg

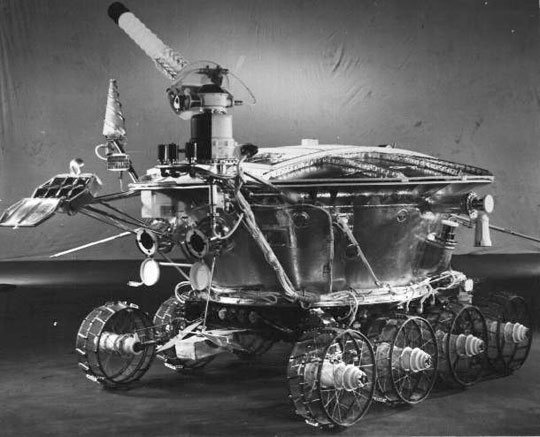
imagenes/Marco Teorico/Lunokhod_1.jpg
