EduardoSBarreraR/Trabajo_Terminal_2/imagenes/Marco Teorico/Perseverance.jpg

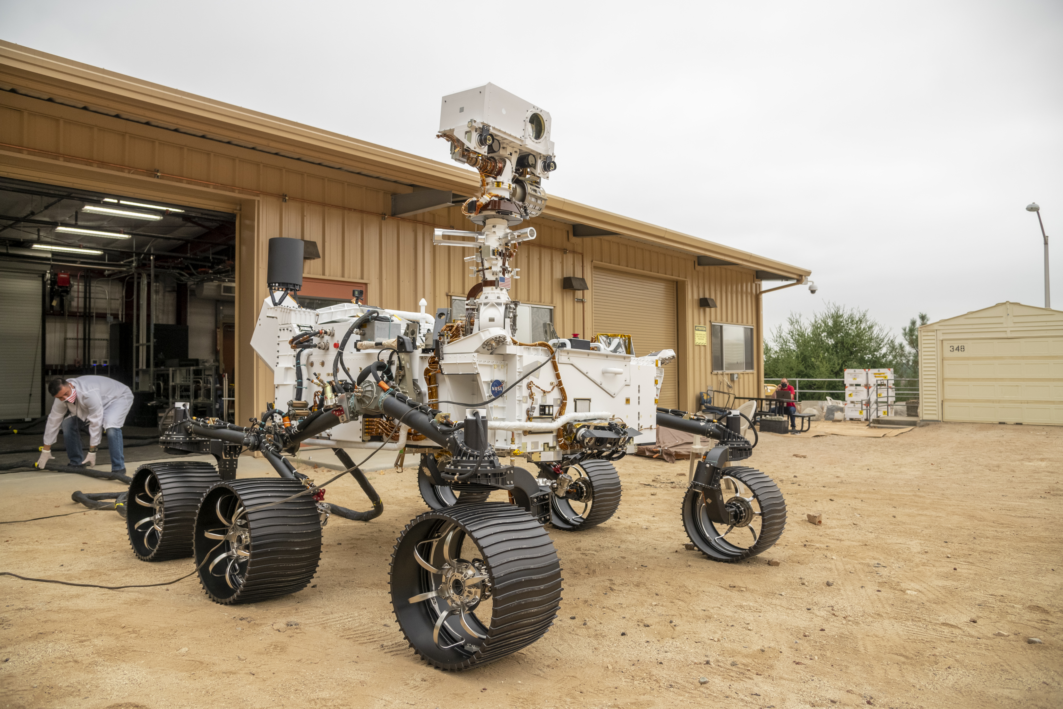
imagenes/Marco Teorico/Perseverance.jpg
