EduardoSBarreraR/Trabajo_Terminal_2/imagenes/Marco Teorico/Robo1.png

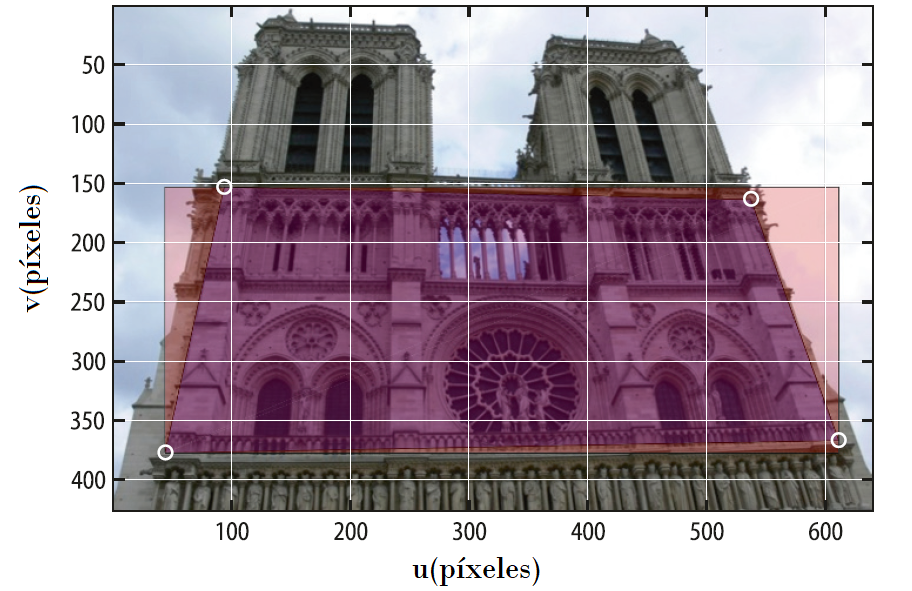
imagenes/Marco Teorico/Robo1.png
