EduardoSBarreraR/Trabajo_Terminal_2/imagenes/Marco Teorico/Robo2.png

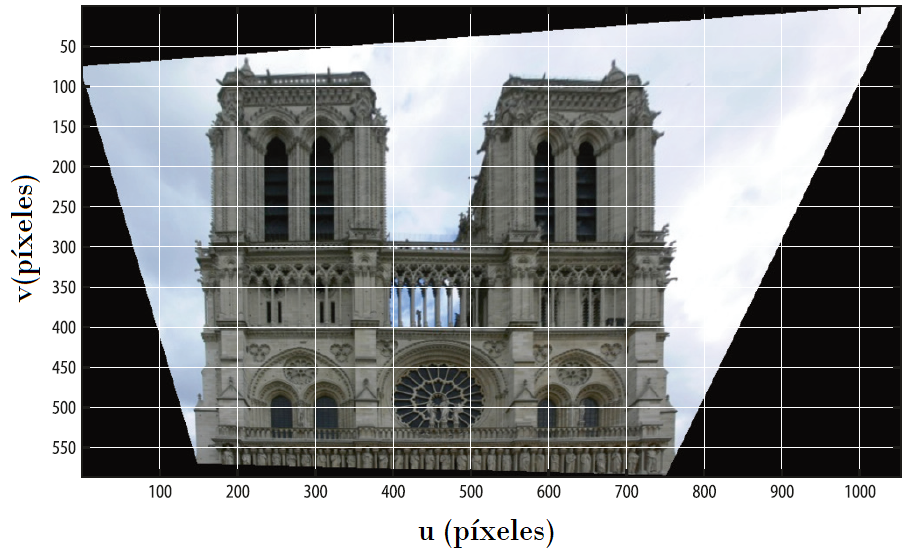
imagenes/Marco Teorico/Robo2.png
