EduardoSBarreraR/Trabajo_Terminal_2/imagenes/MecanismoGripper.PNG

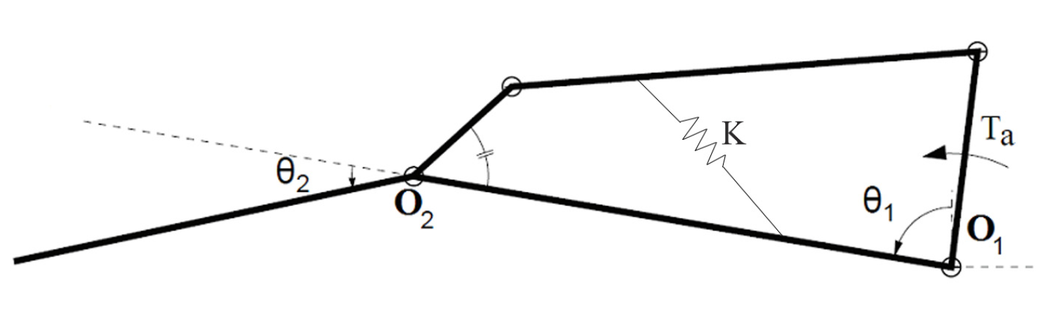
imagenes/MecanismoGripper.PNG
