EduardoSBarreraR/Trabajo_Terminal_2/imagenes/Pendiente.png

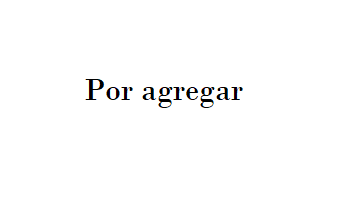
imagenes/Pendiente.png
