EduardoSBarreraR/Trabajo_Terminal_2/imagenes/PoleaLoca.png

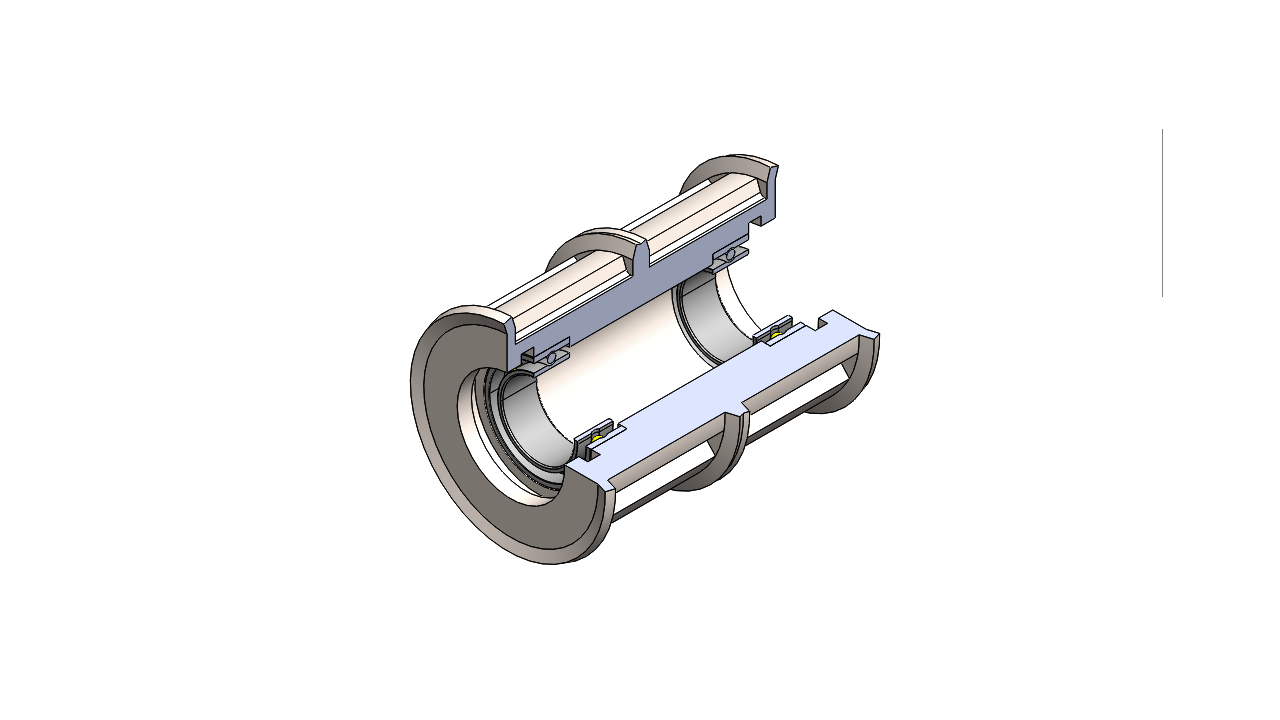
imagenes/PoleaLoca.png
