EduardoSBarreraR/Trabajo_Terminal_2/imagenes/render sistema 2.JPG

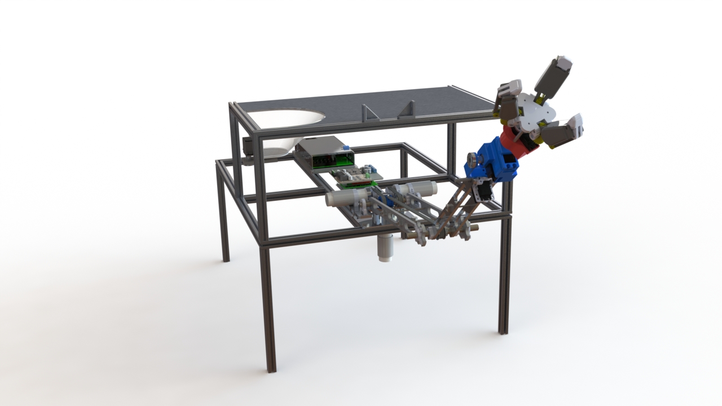
imagenes/render sistema 2.JPG
