EduardoSBarreraR/Trabajo_Terminal_2/imagenes/render sistema 4.jpg

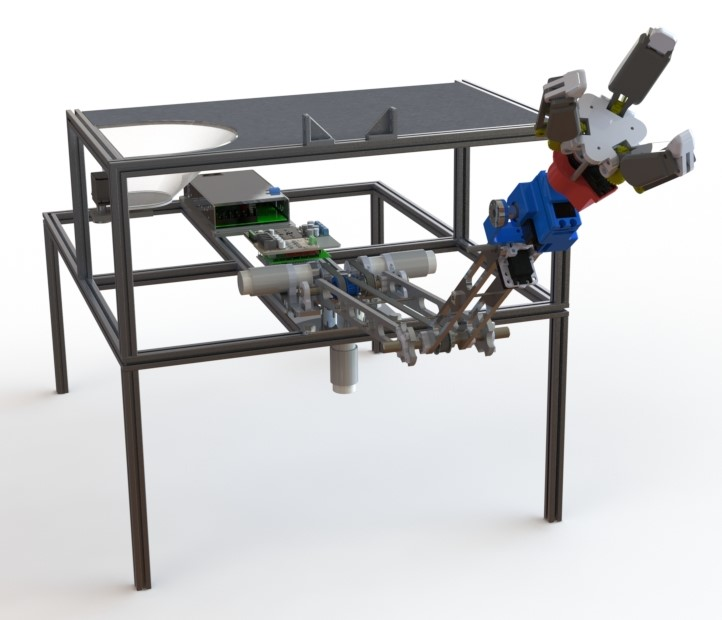
imagenes/render sistema 4.jpg
