EduardoSBarreraR/Trabajo_Terminal_2/imagenes/render sistema.JPG

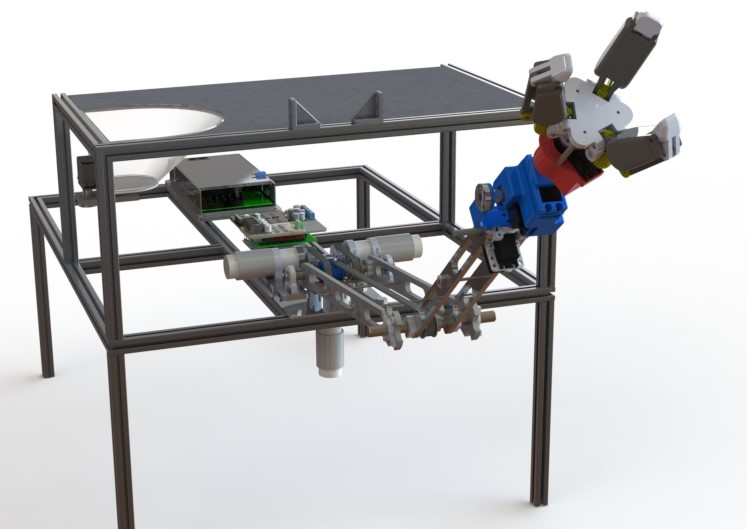
imagenes/render sistema.JPG
