EduardoSBarreraR/Trabajo_Terminal_2/imagenes/Render transsmission.JPG

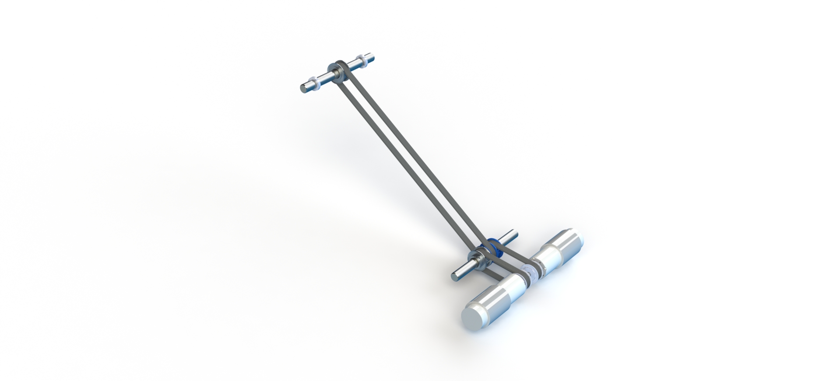
imagenes/Render transsmission.JPG
