EduardoSBarreraR/Trabajo_Terminal_2/imagenes/SecuenciaGripper.PNG

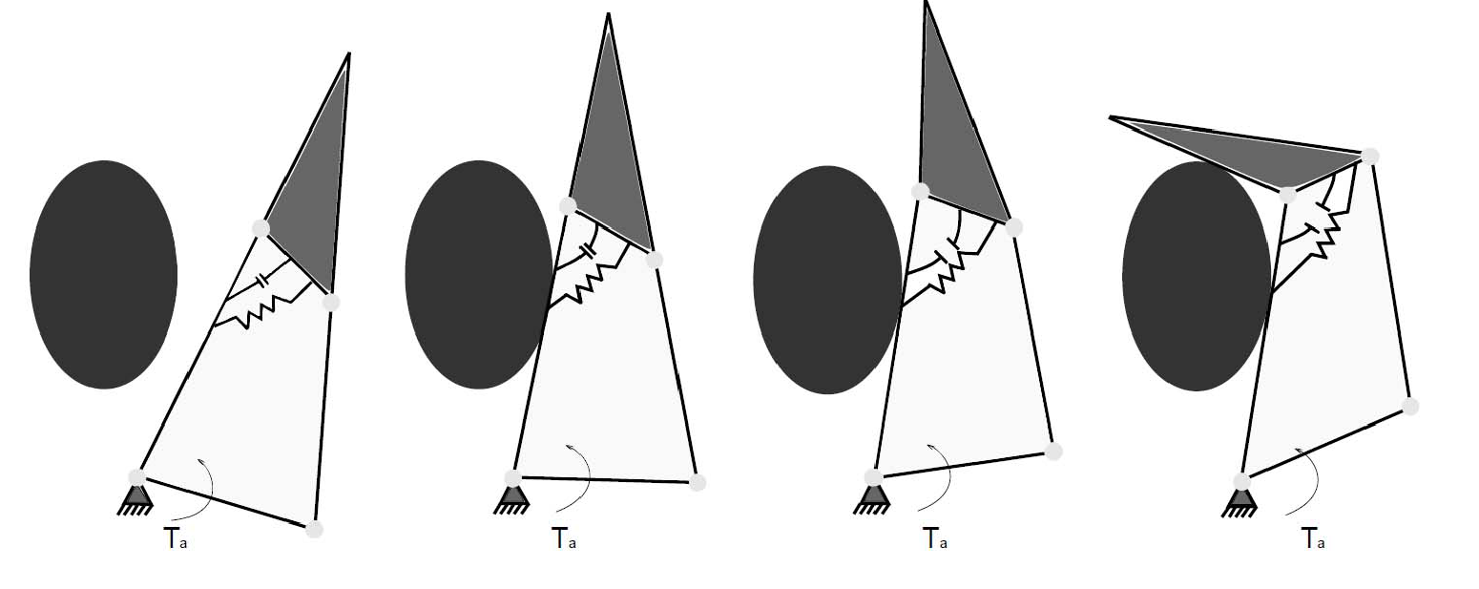
imagenes/SecuenciaGripper.PNG
