EduardoSBarreraR/Trabajo_Terminal_2/imagenes/Sin título.png

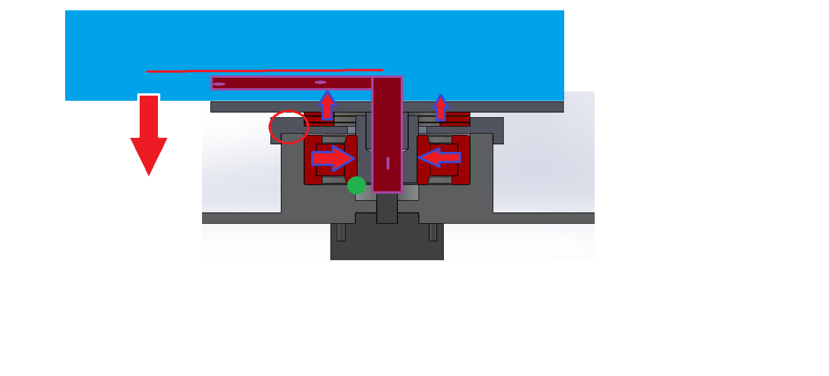
imagenes/Sin título.png
