EduardoSBarreraR/Trabajo_Terminal_2/imagenes/UnionEslabon12.png

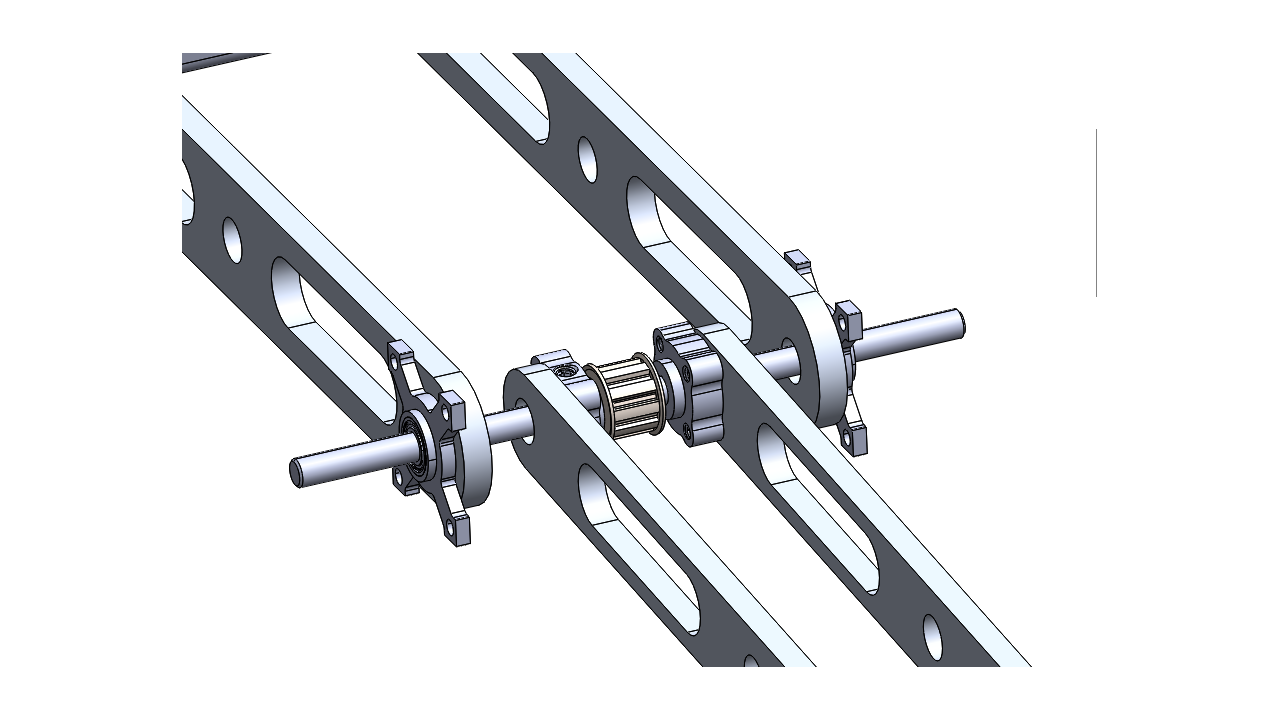
imagenes/UnionEslabon12.png
