EduardoSBarreraR/Trabajo_Terminal_2/imagenes/VDI2206-2.png

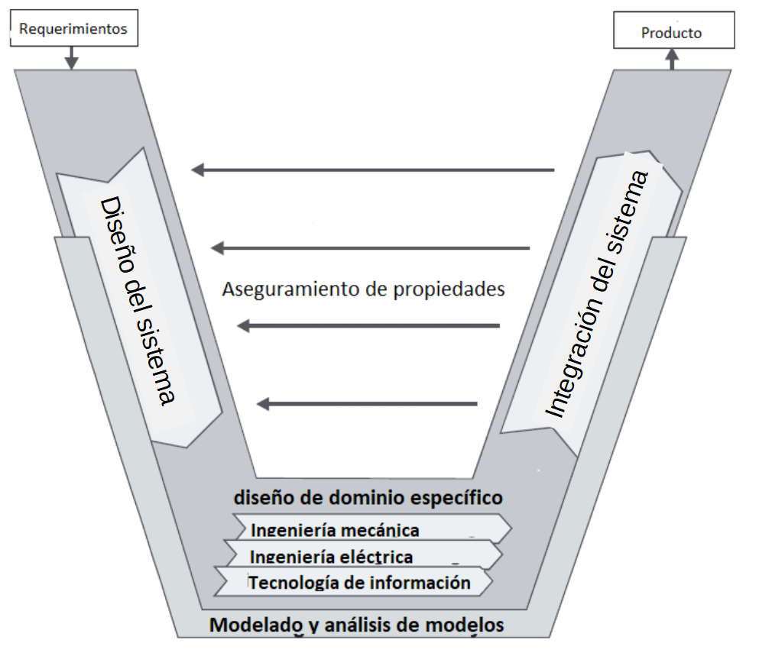
imagenes/VDI2206-2.png
