EduardoSBarreraR/Trabajo_Terminal_2/imagenes/VDI2206.png

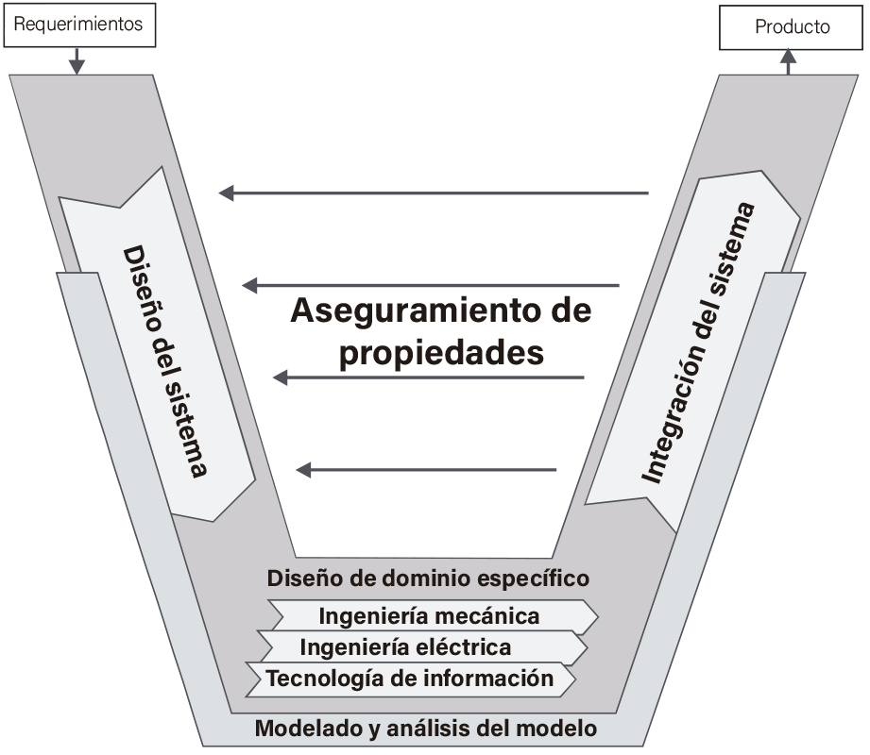
imagenes/VDI2206.png
