EduardoSBarreraR/Trabajo_Terminal_2/imagenes/Dominio especifico/Estructura/8020-20-2020-20-2020 X 720mm.SLDPRT

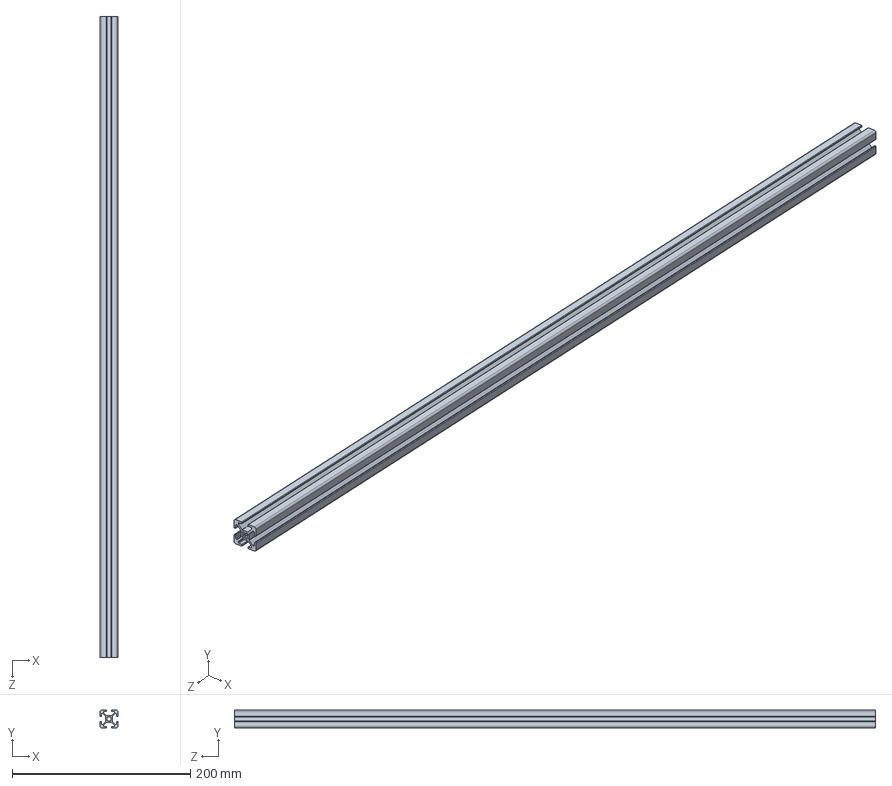
[picture p265: CAD file, 2020-08-06]
imagenes/Dominio especifico/Estructura/8020-20-2020-20-2020 X 720mm.SLDPRT
20.0 x 20.0 x 720.0 mm
