EduardoSBarreraR/Trabajo_Terminal_2/imagenes/Dominio especifico/Estructura/8020-20-2020-20-2020 X 220mm.SLDPRT

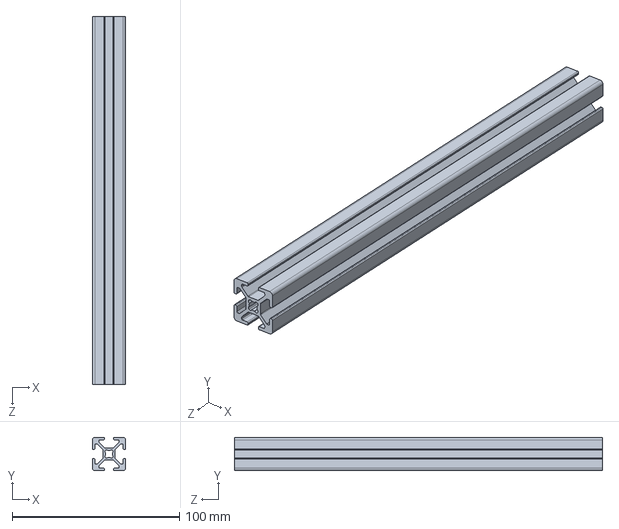
[picture p266: CAD file, 2020-08-06]
imagenes/Dominio especifico/Estructura/8020-20-2020-20-2020 X 220mm.SLDPRT
20.0 x 20.0 x 220.0 mm
