EduardoSBarreraR/Trabajo_Terminal_2/imagenes/Dominio especifico/Estructura/8020-20-2020-20-2020 X 570mm.SLDPRT

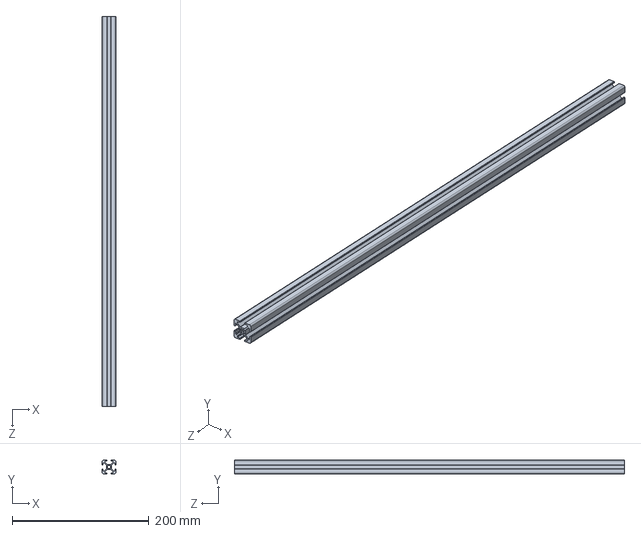
[picture p267: CAD file, 2020-08-06]
imagenes/Dominio especifico/Estructura/8020-20-2020-20-2020 X 570mm.SLDPRT
20.0 x 20.0 x 570.0 mm
