EduardoSBarreraR/Trabajo_Terminal_2/imagenes/Anexos/Cruz de cristo Montaje de Cojinete Plano Actobotics.PNG

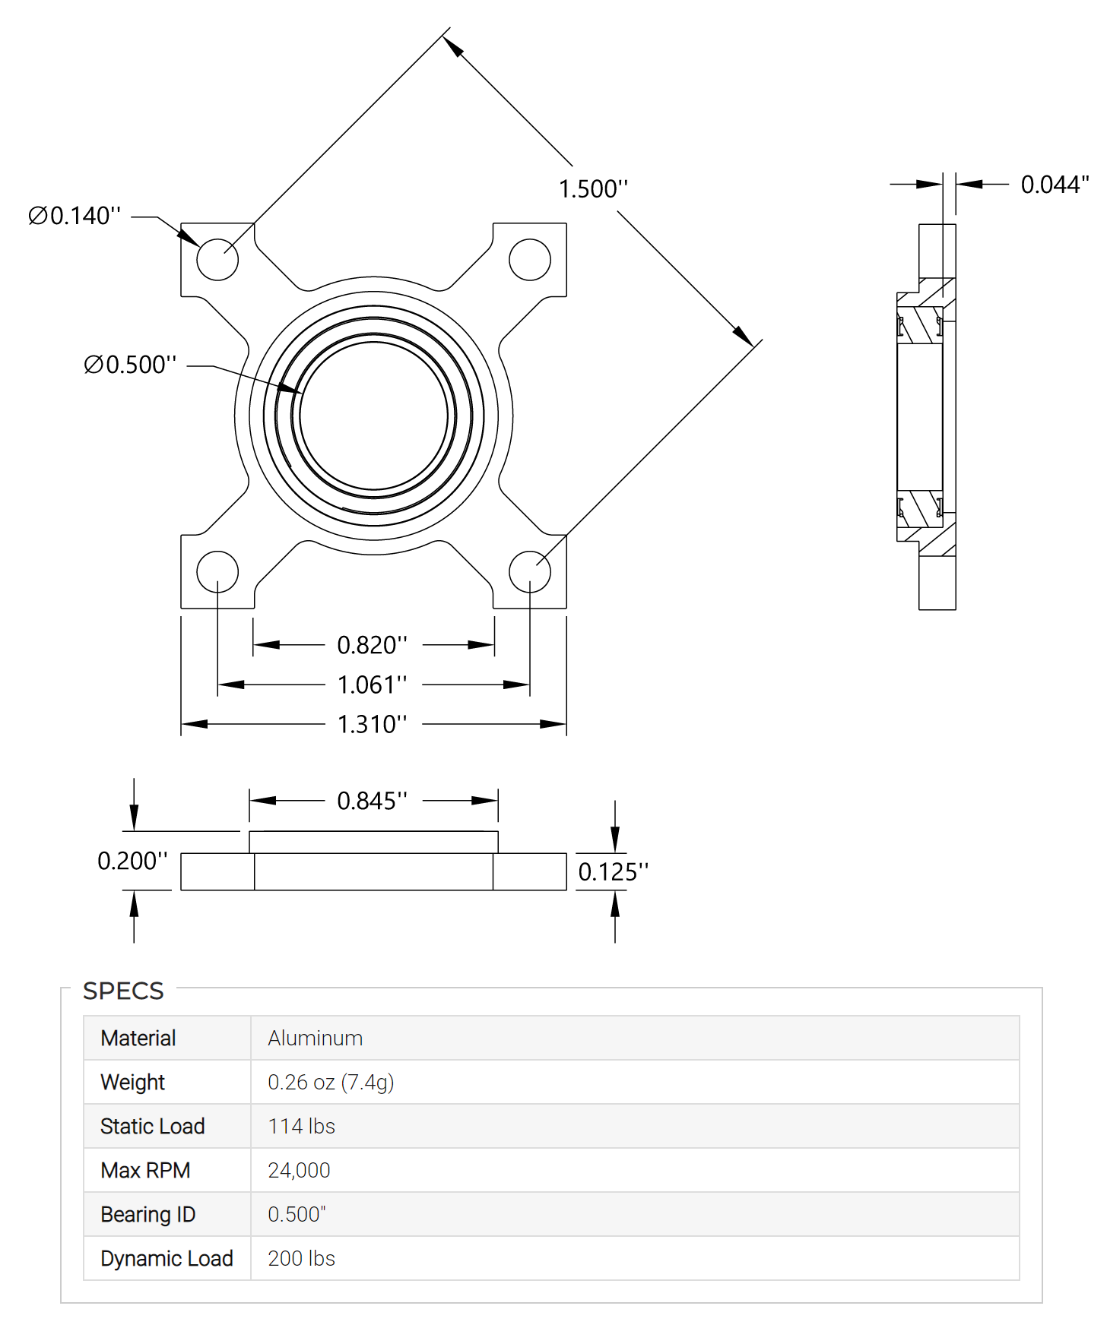
imagenes/Anexos/Cruz de cristo Montaje de Cojinete Plano Actobotics.PNG
