EduardoSBarreraR/Trabajo_Terminal_2/imagenes/Anexos/Eje de Tornillo de Fijacion de Montaje.png

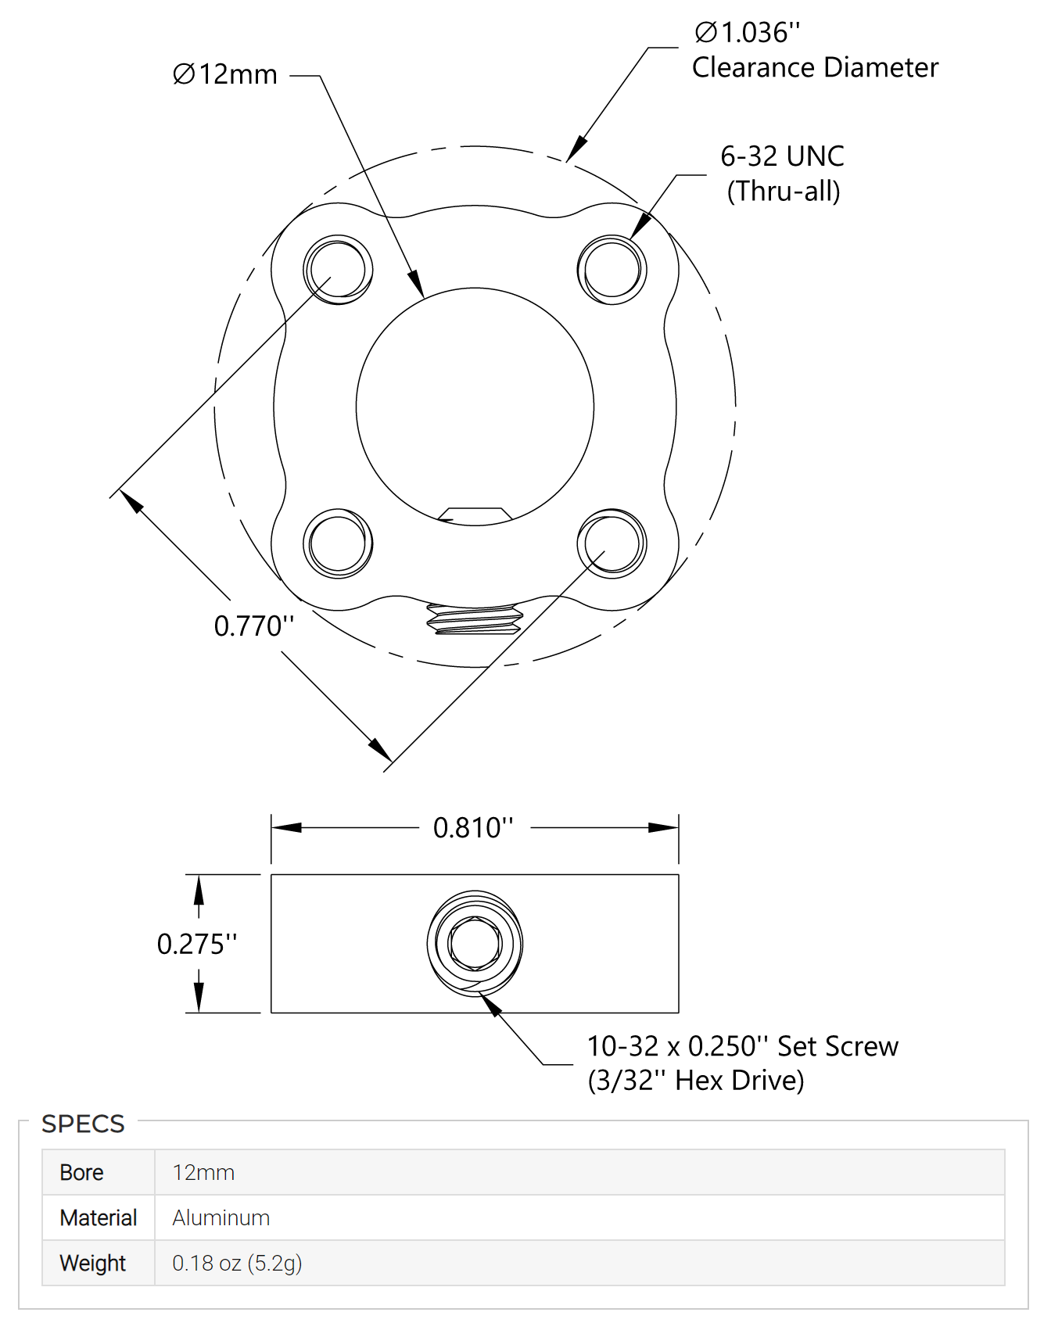
imagenes/Anexos/Eje de Tornillo de Fijacion de Montaje.png
