EduardoSBarreraR/Trabajo_Terminal_2/imagenes/Implementacion/Validaciones/Eslabones/EnsamblajeEslabon1Analisis.png

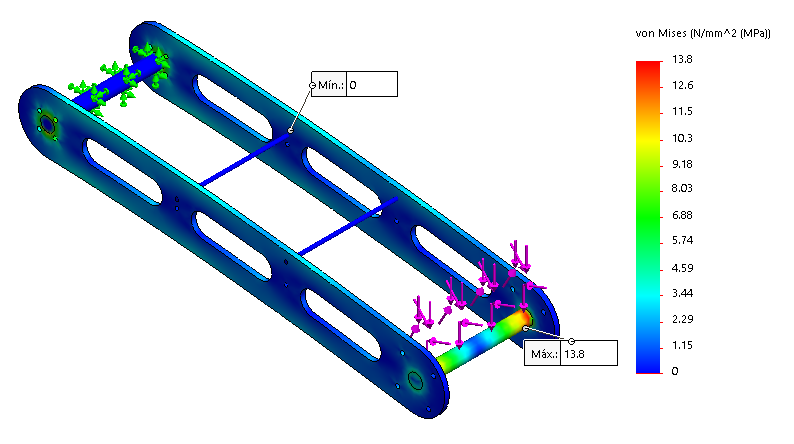
imagenes/Implementacion/Validaciones/Eslabones/EnsamblajeEslabon1Analisis.png
