EduardoSBarreraR/Trabajo_Terminal_2/imagenes/Implementacion/Validaciones/Eslabones/EnsamblajeEslabon2.png

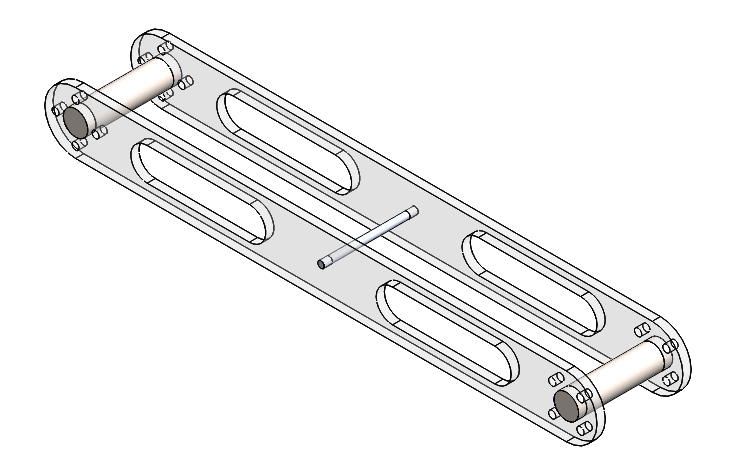
imagenes/Implementacion/Validaciones/Eslabones/EnsamblajeEslabon2.png
