EduardoSBarreraR/Trabajo_Terminal_2/imagenes/Implementacion/Validaciones/Eslabones/EnsamblajeEslabon2Analisis.png

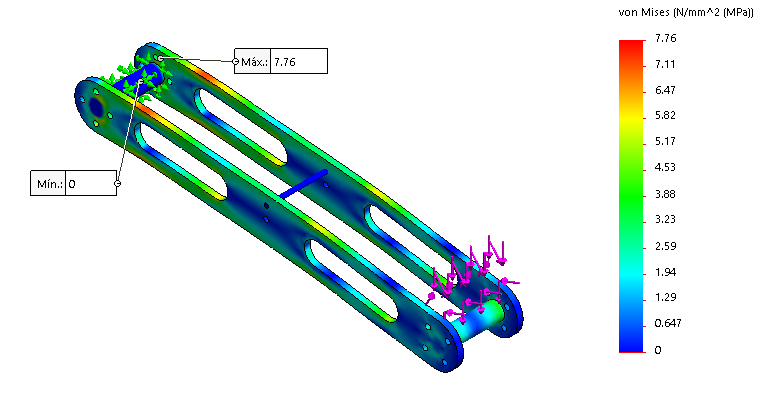
imagenes/Implementacion/Validaciones/Eslabones/EnsamblajeEslabon2Analisis.png
