EduardoSBarreraR/Trabajo_Terminal_2/imagenes/Implementacion/Resultados/AgarreNaranja.jpg

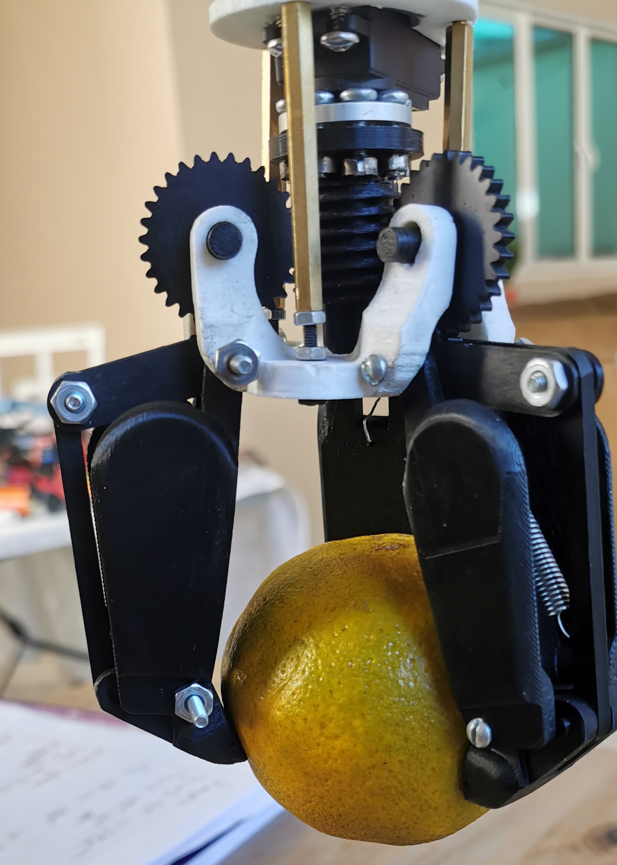
imagenes/Implementacion/Resultados/AgarreNaranja.jpg
