EduardoSBarreraR/Trabajo_Terminal_2/imagenes/Implementacion/Resultados/AlcanceMAX2.jpg

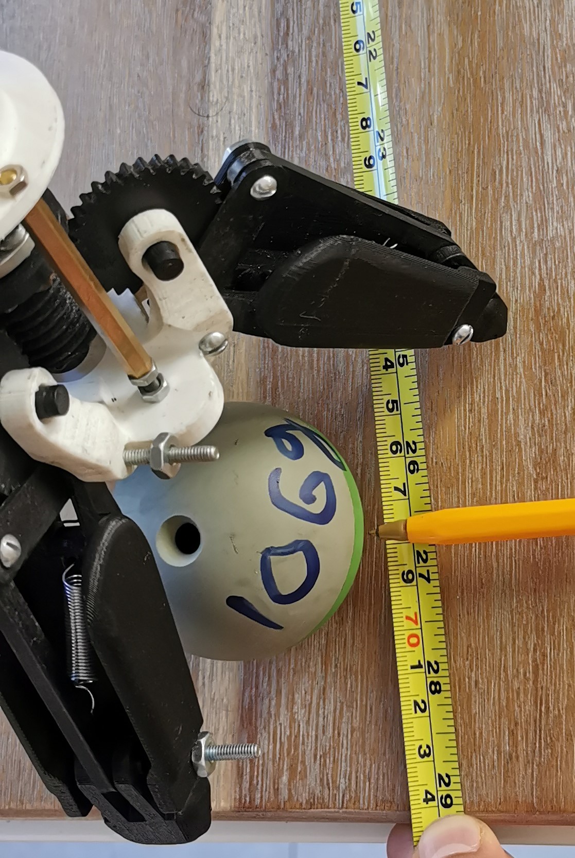
imagenes/Implementacion/Resultados/AlcanceMAX2.jpg
