EduardoSBarreraR/Trabajo_Terminal_2/imagenes/Implementacion/Resultados/Efectoragarre.jpeg

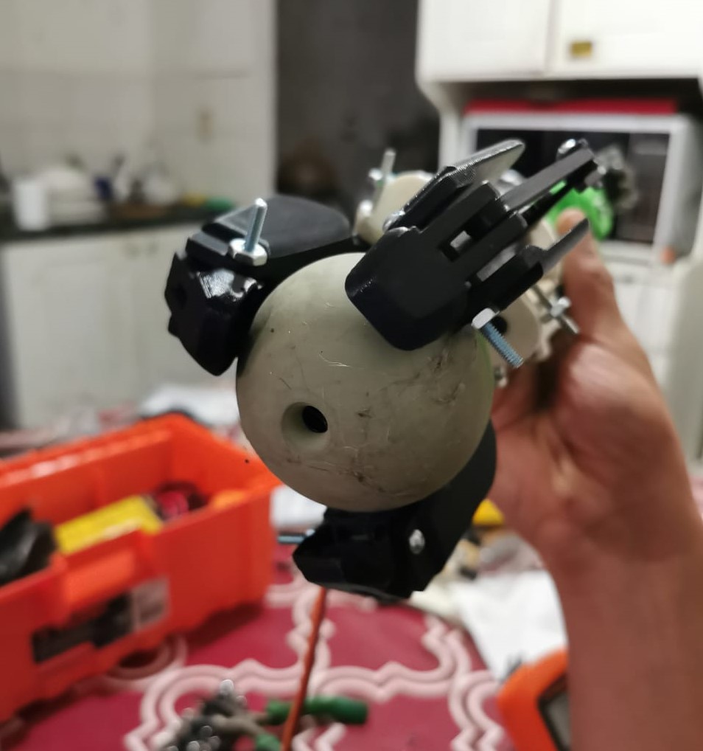
imagenes/Implementacion/Resultados/Efectoragarre.jpeg
