EduardoSBarreraR/Trabajo_Terminal_2/imagenes/Implementacion/Resultados/GUI_1.jpg

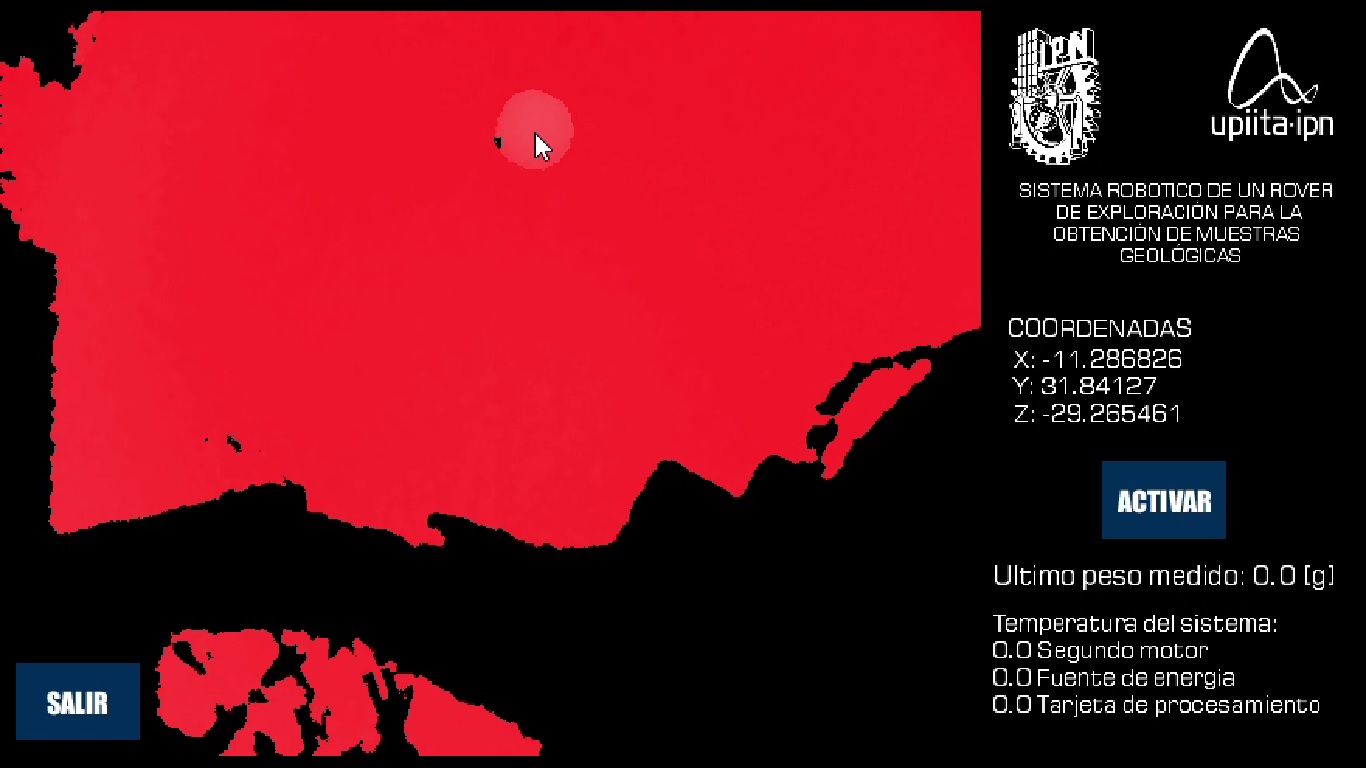
imagenes/Implementacion/Resultados/GUI_1.jpg
