EduardoSBarreraR/Trabajo_Terminal_2/imagenes/Implementacion/Resultados/GUI_3.jpg

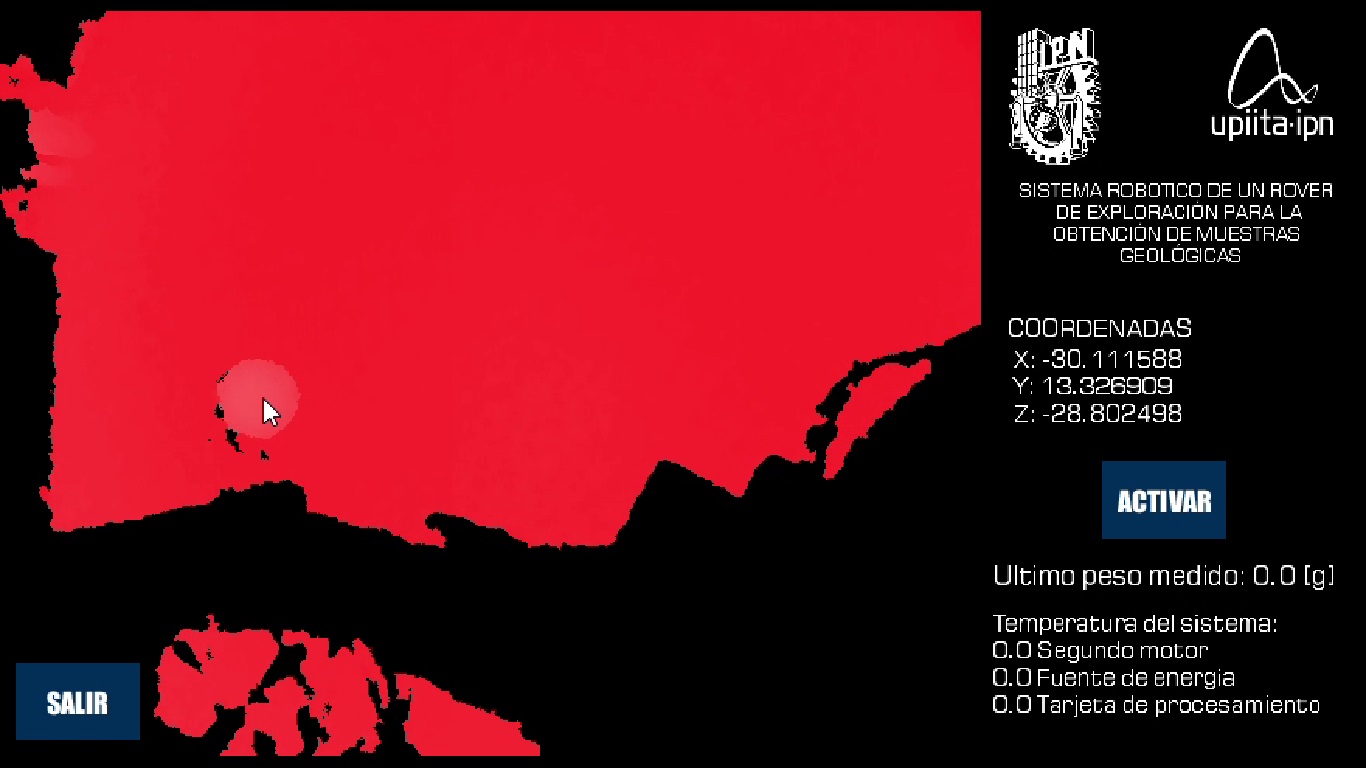
imagenes/Implementacion/Resultados/GUI_3.jpg
