EduardoSBarreraR/Trabajo_Terminal_2/imagenes/Implementacion/Resultados/GUI_4.jpg

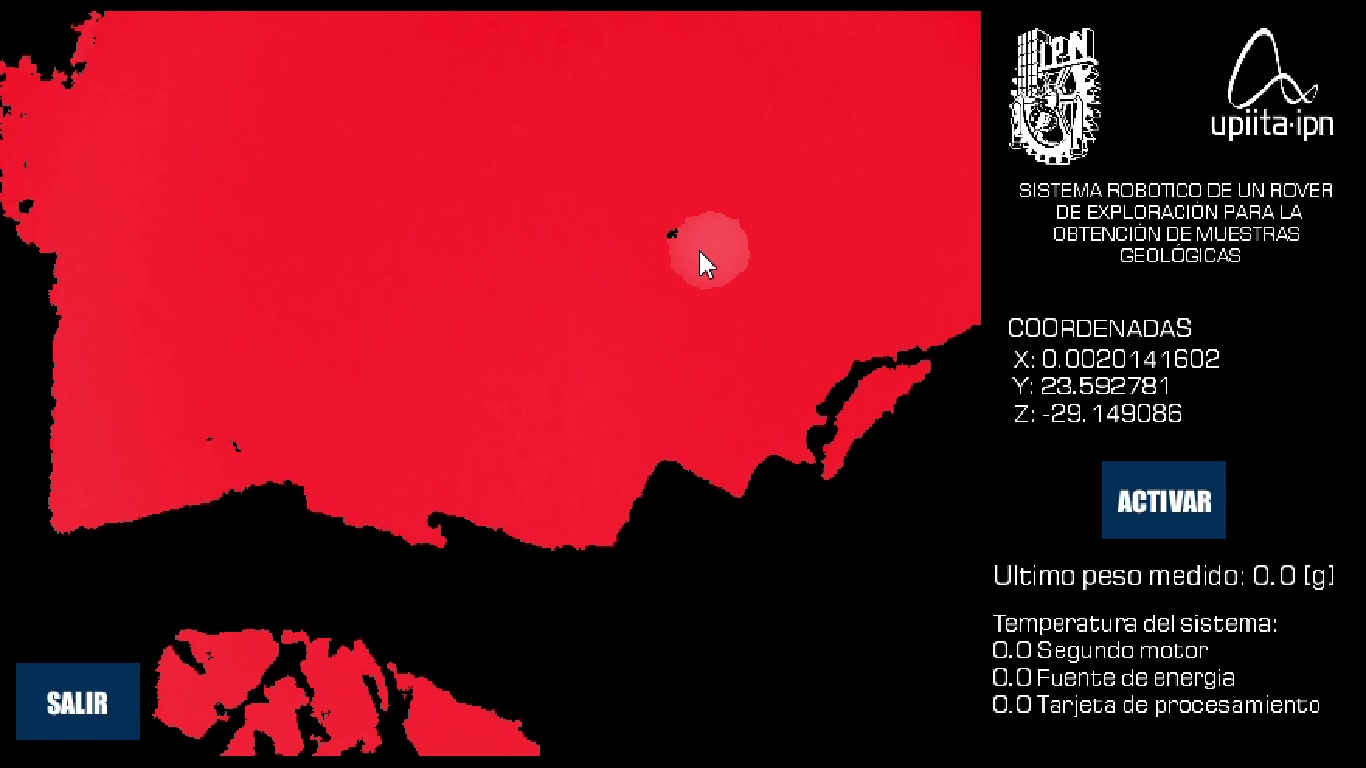
imagenes/Implementacion/Resultados/GUI_4.jpg
