EduardoSBarreraR/Trabajo_Terminal_2/imagenes/Implementacion/Resultados/Home 1.jpg

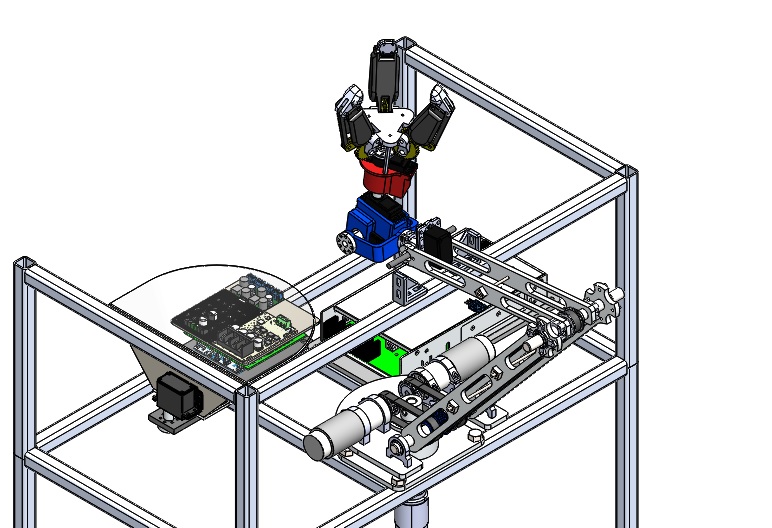
imagenes/Implementacion/Resultados/Home 1.jpg
