EduardoSBarreraR/Trabajo_Terminal_2/imagenes/Implementacion/Resultados/Sistema completo.jpg

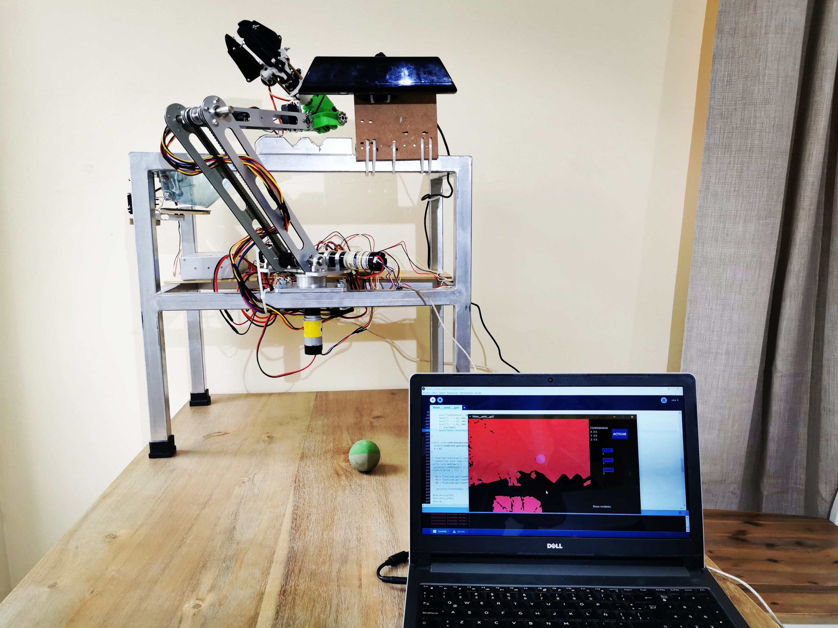
imagenes/Implementacion/Resultados/Sistema completo.jpg
