EduardoSBarreraR/Trabajo_Terminal_2/imagenes/Apendices/Planos_normalizados.pdf

140.0
D | D

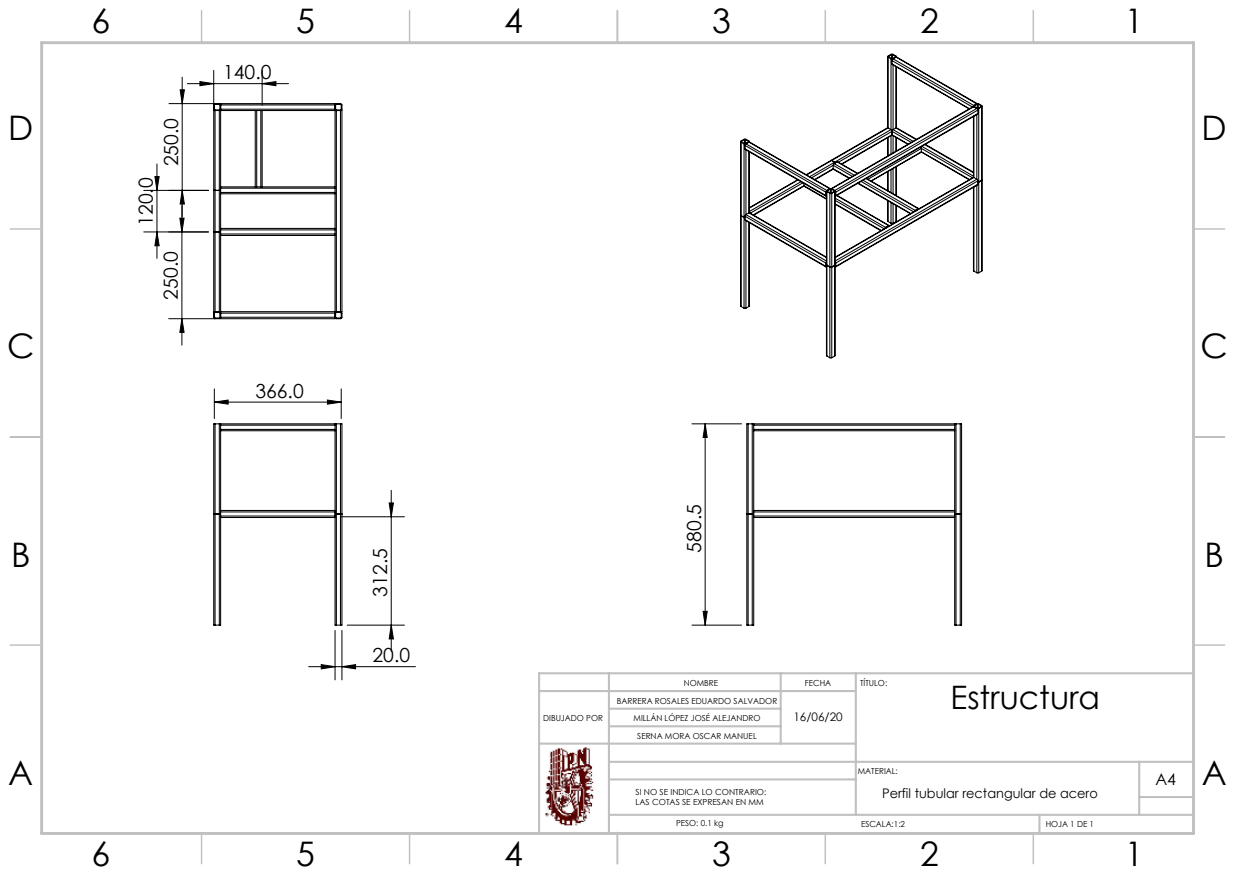
[picture p282: page 1]
20.0 ³¹².5; DIBUJADO POR; NOMBRE; FECHA; TÍTULO:; ESCALA:1:2; HOJA 1 DE 1; PESO: 0.1 kg; BARRERA ROSALES EDUARDO SALVADOR; Estructura; MILLÁN LÓPEZ JOSÉ ALEJANDRO

SERNA MORA OSCAR MANUEL

MATERIAL:
Perfil tubular rectangular de acero

SI NO SE INDICA LO CONTRARIO:
LAS COTAS SE EXPRESAN EN MM

120.00

140.00

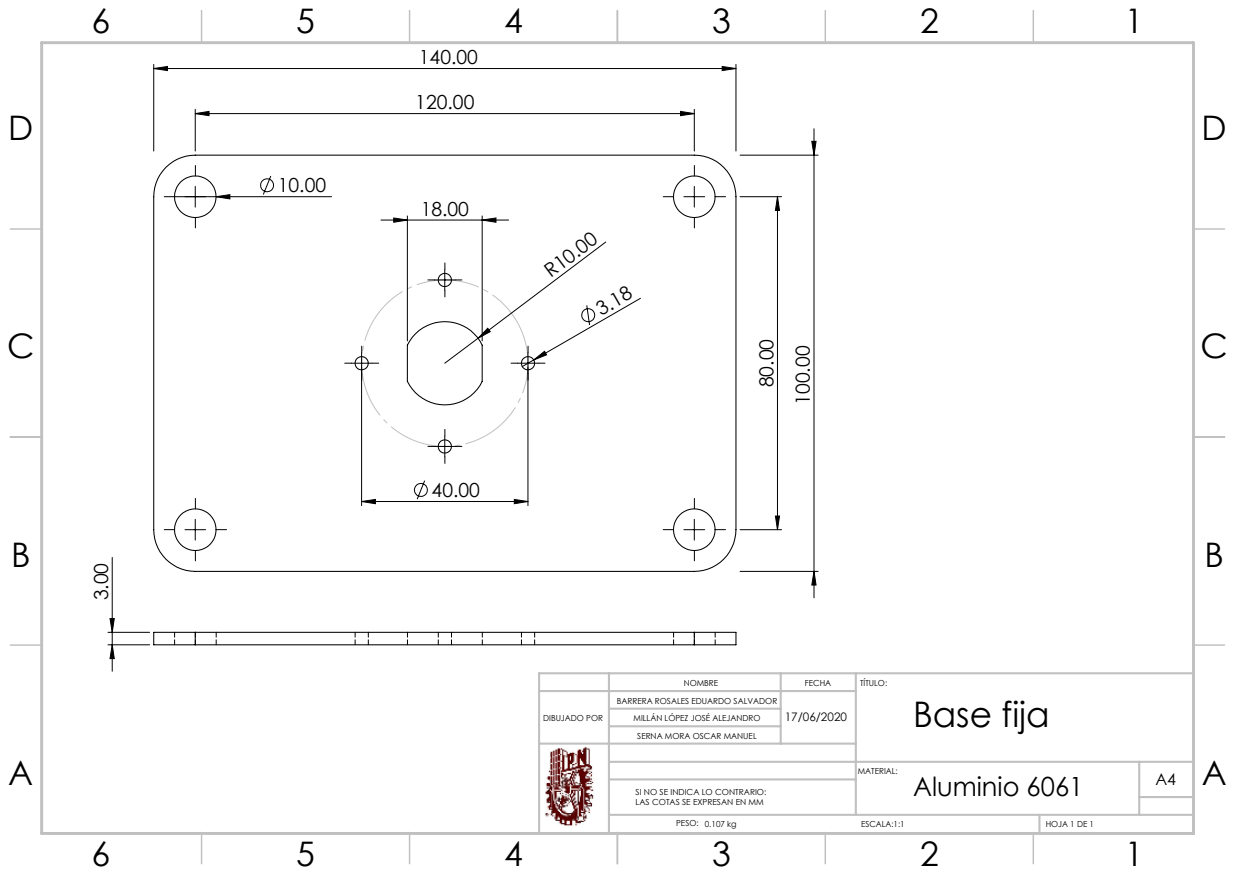
[picture p283: page 2]
DIBUJADO POR; NOMBRE; FECHA; MATERIAL:; TÍTULO:; ESCALA:1:1; HOJA 1 DE 1; PESO:; BARRERA ROSALES EDUARDO SALVADOR; Base fija; MILLÁN LÓPEZ JOSÉ ALEJANDRO; Aluminio 6061

SERNA MORA OSCAR MANUEL

SI NO SE INDICA LO CONTRARIO:

170.00
A

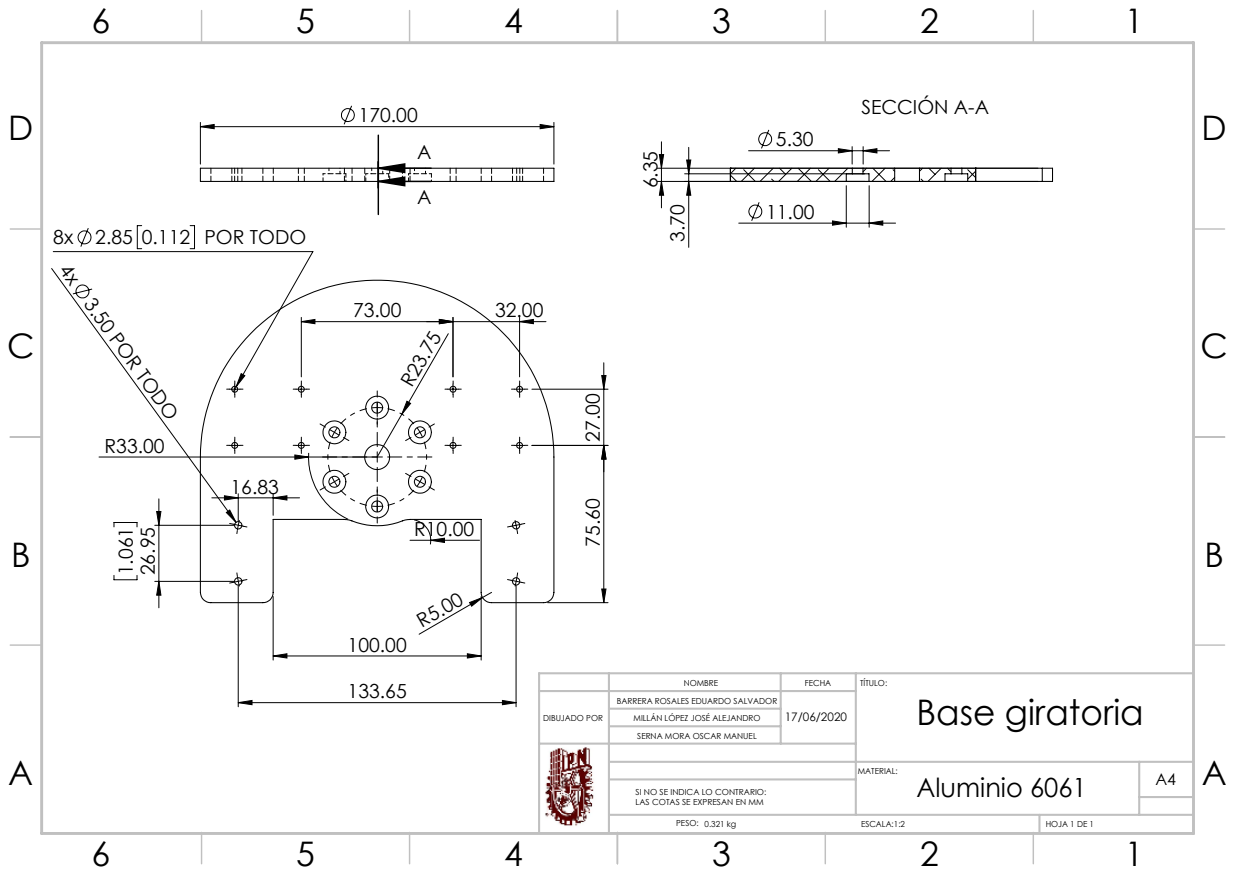
[picture p284: page 3]
8x 2.85 0.112 POR TODO; 4x 3.50 POR TODO; SECCIÓN A-A; DIBUJADO POR; NOMBRE; FECHA; MATERIAL:; TÍTULO:; BARRERA ROSALES EDUARDO SALVADOR; Base giratoria; MILLÁN LÓPEZ JOSÉ ALEJANDRO; Aluminio 6061

SERNA MORA OSCAR MANUEL

SI NO SE INDICA LO CONTRARIO:

6.00

D | D

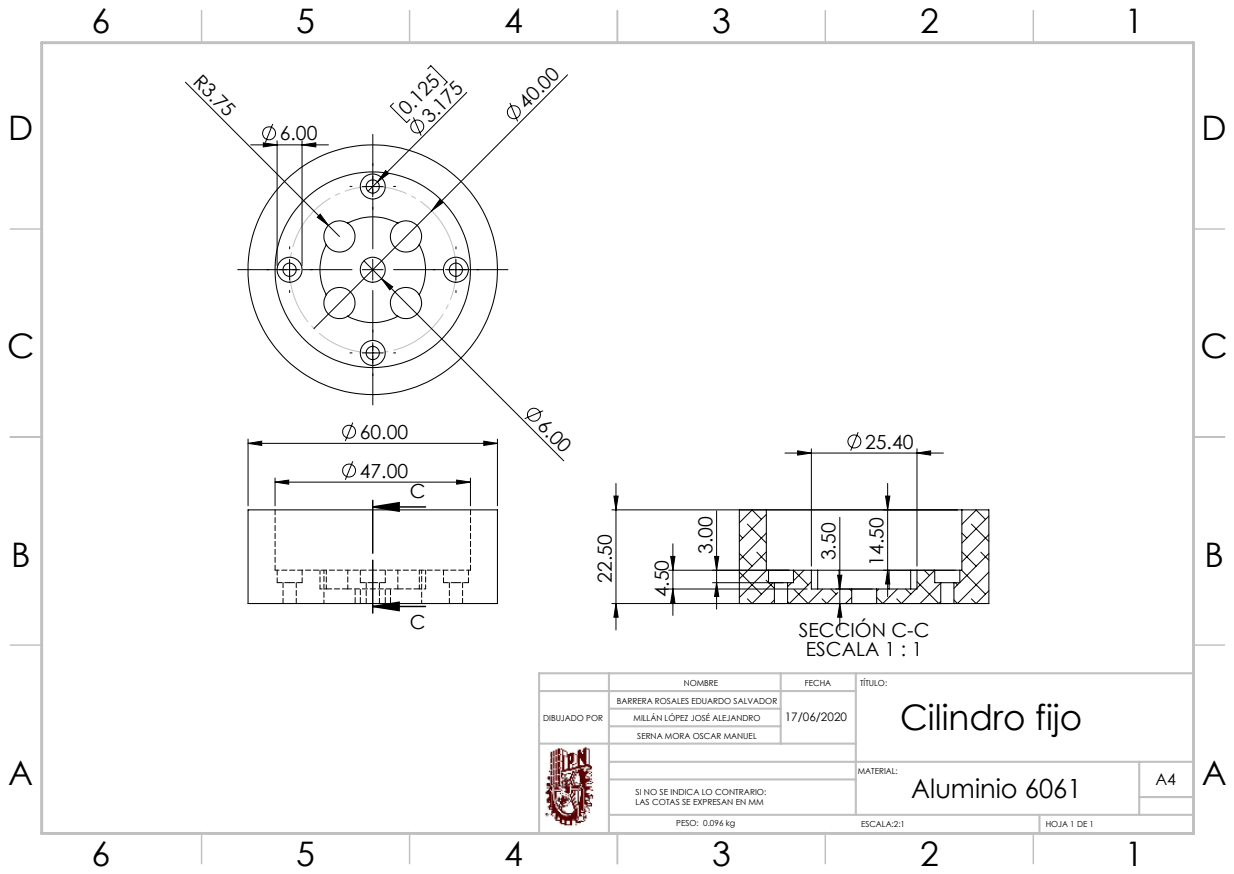
[picture p285: page 4]
SECCIÓN C-C ESCALA 1 : 1; DIBUJADO POR; NOMBRE; FECHA; MATERIAL:; TÍTULO:; ESCALA:2:1; HOJA 1 DE 1; PESO: 0.096 kg; BARRERA ROSALES EDUARDO SALVADOR; Cilindro fijo; MILLÁN LÓPEZ JOSÉ ALEJANDRO; Aluminio 6061

SERNA MORA OSCAR MANUEL

SI NO SE INDICA LO CONTRARIO:

40.00 45.00 | 45.00 | 12.00 ⁴.00
D | D

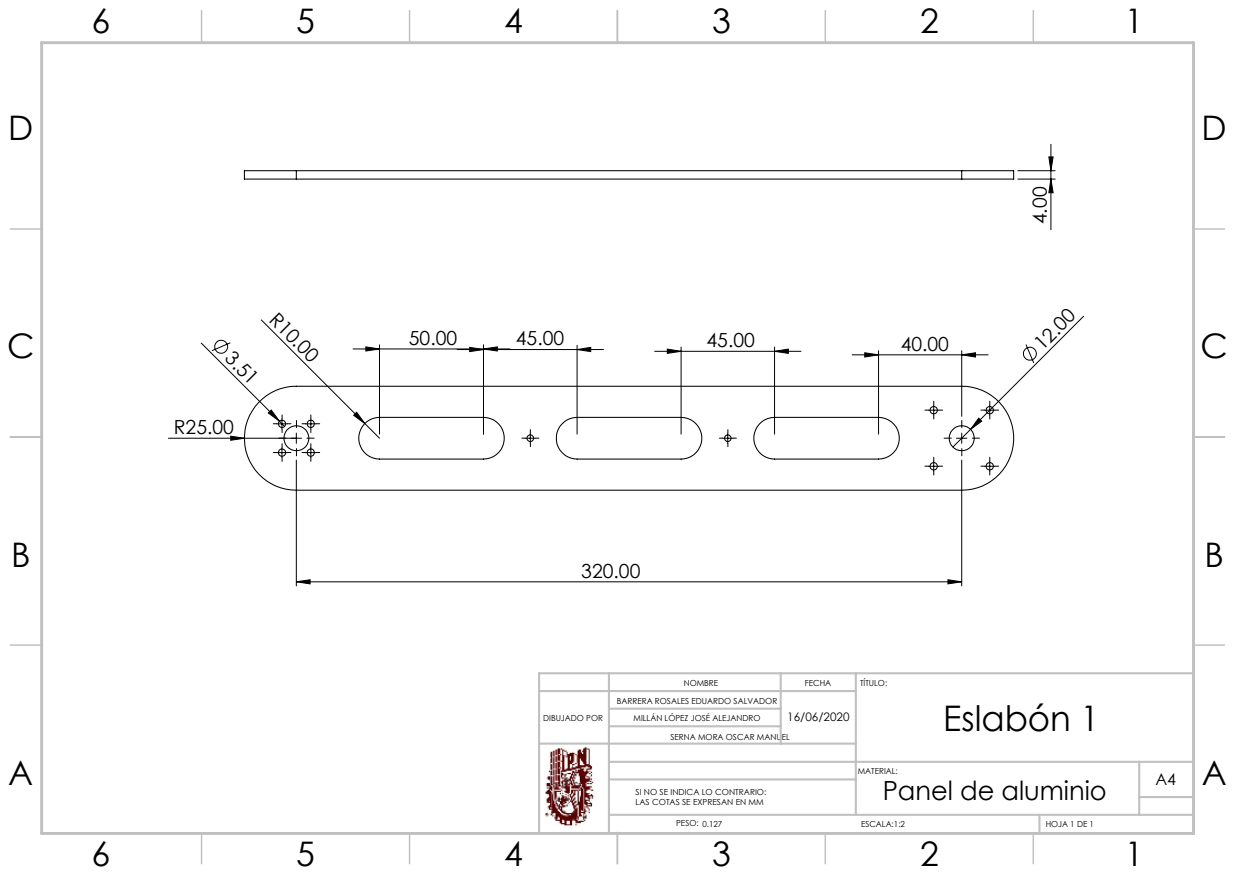
[picture p286: page 5]
DIBUJADO POR; NOMBRE; FECHA; TÍTULO:; BARRERA ROSALES EDUARDO SALVADOR; Eslabón 1; MILLÁN LÓPEZ JOSÉ ALEJANDRO

SERNA MORA OSCAR MANUEL

MATERIAL:
Panel de aluminio

SI NO SE INDICA LO CONTRARIO:

D | D

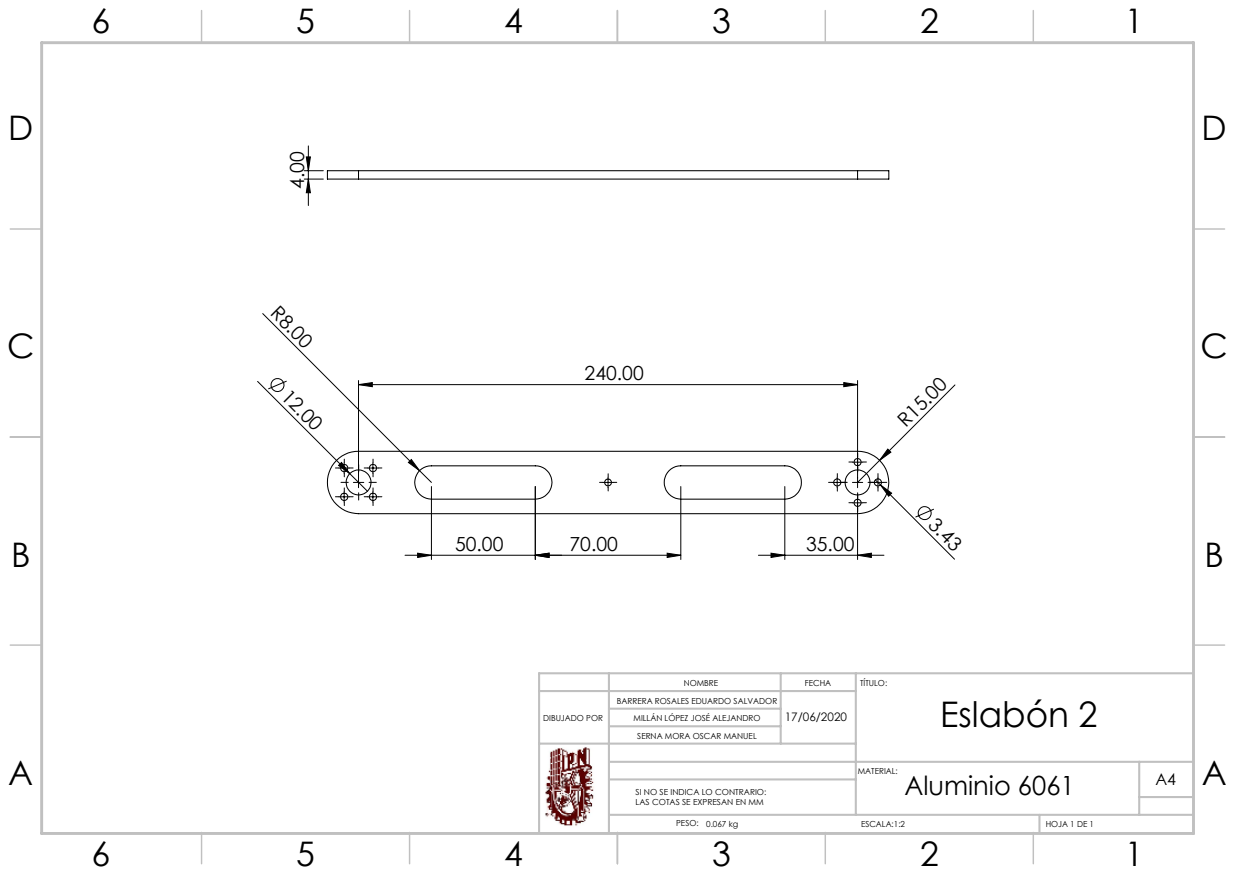
[picture p287: page 6]
DIBUJADO POR; NOMBRE; FECHA; MATERIAL:; TÍTULO:; BARRERA ROSALES EDUARDO SALVADOR; Eslabón 2; MILLÁN LÓPEZ JOSÉ ALEJANDRO; Aluminio 6061

SERNA MORA OSCAR MANUEL

SI NO SE INDICA LO CONTRARIO:

B

B

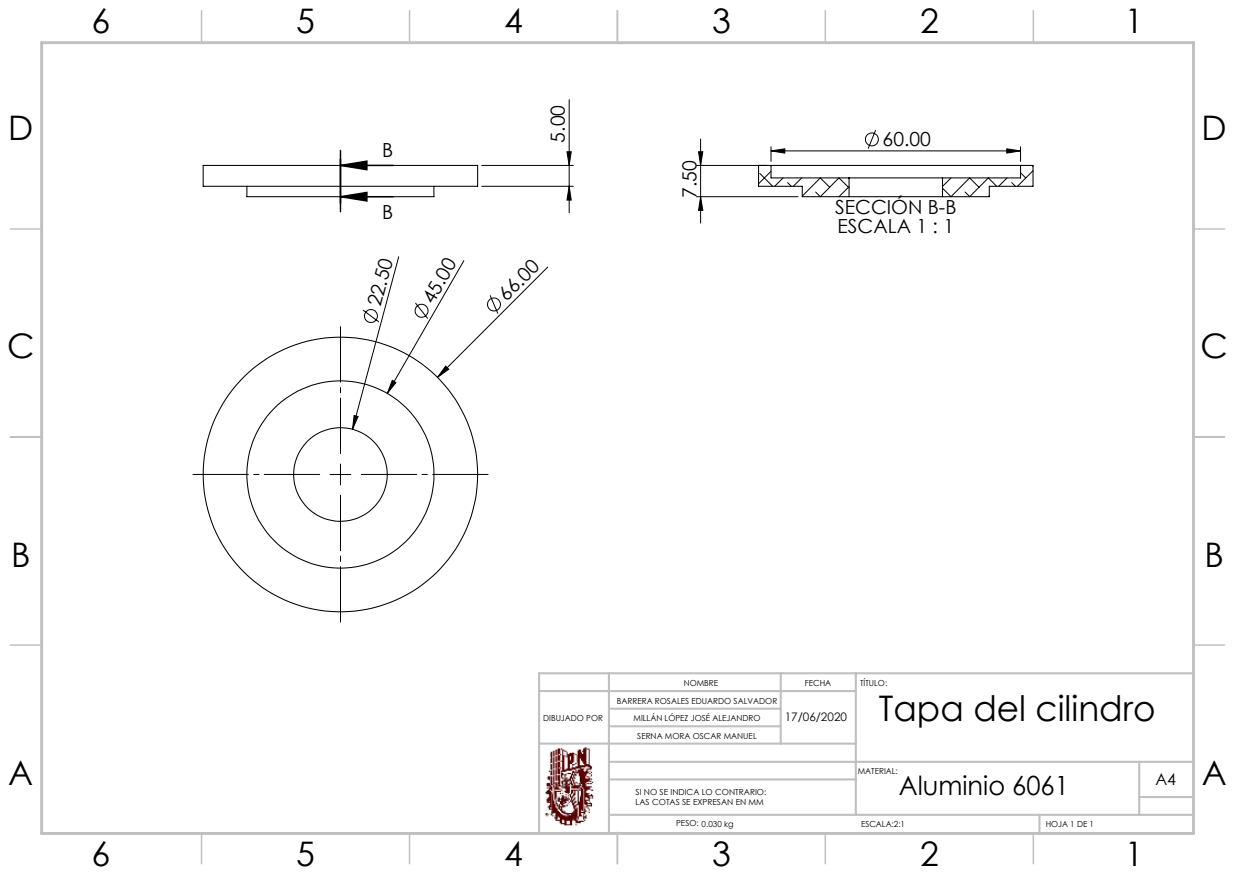
[picture p288: page 7]
SECCIÓN B-B ESCALA 1 : 1; DIBUJADO POR; NOMBRE; FECHA; MATERIAL:; ESCALA:2:1; HOJA 1 DE 1; MILLÁN LÓPEZ JOSÉ ALEJANDRO; Aluminio 6061

TÍTULO:
Tapa del cilindro

BARRERA ROSALES EDUARDO SALVADOR

SERNA MORA OSCAR MANUEL

SI NO SE INDICA LO CONTRARIO:

6.50
165.10

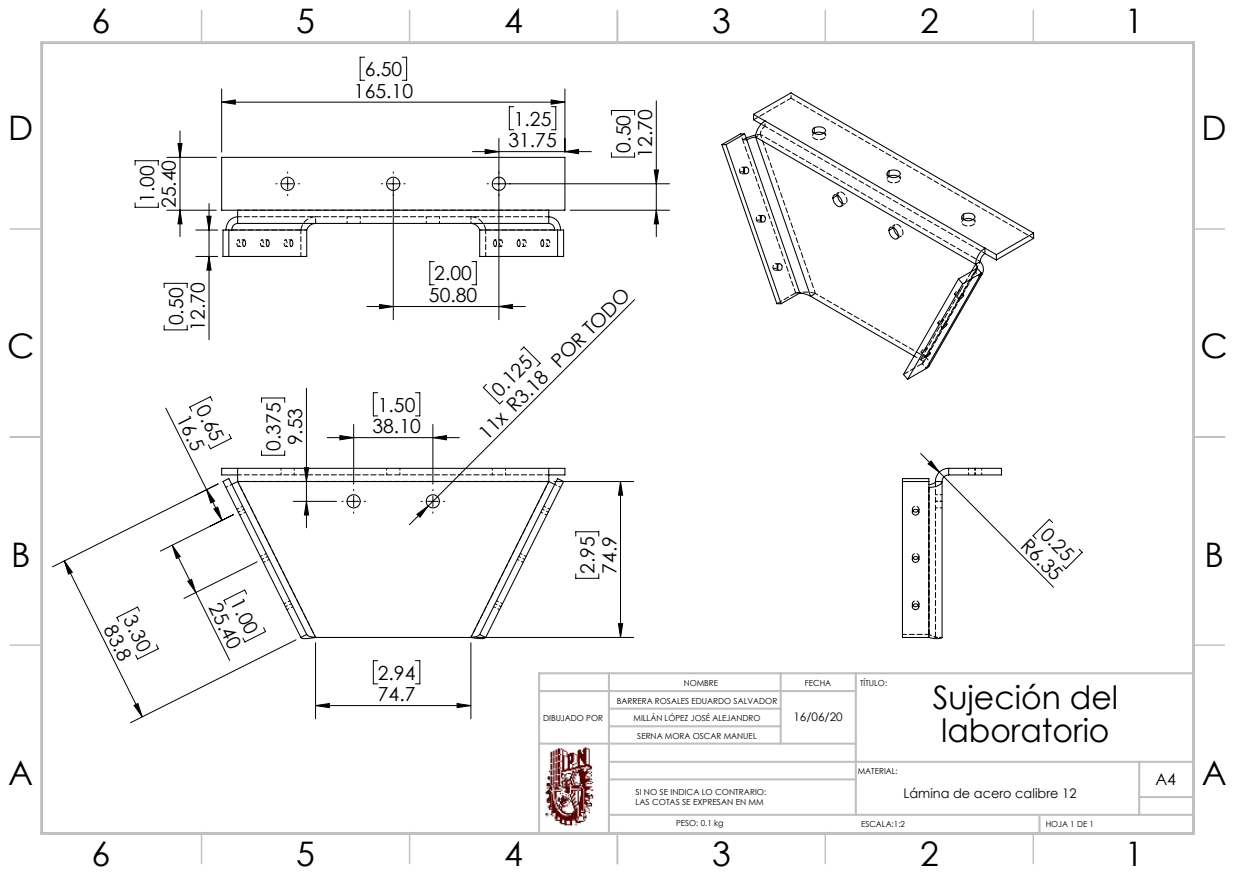
[picture p289: page 8]
R3.18 POR TODO 2.95 74.9; DIBUJADO POR; NOMBRE; FECHA; TÍTULO:; PESO: 0.1 kg; BARRERA ROSALES EDUARDO SALVADOR; Sujeción del; laboratorio; MILLÁN LÓPEZ JOSÉ ALEJANDRO

SERNA MORA OSCAR MANUEL

MATERIAL:
Lámina de acero calibre 12

SI NO SE INDICA LO CONTRARIO:
