EduardoSBarreraR/Trabajo_Terminal_2/imagenes/Apendices/DiagramasDeFlujo_Micro.pdf

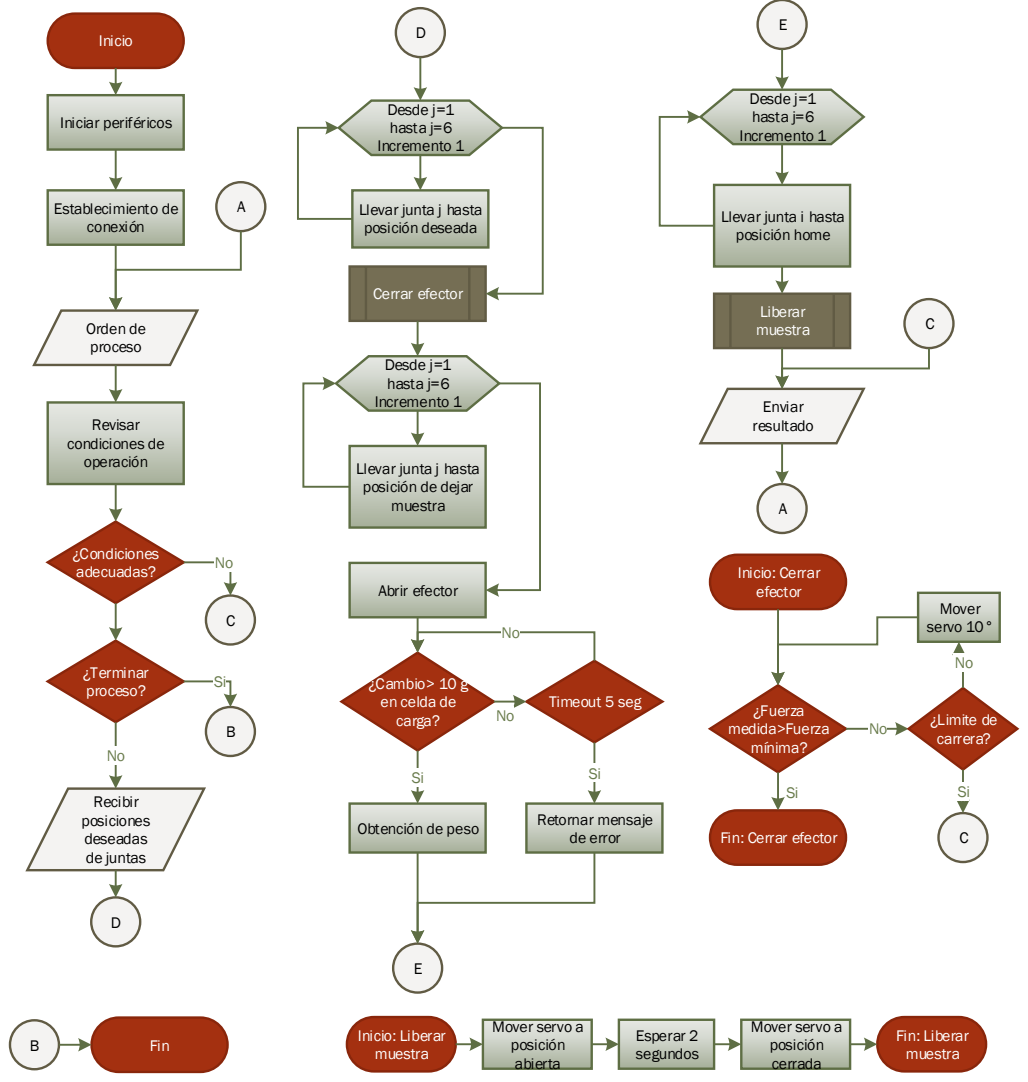
[picture p290: page 1]
Inicio; Iniciar periféricos; Orden de proceso; Revisar condiciones de operación; ¿Condiciones adecuadas?; Recibir posiciones deseadas de juntas; Desde j=1 hasta j=6 Incremento 1; Cerrar efector; Abrir efector; Timeout 5 seg; Obtención de peso; Retornar mensaje; de error; Enviar resultado; Liberar muestra; ¿Terminar proceso?; Fin; ¿Fuerza medida>Fuerza mínima?; Mover servo 10°; Inicio: Cerrar efector; Mover servo a posición abierta; Fin: Liberar muestra; Inicio: Liberar muestra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

Llevar junta j hasta
posición deseada

Llevar junta i hasta
posición home

posición de dejar
muestra

¿Cambio> 10 g
en celda de
carga?

Fin: Cerrar efector
