EduardoSBarreraR/Trabajo_Terminal_2/imagenes/Marco Teorico/CalibreCable.pdf

10%

3%

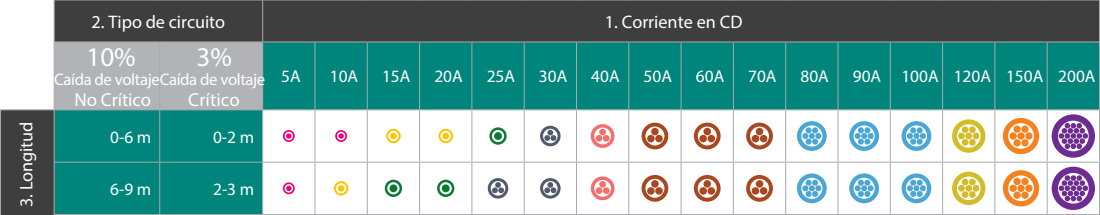
[picture p291: page 1]
2. Tipo de circuito; 1. Corriente en CD; 3. Longitud

Caída de voltaje
No Crítico

Crítico

10% Caída de voltaje No Crítico | 3% Caída de voltaje Crítico | 5A | 10A | 15A | 20A | 25A | 30A | 40A | 50A | 60A | 70A | 80A | 90A | 100A | 120A | 150A | 200A

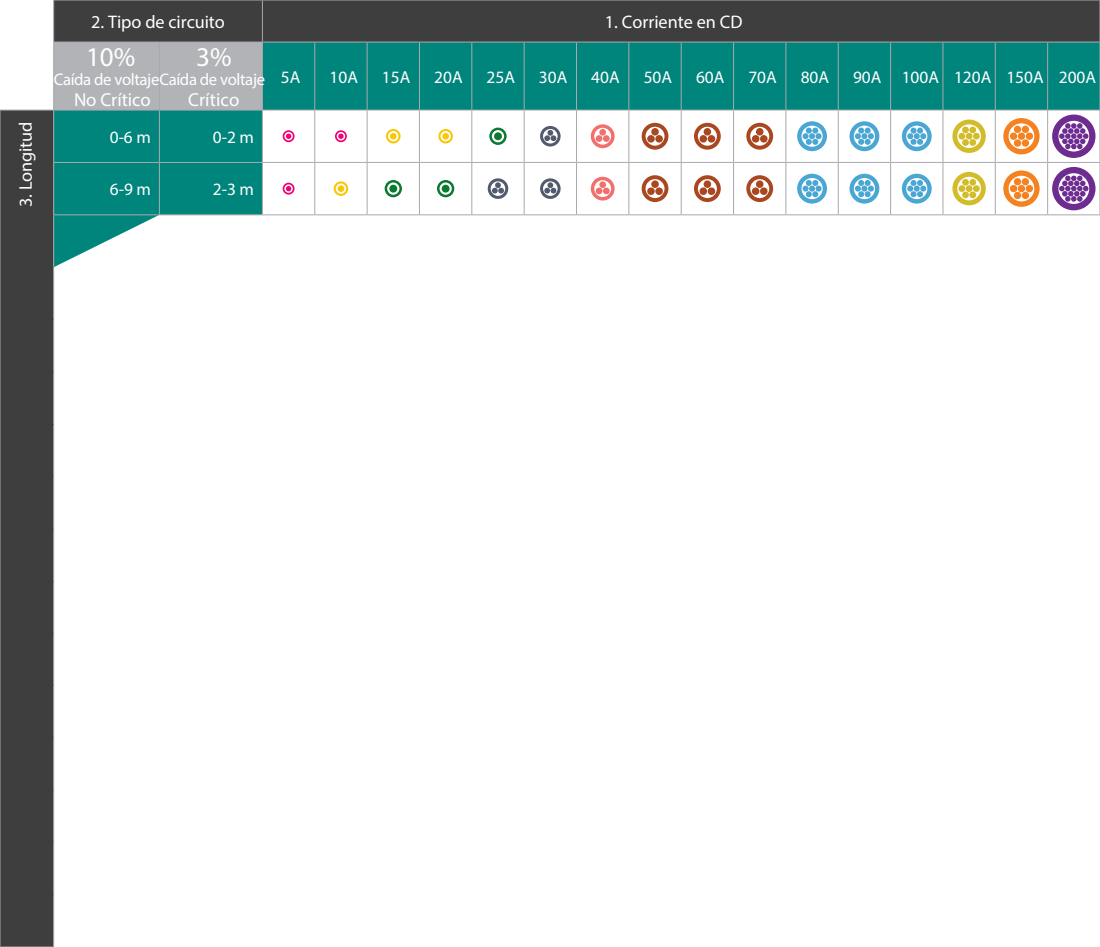
[picture p292: page 2]
3. Longitud

2. Tipo de circuito | 1. Corriente en CD
