EduardoSBarreraR/Trabajo_Terminal_2/imagenes/Modelos/IDEF0.pdf

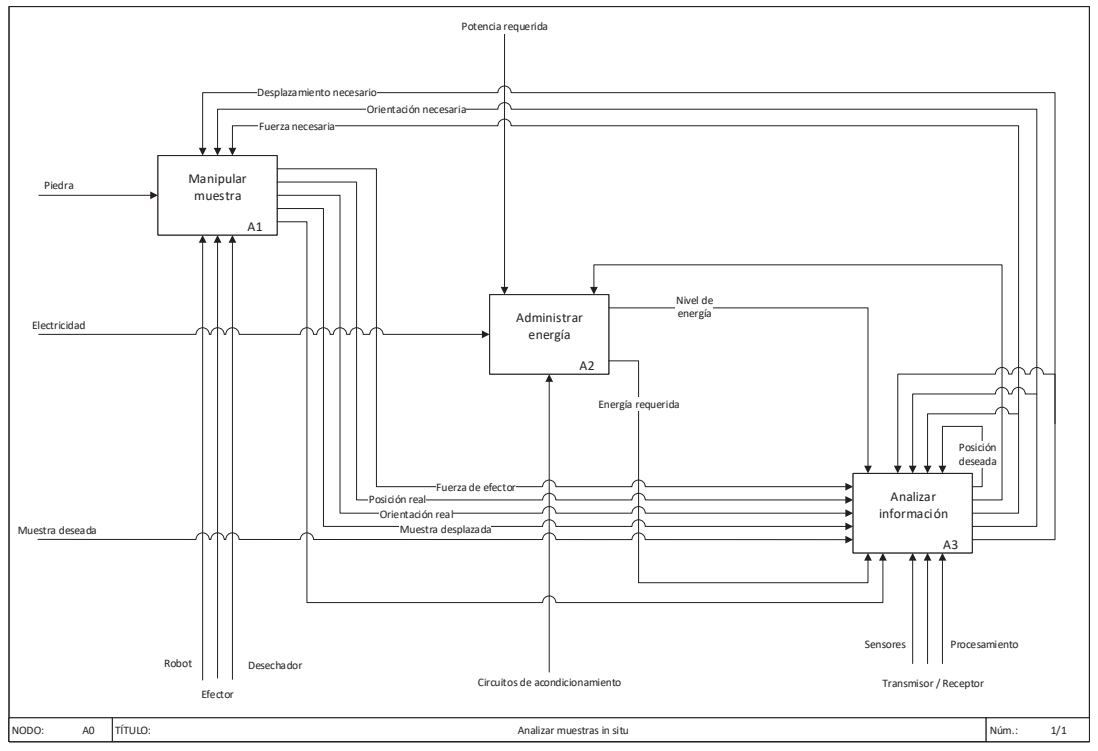
[picture p293: page 1]
NODO:; TÍTULO:; Analizar muestras in situ; Núm.:; Manipular muestra; Administrar energía; Robot; Efector; Desechador; Piedra; Electricidad; Muestra deseada; Energía requerida; Nivel de energía; Potencia requerida; Fuerza necesaria; Orientación necesaria; Desplazamiento necesario; Posición deseada; Sensores; Procesamiento; Transmisor / Receptor

Fuerza de efector Posición real
Orientación real
Muestra desplazada

Analizar
información información A3 A3

Circuitos de acondicionamiento
