EduardoSBarreraR/Trabajo_Terminal_2/imagenes/Dominio especifico/Comunicacion/ARMProc.pdf

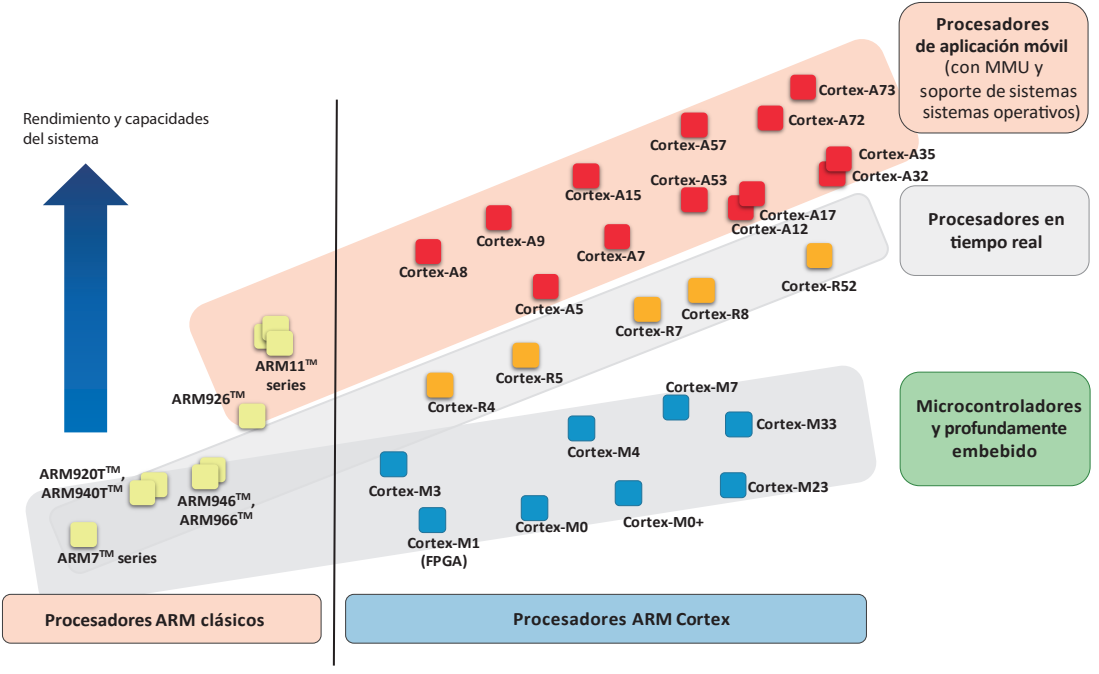
[picture p294: page 1]
Procesadores en empo real; Microcontroladores y profundamente embebido; ARM7TM series; ARM920TTM, ARM940TTM; ARM946TM, ARM966TM; ARM926TM; Cortex-M3; Cortex-M1 (FPGA); Cortex-M0; Cortex-M0+; Cortex-M4; Cortex-R4; Cortex-R5; Cortex-R7; Cortex-A8; Cortex-A9; Cortex-A5; Cortex-A15; Cortex-A7; Procesadores ARM clásicos; Procesadores ARM Cortex; Cortex-A57; Cortex-A53; Cortex-A12; ARM11TM series; Cortex-R8; Cortex-A17; Cortex-A72; Cortex-A73; Cortex-A32; Cortex-A35; Cortex-R52; Cortex-M7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

Procesadores
de aplicación móvil
(con MMU y
soporte de sistemas
sistemas operavos)
