EduardoSBarreraR/Trabajo_Terminal_2/imagenes/Anexos/Motor CD 5202_spec_sheet.pdf

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

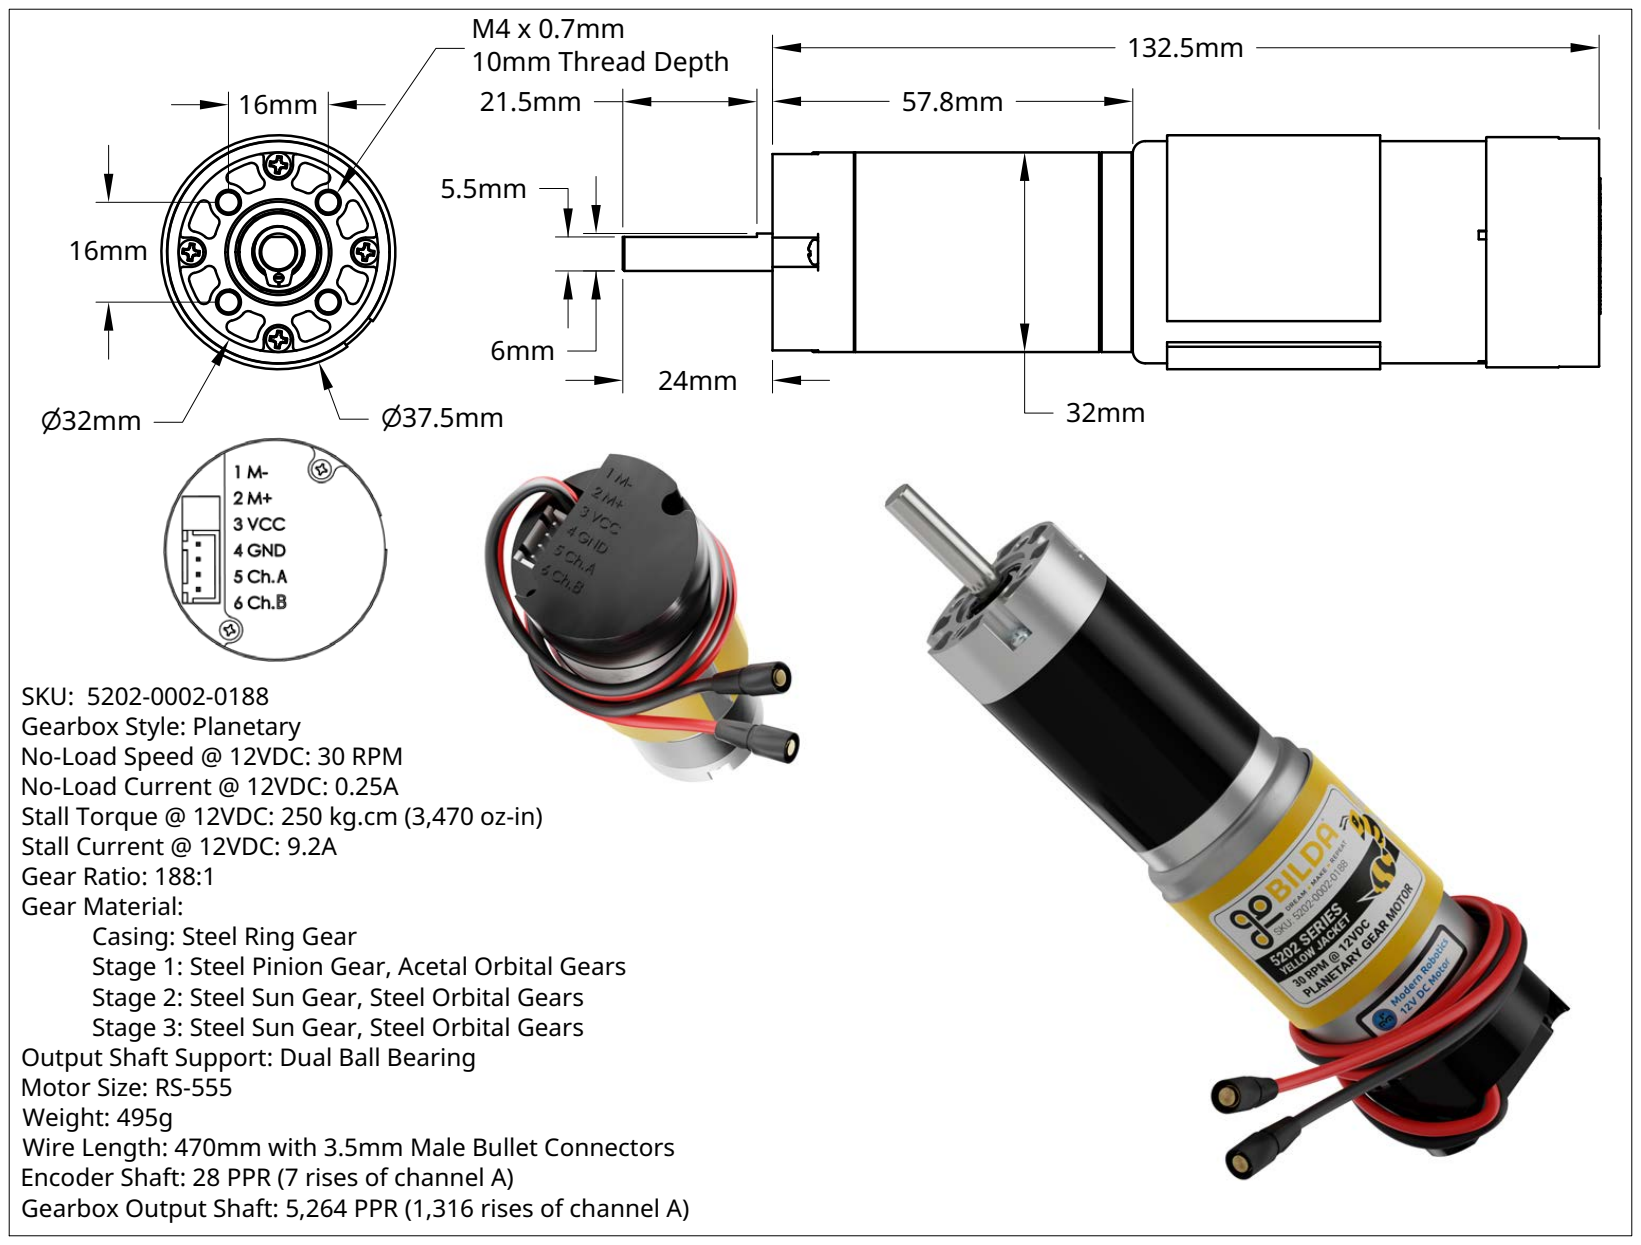
[picture p295: page 1]
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
