EduardoSBarreraR/Trabajo_Terminal_2/imagenes/Seleccion de concepto/VPCriterios.pdf

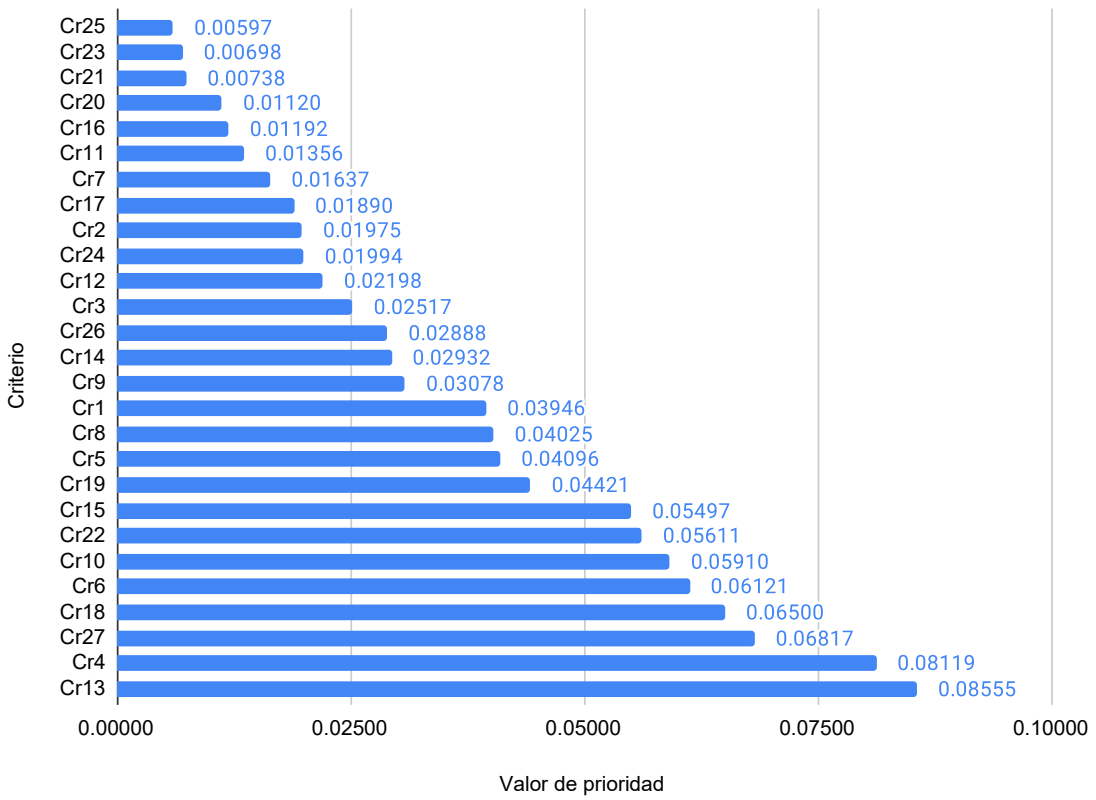
[picture p296: page 1]
Criterio

Valor de prioridad
