EduardoSBarreraR/Trabajo_Terminal_2/imagenes/Seleccion de concepto/AHP/Desempeno general de cada concepto.pdf

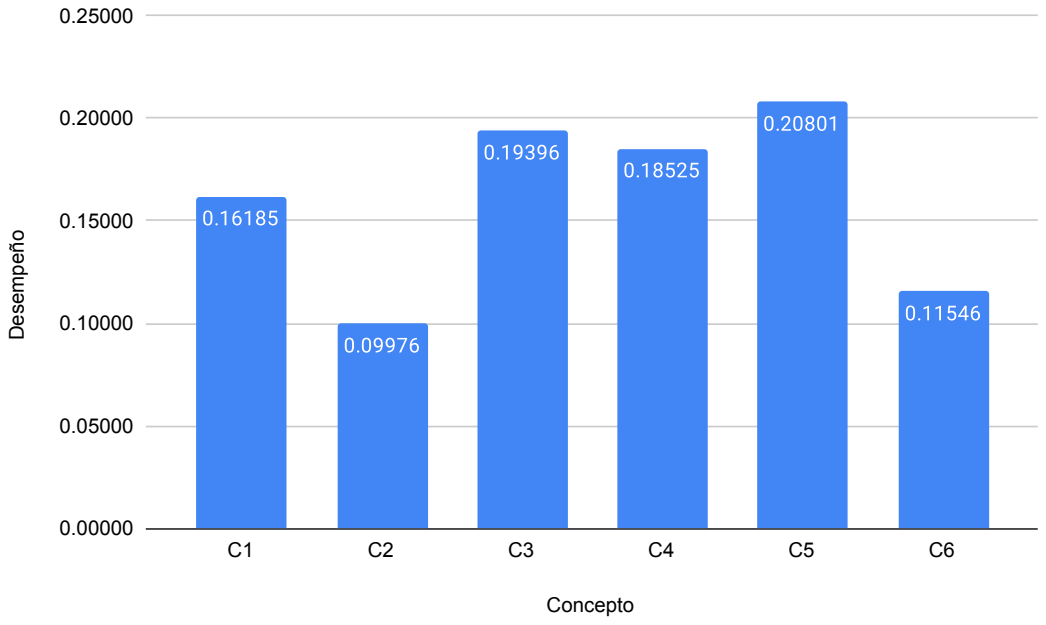
[picture p297: page 1]
Concepto; Desempeño
