EduardoSBarreraR/Trabajo_Terminal_2/imagenes/Seleccion de concepto/AHP/Jerarquia de criterios.pdf

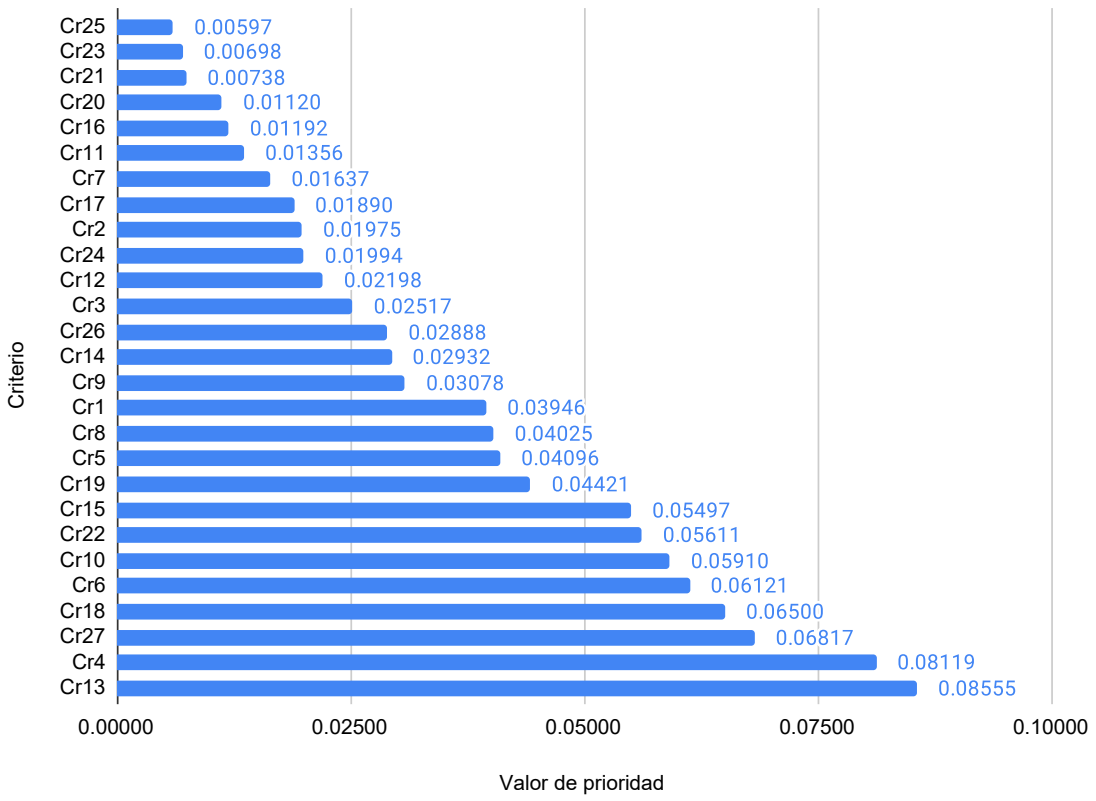
[picture p298: page 1]
Criterio

Valor de prioridad
