EduardoSBarreraR/Trabajo_Terminal_2/imagenes/Seleccion de concepto/AHP/Seleccion de concepto.pdf

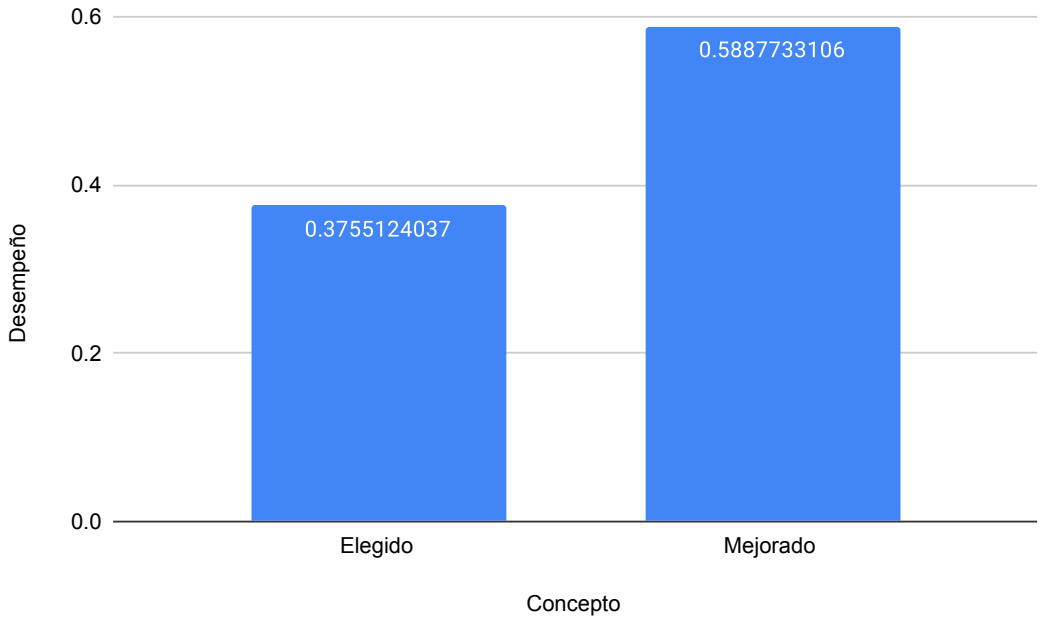
[picture p299: page 1]
Concepto; Desempeño; Elegido; Mejorado
