EduardoSBarreraR/Trabajo_Terminal_2/imagenes/Implementacion/Distribucion pines final.pdf

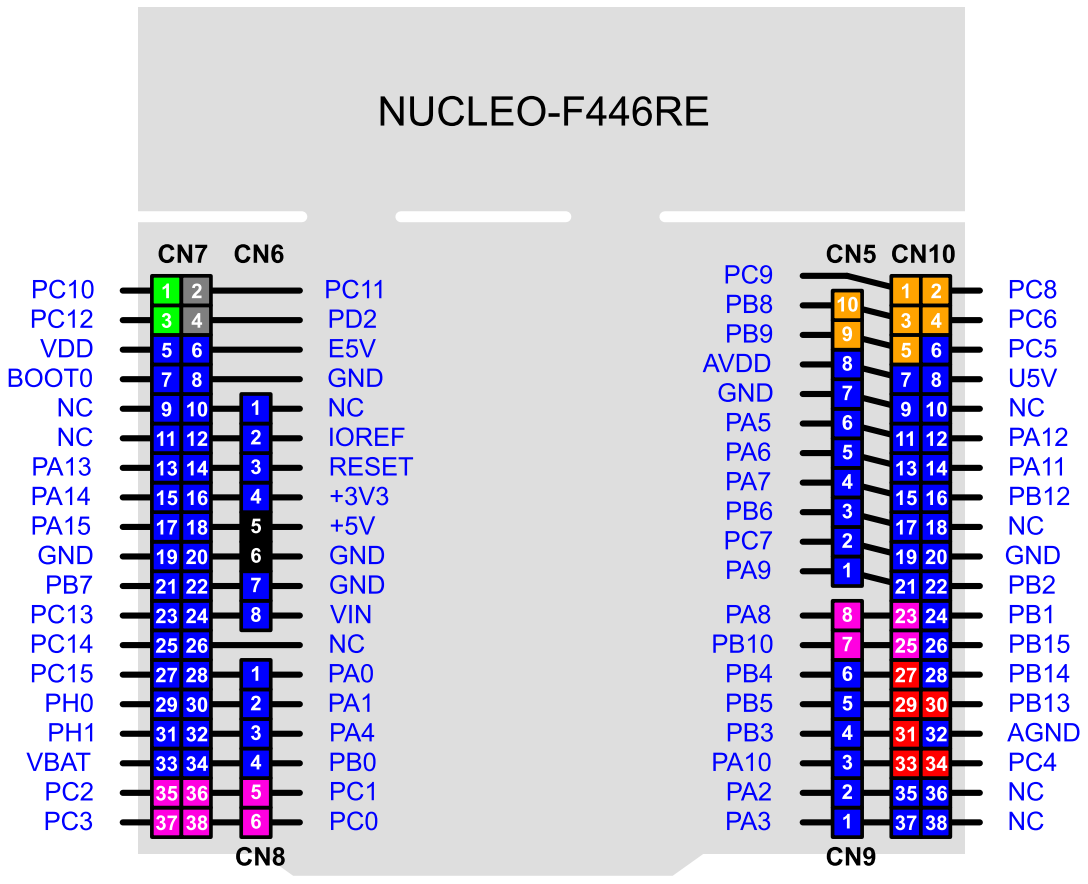
[picture p300: page 1]
