EduardoSBarreraR/Trabajo_Terminal_2/imagenes/Implementacion/PLAKA9.PDF

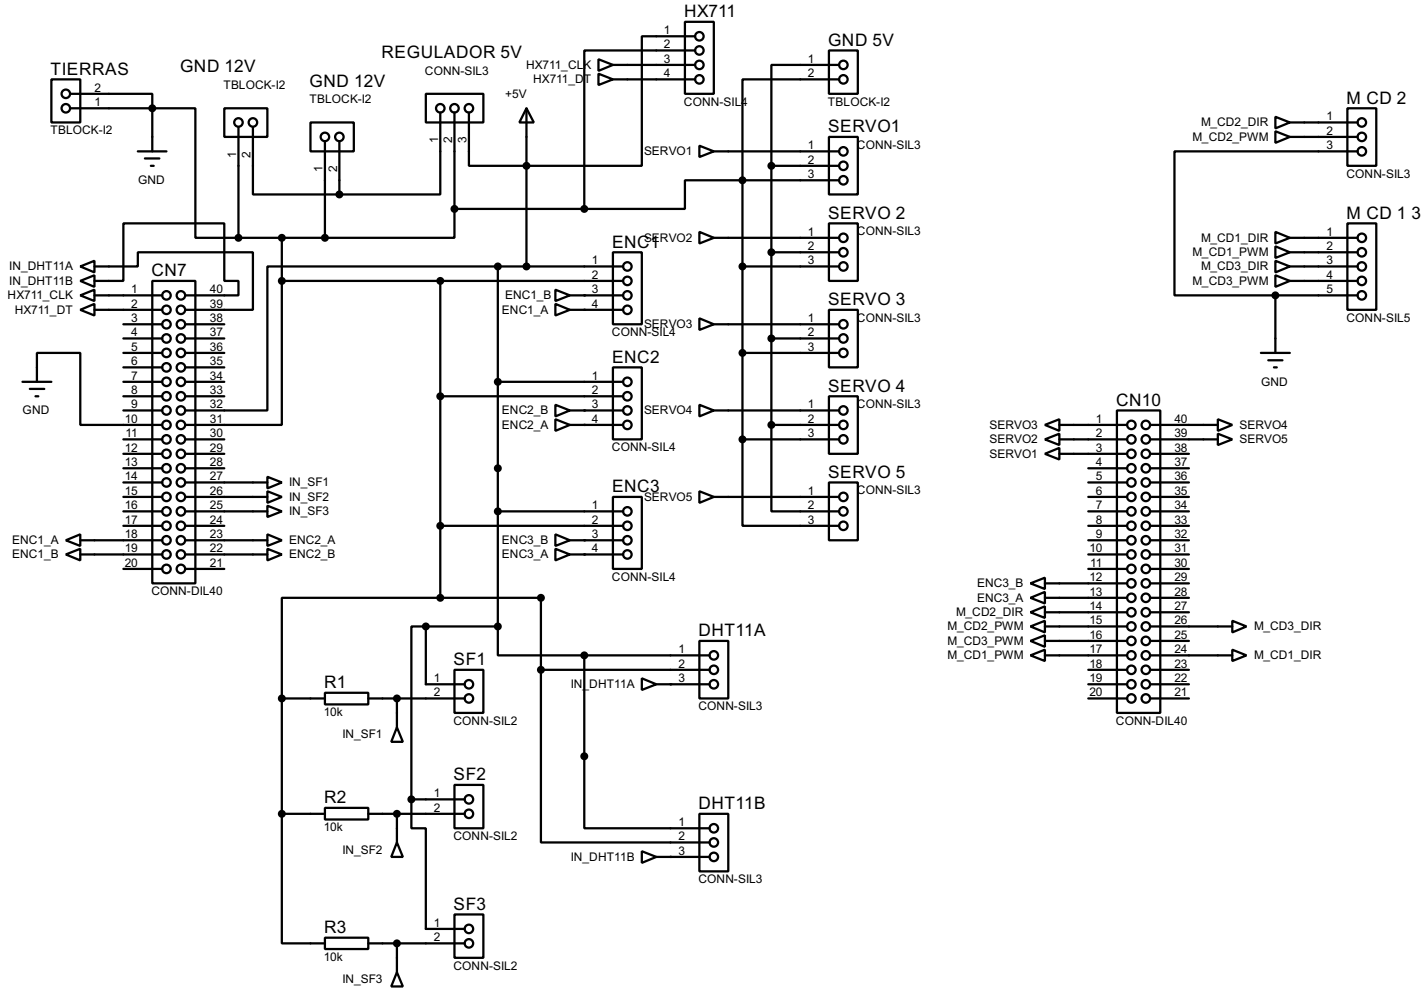
[picture p301: page 1]

HX711_CLK HX711_DT | 2

ENC1

IN_DHT11A | | 3
