EduardoSBarreraR/Trabajo_Terminal_2/imagenes/Implementacion/PLAKA9PCB.PDF

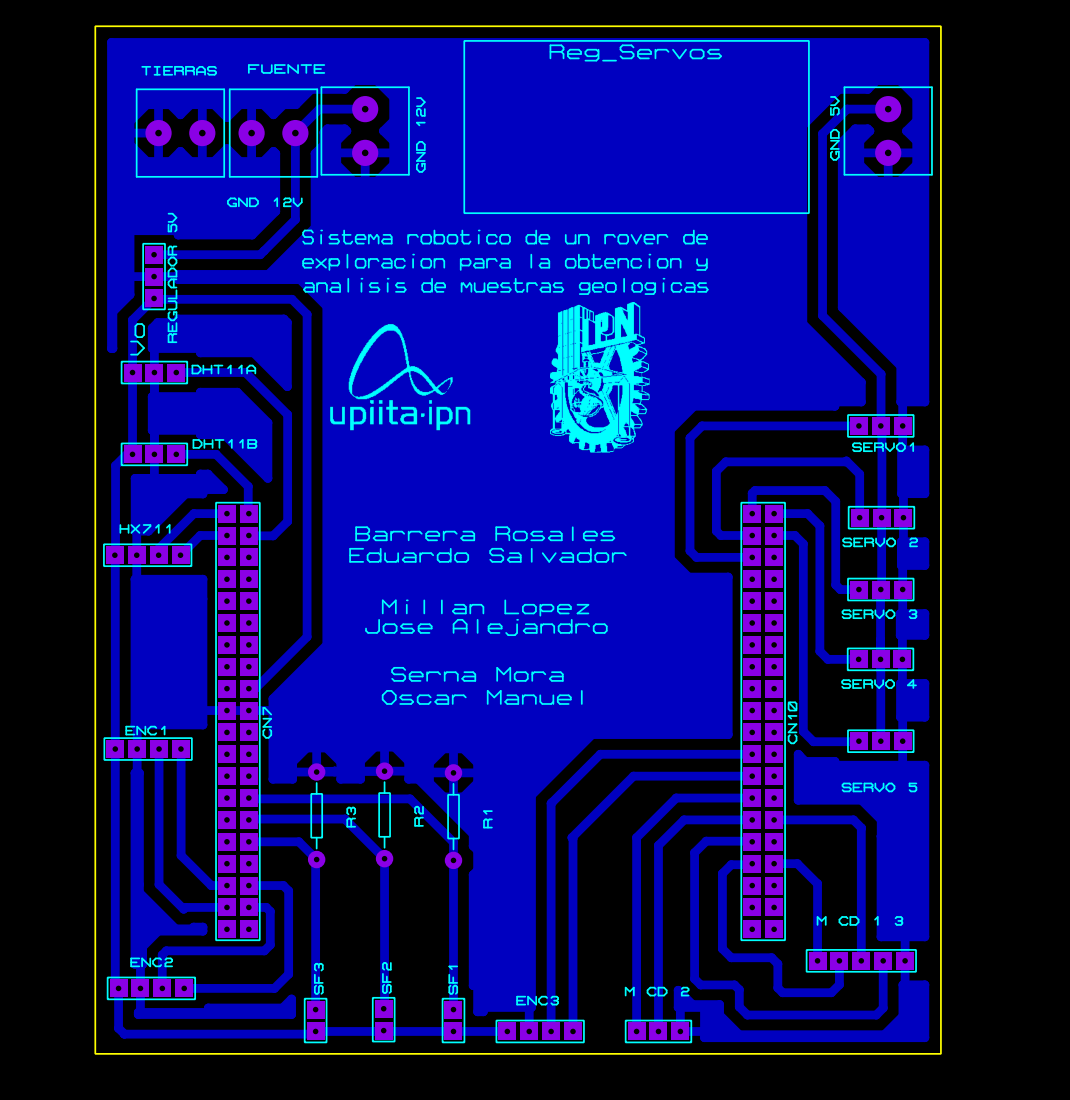
[picture p302: page 1]
