EduardoSBarreraR/Trabajo_Terminal_2/imagenes/Apendices/DiagramasDeFlujo_PC.pdf

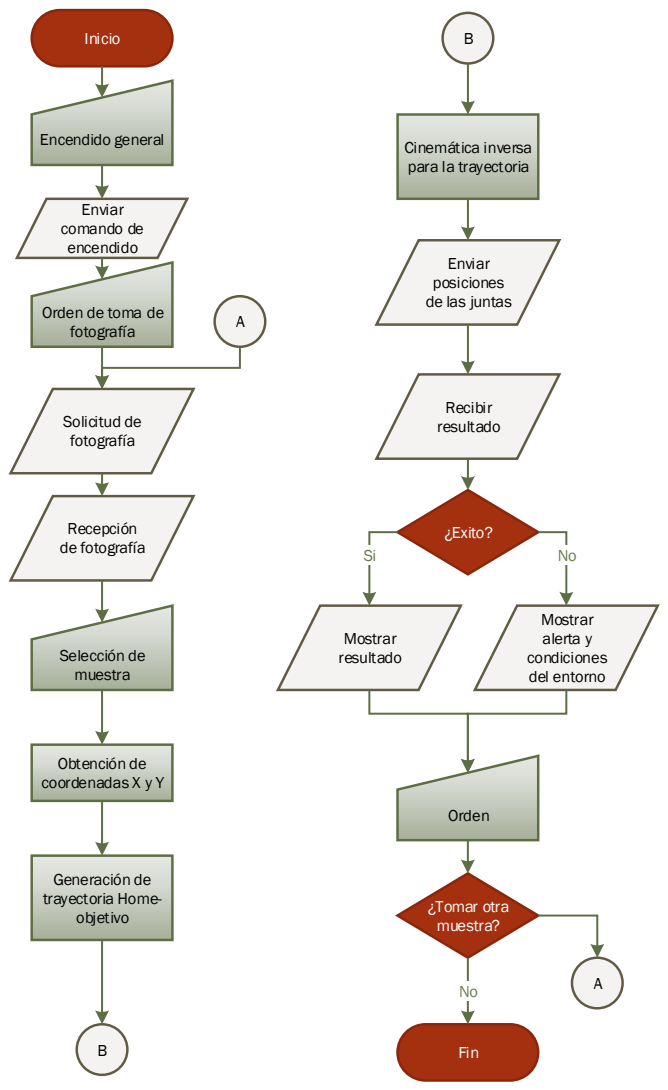
[picture p303: page 1]
Inicio; Encendido general; Enviar comando de encendido; Solicitud de fotografía; Recepción de fotografía; Obtención de coordenadas X y Y; Generación de trayectoria Home- objetivo; Recibir resultado; ¿Exito?; Mostrar resultado; Mostrar alerta y condiciones del entorno; Orden; ¿Tomar otra muestra?; Fin; Selección de muestra

Cinemática inversa
para la trayectoria

Enviar
posiciones
de las juntas

Orden de toma de
fotografía
