EduardoSBarreraR/Trabajo_Terminal_2/imagenes/Modelos/eFFBD.pdf

## Hasta alcanzar la posición de la muestra

## Hasta que se ordene la desactivación

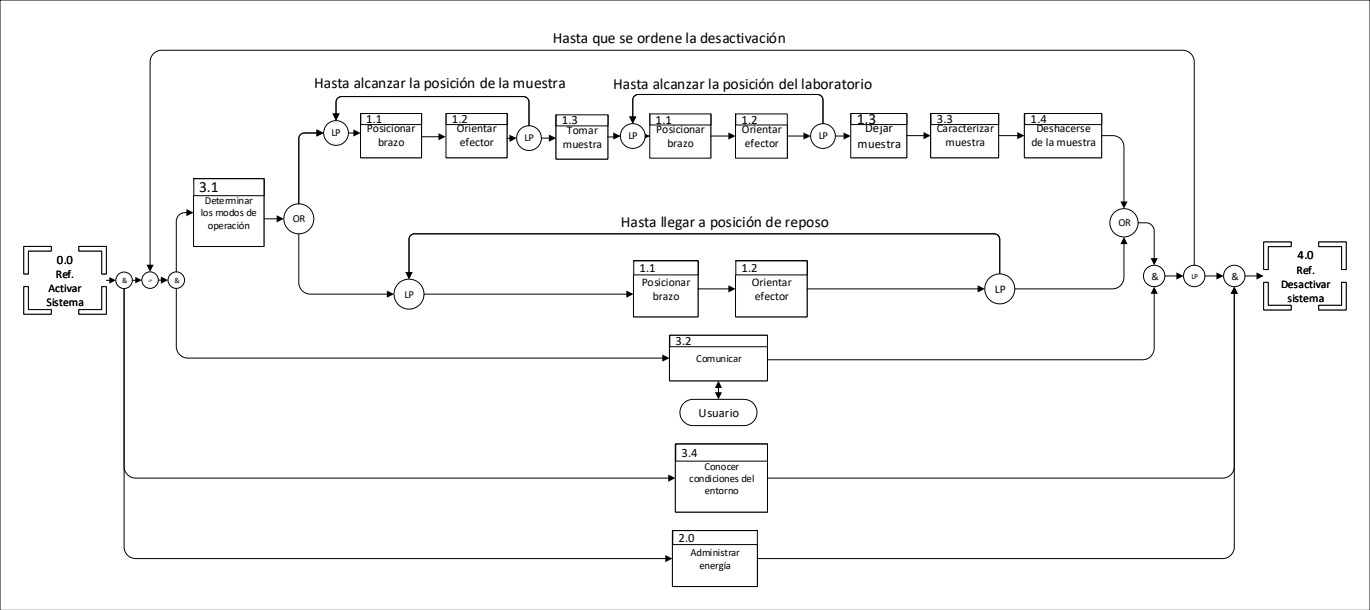
[picture p304: page 1]
0.0 Ref. Activar Sistema; 4.0 Ref. Desactivar sistema; 3.1 Determinar los modos de operación; Comunicar; Posicionar brazo; Orientar efector; Tomar muestra; Caracterizar muestra; Deshacerse de la muestra; Administrar energía; Usuario; Dejar muestra; Conocer condiciones del entorno

Hasta alcanzar la posición del laboratorio

Hasta llegar a posición de reposo
