EduardoSBarreraR/Trabajo_Terminal_2/imagenes/Dominio especifico/AsignacionMarcos.pdf

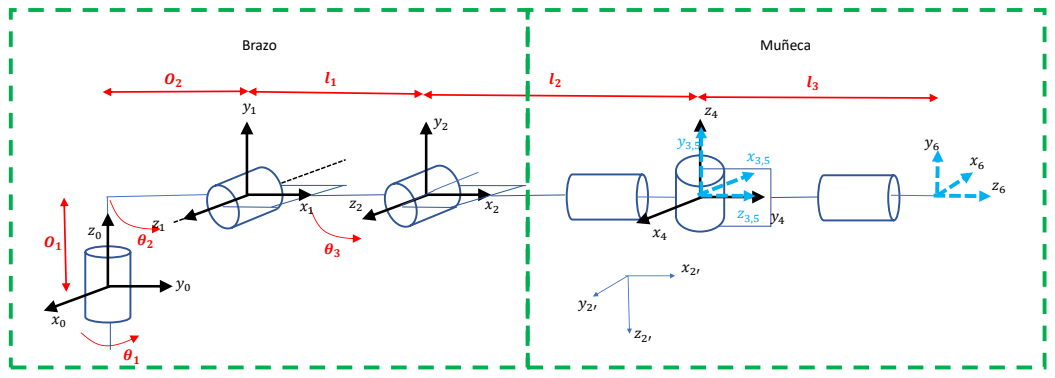
[picture p305: page 1]
Braz; Muñeca
