EduardoSBarreraR/Trabajo_Terminal_2/imagenes/INTEGRACION/Distribucion pines.pdf

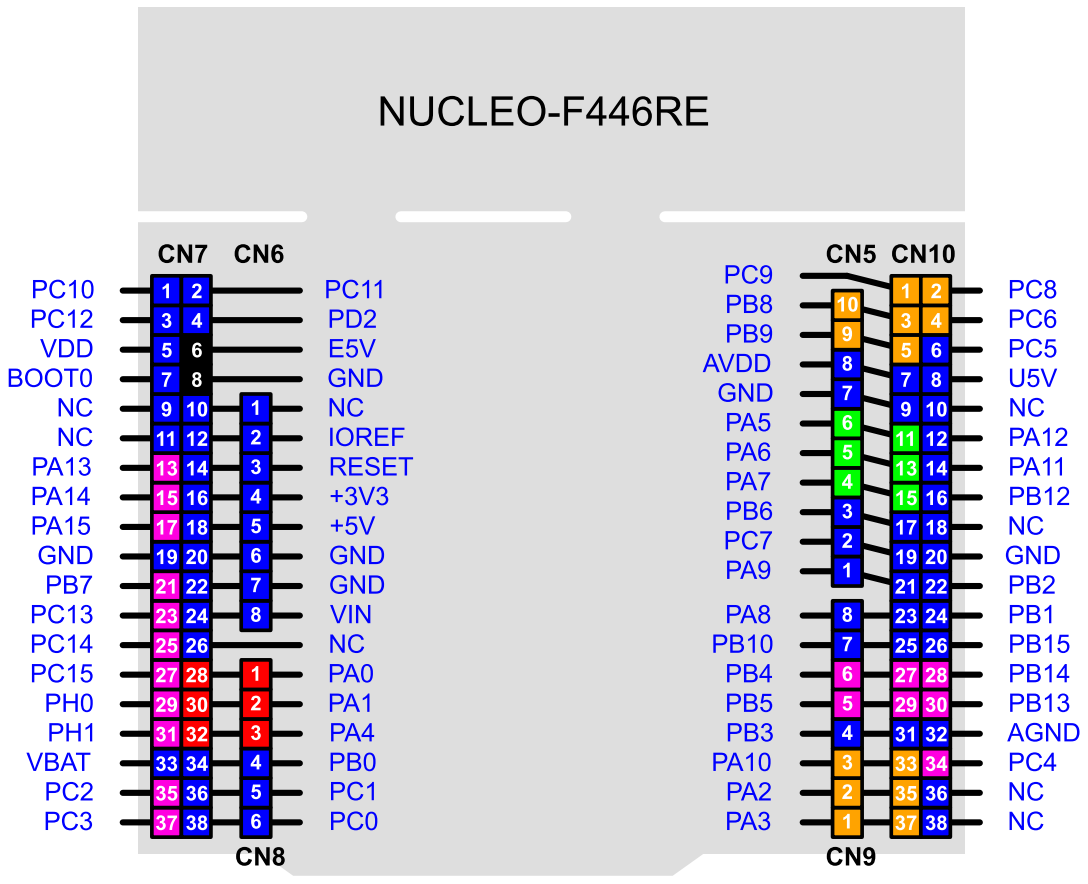
[picture p306: page 1]
