EduardoSBarreraR/Trabajo_Terminal_2/imagenes/INTEGRACION/Placa2PCB.PDF

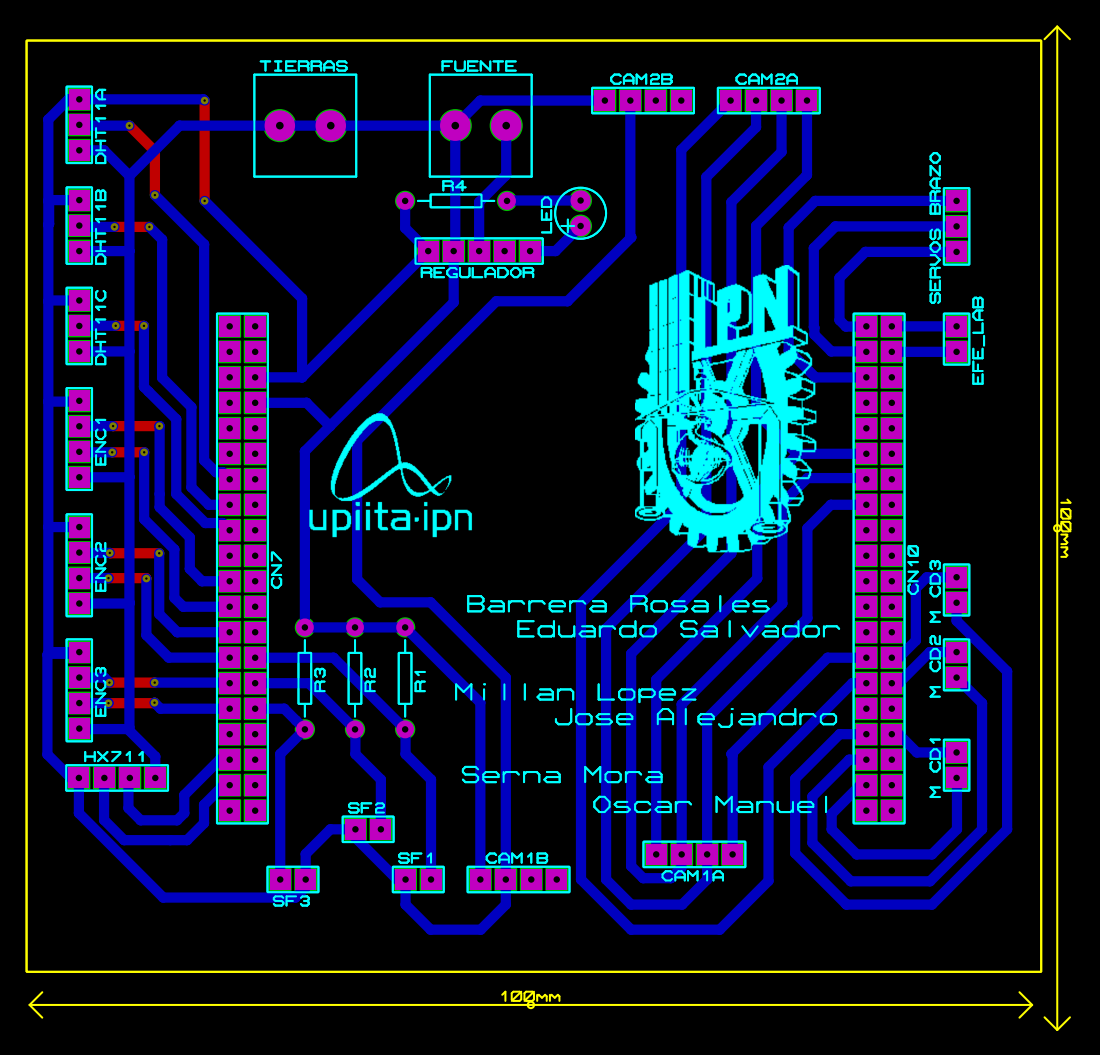
[picture p307: page 1]
