EduardoSBarreraR/Trabajo_Terminal_2/imagenes/INTEGRACION/Placa2PCB_Esquematico.PDF

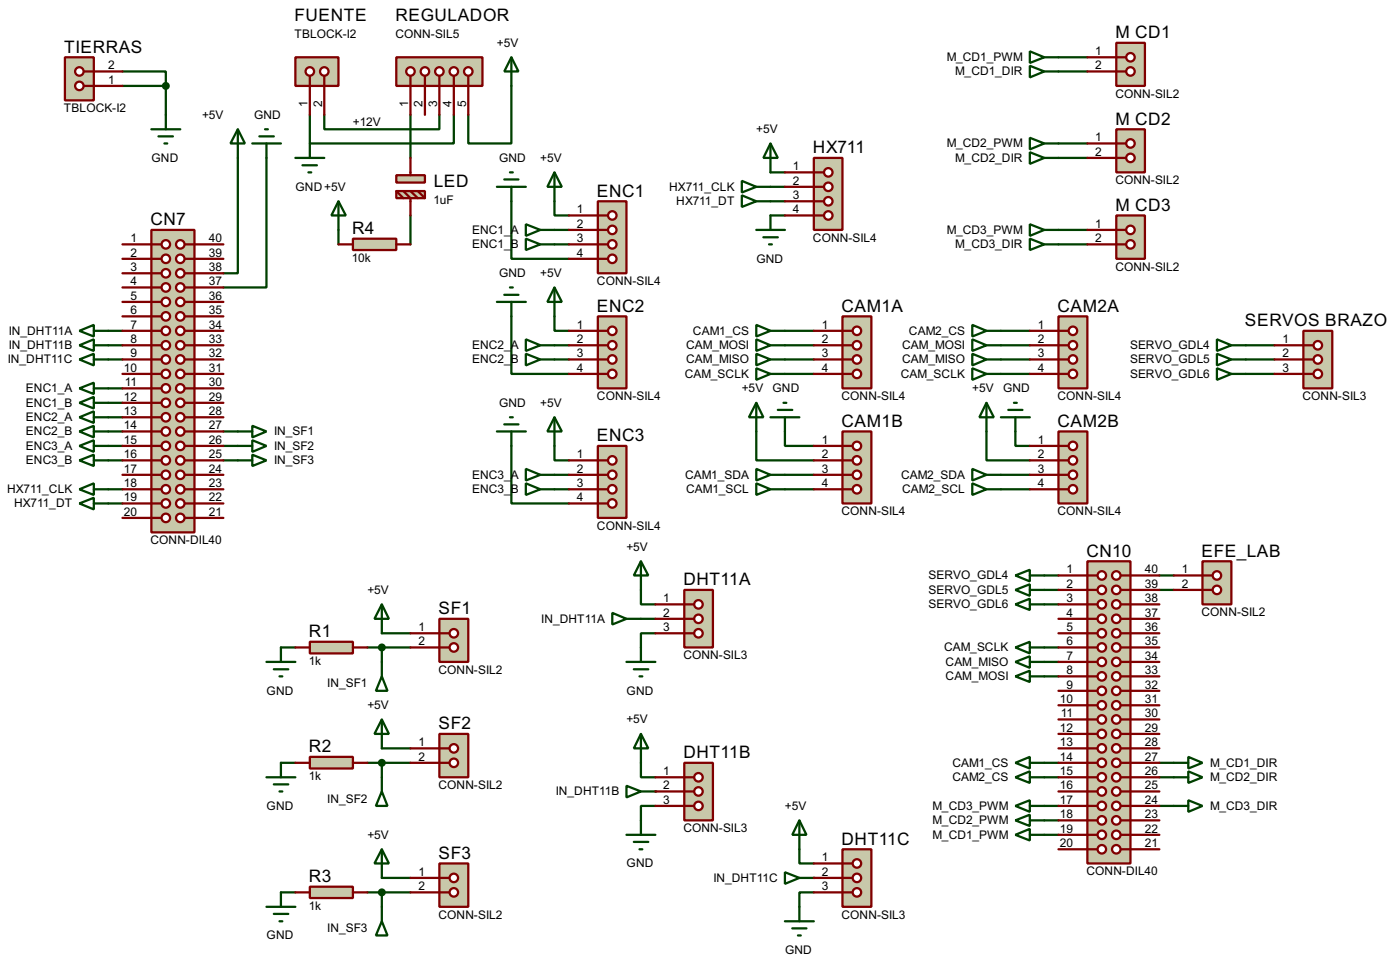
[picture p308: page 1]
