EduardoSBarreraR/Trabajo_Terminal_2/imagenes/Modelos/Arquitectura fisica.pdf

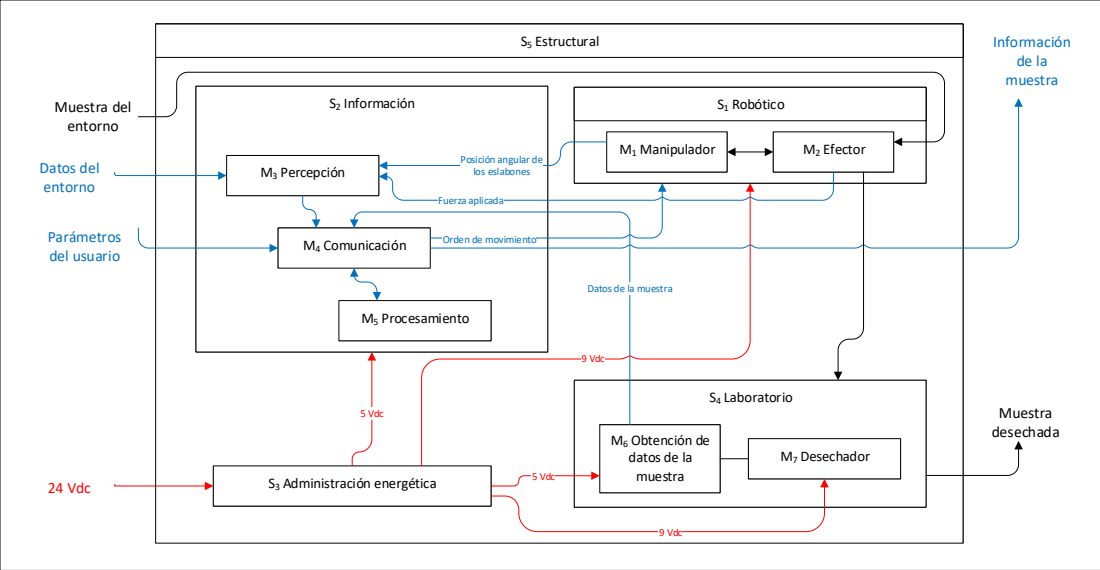
[picture p309: page 1]
S5 Estructural; S2 Información; S1 Robótico; S3 Administración energética; M1 Manipulador; M2 Efector; S4 Laboratorio; M3 Percepción; M4 Comunicación; M5 Procesamiento; M7 Desechador; Parámetros del usuario; Muestra del entorno; 24 Vdc; Información de la muestra; Muestra desechada; Datos del entorno; Fuerza aplicada; 5 Vdc; 9 Vdc

Posición angular de
los eslabones

Orden de movimiento

Datos de la muestra

M6 Obtención de
datos de la
muestra
