EduardoSBarreraR/Trabajo_Terminal_2/(commit log)

2020-08-06 Creación del repositorio con los avances realizados en TT1
    [8020-20-2020-20-2020 X 220mm.SLDPRT, 8020-20-2020-20-2020 X 570mm.SLDPRT, 8020-20-2020-20-2020 X 620mm.SLDPRT, 8020-20-2020-20-2020 X 720mm.SLDPRT, Selección de concepto final.xlsx]
2020-08-06 Añadimos más comandos útiles de Git
2020-10-16 Se agrega el capitulo Implementacion Se recortan secciones sobrantes de TT1
2020-10-22 Capitulo: Diseño del sistema -Descripcion larga de funciones (solo queda el FBS) -Conceptos solución: Se eliminan las listas y las figuras auxiliares. -Los criterios se mudaron al apéndice que tiene 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
    Capitulo: Diseño de dominio específico
    -Se eliminan los cálculos desarrollados
    -Solo se escribe el simbolo y el valor resultante
2020-11-13 Se agregan imagenes y referencias de piezas hechas Se añade sección para cámara RGBD
2020-11-19 Se cambian los márgenes Interlineado en listas y tablas reducido Ajuste de modelos en márgenes
2021-04-03 Correcciones - Modificacion de apendices y anexos - Correcciones propias y de asesores
2021-05-25 Correcciones Previo a la entrega al presidente del jurado
    Oscar Serna Mora <OscarSernaM@users.noreply.github.com>
    Alejandro Millán López <timeillan@users.noreply.github.com>
2021-05-25 correcion de etiquetas
2021-06-02 - Elimina dependencia de paquete obsoleto etoolbox - Correcion de comando de nomenclatura
2021-07-26 - Se agregan los agradecimientos
    Alejandro Millán López
    Oscar Serna Mora
