EduardoSBarreraR/Trabajo_Terminal_2/(notices)

Notices in the files:
Escrito_TT2.tex:
Copyright (C) 2017 Juan Carlos Guzmán Salgado
This template is licensed with CreativeCommons license CC-BY-SA 4.0
license info:
<a href="https://creativecommons.org/licenses/by-sa/4.0/legalcode" target="_blank" rel="nofollow">https://creativecommons.org/licenses/by-sa/4.0/legalcode</a>
